josegd98/MaquinaVending/Fotos i videos projecte/Imatges dels components i muntatge/IMG_20230523_161745.jpg

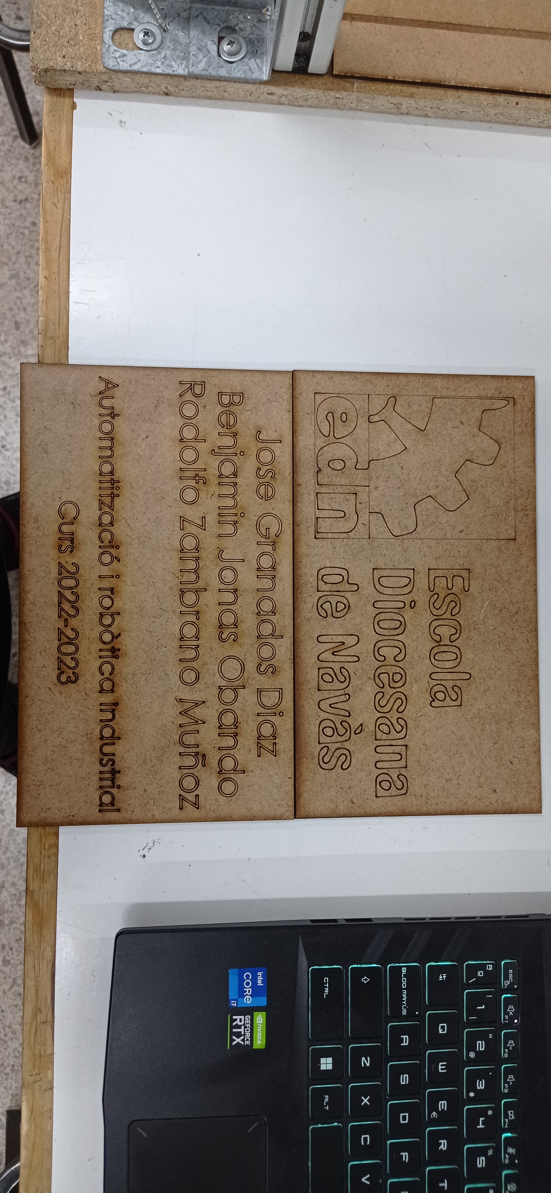
Fotos i videos projecte/Imatges dels components i muntatge/IMG_20230523_161745.jpg
