josegd98/MaquinaVending/Documentació Projecte/HMI .pdf

## HMI MAQUINA DE VENDING

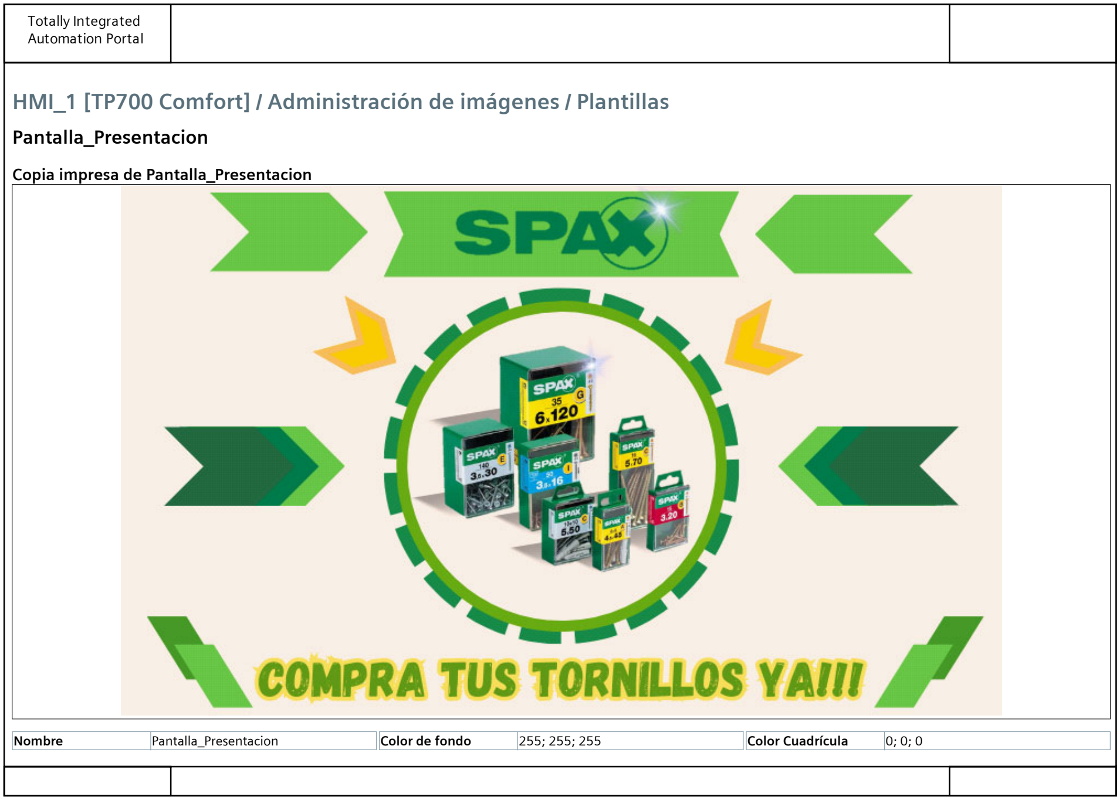
[picture p5: figure]
Totally Integrated Automation Portal; Pantalla_Presentacion; Copia impresa de Pantalla_Presentacion

## HMI_1 [TP700 Comfort] / Administración de imágenes / Plantillas

Nombre | Pantalla_Presentacion | Color de fondo | 255; 255; 255 | Color Cuadrícula | 0; 0; 0

Automation Portal

## HMI_1 [TP700 Comfort] / Imágenes / Venta

## 00_Pantalla incial

### Copia impresa de 00_Pantalla incial

Nombre | 00_Pantalla incial | Color de fondo | 255; 255; 255 | Color Cuadrícula | 0; 0; 0

Automation Portal

## HMI_1 [TP700 Comfort] / Administración de imágenes / Imágenes deslizables

## Imagen deslizable arriba

### Copia impresa de Imagen deslizable arriba

Nombre | Imagen deslizable arriba | Activar imagen desliz‐ able | Verificado | Ancho | 800
Altura | 80 | Nivel activo | 0

Botón_1

Tipo | Botón | Nombre | Botón_1 | Posición X | 29
Posición Y | 12 | Ancho | 93 | Altura | 54
Modo | Texto | Texto OFF | HOME | Texto ON | Text

Dinamizaciones\Evento
Nombre de evento | Pulsar

Lista de funciones\ActivarImagen

Nombre de imagen | 100_Home_Control | Número de objeto | 0

Botón_2

Tipo | Botón | Nombre | Botón_2 | Posición X | 131
Posición Y | 12 | Ancho | 124 | Altura | 54
Modo | Texto | Texto OFF | CONFIG ROBOT | Texto ON | Text

Dinamizaciones\Evento
Nombre de evento | Pulsar

Automation Portal

## HMI_1 [TP700 Comfort] / Imágenes / Venta

## 01_Home_store

### Copia impresa de 01_Home_store

Nombre | 01_Home_store | Color de fondo | 255; 255; 255 | Color Cuadrícula | 0; 0; 0

Automation Portal

## HMI_1 [TP700 Comfort] / Imágenes / Venta

## 02_Select_Cantidad

### Copia impresa de 02_Select_Cantidad

Nombre | 02_Select_Cantidad | Color de fondo | 255; 255; 255 | Color Cuadrícula | 0; 0; 0

Automation Portal

## HMI_1 [TP700 Comfort] / Imágenes / Venta

## 03_Select_Cabeza

### Copia impresa de 03_Select_Cabeza

Nombre | 03_Select_Cabeza | Color de fondo | 255; 255; 255 | Color Cuadrícula | 0; 0; 0

Automation Portal

## HMI_1 [TP700 Comfort] / Imágenes / Venta

## 04_Select_Medidas

### Copia impresa de 04_Select_Medidas

Nombre | 04_Select_Medidas | Color de fondo | 182; 182; 182 | Color Cuadrícula | 0; 0; 0

Automation Portal

## HMI_1 [TP700 Comfort] / Imágenes / Venta

## 05_Cesta_compra

### Copia impresa de 05_Cesta_compra

Nombre | 05_Cesta_compra | Color de fondo | 255; 255; 255 | Color Cuadrícula | 0; 0; 0

Automation Portal

## HMI_1 [TP700 Comfort] / Imágenes / Venta

## 06_Inicio_sesion

### Copia impresa de 06_Inicio_sesion

Nombre | 06_Inicio_sesion | Color de fondo | 182; 182; 182 | Color Cuadrícula | 0; 0; 0

Automation Portal

## HMI_1 [TP700 Comfort] / Administración de imágenes / Imágenes deslizables

## Imagen deslizable a la derecha

### Copia impresa de Imagen deslizable a la derecha

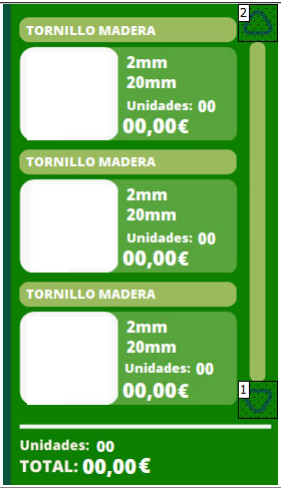
[picture p6: figure]

Automation Portal

## HMI_1 [TP700 Comfort] / Administración de imágenes / Imágenes emergentes

## Confirmacion de Pago

### Copia impresa de Confirmacion de Pago

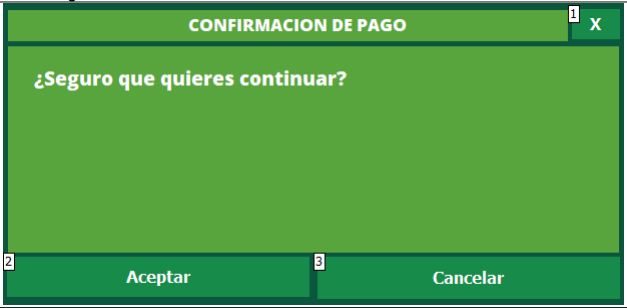
[picture p7: figure]

Nombre | Confirmacion de Pago | Ancho | 620 | Altura | 300
Nivel activo | 0

Plantilla_Rectángulo_3

Tipo | Rectángulo | Nombre | Plantilla_Rectángulo_3 | Posición X | 0
Posición Y | 0 | Ancho | 620 | Altura | 300
Nivel | 1 - Nivel_1 | Color de fondo | 88; 164; 61 | Color Borde | 11; 87; 62

Plantilla_Rectángulo_1

Tipo | Rectángulo | Nombre | Plantilla_Rectángulo_1 | Posición X | 0
Posición Y | 2 | Ancho | 620 | Altura | 41

Automation Portal

## HMI_1 [TP700 Comfort] / Administración de imágenes / Imágenes emergentes

## Entrega_Productos

### Copia impresa de Entrega_Productos

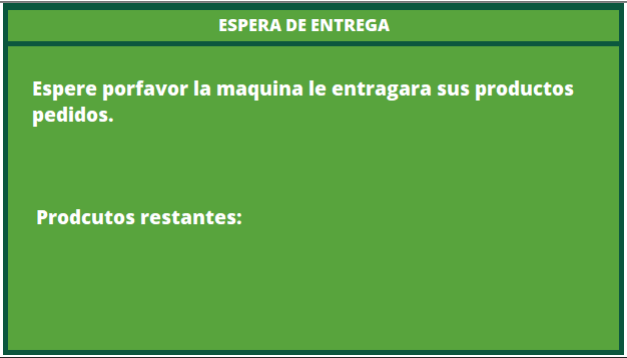
[picture p8: figure]

Nombre | Entrega_Productos | Ancho | 620 | Altura | 350
Nivel activo | 0

Plantilla_Rectángulo_3

Tipo | Rectángulo | Nombre | Plantilla_Rectángulo_3 | Posición X | 0
Posición Y | 0 | Ancho | 620 | Altura | 350
Nivel | 1 - Nivel_1 | Color de fondo | 88; 164; 61 | Color Borde | 11; 87; 62

Automation Portal

## HMI_1 [TP700 Comfort] / Administración de imágenes / Plantillas

## Menu_Navegacion

### Copia impresa de Menu_Navegacion

Nombre | Menu_Navegacion | Color de fondo | 182; 182; 182 | Color Cuadrícula | 0; 0; 0

Automation Portal

## HMI_1 [TP700 Comfort] / Administración de imágenes / Imágenes emergentes

## Confirmacion de compra

### Copia impresa de Confirmacion de compra

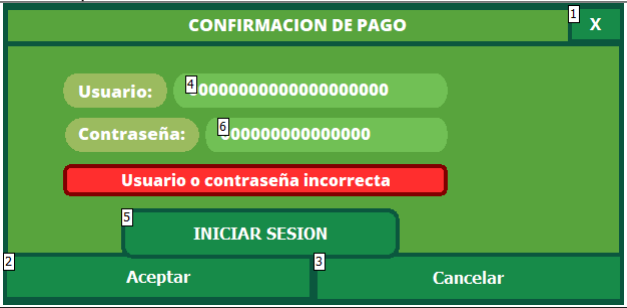
[picture p9: figure]

Nombre | Confirmacion de compra | Ancho | 620 | Altura | 300
Nivel activo | 0

Plantilla_Rectángulo_3

Tipo | Rectángulo | Nombre | Plantilla_Rectángulo_3 | Posición X | 0
Posición Y | 0 | Ancho | 620 | Altura | 300
Nivel | 1 - Nivel_1 | Color de fondo | 88; 164; 61 | Color Borde | 11; 87; 62

Campo de texto_1

Tipo | Campo de texto | Nombre | Campo de texto_1 | Posición X | 182
Posición Y | 8 | Ancho | 223 | Altura | 27

Automation Portal

## HMI_1 [TP700 Comfort] / Imágenes / Control Machine

## 100_Home_Control

### Copia impresa de 100_Home_Control

Nombre | 100_Home_Control | Color de fondo | 255; 255; 255 | Color Cuadrícula | 0; 0; 0

Automation Portal

## HMI_1 [TP700 Comfort] / Imágenes / Control Machine

## 1000_Manual_Menu

### Copia impresa de 1000_Manual_Menu

Nombre | 1000_Manual_Menu | Color de fondo | 255; 255; 255 | Color Cuadrícula | 0; 0; 0

Automation Portal

## HMI_1 [TP700 Comfort] / Imágenes / Control Machine

## 1010_Estanteria_Manual

### Copia impresa de 1010_Estanteria_Manual

Nombre | 1010_Estanteria_Manual | Color de fondo | 255; 255; 255 | Color Cuadrícula | 0; 0; 0

Automation Portal

## HMI_1 [TP700 Comfort] / Imágenes / Control Machine

## 1020_Ejes_Manual_Jog

### Copia impresa de 1020_Ejes_Manual_Jog

Nombre | 1020_Ejes_Manual_Jog | Color de fondo | 255; 255; 255 | Color Cuadrícula | 0; 0; 0

Automation Portal

## HMI_1 [TP700 Comfort] / Imágenes / Control Machine

## 200_IOMAP

### Copia impresa de 200_IOMAP

Nombre | 200_IOMAP | Color de fondo | 255; 255; 255 | Color Cuadrícula | 0; 0; 0

Automation Portal

## HMI_1 [TP700 Comfort] / Imágenes / Control Machine

## 400_Take_Pos

### Copia impresa de 400_Take_Pos

Nombre | 400_Take_Pos | Color de fondo | 255; 255; 255 | Color Cuadrícula | 0; 0; 0

Automation Portal

## HMI_1 [TP700 Comfort] / Imágenes / Control Machine

## 410_GoToPos

### Copia impresa de 410_GoToPos

Nombre | 410_GoToPos | Color de fondo | 255; 255; 255 | Color Cuadrícula | 0; 0; 0

Automation Portal

## HMI_1 [TP700 Comfort] / Imágenes / Control Machine

## 600_Config_Axis_Menu

### Copia impresa de 600_Config_Axis_Menu

Nombre | 600_Config_Axis_Menu | Color de fondo | 255; 255; 255 | Color Cuadrícula | 0; 0; 0

Automation Portal

## HMI_1 [TP700 Comfort] / Imágenes / Control Machine

## 610_Estado_EJES

### Copia impresa de 610_Estado_EJES

Nombre | 610_Estado_EJES | Color de fondo | 255; 255; 255 | Color Cuadrícula | 0; 0; 0

Automation Portal

## HMI_1 [TP700 Comfort] / Imágenes / Reponer Producto

## 10_Menu_Productos

### Copia impresa de 10_Menu_Productos

Nombre | 10_Menu_Productos | Color de fondo | 255; 255; 255 | Color Cuadrícula | 192; 192; 192

Automation Portal

## HMI_1 [TP700 Comfort] / Imágenes / Reponer Producto

## 20_Estanterias

### Copia impresa de 20_Estanterias

Nombre | 20_Estanterias | Color de fondo | 255; 255; 255 | Color Cuadrícula | 192; 192; 192

Automation Portal

## HMI_1 [TP700 Comfort] / Imágenes / Reponer Producto

## 30_Pos_Estanteria

### Copia impresa de 30_Pos_Estanteria

Nombre | 30_Pos_Estanteria | Color de fondo | 255; 255; 255 | Color Cuadrícula | 192; 192; 192

Automation Portal

## HMI_1 [TP700 Comfort] / Administración de imágenes / Imágenes emergentes

## Personalizar Producto

### Copia impresa de Personalizar Producto

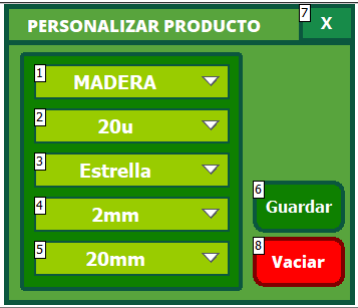
[picture p10: figure]

Nombre | Personalizar Producto | Ancho | 350 | Altura | 300
Nivel activo | 0

Dinamizaciones\Evento
Nombre de evento | Creada

Lista de funciones\ActivarBit

Variable | | | SAVE_PRODUCT_DB_VIZUALIZAR_OK

Rectángulo_6

Tipo | Rectángulo | Nombre | Rectángulo_6 | Posición X | 16

Automation Portal

## HMI_1 [TP700 Comfort] / Imágenes / Reponer Producto

## 40_Almacen

### Copia impresa de 40_Almacen

Nombre | 40_Almacen | Color de fondo | 255; 255; 255 | Color Cuadrícula | 192; 192; 192

Automation Portal

## HMI_1 [TP700 Comfort] / Imágenes / Reponer Producto

## 50_Pos_Almacen

### Copia impresa de 50_Pos_Almacen

Nombre | 50_Pos_Almacen | Color de fondo | 255; 255; 255 | Color Cuadrícula | 192; 192; 192

Automation Portal

## HMI_1 [TP700 Comfort] / Imágenes / Reponer Producto

## 60_Configuracion_Precio

### Copia impresa de 60_Configuracion_Precio

Nombre | 60_Configuracion_Precio | Color de fondo | 255; 255; 255 | Color Cuadrícula | 0; 0; 0
