josegd98/MaquinaVending/Documentació Projecte/Programa Tia Portal V15 Maquina Vending.pdf

## PROGRAMA MAQUINA DE VENDING

Totally Integrated
Automation Portal

## Main [OB1]

Main Propiedades
General
Nombre | Main | Número | 1 | Tipo | OB
Idioma | KOP | Numeración | Automático
Información
Título | "Main Program Sweep (Cycle)" | Autor | | Comentario
Familia | | Versión | 0.1 | ID personali‐ zada
Nombre | Tipo de datos | Valor predet.
Input
Initial_Call | Bool
Remanence | Bool
Temp
Constant
Segmento 1: INPUTS

"Global_Inputs"

%FB1

"Global_Inputs_
DB"

%DB29

EN | ENO

Segmento 2:

"FUNCIONES DE
GESTION Y MENU"

%FC10

EN | ENO

Segmento 3:

"Control_Entrega"

%FB31
"BuscadorDeProductos"

%FB19

"Control_
Entrega_DB"

%DB57
"BuscadorDeProd
uctos_DB"

%DB21

"Control_
Entrega_DB".
Buscar_
Productos
EN | ENO | EN

BuscarProducto
s
EN | ENO | EN | ENO

BuscarProducto
s

ENO

Segmento 4:

"Buscador_EspacioVacio"

%FB37

"Buscador_
EspacioVacio_
DB"

%DB58

EN
BuscarPosVacia
s

ENO

Segmento 5:

"ROBOT AXIS"

%FB30

"ROBOT AXIS_DB"

%DB49

EN | ENO

Segmento 6:

"Comunicacion Modbus"

%FC1
"AlwaysFALSE"

%M1.3

EN | ENO

Segmento 7:

"TAKE_POSICIONS"

%FC4

EN | ENO

Segmento 8:

"RESET_MC"

%FC6

EN ENO

Segmento 9:

"BuscarPosicion_Vacia"

%FB33
"Control_Estanterias"

%FB20

"BuscarPosicion_
Vacia_DB"

%DB54

%FB20

"Control_
Estanterias_DB"

%DB41

"Bits_Motion".
PosTogoEstanteri
a

"Bits_Motion".
GoToposEstanteri
a

"Bits_Motion".
GoToHomeEstant
eria
EN | ENO | EN

PosicionToGO

Execute

GoToHome

ENO

Segmento 10:

"Go_TO_HOME"

%FB28

"Go_TO_HOME_
DB"

%DB53

EN | ENO HOME_DONE

Segmento 11:

"Moves_Axis_Manual"

%FB15

"Moves_Axis_
Manual_DB"

%DB36

"EJE_X"

%DB37

"EJE_Y"

%DB38

"EJE_Z"

%DB39

"Btn_Manual".
btnMovePositive_
X

"Btn_Manual".
btnMoveNegative
_X

"Btn_Manual".
btnMovePositive_
Y

"Btn_Manual".
btnMoveNegative
_Y

"Btn_Manual".
btnMovePositive_
Z

"Btn_Manual".
btnMoveNegative
_Z
25.0
25.0
50.0

EN

EJE_X

EJE_Y

EJE_Z

btnMovePositiv
e_X

btnMoveNegati
ve_X

btnMovePositiv
e_Y

btnMoveNegati
ve_Y

btnMovePositiv
e_Z

btnMoveNegati
ve_Z
rVelocidad_X
rVelocidad_Y
rVelocidad_Z
EN | ENO

EJE_X

EJE_Y

EJE_Z

btnMovePositiv
e_X

btnMoveNegati
ve_X

btnMovePositiv
e_Y

btnMoveNegati
ve_Y

btnMovePositiv
e_Z

btnMoveNegati
ve_Z
rVelocidad_X
rVelocidad_Y
rVelocidad_Z

ENO

Segmento 12:

"PINZA_CONTROL"

%FB26

"PINZA_
CONTROL_DB"

%DB52

false
false
false
false
false
false

EN
ENA_PWM
OpenPinza
Limite Apertura
Limite Cerrado
btnGirarCerrar
btnGirarAbrir
EN | ENO
ENA_PWM OpenPinza Limite Apertura Limite Cerrado btnGirarCerrar btnGirarAbrir | ENO

Segmento 13:

Segmento 14:

"Control_Outputs"

%FB22

"Control_
Outputs_DB"

%DB51

false
false

EN
Modo_Manual
Modo_Auto

ENO

Segmento 15:

"Global_Ouputs"

%FB21

"Global_Ouputs_
DB"

%DB28

EN | ENO

## FUNCIONES DE GESTION Y MENU [FC10]

FUNCIONES DE GESTION Y MENU Propiedades
General
Nombre | FUNCIONES DE GESTION Y MENU | Número | 10 | Tipo | FC
Idioma | KOP | Numeración | Automático
Información
Título | Autor | | Comentario
Familia | Versión | 0.1 | ID personali‐ zada
Nombre | Tipo de datos | Valor predet.
Input
Output
InOut
Temp
Constant
Return
FUNCIONES DE GESTION Y MENU | Void
Segmento 1:

"Comprobador_de_STOCK"

%FB11

"Comprobador_
de_STOCK_DB"

%DB1

EN | ENO

Segmento 2:

"SAVE_PRODUCT"

%FB9

"SAVE_
PRODUCT_DB"

%DB8

EN | ENO

Segmento 3:

"SELECCION_PRODUCTO"

%FB8

"SELECCION_
PRODUCTO_DB"

%DB5

EN | ENO

Segmento 4:

"Control_Cesta"

%FB13

"Control_Cesta_
DB"

%DB4

EN | ENO

Segmento 5:

"Limitador_Incrementadores"

%FB12

"Limitador_
Incrementadores
_DB"

%DB14

EN | ENO

Segmento 6:

"Administrador_Usuarios"

%FB10
"Tramite_de_Compra"

%FB5

"Administrador_
Usuarios_DB"

%DB12

%FB5

"Tramite_de_
Compra_DB"

%DB13

EN | ENO | EN | ENO

Segmento 7:

"Configuracion_Precios"

%FB4

"Configuracion_
Precios_DB"

%DB9

EN | ENO

Segmento 8:

"HMI_IO_MAP"

%FB24
"IOMAP_ON"

%M100.0

"HMI_IO_MAP_DB"

%DB32

"wInputs_IW0"

%IW0

"wInputs_IW2"

%IW2

16#0
16#0

"wOutputs_QW0"

%QW0

"wOutputs_QW2"

%QW2

16#0
16#0

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
EN | ENO

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
Segmento 9:

"ASIGNACION_ID"

%FB23

"ASIGNACION_
ID_DB"

%DB31

EN | ENO

## MAQUINA DE VENDING_10_PRUEBAAUTO / PLC_1 [CPU 1214C DC/DC/ DC] / Bloques de programa / 2_CONTROL_MENU / 2_1Gestion_Produc‐ tos / CESTA

## Calculo_Precio_Total [FB7]

Calculo_Precio_Total Propiedades
General
Nombre | Calculo_Precio_Total | Número | 7 | Tipo | FB
Idioma | KOP | Numeración | Automático
Información
Título | Autor | | Comentario
Familia | Versión | 0.1 | ID personali‐ zada

Calculo_Precio_Total
Nombre | Tipo de datos | Valor predet. | Remanencia
Input
Enable_Calcular | Bool | false | No remanente
Output
Resultado | Real | 0.0 | No remanente
InOut
Static
Counter | Int | 0 | No remanente
Resultado_Calculado | Real | 0.0 | No remanente
Temp
Constant
Segmento 2:

0001
0002
0003 IF #Enable_Calcular THEN
0004 | #Resultado_Calculado := 0;
0005 | FOR #Counter := 0 TO 31 DO
0006 | #Resultado_Calculado := #Resultado_Calculado + "DB_Cesta_Produc-
| tos".Lista_Productos[#Counter].Producto.Precio * "Control_Cesta_DB".Uni-
| dades_Cesta[#Counter];
0007 | ;
0008 | END_FOR;
0009
0010 | #Resultado := #Resultado_Calculado;
0011 | ;
0012 END_IF;
0013
0014
0015
0016
0017
0018
0019

## MAQUINA DE VENDING_10_PRUEBAAUTO / PLC_1 [CPU 1214C DC/DC/ DC] / Bloques de programa / 2_CONTROL_MENU / 2_1Gestion_Produc‐ tos / CESTA

## Calculo_Unidades_Totales [FB2]

Calculo_Unidades_Totales Propiedades
General
Nombre | Calculo_Unidades_To‐ tales | Número | 2 | Tipo | FB
Idioma | KOP | Numeración | Automático
Información
Título | Autor | | Comentario
Familia | Versión | 0.1 | ID personali‐ zada

Calculo_Unidades_Totales
Nombre | Tipo de datos | Valor predet. | Remanencia
Input
Array_Unidades | Array[0..31] of Int | | No remanente
Enable_Calcular | Bool | false | No remanente
Output
Resultado | Int | 0 | No remanente
InOut
Static
Counter | Int | 0 | No remanente
Resultado_Calculado | Int | 0 | No remanente
Temp
Constant
Segmento 1:

0001
0002 IF #Enable_Calcular THEN
0003 | #Resultado_Calculado := 0;
0004 | FOR #Counter := 0 TO 31 DO
0005 | #Resultado_Calculado := #Resultado_Calculado + #Array_Unidades[#Coun-
| ter]
0006 | ;
0007 | END_FOR;
0008
0009 | #Resultado := #Resultado_Calculado;
0010 | ;
0011 END_IF;
0012
0013
0014

## Contador [FB14]

Contador Propiedades
General
Nombre | Contador | Número | 14 | Tipo | FB
Idioma | KOP | Numeración | Automático
Información
Título | Autor | | Comentario
Familia | Versión | 0.1 | ID personali‐ zada
Nombre | Tipo de datos | Valor predet. | Remanencia
Input
Intervalo | Int | 0 | No remanente
ADD | Bool | false | No remanente
SUB | Bool | false | No remanente
Max_Permitido | Int | 0 | No remanente
Output
InOut
Num_Enter | Int | 1 | No remanente
Static
pulse | Array[0..1] of Bool | | No remanente
Temp
Constant
Segmento 1:

P Int

>

ADD
#ADD | Auto (Int)

#pulse[0]

#Max_Permitido

#Num_Enter | #Num_Enter

| #Intervalo

#Num_Enter

EN
IN1
IN2

ENO
OUT

Auto (Int)
EN
IN1
IN2

ENO
OUT

Auto (Int)

Segmento 2:

P Int

>

SUB
#SUB | Auto (Int)

#pulse[1]

#Num_Enter

0 | #Num_Enter
| #Intervalo

#Num_Enter

EN
IN1
IN2

ENO
OUT

Auto (Int)
EN
IN1
IN2

ENO
OUT

Auto (Int)

## MAQUINA DE VENDING_10_PRUEBAAUTO / PLC_1 [CPU 1214C DC/DC/ DC] / Bloques de programa / 2_CONTROL_MENU / 2_1Gestion_Produc‐ tos / CESTA

## Control_Cesta [FB13]

Control_Cesta Propiedades
General
Nombre | Control_Cesta | Número | 13 | Tipo | FB
Idioma | KOP | Numeración | Automático
Información
Título | Autor | | Comentario
Familia | Versión | 0.1 | ID personali‐ zada

Control_Cesta
Nombre | Tipo de datos | Valor predet. | Remanencia
Input
Output
InOut
Static
Producto_View_Cesta | "TypeProducto" | | No remanente
Producto_View1 | "TypeProducto" | | No remanente
Producto_View2 | "TypeProducto" | | No remanente
Producto_View3 | "TypeProducto" | | No remanente
Preview_Unidades_1 | Int | 0 | No remanente
Preview_Unidades_2 | Int | 0 | No remanente
Preview_Unidades_3 | Int | 0 | No remanente
Unidades_Cesta | Array[0..31] of Int | | No remanente
Maximas_Unidades | Array[0..31] of Int | | No remanente
Puntero_Cesta | Int | 0 | No remanente
Puntero_Cesta_Previa | Int | 0 | No remanente
Eliminar | Bool | false | No remanente
Puntero2 | Int | 0 | No remanente
Puntero3 | Int | 0 | No remanente
Puntero4 | Int | 0 | No remanente
Producto_Vacio | "TypeProducto" | | No remanente
counter | Int | 0 | No remanente
Display_Unidades | Int | 1 | No remanente
Contador_Instance | "Contador"
btnAddUnidad | Bool | false | No remanente
btnSubUnidad | Bool | false | No remanente
Contar_Unidades | Bool | false | No remanente
Puntero_Unidades | Int | 0 | No remanente
Recuadro_Previa | Array[0..2] of Bool | | No remanente
Recuadro_Cesta | Bool | false | No remanente
Unidades_Totales | Int | 0 | No remanente
Calculo_Unidades_Totales_Instance | "Calculo_Uni‐ dades_Totales"
Calcular_Unidades | Bool | false | No remanente
Calcular_Precio | Bool | false | No remanente
Calculo_Precio_Total_Instance | "Calculo_Pre‐ cio_Total"
Precio_Total | Real | 0.0 | No remanente

Nombre | Tipo de datos | Valor predet. | Remanencia
Temp
Constant
Segmento 1:

Variant

<>

Variant

<>

Variant

<>

Variant

<>

#Producto_View1

#Producto_Vacio

#Recuadro_

Previa[0]

#Producto_View2

#Producto_Vacio

#Recuadro_

Previa[1]

#Producto_View3

#Producto_Vacio

#Recuadro_

Previa[2]

#Producto_

View_Cesta

#Producto_Vacio

#Recuadro_Cesta

Segmento 2:

0001
0002
0003
0004 IF #Eliminar THEN
0005 | "DB_Cesta_Productos".Lista_Productos[#Puntero_Cesta] := #Producto_Vacio;
0006 | #Unidades_Cesta[#Puntero_Cesta] := 0;
0007 | #Maximas_Unidades[#Puntero_Cesta] := 0;
0008
0009 FOR #Puntero2 := 0 TO 31 DO
0010
0011 | IF "DB_Cesta_Productos".Lista_Productos[#Puntero2] = #Producto_Vacio
| AND #Puntero2 < 31 THEN // puntero2 <31 porque si dejamos que llegue a 31 al
| sumar despues + 1 se saldra del array y dara error en el plc
0012
0013 | "DB_Cesta_Productos".Lista_Productos[#Puntero2] := "DB_Cesta_Pro-
| ductos".Lista_Productos[#Puntero2 + 1];
0014
0015 | "DB_Cesta_Productos".Lista_Productos[#Puntero2 + 1] := #Produc-
| to_Vacio
0016 | ;
0017 | END_IF;
0018
0019 | IF #Unidades_Cesta[#Puntero2] = 0 AND #Puntero2 < 31 THEN
0020
0021 | #Maximas_Unidades[#Puntero2] := #Maximas_Unidades[#Puntero2 + 1];

0022 | #Unidades_Cesta[#Puntero2] := #Unidades_Cesta[#Puntero2 + 1];
0023 | #Maximas_Unidades[#Puntero2 + 1] := 0;
0024 | #Unidades_Cesta[#Puntero2 + 1] := 0
0025 | ;
0026 | END_IF;
0027
0028
0029 | ;
0030 | END_FOR;
0031
0032 #Eliminar := false;
0033
0034 ;
0035 END_IF;
0036
0037
0038 IF #Contar_Unidades THEN
0039
0040 | FOR #Puntero_Unidades := 0 TO 31 DO
0041 | #Maximas_Unidades[#Puntero_Unidades] := 0;
0042 | ;
0043 | END_FOR;
0044
0045 | FOR #Puntero_Unidades := 0 TO 31 DO
0046
0047 | FOR #Puntero3 := 0 TO 31 DO
0048
0049
0050 | IF "DB_Cesta_Productos".Lista_Productos[#Puntero_Unidades] =
| "BDO_STOCK".Espacio[#Puntero3] THEN
0051 | #Maximas_Unidades[#Puntero_Unidades] := #Maximas_Uni-
| dades[#Puntero_Unidades] + 1;
0052
0053 | END_IF;
0054
0055 | IF "DB_Cesta_Productos".Lista_Productos[#Puntero_Uni-
| dades].Producto.Tipo = 0 THEN
0056 | EXIT
0057 | ;
0058 | END_IF;
0059
0060 | ;
0061 | END_FOR;
0062
0063 | IF "DB_Cesta_Productos".Lista_Productos[#Puntero_Unidades].Produc-
| to.Tipo = 0 THEN
0064 | EXIT
0065 | ;
0066 | END_IF;
0067 | ;
0068 | END_FOR;
0069
0070 | #Contar_Unidades:= false
0071 | ;
0072 | END_IF;
0073
0074 #Display_Unidades := #Unidades_Cesta[#Puntero_Cesta]; 0075
0076

0077
0078
0079
0080
0081
0082
0083
0084
0085
0086 #Producto_View_Cesta := "DB_Cesta_Productos".Lista_Productos[#Puntero_Cesta]; 0087
0088 #Producto_View1 := "DB_Cesta_Productos".Lista_Productos[#Puntero_Cesta_Previa];
0089 #Producto_View2 := "DB_Cesta_Productos".Lista_Productos[#Puntero_Cesta_Previa + 1];
0090 #Producto_View3 := "DB_Cesta_Productos".Lista_Productos[#Puntero_Cesta_Previa + 2];
0091
0092 #Preview_Unidades_1 := #Unidades_Cesta[#Puntero_Cesta_Previa];
0093 #Preview_Unidades_2 := #Unidades_Cesta[#Puntero_Cesta_Previa + 1]; 0094 #Preview_Unidades_3 := #Unidades_Cesta[#Puntero_Cesta_Previa + 2]; 0095
0096
0097
Segmento 3:

"Contador"

%FB14

#Contador_

Instance

1

#Maximas_

Unidades[#Punter
o_Cesta]

#Unidades_

Cesta[#Puntero_
Cesta]

#btnAddUnidad

#btnSubUnidad

EN
Intervalo

ADD

SUB

Max_Permitido

Num_Enter

EN | ENO
Intervalo

ADD

SUB

Max_Permitido

Num_Enter

ENO

Segmento 4:

"Calculo_Unidades_Totales"

%FB2

#Calculo_

Unidades_
Totales_Instance

#Unidades_Cesta

#Calcular_

Unidades

#Unidades_

Totales

EN
Array_Unidades
Enable_
Calcular

ENO

Resultado

EN
Array_Unidades
Enable_
Calcular

ENO

Resultado

Segmento 5:

"Calculo_Precio_Total"

%FB7

#Calculo_

Precio_Total_
Instance

#Calcular_Precio

#Precio_Total

EN
Enable_
Calcular

ENO
Resultado

Segmento 6:

## MAQUINA DE VENDING_10_PRUEBAAUTO / PLC_1 [CPU 1214C DC/DC/ DC] / Bloques de programa / 2_CONTROL_MENU / 2_1Gestion_Produc‐ tos / CESTA

## SELECCION_PRODUCTO [FB8]

SELECCION_PRODUCTO Propiedades
General
Nombre | SELECCION_PRODUCTO | Número | 8 | Tipo | FB
Idioma | KOP | Numeración | Automático
Información
Título | Autor | | Comentario
Familia | Versión | 0.1 | ID personali‐ zada

SELECCION_PRODUCTO
Nombre | Tipo de datos | Valor predet. | Remanencia
Input
Output
InOut
Static
Select_Product | Array[0..4] of String | | No remanente
PUNTERO_Diametro | Int | 0 | No remanente
PUNTERO_Largo | Int | 0 | No remanente
aceptar_DIAMETRO | Bool | false | No remanente
aceptar_LARGO | Bool | false | No remanente
Diametro_seleccionado | Int | 0 | No remanente
Largo_seleccionado | Int | 0 | No remanente
Diametro_actual | Int | 0 | No remanente
Largo_actual | Int | 0 | No remanente
diametro_string | String | '' | No remanente
Save_Pedido | Bool | false | No remanente
puntero_busqueda | Int | 0 | No remanente
Producto_Nulo | "TypeProducto" | | No remanente
Check_Limit_Diametro | Bool | false | No remanente
Check_Limit_Largo | Bool | false | No remanente
Temp
Constant
Segmento 1:

0001
0002 #Diametro_actual := "Comprobador_de_STOCK_DB".Diametro_Stock[#PUNTERO_Diametro];
0003
0004 IF #aceptar_DIAMETRO = true THEN
0005 | #Diametro_seleccionado := "Comprobador_de_STOCK_DB".Diametro_Stock[#PUN-
| TERO_Diametro];
0006 | ;
0007 END_IF;
0008
0009 "Comprobador_de_STOCK_DB".PRODUCTO_ELEGIDO[3] := #Diametro_seleccionado; 0010

0011 //----------------------------------------------------------------------------------------------
0012
0013 #Largo_actual := "Comprobador_de_STOCK_DB".Largo_Stock[#PUNTERO_Largo];
0014
0015 IF #aceptar_LARGO = true THEN
0016 | #Largo_seleccionado := "Comprobador_de_STOCK_DB".Largo_Stock[#PUNTERO_Lar-
| go];
0017 | ;
0018 END_IF;
0019
0020 "Comprobador_de_STOCK_DB".PRODUCTO_ELEGIDO[4] := #Largo_seleccionado; 0021
0022
0023 IF #Save_Pedido THEN
0024 FOR #puntero_busqueda := 0 TO 31 DO
0025
0026 | IF "DB_Cesta_Productos".Lista_Productos[#puntero_busqueda] = "Compro-
| bador_de_STOCK_DB".Producto_Seleccionado THEN
0027 | EXIT
0028 | ;
0029 | END_IF;
0030
0031 | IF "DB_Cesta_Productos".Lista_Productos[#puntero_busqueda] = #Produc-
| to_Nulo THEN
0032 | "DB_Cesta_Productos".Lista_Productos[#puntero_busqueda] := "Com-
| probador_de_STOCK_DB".Producto_Seleccionado;
0033 | "Control_Cesta_DB".Unidades_Cesta[#puntero_busqueda] := 1;
0034 | EXIT
0035 | ;
0036 | END_IF;
0037
0038 | ;
0039 | END_FOR;
0040 | #Save_Pedido := FALSE
0041 | ;
0042 END_IF;
0043
0044
0045
0046
0047
0048
0049
0050
0051
0052
0053

## MAQUINA DE VENDING_10_PRUEBAAUTO / PLC_1 [CPU 1214C DC/DC/ DC] / Bloques de programa / 2_CONTROL_MENU / 2_1Gestion_Produc‐ tos / COMPROBADOR STOCK

## Comprobador_de_STOCK [FB11]

Comprobador_de_STOCK Propiedades
General
Nombre | Comprobador_de_STOCK | Número | 11 | Tipo | FB
Idioma | KOP | Numeración | Manual
Información
Título | Autor | | Comentario
Familia | Versión | 0.1 | ID personali‐ zada

Comprobador_de_STOCK
Nombre | Tipo de datos | Valor predet. | Remanencia
Input
Output
InOut
Static
Tipo_Madera | "TypeStockVar" | | No remanente
Tipo_Chapa | "TypeStockVar" | | No remanente
100ud | "TypeStockVar" | | No remanente
20ud | "TypeStockVar" | | No remanente
Estrella | "TypeStockVar" | | No remanente
Plana | "TypeStockVar" | | No remanente
Hexagonal | "TypeStockVar" | | No remanente
Torx | "TypeStockVar" | | No remanente
Diametro | "TypeStockVar" | | No remanente
Largo | "TypeStockVar" | | No remanente
Diametro actual | Int | 0 | No remanente
Diametro_Stock | Array[0..5] of Int | | No remanente
Largo_Stock | Array[0..5] of Int | | No remanente
ORDEN | Int | 0 | No remanente
Counter | Int | 0 | No remanente
MIRAR DIAMETROS | Bool | false | No remanente
Puntero | Int | 0 | No remanente
PRODUCTO_ELEGIDO | Array[0..4] of Int | | No remanente
Producto_Seleccionado | "TypeProducto" | | No remanente
Cantidad_elegida | Int | 0 | No remanente
procesar | Bool | false | No remanente
MIRAR LARGO | Bool | false | No remanente
Buscar_Tipos | Bool | false | No remanente
Buscar_Unidades | Bool | false | No remanente
Buscar_Cabezas | Bool | false | No remanente
pruab creada | Bool | false | No remanente
Producto_Vacio | Array[0..5] of Int | | No remanente
Asignador_Precios_Instance | "Asignador_Pre‐ cios"
Mirar_Precio | Bool | false | No remanente
Temp
Constant

Segmento 1:

0001
0002
0003 // TIPO MADERA CONTEO DE CANTIDAD 0004 IF #Buscar_Tipos THEN
0005 | //RESET PARA VOLVER A COMPROBAR
0006 | #Tipo_Madera.Disponible := FALSE;
0007 | #Tipo_Chapa.Disponible := FALSE;
0008 | #Tipo_Chapa.Cantidad := 0;
0009 | #Tipo_Madera.Cantidad := 0;
0010
0011 #Cantidad_elegida := 0;
0012
0013 | FOR #Puntero := 0 TO 31 DO
0014 | IF "BDO_STOCK".Espacio[#Puntero].Producto.Tipo = 1 AND "BDO_STOCK".Es-
| pacio[#Puntero].Producto.Disponible THEN
0015
0016 | #Tipo_Madera.Cantidad := #Tipo_Madera.Cantidad + 1;
0017
0018 | ;
0019 | END_IF;
0020
0021 | IF "BDO_STOCK".Espacio[#Puntero].Producto.Tipo = 2 AND "BDO_STOCK".Es-
| pacio[#Puntero].Producto.Disponible THEN
0022
0023 | #Tipo_Chapa.Cantidad := #Tipo_Chapa.Cantidad + 1;
0024
0025 | ;
0026 | END_IF;
0027
0028 | ;
0029 | END_FOR;
0030
0031 IF #Tipo_Madera.Cantidad > 0 THEN 0032
0033 | #Tipo_Madera.Disponible := TRUE
0034 | ;
0035 | ELSE
0036 | #Tipo_Madera.Disponible := FALSE
0037 | ;
0038 | END_IF;
0039
0040 // TIPO CHAPA CONTEO DE CANTIDAD 0041
0042 IF #Tipo_Chapa.Cantidad > 0 THEN 0043
0044 | #Tipo_Chapa.Disponible := TRUE
0045 | ;
0046 | ELSE
0047 | #Tipo_Chapa.Disponible := FALSE
0048 | ;
0049 | END_IF;
0050
0051 #Buscar_Tipos := FALSE; 0052
0053 END_IF;
0054

0055
//------------------------------------------------------------------------------
0056
0057 // UNIDADES DISPONIBLES
0058 IF #Buscar_Unidades THEN
0059 | #"100ud".Disponible := FALSE;
0060 | #"20ud".Disponible := FALSE;
0061 | #"20ud".Cantidad := 0;
0062 | #"100ud".Cantidad := 0;
0063
0064 FOR #Puntero := 0 TO 31 DO
0065
0066 | //100 ud
0067 | IF "BDO_STOCK".Espacio[#Puntero].Producto.Tipo = #PRODUCTO_ELEGIDO[0]
| AND "BDO_STOCK".Espacio[#Puntero].Producto.Cantidad = 100 AND "BDO_STOCK".Es-
| pacio[#Puntero].Producto.Disponible THEN
0068 | #"100ud".Cantidad := #"100ud".Cantidad + 1;
0069 | ;
0070 | END_IF;
0071 | //20 ud
0072 | IF "BDO_STOCK".Espacio[#Puntero].Producto.Tipo = #PRODUCTO_ELEGIDO[0]
| AND "BDO_STOCK".Espacio[#Puntero].Producto.Cantidad = 20 AND "BDO_STOCK".Espa-
| cio[#Puntero].Producto.Disponible THEN
0073 | #"20ud".Cantidad := #"20ud".Cantidad + 1;
0074 | ;
0075 | END_IF;
0076 | ;
0077 | END_FOR;
0078
0079 | //100 ud
0080 | IF #"100ud".Cantidad > 0 THEN
0081 | #"100ud".Disponible := TRUE
0082 | ;
0083 | ELSE
0084 | #"100ud".Disponible := FALSE
0085 | ;
0086 | END_IF;
0087 | //20 ud
0088 | IF #"20ud".Cantidad > 0 THEN
0089 | #"20ud".Disponible := TRUE
0090 | ;
0091 | ELSE
0092 | #"20ud".Disponible := FALSE
0093 | ;
0094 | END_IF;
0095
0096 END_IF;
0097
0098 IF #Buscar_Cabezas THEN 0099
0100 | #Estrella.Cantidad := 0;
0101 | #Plana.Cantidad := 0;
0102 | #Hexagonal.Cantidad := 0;
0103 | #Torx.Cantidad := 0;
0104 | #Estrella.Disponible := FALSE;
0105 | #Plana.Disponible := FALSE;
0106 | #Hexagonal.Disponible := FALSE;
0107 | #Torx.Disponible := FALSE;

0108
0109 | FOR #Puntero := 0 TO 31 DO
0110 | //100 ud
0111 | IF "BDO_STOCK".Espacio[#Puntero].Producto.Tipo = #PRODUCTO_ELEGIDO[0]
| AND "BDO_STOCK".Espacio[#Puntero].Producto.Cantidad = #PRODUCTO_ELEGIDO[1] AND
| "BDO_STOCK".Espacio[#Puntero].Producto.Cabeza = 1 AND "BDO_STOCK".Espa-
| cio[#Puntero].Producto.Disponible THEN
0112
0113 | #Estrella.Cantidad := #Estrella.Cantidad + 1;
0114
0115 | ;
0116 | END_IF;
0117 | //20 ud
0118 | IF "BDO_STOCK".Espacio[#Puntero].Producto.Tipo = #PRODUCTO_ELEGIDO[0]
| AND "BDO_STOCK".Espacio[#Puntero].Producto.Cantidad = #PRODUCTO_ELEGIDO[1] AND
| "BDO_STOCK".Espacio[#Puntero].Producto.Cabeza = 2 AND "BDO_STOCK".Espa-
| cio[#Puntero].Producto.Disponible THEN
0119
0120 | #Plana.Cantidad := #Plana.Cantidad + 1;
0121
0122 | ;
0123 | END_IF;
0124
0125 | IF "BDO_STOCK".Espacio[#Puntero].Producto.Tipo = #PRODUCTO_ELEGIDO[0]
| AND "BDO_STOCK".Espacio[#Puntero].Producto.Cantidad = #PRODUCTO_ELEGIDO[1] AND
| "BDO_STOCK".Espacio[#Puntero].Producto.Cabeza = 3 AND "BDO_STOCK".Espa-
| cio[#Puntero].Producto.Disponible THEN
0126
0127 | #Hexagonal.Cantidad := #Hexagonal.Cantidad + 1;
0128
0129 | ;
0130 | END_IF;
0131
0132 | IF "BDO_STOCK".Espacio[#Puntero].Producto.Tipo = #PRODUCTO_ELEGIDO[0]
| AND "BDO_STOCK".Espacio[#Puntero].Producto.Cantidad = #PRODUCTO_ELEGIDO[1] AND
| "BDO_STOCK".Espacio[#Puntero].Producto.Cabeza = 4 AND "BDO_STOCK".Espa-
| cio[#Puntero].Producto.Disponible THEN
0133
0134 | #Torx.Cantidad := #Torx.Cantidad + 1;
0135
0136 | ;
0137 | END_IF;
0138
0139 END_FOR;
0140
0141 | IF #Estrella.Cantidad > 0 THEN
0142
0143 | #Estrella.Disponible := TRUE
0144 | ;
0145 | ELSE
0146 | #Estrella.Disponible := FALSE
0147 | ;
0148 | END_IF;
0149 | //20 ud
0150 | //
0151 | IF #Plana.Cantidad > 0 THEN
0152
0153 | #Plana.Disponible := TRUE
0154 | ;

0155 | ELSE
0156 | #Plana.Disponible := FALSE
0157 | ;
0158 | END_IF;
0159
0160 | IF #Hexagonal.Cantidad > 0 THEN
0161
0162 | #Hexagonal.Disponible := TRUE
0163 | ;
0164 | ELSE
0165 | #Hexagonal.Disponible := FALSE
0166 | ;
0167 | END_IF;
0168
0169 | //20 ud
0170 | IF #Torx.Cantidad > 0 THEN
0171
0172 | #Torx.Disponible := TRUE
0173 | ;
0174 | ELSE
0175 | #Torx.Disponible := FALSE
0176 | ;
0177 | END_IF;
0178 | ;
0179 END_IF;
0180
0181
0182 IF #"MIRAR DIAMETROS" THEN
0183
0184 #Diametro_Stock := #Producto_Vacio;
0185
0186 FOR #Counter := 0 TO 8 DO //NUMERO MAXIMO DE MEDIDA DE DIAMETRO CONTADOR PARA COMPARAR POR ORDEN EL ARRAY ES DE 7 Y EL COUNTER IRA AUMENTANDO DE 1 A 7 POR ORDEN ASI LO USAMOS PARA COMPARAR Y SI ESTA EN ORDEN LO GUARDAMOS
0187
0188 | FOR #Puntero := 0 TO 31 DO | //NUMERO DE DE TAMAÑO DE EL ARRAY PUN-
TERO QUE RECORRE TODO LA BASE DE DATOS
0189
0190
0191 | IF "BDO_STOCK".Espacio[#Puntero].Producto.Tipo = #PRODUCTO_ELEGI-
DO[0] AND "BDO_STOCK".Espacio[#Puntero].Producto.Cantidad = #PRODUCTO_ELEGI-
| DO[1] AND
0192 | "BDO_STOCK".Espacio[#Puntero].Producto.Cabeza = #PRODUCTO_ELE-
GIDO[2] AND "BDO_STOCK".Espacio[#Puntero].Producto.Diametro = #Counter AND "BDO_STOCK".Espacio[#Puntero].Producto.Disponible THEN
0193
0194 | #Diametro_Stock[#ORDEN] := "BDO_STOCK".Espacio[#Puntero].Pro-
ducto.Diametro; // SI ES IGUIAL AL NUM POR ORDEN LO GUARDAMOS EN EL ARRAY Y
| PASAMOS AL SIGUIENTE ESPACIO
0195 | #ORDEN := #ORDEN + 1;
0196 | EXIT
0197 | ;
0198 | END_IF;
0199 | ;
0200 | END_FOR;
0201 | ;
0202 | END_FOR;
0203
0204 #ORDEN := 0;

0205
0206 | #"MIRAR DIAMETROS" := FALSE
0207 | ;
0208 END_IF;
0209
0210
0211
0212 IF #"MIRAR LARGO" THEN
0213
0214 #Largo_Stock := #Producto_Vacio;
0215
0216 FOR #Counter := 20 TO 60 BY 5 DO //NUMERO MAXIMO DE MEDIDA DE DIAMETRO CONTADOR PARA COMPARAR POR ORDEN EL ARRAY ES DE 7 Y EL COUNTER IRA AUMENTANDO DE 1 A 7 POR ORDEN ASI LO USAMOS PARA COMPARAR Y SI ESTA EN ORDEN LO GUARDAMOS 0217
0218 | FOR #Puntero := 0 TO 31 DO | //NUMERO DE DE TAMAÑO DE EL ARRAY PUN-
TERO QUE RECORRE TODO LA BASE DE DATOS
0219
0220
0221 | IF "BDO_STOCK".Espacio[#Puntero].Producto.Tipo = #PRODUCTO_ELEGI-
DO[0] AND "BDO_STOCK".Espacio[#Puntero].Producto.Cantidad = #PRODUCTO_ELEGI-
| DO[1] AND
0222 | "BDO_STOCK".Espacio[#Puntero].Producto.Cabeza = #PRODUCTO_ELE-
GIDO[2] AND "BDO_STOCK".Espacio[#Puntero].Producto.Diametro = #PRODUCTO_ELEGI-
| DO[3] AND
0223 | "BDO_STOCK".Espacio[#Puntero].Producto.Largo= #Counter AND
"BDO_STOCK".Espacio[#Puntero].Producto.Disponible THEN
0224
0225 | #Largo_Stock[#ORDEN] := "BDO_STOCK".Espacio[#Puntero].Produc-
to.Largo; // SI ES IGUIAL AL NUM POR ORDEN LO GUARDAMOS EN EL ARRAY Y PASAMOS
| AL SIGUIENTE ESPACIO
0226 | #ORDEN := #ORDEN + 1;
0227 | EXIT
0228 | ;
0229 | END_IF;
0230 | ;
0231 | END_FOR;
0232 | ;
0233 | END_FOR;
0234
0235 #ORDEN := 0;
0236
0237 #Largo.Disponible := TRUE; 0238
0239 | #"MIRAR LARGO" := FALSE
0240 | ;
0241 END_IF;
0242
0243
0244 #Producto_Seleccionado.Producto.Tipo := #PRODUCTO_ELEGIDO[0]; 0245 #Producto_Seleccionado.Producto.Cantidad := #PRODUCTO_ELEGIDO[1]; 0246 #Producto_Seleccionado.Producto.Cabeza := #PRODUCTO_ELEGIDO[2]; 0247 #Producto_Seleccionado.Producto.Diametro := #PRODUCTO_ELEGIDO[3]; 0248 #Producto_Seleccionado.Producto.Largo := #PRODUCTO_ELEGIDO[4];
0249 #Producto_Seleccionado.Producto.Disponible := TRUE;
0250
0251 #Asignador_Precios_Instance.Diametro_Comparacion := "Configuracion_Precios_DB".Asignador_Precios_Instance.Diametro_Comparacion;

0252 #Asignador_Precios_Instance.Largo_Comparacion := "Configuracion_Precios_DB".Asignador_Precios_Instance.Largo_Comparacion;
0253 IF #Mirar_Precio THEN
0254 | #Asignador_Precios_Instance("Productos a procesar" := #Producto_Seleccio-
| nado);
0255 | #Mirar_Precio := FALSE;
0256 | ;
0257 END_IF;
0258
0259
0260
0261
0262
0263

## MAQUINA DE VENDING_10_PRUEBAAUTO / PLC_1 [CPU 1214C DC/DC/ DC] / Bloques de programa / 2_CONTROL_MENU / 2_1Gestion_Produc‐ tos / Conf Precios

## Asignador_Precios [FB6]

Asignador_Precios Propiedades
General
Nombre | Asignador_Precios | Número | 6 | Tipo | FB
Idioma | KOP | Numeración | Automático
Información
Título | Autor | | Comentario
Familia | Versión | 0.1 | ID personali‐ zada

Asignador_Precios
Nombre | Tipo de datos | Valor predet. | Remanencia
Input
Output
InOut
Productos a procesar | "TypeProducto"
Static
Calculo_Total | Real | 0.0 | No remanente
Diametro_Comparacion | Int | 0 | Remanente
Largo_Comparacion | Int | 0 | Remanente
Temp
Constant
Segmento 1:

0001
0002 #Calculo_Total := 0;
0003
0004 | IF #"Productos a procesar".Producto.Tipo = "MADERA" THEN
0005 | #Calculo_Total := #Calculo_Total + "Datos_Precios".Precios.Precio_Ma-
| dera
0006 | ;
0007 | END_IF;
0008
0009 | IF #"Productos a procesar".Producto.Tipo = "AUTOPERFORANTE" THEN
0010 | #Calculo_Total := #Calculo_Total + "Datos_Precios".Precios.Precio_Au-
| toperforante
0011 | ;
0012 | END_IF;
0013
0014 | IF #"Productos a procesar".Producto.Cantidad = "20U" THEN
0015 | #Calculo_Total := #Calculo_Total + "Datos_Precios".Precios.Precio_20u
0016 | ;
0017 | END_IF;
0018
0019 | IF #"Productos a procesar".Producto.Cantidad = "100U" THEN
0020 | #Calculo_Total := #Calculo_Total + "Datos_Precios".Precios.Precio_100u
0021 | ;
0022 | END_IF;
0023

0024 | IF #"Productos a procesar".Producto.Diametro > #Diametro_Comparacion THEN
0025 | #Calculo_Total := #Calculo_Total + "Datos_Precios".Precios.Precio_May-
| or_Diametro
0026 | ;
0027 | END_IF;
0028
0029 | IF #"Productos a procesar".Producto.Diametro <= #Diametro_Comparacion THEN
0030 | #Calculo_Total := #Calculo_Total + "Datos_Precios".Precios.Precio_Me-
| nor_Diametro
0031 | ;
0032 | END_IF;
0033
0034 | IF #"Productos a procesar".Producto.Largo > #Largo_Comparacion THEN
0035 | #Calculo_Total := #Calculo_Total + "Datos_Precios".Precios.Precio_May-
| or_Largo
0036 | ;
0037 | END_IF;
0038
0039 | IF #"Productos a procesar".Producto.Largo <= #Largo_Comparacion THEN
0040 | #Calculo_Total := #Calculo_Total + "Datos_Precios".Precios.Precio_Me-
| nor_Largo
0041 | ;
0042 | END_IF;
0043
0044 | #"Productos a procesar".Producto.Precio := #Calculo_Total;
0045 | ;
0046
0047

## MAQUINA DE VENDING_10_PRUEBAAUTO / PLC_1 [CPU 1214C DC/DC/ DC] / Bloques de programa / 2_CONTROL_MENU / 2_1Gestion_Produc‐ tos / Conf Precios

## Configuracion_Precios [FB4]

Configuracion_Precios Propiedades
General
Nombre | Configuracion_Precios | Número | 4 | Tipo | FB
Idioma | KOP | Numeración | Automático
Información
Título | Autor | | Comentario
Familia | Versión | 0.1 | ID personali‐ zada

Configuracion_Precios
Nombre | Tipo de datos | Valor predet. | Remanencia
Input
Output
InOut
Static
Save_Madera | Bool | false | No remanente
Save_Autoperforante | Bool | false | No remanente
Save_20u | Bool | false | No remanente
Save_100u | Bool | false | No remanente
save_Mayor_Diametro | Bool | false | No remanente
save_Menor_Diametro | Bool | false | No remanente
save_Mayor_Largo | Bool | false | No remanente
save_Menor_Largo | Bool | false | No remanente
Precio_Select | Struct | | No remanente
Take_Precio_Actual | Bool | false | No remanente
Asignador_Precios_Instance | "Asignador_Pre‐ cios"
puntero | Int | 0 | No remanente
Asignar_Precio | Bool | false | No remanente
Temp
Constant
Segmento 1:

0001
0002
0003 IF #Take_Precio_Actual THEN
0004 | #Precio_Select := "Datos_Precios".Precios;
0005 | #Take_Precio_Actual := FALSE;
0006 | ;
0007 END_IF;
0008
0009 IF #Save_Madera THEN
0010 | "Datos_Precios".Precios.Precio_Madera := #Precio_Select.Precio_Madera;
0011 | ;
0012 END_IF;
0013
0014 IF #Save_Autoperforante THEN

0015 | "Datos_Precios".Precios.Precio_Autoperforante := #Precio_Select.Precio_Au-
| toperforante;
0016 | ;
0017 END_IF;
0018
0019 IF #Save_20u THEN
0020 | "Datos_Precios".Precios.Precio_20u := #Precio_Select.Precio_20u;
0021 | ;
0022 END_IF;
0023
0024 IF #Save_100u THEN
0025 | "Datos_Precios".Precios."Precio_100u" := #Precio_Select.Precio_100u;
0026 | ;
0027 END_IF;
0028
0029 IF #save_Mayor_Diametro THEN
0030 | "Datos_Precios".Precios.Precio_Mayor_Diametro := #Precio_Select.Pre-
| cio_Mayor_Diametro;
0031 | ;
0032 END_IF;
0033
0034 IF #save_Menor_Diametro THEN
0035 | "Datos_Precios".Precios.Precio_Menor_Diametro := #Precio_Select.Precio_Me-
| nor_Diametro;
0036 | ;
0037 END_IF;
0038
0039 IF #save_Mayor_Largo THEN
0040 | "Datos_Precios".Precios.Precio_Mayor_Largo := #Precio_Select.Precio_May-
| or_Largo;
0041 | ;
0042 END_IF;
0043
0044 IF #save_Menor_Largo THEN
0045 | "Datos_Precios".Precios.Precio_Menor_Largo := #Precio_Select.Precio_Me-
| nor_Largo;
0046 | ;
0047 END_IF;
0048
0049
0050 IF #Asignar_Precio THEN
0051
0052 | FOR #puntero := 0 TO 31 DO
0053 | #Asignador_Precios_Instance("Productos a procesar" := "BDO_STOCK".Es-
| pacio[#puntero]);
0054 | ;
0055 | END_FOR;
0056
0057 | #Asignar_Precio := FALSE;
0058 | ;
0059 END_IF;
0060
0061
0062
0063

## MAQUINA DE VENDING_10_PRUEBAAUTO / PLC_1 [CPU 1214C DC/DC/ DC] / Bloques de programa / 2_CONTROL_MENU / 2_1Gestion_Produc‐ tos / REPONER_PRODUCTO

## ASIGNACION_ID [FB23]

ASIGNACION_ID Propiedades
General
Nombre | ASIGNACION_ID | Número | 23 | Tipo | FB
Idioma | KOP | Numeración | Automático
Información
Título | Autor | | Comentario
Familia | Versión | 0.1 | ID personali‐ zada

ASIGNACION_ID
Nombre | Tipo de datos | Valor predet. | Remanencia
Input
Output
InOut
Static
Asign_ID | Bool | false | No remanente
Puntero | Int | 0 | No remanente
Producto_string | Array[0..4] of String | | No remanente
ID_producto | String | '' | No remanente
producto | "TypeProducto" | | No remanente
Temp
Constant
Segmento 1:

0001 IF #Asign_ID THEN
0002 | FOR #Puntero := 0 TO 7 DO
0003 | #producto := "PREVIZUALIZACION".Vizulizacion_Productos[#Puntero];
0004
0005 | IF #producto.Producto.Tipo <> 0 THEN
0006
0007 | CASE #producto.Producto.Tipo OF
0008 | 1:
0009 | #Producto_string[0] := 'M'
0010 | ;
0011 | 2:
0012 | #Producto_string[0] := 'C'
0013 | ;
0014 | END_CASE;
0015
0016 | CASE #producto.Producto.Cantidad OF
0017 | 20:
0018 | #Producto_string[1] := 'S'
0019 | ;
0020 | 100:
0021 | #Producto_string[1] := 'L'
0022 | ;
0023 | END_CASE;

0024
0025 | CASE #producto.Producto.Cabeza OF
0026 | 1:
0027 | #Producto_string[2] := 'X'
0028 | ;
0029 | 2:
0030 | #Producto_string[2] := 'P'
0031 | ;
0032 | 3:
0033 | #Producto_string[2] := 'H'
0034 | ;
0035 | 4:
0036 | #Producto_string[2] := 'T'
0037 | ;
0038 | END_CASE;
0039
0040 | CASE #producto.Producto.Diametro OF
0041 | 2:
0042 | #Producto_string[3] := '2'
0043 | ;
0044 | 3:
0045 | #Producto_string[3] := '3'
0046 | ;
0047 | 4:
0048 | #Producto_string[3] := '4'
0049 | ;
0050 | 5:
0051 | #Producto_string[3] := '5'
0052 | ;
0053 | 6:
0054 | #Producto_string[3] := '6'
0055 | ;
0056 | END_CASE;
0057
0058 | CASE #producto.Producto.Largo OF
0059 | 20:
0060 | #Producto_string[4] := '20'
0061 | ;
0062 | 30:
0063 | #Producto_string[4] := '30'
0064 | ;
0065 | 40:
0066 | #Producto_string[4] := '40'
0067 | ;
0068 | 50:
0069 | #Producto_string[4] := '50'
0070 | ;
0071 | 60:
0072 | #Producto_string[4] := '60'
0073 | ;
0074 | END_CASE;
0075
0076 | #ID_producto := CONCAT(IN1 := #Producto_string[0], IN2 := #Produc-
| to_string[1], IN3 := #Producto_string[2], IN4 := #Producto_string[3], IN5 :=
| #Producto_string[4])
0077 | ;
0078
0079 | #ID_producto := INSERT(IN1 := #ID_producto, IN2 := '-', P := 3);
0080 | #ID_producto := INSERT(IN1 := #ID_producto, IN2 := '-', P := 5);

0081
0082 | "LISTA_ID".ID_Product[#Puntero] := #ID_producto;
0083 | ; ELSE
0084 | "LISTA_ID".ID_Product[#Puntero] := '???';
0085 | END_IF;
0086
0087
0088
0089
0090 | END_FOR;
0091 | ;
0092 END_IF;
0093
0094
0095
0096
0097
0098
0099
0100
0101
0102

## MAQUINA DE VENDING_10_PRUEBAAUTO / PLC_1 [CPU 1214C DC/DC/ DC] / Bloques de programa / 2_CONTROL_MENU / 2_1Gestion_Produc‐ tos / REPONER_PRODUCTO

## SAVE_PRODUCT [FB9]

SAVE_PRODUCT Propiedades
General
Nombre | SAVE_PRODUCT | Número | 9 | Tipo | FB
Idioma | KOP | Numeración | Automático
Información
Título | Autor | | Comentario
Familia | Versión | 0.1 | ID personali‐ zada

SAVE_PRODUCT
Nombre | Tipo de datos | Valor predet.
Input
Output
InOut
Static
Producto_guardado | "TypeProducto"
Producto_Vacio | "TypeProducto"
Posicion_actual_ALMACEN | Int | 256
Posicion_actual_ESTANTERIA | Int | 0
SAVE_OK | Bool | false
Pos_final_ALMACEN | Int | 0
Pos_final_STOCK | Int | 0
R_TRIG_Instance | R_TRIG
CONCRET_POSICION | Int | 0
X | Int | 0
P_Estanteria | Array[0..7] of Int
SELECT_POSITION | Bool | false
INDEX | Int | 0
VIZUALIZAR_OK | Bool | false
Rellenar_1 | Bool | false
Rellenar_2 | Bool | false
Pos_1 | Int | 0
Pos_2 | Int | 0
Rellenar_Seccion | DInt | 0
recorrido_seccion | Int | 0
Max_posicion | Int | 0
num_DB_SECCION | DInt | 0
Pos_previsualizacion | Int | 0
Previsualizacion | Bool | false
Cambiar_Estado | Bool | false
Tamaño_bytes | Int | 0
Vaciar | Bool | false
Vaciado1 | Bool | false
Vaciado2 | Bool | false
Temp
Constant
size_Product_Byte | Int | 16

Nombre | Tipo de datos | Valor predet.
Count | Int | 16
Segmento 2:

0001 // ESTANTERIA
0002 //1-256.0 / 2-2384.0 / 3-4512.0 / 4-6640.0

0004 //GUARDAR PRODUCTO EN POSICION
0005 IF #SAVE_OK = TRUE THEN

POKE_BLK(area_src := 16#84, dbNumber_src := 8,
byteOffset_src := 0,
area_dest := 16#84,
dbNumber_dest := #num_DB_SECCION, // 2 si es para la estanteria 3 si es para el almacen
byteOffset_dest := #Pos_final_STOCK,
count := #Count);
;
0015 END_IF;

0018 IF #Vaciar = TRUE THEN

POKE_BLK(area_src := 16#84,
dbNumber_src := 8,
byteOffset_src := #size_Product_Byte, //DIRECCION DEL PRODUCTO VACIO PARA DEJAR EN BLANCO EL PRODUCTO SELECCIONADO area_dest := 16#84,
dbNumber_dest := #num_DB_SECCION, // 2 si es para la estanteria 3 si es para el almacen
byteOffset_dest := #Pos_final_STOCK, //POSICION QUE ELEGIMOS A ELIMINAR
count := #Count);
;
0028 END_IF;

0032 //VIZUALIZAR
0033 IF #VIZUALIZAR_OK = TRUE THEN POKE_BLK(area_src := 16#84, dbNumber_src := #num_DB_SECCION, //2 si es para la estanteria 3 si es para el almacen
byteOffset_src := #Pos_final_STOCK,
area_dest := 16#84,
dbNumber_dest := 8,
byteOffset_dest := 0,
count := #Count);
IF #VIZUALIZAR_OK = TRUE THEN #VIZUALIZAR_OK := FALSE
;
END_IF;
;
0046 END_IF;

0049
0050 #Pos_final_ALMACEN := #Posicion_actual_ALMACEN * #size_Product_Byte; 0051 #Pos_final_STOCK := #Posicion_actual_ESTANTERIA * #size_Product_Byte; 0052
0053
0054
0055 //DETERMINA QUE ESTANTERIA ES Y SEGUN ESO ASIGNAMOS EL ORDEN DE LAS POSICIONES 0056 IF #SELECT_POSITION = TRUE THEN
0057 | FOR #X := #CONCRET_POSICION TO #CONCRET_POSICION + #Max_posicion BY 1
| DO // max posicion 7 estanterias o 2 el almacen
0058 | #P_Estanteria[#INDEX] := #X;
0059 | #INDEX := #INDEX + 1;
0060 | ;
0061 | END_FOR;
0062 | #INDEX := 0;
0063 END_IF;
0064
0065 //RELLENAR 1 ESTE RELLENAR SE USA PARA LAS ESTANTERIAS Y ALMACEN 0066
0067 IF #Rellenar_1 = TRUE THEN
0068
0069 | FOR #Pos_1 := 1 TO #recorrido_seccion DO // recorrido de seccion hasta
| que posicion va a rellenar en almacen 2 y en estanteria 3
0070
0071 | POKE_BLK(area_src := 16#84,
0072 | dbNumber_src := #Rellenar_Seccion,
0073 | byteOffset_src := #P_Estanteria[0] * #size_Product_Byte,
0074 | area_dest := 16#84,
0075 | dbNumber_dest := #Rellenar_Seccion,
0076 | byteOffset_dest := #P_Estanteria[#Pos_1] * #size_Prod-
| uct_Byte,
0077 | count := #Count);
0078 | ;
0079 | END_FOR;
0080 | ;
0081 END_IF;
0082
0083 IF #Vaciado1 = TRUE THEN
0084
0085 | FOR #Pos_1 := 0 TO #recorrido_seccion DO // recorrido de seccion hasta
| que posicion va a rellenar en almacen 2 y en estanteria 3
0086
0087 | POKE_BLK(area_src := 16#84,
0088 | dbNumber_src := 8,
0089 | byteOffset_src := #size_Product_Byte,
0090 | area_dest := 16#84,
0091 | dbNumber_dest := #Rellenar_Seccion,
0092 | byteOffset_dest := #P_Estanteria[#Pos_1] * #size_Prod-
| uct_Byte,
0093 | count := #Count);
0094 | ;
0095 | END_FOR;
0096 | ;
0097 END_IF;
0098
0099 IF #Vaciado2 = TRUE THEN
0100
0101 | FOR #Pos_2 := 4 TO 7 DO // recorrido de seccion hasta que posicion va a
| rellenar en almacen 2 y en estanteria 3

POKE_BLK(area_src := 16#84, dbNumber_src := 8,
byteOffset_src := #size_Product_Byte,
area_dest := 16#84,
dbNumber_dest := #Rellenar_Seccion,
byteOffset_dest := #P_Estanteria[#Pos_2] * #size_Product_Byte,
count := #Count);
;
END_FOR;
;
0113 END_IF;

0117 //RELLENAR 2

0119 IF #Rellenar_2 = TRUE THEN

FOR #Pos_2 := 4 TO 7 DO

POKE_BLK(area_src := 16#84, dbNumber_src := #Rellenar_Seccion,
byteOffset_src := #P_Estanteria[4]*#size_Product_Byte, area_dest := 16#84,
dbNumber_dest := #Rellenar_Seccion,
byteOffset_dest := #P_Estanteria[#Pos_2] * #size_Product_Byte,
count := #Count);
;
END_FOR;
;
0133 END_IF;

0138 // ALMACEN
0139 // 1-256.0 / 2-1054.0 /3-

0142 #Pos_previsualizacion := #CONCRET_POSICION * #size_Product_Byte;

0146 //VIZUALIZAR
0147 IF #Previsualizacion = TRUE THEN POKE_BLK(area_src := 16#84, dbNumber_src := #num_DB_SECCION, //2 si es para la estanteria 3 si es para el almacen
byteOffset_src := #Pos_previsualizacion,
area_dest := 16#84,
dbNumber_dest := 6, //posicion de previzualizacion byteOffset_dest := 0,
count := #Tamaño_bytes); // tamaño bytes de stock 1872 y almacen 542 porque alamacen solo tiene 3 productos mientras que la estanteria 8

#Previsualizacion := FALSE

0157 ;
0158 END_IF;
0159
0160 IF #Cambiar_Estado = TRUE THEN
0161 | POKE_BLK(area_src := 16#84,
0162 | dbNumber_src := 6, //2 si es para la estanteria 3 si es para el
| almacen
0163 | byteOffset_src := 0,
0164 | area_dest := 16#84,
0165 | dbNumber_dest := #num_DB_SECCION, //posicion de previzualizacion
0166 | byteOffset_dest := #Pos_previsualizacion,
0167 | count := #Tamaño_bytes); // tamaño bytes de stock 1872 y alma-
| cen 542 porque alamacen solo tiene 3 productos mientras que la estanteria 8
0168
0169 | #Cambiar_Estado := FALSE
0170 | ;
0171 END_IF;
0172
0173
0174

## MAQUINA DE VENDING_10_PRUEBAAUTO / PLC_1 [CPU 1214C DC/DC/ DC] / Bloques de programa / A_CONTROL_ENTREGA

## BuscadorDeProductos [FB19]

BuscadorDeProductos Propiedades
General
Nombre | BuscadorDeProductos | Número | 19 | Tipo | FB
Idioma | KOP | Numeración | Automático
Información
Título | Autor | | Comentario
Familia | Versión | 0.1 | ID personali‐ zada

BuscadorDeProductos
Nombre | Tipo de datos | Valor predet. | Remanencia
Input
Output
InOut
BuscarProductos | Bool | false | No remanente
Static
Unidades_Producto | Int | 0 | No remanente
Posiciones_Contadas | Int | 0 | No remanente
UnidadesEncontradas | Int | 0 | No remanente
Index_1 | Int | 0 | No remanente
Index_2 | Int | 0 | No remanente
index_3 | Int | 0 | No remanente
Counter_ud | Int | 0 | No remanente
Temp
Constant
Segmento 2:

0001
0002 IF #BuscarProductos THEN
0003 #index_3 := 0;
0004
0005 FOR #Index_1 := 0 TO "Control_Cesta_DB".Unidades_Totales DO
0006
0007 | #Unidades_Producto := "Control_Cesta_DB".Unidades_Cesta[#Index_1];
0008 | #UnidadesEncontradas := 0;
0009
0010 | FOR #Index_2 := 0 TO 31 DO
0011
0012 | IF "DB_Cesta_Productos".Lista_Productos[#Index_1] =
| "BDO_STOCK".Espacio[#Index_2] AND "BDO_STOCK".Espacio[#Index_2].Producto.Dis-
| ponible
0013 | AND #UnidadesEncontradas < #Unidades_Producto THEN
0014 | #Posiciones_Contadas := #Index_2;
0015 | #UnidadesEncontradas := #UnidadesEncontradas + 1;
0016
0017 | IF #Posiciones_Contadas <= 7 AND #Posiciones_Contadas >= 0
| THEN

0018 | "Lista_Posiciones_Productos".PosicionProducto[#in-
| dex_3].Estanteria := 0;
0019 | "Lista_Posiciones_Productos".PosicionProducto[#in-
| dex_3].PosicionConcret := #Posiciones_Contadas;
0020 | ;
0021 | END_IF;
0022
0023 | IF #Posiciones_Contadas <= 15 AND #Posiciones_Contadas >=
| 8 THEN
0024 | "Lista_Posiciones_Productos".PosicionProducto[#in-
| dex_3].Estanteria := 1;
0025 | "Lista_Posiciones_Productos".PosicionProducto[#in-
| dex_3].PosicionConcret := #Posiciones_Contadas - 8;
0026 | ;
0027 | END_IF;
0028
0029 | IF #Posiciones_Contadas <= 23 AND #Posiciones_Contadas >=
| 16 THEN
0030 | "Lista_Posiciones_Productos".PosicionProducto[#in-
| dex_3].Estanteria := 2;
0031 | "Lista_Posiciones_Productos".PosicionProducto[#in-
| dex_3].PosicionConcret := #Posiciones_Contadas - 16;
0032 | ;
0033 | END_IF;
0034
0035 | IF #Posiciones_Contadas <= 31 AND #Posiciones_Contadas >=
| 24 THEN
0036 | "Lista_Posiciones_Productos".PosicionProducto[#in-
| dex_3].Estanteria := 3;
0037 | "Lista_Posiciones_Productos".PosicionProducto[#in-
| dex_3].PosicionConcret := #Posiciones_Contadas - 24;
0038 | ;
0039 | END_IF;
0040
0041 | "Lista_Posiciones_Productos".PosicionProducto[#in-
| dex_3].Tamaño := "BDO_STOCK".Espacio[#Index_2].Producto.Cantidad > "20U";
0042
0043 | #index_3 := #index_3 + 1;
0044
0045 | ;
0046 | END_IF;
0047
0048 | END_FOR;
0049 | ;
0050 | END_FOR;
0051
0052 #BuscarProductos := FALSE; 0053
0054 ;
0055 END_IF;
0056
0057
0058
0059
0060
0061
0062
0063
0064

0065
0066

## MAQUINA DE VENDING_10_PRUEBAAUTO / PLC_1 [CPU 1214C DC/DC/ DC] / Bloques de programa / A_CONTROL_ENTREGA

## Control_Entrega [FB31]

Control_Entrega Propiedades
General
Nombre | Control_Entrega | Número | 31 | Tipo | FB
Idioma | KOP | Numeración | Automático
Información
Título | Autor | | Comentario
Familia | Versión | 0.1 | ID personali‐ zada

Control_Entrega
Nombre | Tipo de datos | Valor predet. | Remanencia
Input
Output
InOut
Static
Ejecutar_Estanterias | Bool | false | No remanente
Ejecutar_ROBOT | Bool | false | No remanente
Buscar_Productos | Bool | false | No remanente
Entregado | Bool | false | No remanente
ESTADO | Int | 0 | No remanente
Next_Estado | Int | 0 | No remanente
Num_Productos_Pedidos | Int | 0 | No remanente
Num_ProductEntregados | Int | 0 | No remanente
Num_PosToGO | Int | 0 | No remanente
CountProductEntregados | Int | 0 | No remanente
Num_PosEstanteria | Int | 0 | No remanente
PosicionaVaciar | Int | 0 | No remanente
PosEntrega | "TypePosMotion" | | No remanente
Temp
Constant
Segmento 1:

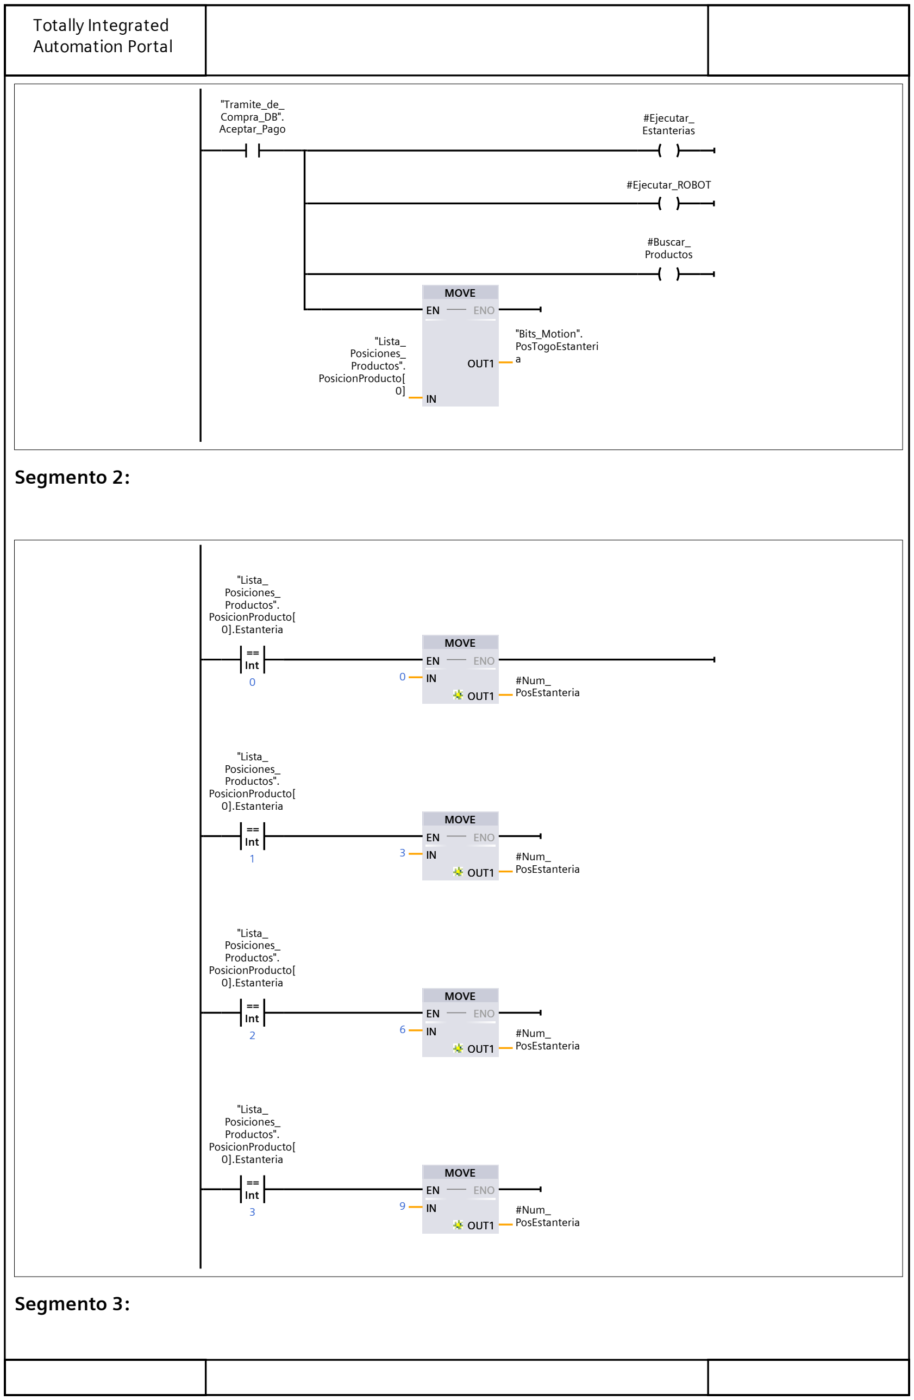
[picture p11: figure]
MOVE; "Tramite_de_ Compra_DB". Aceptar_Pago; #Ejecutar_ Estanterias; #Ejecutar_ROBOT; #Buscar_ Productos; "Lista_ Posiciones_ Productos". PosicionProducto[ 0]; "Bits_Motion". PosTogoEstanteri a; ENO; OUT1; Segmento 2:; Int; "Lista_ Posiciones_ Productos". PosicionProducto[ 0].Estanteria; #Num_; PosEstanteria; Segmento 3:

0001
0002 "Secuencia_EntregaProducto_DB"(IniciarCiclo:=#Ejecutar_ROBOT,
0003 | POS1_Estanteria_XY := "Posiciones_Guarda-
| das".Posiciones[#Num_PosEstanteria],
0004 | POS2_Forward_Z := "Posiciones_Guarda-
| das".Posiciones[#Num_PosEstanteria + 1],
0005 | POS3_GoUp_Y := "Posiciones_Guardadas".Posi-
| ciones[#Num_PosEstanteria + 2],
0006 | Pos_Entrega:=#PosEntrega,
0007 | Pos_Entrega_Forward:=#PosEntrega,
0008 | TamañoDeCaja := "Lista_Posiciones_Produc-
| tos".PosicionProducto[#Num_ProductEntregados].Tamaño,
0009 | WasFound:=false);
0010

## MAQUINA DE VENDING_10_PRUEBAAUTO / PLC_1 [CPU 1214C DC/DC/ DC] / Bloques de programa / A_CONTROL_REPONER

## Buscador_EspacioVacio [FB37]

Buscador_EspacioVacio Propiedades
General
Nombre | Buscador_EspacioVacio | Número | 37 | Tipo | FB
Idioma | KOP | Numeración | Automático
Información
Título | Autor | | Comentario
Familia | Versión | 0.1 | ID personali‐ zada

Buscador_EspacioVacio
Nombre | Tipo de datos | Valor predet. | Remanencia
Input
Output
InOut
BuscarPosVacias | Bool | false | No remanente
Static
Encontrado_Producto | Bool | false | No remanente
PosVaciaEncontrada | Bool | false | No remanente
Index_1 | Int | 0 | No remanente
Index_2 | Int | 0 | No remanente
Index_3 | Int | 0 | No remanente
PosVaciaEstanteria | Int | 0 | No remanente
PosCargador | "TypePosicionPro‐ ducto" | | No remanente
PosEstanteria | "TypePosicionPro‐ ducto" | | No remanente
ProductoNulo | "TypeProducto" | | No remanente
Temp
Constant
Segmento 2:

0001
0002 IF #BuscarPosVacias THEN
0003
0004 | FOR #Index_1 := 0 TO 31 DO
0005 | IF "BDO_STOCK".Espacio[#Index_1].Producto.Disponible = FALSE AND
| "BDO_STOCK".Espacio[#Index_1].Producto.Tipo > 0 THEN
0006 | #PosVaciaEstanteria := #Index_1;
0007 | #PosVaciaEncontrada := TRUE;
0008 | EXIT;
0009 | END_IF;
0010 | END_FOR;
0011
0012 | IF #PosVaciaEncontrada THEN
0013 | FOR #Index_2 := 0 TO 3 DO
0014 | FOR #Index_3 := 0 TO 2 DO
0015 | IF "BDO_STOCK".Espacio[#PosVaciaEstanteria].Producto.Tipo =
| "BDO_ALMACEN".Espacio[#Index_2, #Index_3].Producto.Tipo

0016 | AND "BDO_STOCK".Espacio[#PosVaciaEstanteria].Producto.Ca-
| beza = "BDO_ALMACEN".Espacio[#Index_2, #Index_3].Producto.Cabeza
0017 | AND "BDO_STOCK".Espacio[#PosVaciaEstanteria].Producto.Can-
| tidad = "BDO_ALMACEN".Espacio[#Index_2, #Index_3].Producto.Cantidad
0018 | AND "BDO_STOCK".Espacio[#PosVaciaEstanteria].Producto.Dia-
| metro = "BDO_ALMACEN".Espacio[#Index_2, #Index_3].Producto.Diametro
0019 | AND "BDO_STOCK".Espacio[#PosVaciaEstanteria].Producto.Lar-
| go = "BDO_ALMACEN".Espacio[#Index_2, #Index_3].Producto.Largo
0020 | AND "BDO_ALMACEN".Espacio[#Index_2, #Index_3].Produc-
| to.Disponible = TRUE THEN
0021 | #PosCargador.Estanteria := #Index_2;
0022 | #PosCargador.PosicionConcret := #Index_3;
0023 | #Encontrado_Producto := TRUE;
0024 | END_IF;
0025
0026 | IF #Encontrado_Producto THEN
0027 | EXIT;
0028 | END_IF;
0029
0030 | END_FOR;
0031 | #PosCargador.Tamaño := "BDO_STOCK".Espacio[#PosVaciaEstante-
| ria].Producto.Cantidad > "20U";
0032
0033 | IF #Encontrado_Producto THEN
0034 | EXIT;
0035 | END_IF;
0036
0037 | END_FOR;
0038 | ;
0039
0040 | #PosVaciaEncontrada := FALSE;
0041 | END_IF;
0042
0043 | IF #PosVaciaEstanteria <= 7 AND #PosVaciaEstanteria >= 0 THEN
0044 | #PosEstanteria.Estanteria := 0;
0045 | #PosEstanteria.PosicionConcret := #PosVaciaEstanteria;
0046 | ;
0047 | END_IF;
0048
0049 | IF #PosVaciaEstanteria <= 15 AND #PosVaciaEstanteria >= 8 THEN
0050 | #PosEstanteria.Estanteria := 1;
0051 | #PosEstanteria.PosicionConcret := #PosVaciaEstanteria - 8;
0052 | ;
0053 | END_IF;
0054
0055 | IF #PosVaciaEstanteria <= 23 AND #PosVaciaEstanteria >= 16 THEN
0056 | #PosEstanteria.Estanteria := 2;
0057 | #PosEstanteria.PosicionConcret := #PosVaciaEstanteria - 16;
0058 | ;
0059 | END_IF;
0060
0061 | IF #PosVaciaEstanteria <= 31 AND #PosVaciaEstanteria >= 24 THEN
0062 | #PosEstanteria.Estanteria := 3;
0063 | #PosEstanteria.PosicionConcret := #PosVaciaEstanteria - 24;
0064 | ;
0065 | END_IF;
0066 | #PosEstanteria.Tamaño := "BDO_ALMACEN".Espacio[#PosCargador.Estanteria,
| #PosCargador.PosicionConcret].Producto.Cantidad > "20U";
0067

0068
0069
0070
0071 #Encontrado_Producto := FALSE; 0072 #BuscarPosVacias := FALSE; 0073
0074 END_IF;
0075

## MAQUINA DE VENDING_10_PRUEBAAUTO / PLC_1 [CPU 1214C DC/DC/ DC] / Bloques de programa / A_CONTROL_REPONER

## Control_Reponer [FB35]

Control_Reponer Propiedades
General
Nombre | Control_Reponer | Número | 35 | Tipo | FB
Idioma | KOP | Numeración | Automático
Información
Título | Autor | | Comentario
Familia | Versión | 0.1 | ID personali‐ zada

Control_Reponer
Nombre | Tipo de datos | Valor predet. | Remanencia
Input
Output
InOut
Static
PeticionDeReponer | Bool | false | No remanente
Secuencia_Reponer_On | Bool | false | No remanente
TiempoParaReponer | TON_TIME | | No remanente
Temp
Constant
Segmento 1:

TON
Time
S

"AlwaysTRUE"

%M1.2 | #PeticionDeRepo ner

#TiempoParaRepo

ner
T#2M | ...

#PeticionDeRepo

ner
IN
PT

Q
ET

Time
IN
PT

Q
ET

Time

Segmento 2:

S

#PeticionDeRepo

ner

#Secuencia_

Reponer_On

Segmento 3:

Segmento 5:

0001
0002
0003

## A_MOTION_CONTROL

## Moves_Axis_Manual [FB15]

Moves_Axis_Manual Propiedades
General
Nombre | Moves_Axis_Manual | Número | 15 | Tipo | FB
Idioma | KOP | Numeración | Automático
Información
Título | Autor | | Comentario
Familia | Versión | 0.1 | ID personali‐ zada
Nombre | Tipo de datos | Valor predet. | Remanencia
Input
EJE_X | DB_ANY | 0 | No remanente
EJE_Y | DB_ANY | 0 | No remanente
EJE_Z | DB_ANY | 0 | No remanente
btnMovePositive_X | Bool | false | No remanente
btnMoveNegative_X | Bool | false | No remanente
btnMovePositive_Y | Bool | false | No remanente
btnMoveNegative_Y | Bool | false | No remanente
btnMovePositive_Z | Bool | false | No remanente
btnMoveNegative_Z | Bool | false | No remanente
rVelocidad_X | Real | 0.0 | No remanente
rVelocidad_Y | Real | 0.0 | No remanente
rVelocidad_Z | Real | 0.0 | No remanente
Output
InOut
Static
rDistancia_Select_X | Real | 0.0 | No remanente
rDistancia_Select_X- | Real | 0.0 | No remanente
rDistancia_Select_Y | Real | 0.0 | No remanente
rDistancia_Select_Y- | Real | 0.0 | No remanente
rDistancia_Select_Z | Real | 0.0 | No remanente
rDistancia_Select_Z- | Real | 0.0 | No remanente
MR_EJE_X+ | MC_MoveRelative
MR_EJE_Y+ | MC_MoveRelative
MR_EJE_Z+ | MC_MoveRelative
MR_EJE_X- | MC_MoveRelative
MR_EJE_Y- | MC_MoveRelative
MR_EJE_Z- | MC_MoveRelative
Temp
Constant
velocity | Real | 0.0
Segmento 1:

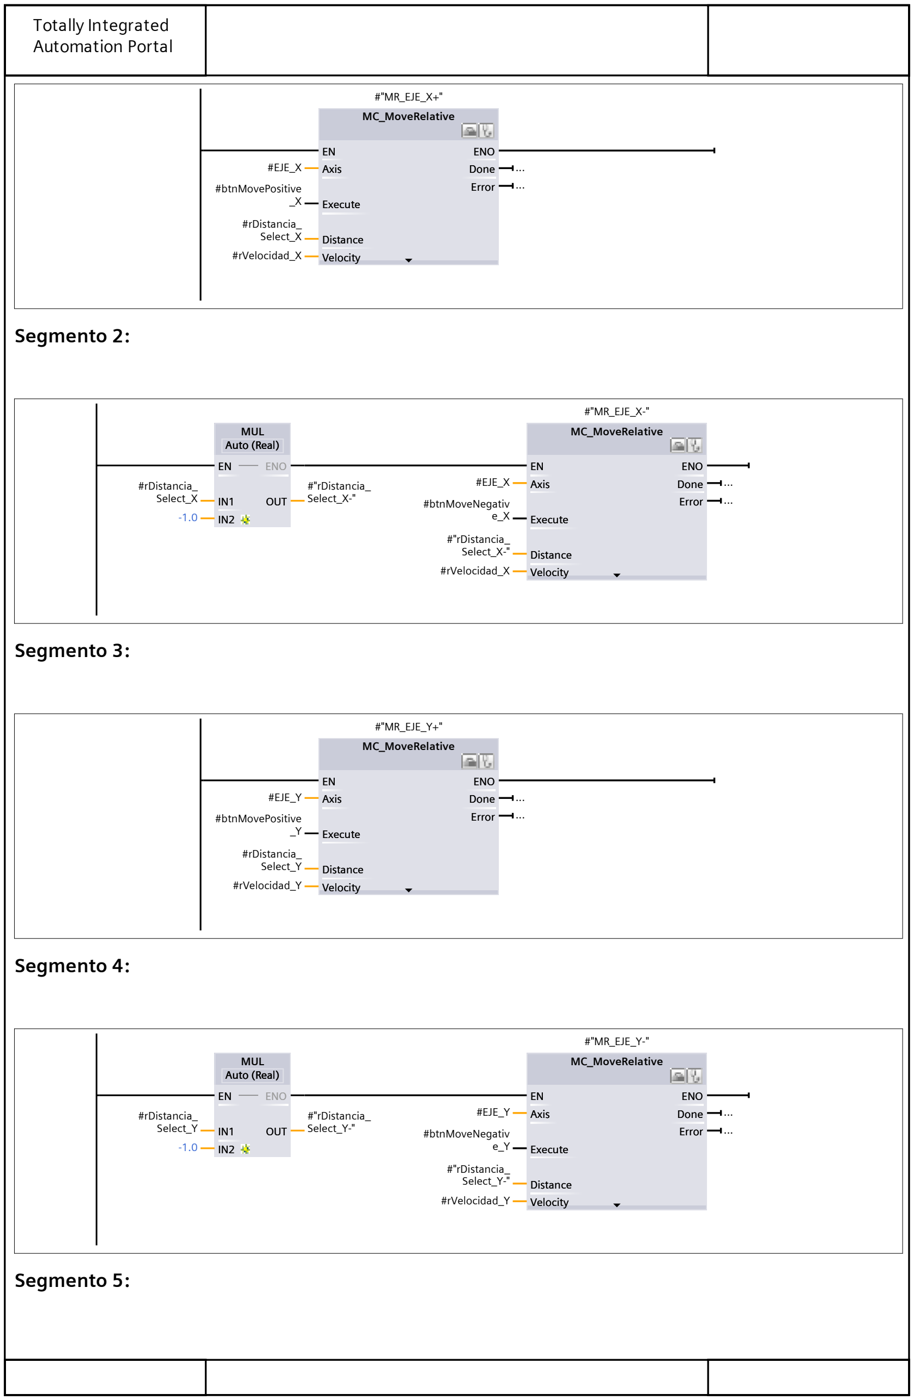
[picture p12: figure]
MC_MoveRelative; #"MR_EJE_X+"; #EJE_X; #btnMovePositive _X; #rDistancia_ Select_X #rVelocidad_X; EN Axis; Execute; Distance Velocity; ENO Done Error; Segmento 2:; MUL Auto (Real); #rDistancia_ Select_X -1.0; #"rDistancia_ Select_X-"; #"MR_EJE_X-"; #btnMoveNegativ e_X; #"rDistancia_ Select_X-" #rVelocidad_X; ENO; OUT; Auto (Real); Segmento 3:; #"MR_EJE_Y+"; #EJE_Y; #btnMovePositive _Y; #rDistancia_ Select_Y #rVelocidad_Y; Segmento 4:; #rDistancia_ Select_Y -1.0; #"rDistancia_ Select_Y-"; #"MR_EJE_Y-"; #btnMoveNegativ e_Y; #"rDistancia_ Select_Y-" #rVelocidad_Y; Segmento 5:

MC_MoveRelative

#"MR_EJE_Z+"

#EJE_Z

#btnMovePositive

_Z
#rDistancia_

Select_Z
#rVelocidad_Z

EN
Axis

Execute

Distance
Velocity

ENO
Done
Error

EN
Axis

Execute

Distance
Velocity

ENO
Done
Error

Segmento 6:

MUL
Auto (Real)

MC_MoveRelative

#rDistancia_

Select_Z
-1.0

#"rDistancia_

Select_Z-"

#"MR_EJE_Z-"

#EJE_Z

#btnMoveNegativ

e_Z
#"rDistancia_

Select_Z-"
#rVelocidad_Z

EN

IN1
IN2

ENO

OUT

Auto (Real)
EN
Axis

Execute

Distance
Velocity

ENO
Done
Error

EN

IN1
IN2

ENO

OUT

Auto (Real)
EN
Axis

Execute

Distance
Velocity

ENO
Done
Error

Segmento 7:

## A_MOTION_CONTROL

## Moves_Axis_Manual_DB [DB36]

Moves_Axis_Manual_DB Propiedades
General
Nombre | Moves_Axis_Manual_DB | Número | 36 | Tipo | DB
Idioma | DB | Numeración | Automático
Información
Título | Autor | | Comentario
Familia | Versión | 0.1 | ID personali‐ zada
Nombre | Tipo de datos | Valor de arranque | Remanencia
Input
EJE_X | DB_ANY | 0 | False
EJE_Y | DB_ANY | 0 | False
EJE_Z | DB_ANY | 0 | False
btnMovePositive_X | Bool | false | False
btnMoveNegative_X | Bool | false | False
btnMovePositive_Y | Bool | false | False
btnMoveNegative_Y | Bool | false | False
btnMovePositive_Z | Bool | false | False
btnMoveNegative_Z | Bool | false | False
rVelocidad_X | Real | 0.0 | False
rVelocidad_Y | Real | 0.0 | False
rVelocidad_Z | Real | 0.0 | False
Output
InOut
Static
rDistancia_Select_X | Real | 0.0 | False
rDistancia_Select_X- | Real | 0.0 | False
rDistancia_Select_Y | Real | 0.0 | False
rDistancia_Select_Y- | Real | 0.0 | False
rDistancia_Select_Z | Real | 0.0 | False
rDistancia_Select_Z- | Real | 0.0 | False
MR_EJE_X+ | MC_MoveRelative | | False
MR_EJE_Y+ | MC_MoveRelative | | False
MR_EJE_Z+ | MC_MoveRelative | | False
MR_EJE_X- | MC_MoveRelative | | False
MR_EJE_Y- | MC_MoveRelative | | False
MR_EJE_Z- | MC_MoveRelative | | False

## A_MOTION_CONTROL

## ROBOT AXIS [FB30]

ROBOT AXIS Propiedades
General
Nombre | ROBOT AXIS | Número | 30 | Tipo | FB
Idioma | KOP | Numeración | Automático
Información
Título | Autor | | Comentario
Familia | Versión | 0.1 | ID personali‐ zada
Nombre | Tipo de datos | Valor predet. | Remanencia
Input
Output
InOut
Static
EJE_X_Enabled | Bool | false | No remanente
EJE_Y_Enabled | Bool | false | No remanente
EJE_Z_Enabled | Bool | false | No remanente
General_Disabled | Bool | false | No remanente
EJE_X_Done | Bool | false | No remanente
EJE_Y_Done | Bool | false | No remanente
EJE_Z_Done | Bool | false | No remanente
EJE_X_ERROR | Bool | false | No remanente
EJE_Y_ERROR | Bool | false | No remanente
EJE_Z_ERROR | Bool | false | No remanente
General_ERROR | Bool | false | No remanente
EJE_X_Ocupado | Bool | false | No remanente
EJE_Y_Ocupado | Bool | false | No remanente
EJE_Z_Ocupado | Bool | false | No remanente
InPosition_X | Bool | false | No remanente
InPosition_Y | Bool | false | No remanente
InPosition_Z | Bool | false | No remanente
ExecuteMovment | Bool | false | No remanente
EnPosicionEscogida | Bool | false | No remanente
VelocidadEjes | Int | 25 | No remanente
PosicionToGo | "TypePosMotion" | | No remanente
PosEscogida_Final | "TypePosMotion" | | No remanente
MODOS_MOTION_XYZ | "MODOS_MOTION"
timer1 | TON_TIME | | No remanente
Temp
Constant
Segmento 1:

"ATIVACION_DE_EJES"

%FC8

#EJE_X_Enabled

#EJE_Y_Enabled

#EJE_Z_Enabled

EN | ENO EJE_X_Enable EJE_Y_Enable EJE_Z_Enable

Segmento 2:

"Guardar_Datos_Ejes"

%FC5

"EJE_X".
ActualPosition
"EJE_X".
ActualVelocity
"EJE_Y".
ActualPosition
"EJE_Y".
ActualVelocity
"EJE_Z".
ActualPosition
"EJE_Z".
ActualVelocity

EN

Eje_X_Position

Eje_X_Velocity

Eje_Y_Position

Eje_Y_Velocity

Eje_Z_Position

Eje_Z_Velocity

EN | ENO

Eje_X_Position

Eje_X_Velocity

Eje_Y_Position

Eje_Y_Velocity

Eje_Z_Position

Eje_Z_Velocity

ENO

Segmento 3:

"MODOS_MOTION"

%FB36

#MODOS_

MOTION_XYZ

#PosicionToGo

10.0

70.0

70.0

0.0
#PosEscogida_

Final

#ExecuteMovmen

t

EN
PosToGo
OFFSET_UP
OFFSET_
Forward
OFFSET_
Backward
OFFSET_
BackwardCarga
dor

PositionToGO

ENO

ExecuteMove

EN
PosToGo
OFFSET_UP
OFFSET_
Forward
OFFSET_
Backward
OFFSET_
BackwardCarga
dor

PositionToGO

ENO

ExecuteMove

Segmento 4:

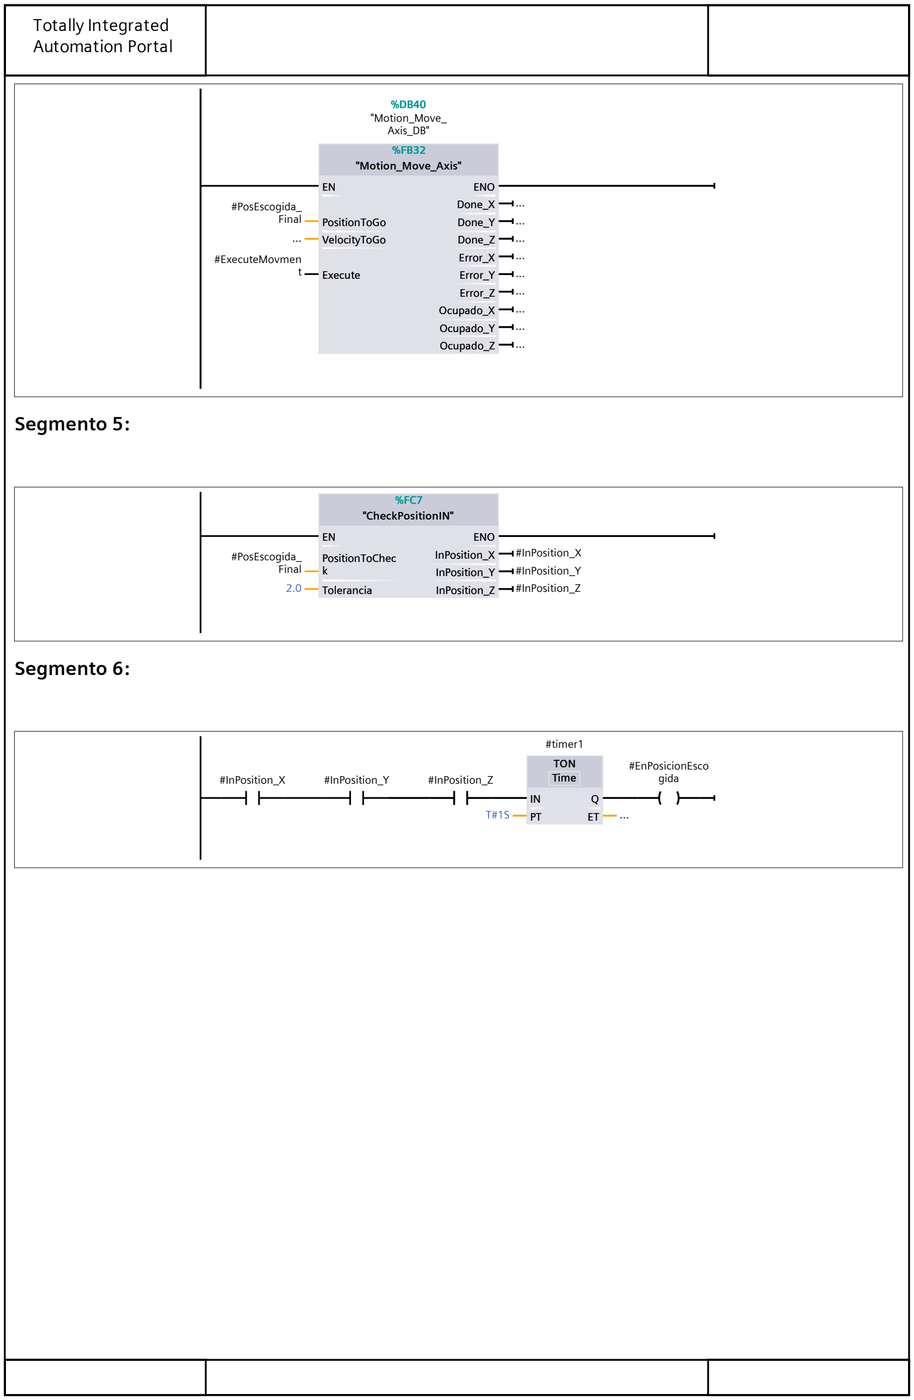
[picture p13: figure]
"Motion_Move_Axis"; "Motion_Move_ Axis_DB"; #PosEscogida_ Final ...; #ExecuteMovmen t; PositionToGo VelocityToGo; Execute; ENO Done_X Done_Y Done_Z Error_X Error_Y Error_Z Ocupado_X Ocupado_Y Ocupado_Z; Segmento 5:; "CheckPositionIN"; #PosEscogida_ Final 2.0; #InPosition_X #InPosition_Y #InPosition_Z; PositionToChec k Tolerancia; ENO InPosition_X InPosition_Y InPosition_Z; Segmento 6:; TON; #timer1; #EnPosicionEsco gida; Time

#InPosition_X | #InPosition_Y | #InPosition_Z | Time

## A_MOTION_CONTROL

## ATIVACION_DE_EJES [FC8]

ATIVACION_DE_EJES Propiedades
General
Nombre | ATIVACION_DE_EJES | Número | 8 | Tipo | FC
Idioma | KOP | Numeración | Automático
Información
Título | Autor | | Comentario
Familia | Versión | 0.1 | ID personali‐ zada
Nombre | Tipo de datos | Valor predet.
Input
Output
EJE_X_Enable | Bool
EJE_Y_Enable | Bool
EJE_Z_Enable | Bool
InOut
Temp
Constant
Return
ATIVACION_DE_EJES | Void
Segmento 1:

MC_Power

"MC_Power_
DB_Eje_X"

%DB45

"EJE_X"

%DB37

1
0

#EJE_X_Enable

"AlwaysTRUE"

%M1.2

EN

Axis

Enable
StartMode
StopMode

ENO
Status
Busy
Error
ErrorID
ErrorInfo

EN

Axis

Enable
StartMode
StopMode

ENO
Status
Busy
Error
ErrorID
ErrorInfo

Segmento 2:

MC_Power

"MC_Power_
DB_Eje_Y"

%DB46

"EJE_Y"

%DB38

1
0

#EJE_Y_Enable

"AlwaysTRUE"

%M1.2

EN

Axis

Enable
StartMode
StopMode

ENO
Status
Error

EN

Axis

Enable
StartMode
StopMode

ENO
Status
Error

Segmento 3:

MC_Power

"MC_Power_
DB_Eje_Z"

%DB47

"EJE_Z"

%DB39

1
0

#EJE_Z_Enable

"AlwaysTRUE"

%M1.2

EN

Axis

Enable
StartMode
StopMode

ENO
Status
Error

EN

Axis

Enable
StartMode
StopMode

ENO
Status
Error

## A_MOTION_CONTROL

## CheckPositionIN [FC7]

CheckPositionIN Propiedades
General
Nombre | CheckPositionIN | Número | 7 | Tipo | FC
Idioma | KOP | Numeración | Automático
Información
Título | Autor | | Comentario
Familia | Versión | 0.1 | ID personali‐ zada
Nombre | Tipo de datos | Valor predet.
Input
PositionToCheck | "TypePosMotion"
Tolerancia | Real
Output
InPosition_X | Bool
InPosition_Y | Bool
InPosition_Z | Bool
InOut
Temp
Puntero | Int
PosActual | "TypePosicion"
MinPosition | Real
MaxPosition | Real
Margenes | "TypeMargen"
Constant
Return
CheckPositionIN | Void
Segmento 1:

MOVE

MOVE

MOVE

"Datos_reales_
ejes".Pos_Eje_
X

#PosActual.Pos_X

"Datos_reales_
ejes".Pos_Eje_
Y

#PosActual.Pos_Y

"Datos_reales_
ejes".Pos_Eje_
Z

#PosActual.Pos_Z

EN

IN

ENO
OUT1

EN

IN

ENO
OUT1

EN

IN

ENO
OUT1

EN

IN

ENO
OUT1

EN

IN

ENO
OUT1

EN

IN

ENO
OUT1

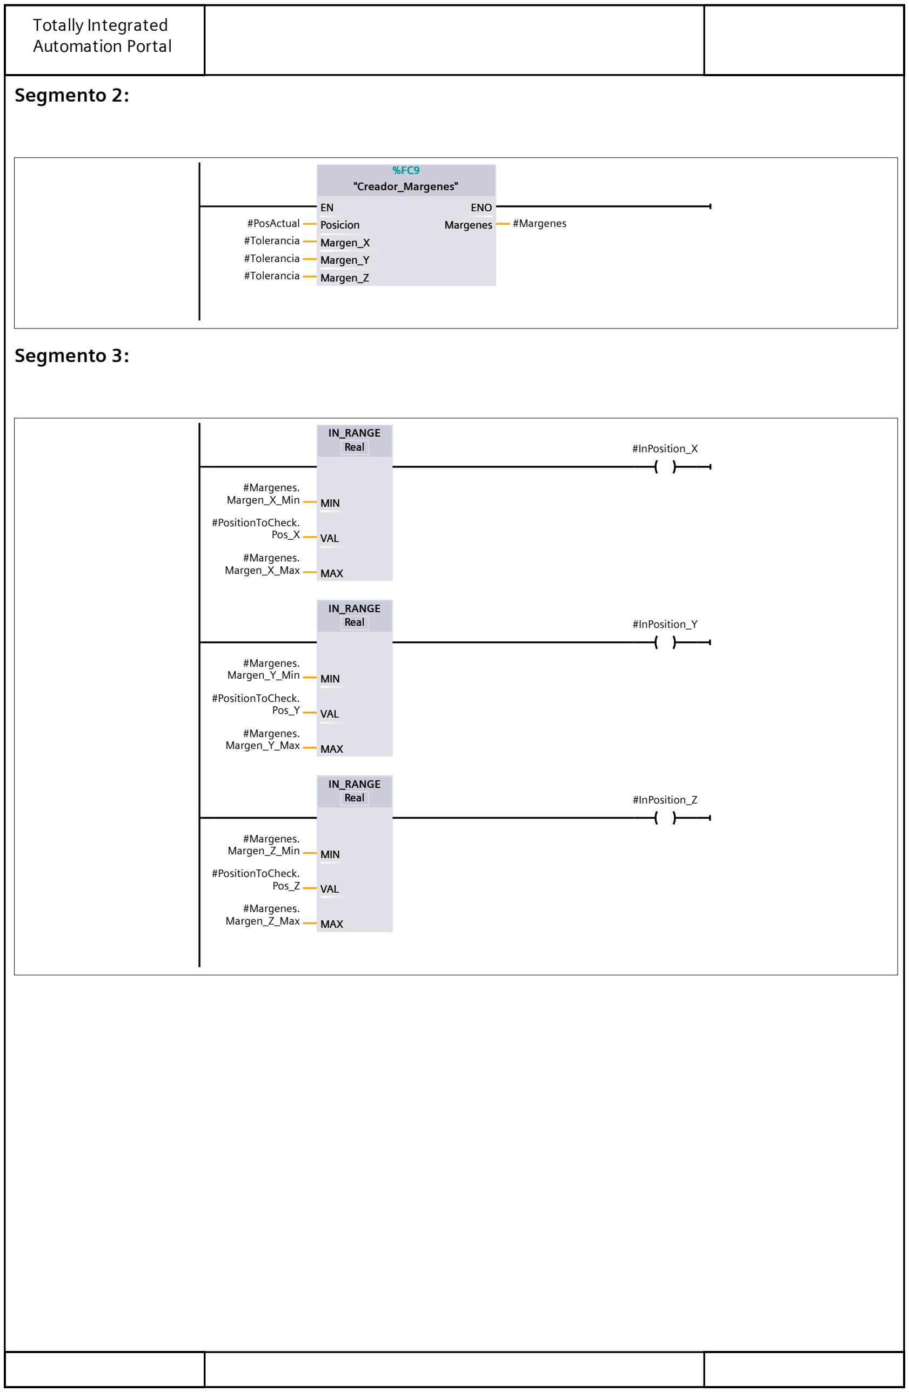
[picture p14: figure]
Segmento 2:; "Creador_Margenes"; #PosActual #Tolerancia #Tolerancia #Tolerancia; #Margenes; EN Posicion Margen_X Margen_Y Margen_Z; ENO Margenes; Segmento 3:; IN_RANGE Real; #Margenes. Margen_X_Min; #PositionToCheck. Pos_X; #Margenes. Margen_X_Max; #InPosition_X; #Margenes. Margen_Y_Min; #PositionToCheck. Pos_Y; #Margenes. Margen_Y_Max; #InPosition_Y; #Margenes. Margen_Z_Min; #PositionToCheck. Pos_Z; #Margenes. Margen_Z_Max; #InPosition_Z; MIN; VAL; MAX; Real

## A_MOTION_CONTROL

## Guardar_Datos_Ejes [FC5]

Guardar_Datos_Ejes Propiedades
General
Nombre | Guardar_Datos_Ejes | Número | 5 | Tipo | FC
Idioma | KOP | Numeración | Automático
Información
Título | Autor | | Comentario
Familia | Versión | 0.1 | ID personali‐ zada
Nombre | Tipo de datos | Valor predet.
Input
Eje_X_Position | Real
Eje_X_Velocity | Real
Eje_Y_Position | Real
Eje_Y_Velocity | Real
Eje_Z_Position | Real
Eje_Z_Velocity | Real
Output
InOut
Temp
Constant
Return
Guardar_Datos_Ejes | Void
Segmento 1: EJE X

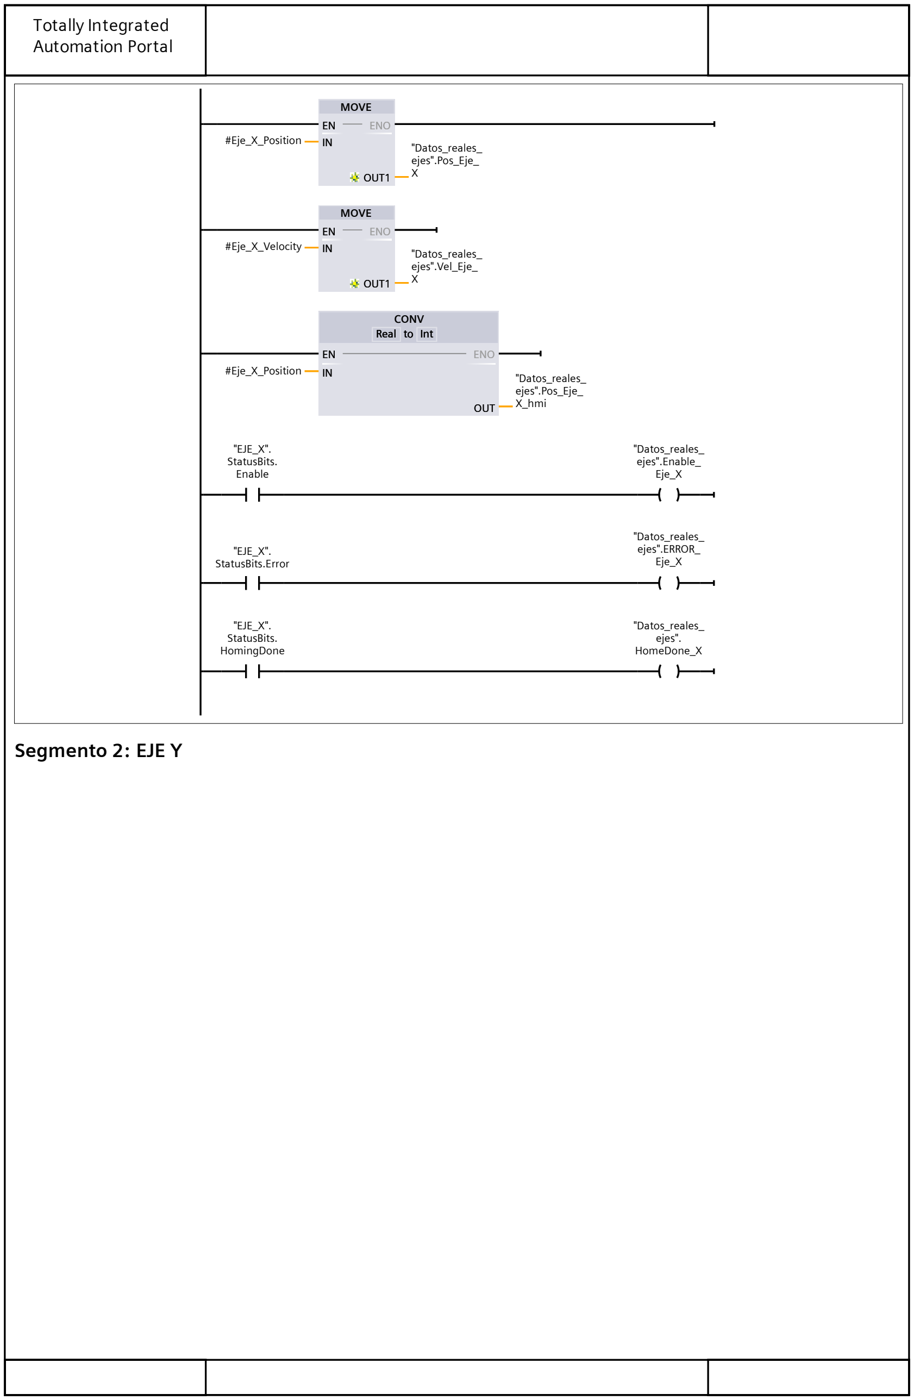
[picture p15: figure]
MOVE; CONV Real to Int; #Eje_X_Position; "Datos_reales_; ejes".Pos_Eje_ X; #Eje_X_Velocity; ejes".Vel_Eje_ X; ejes".Pos_Eje_ X_hmi; "EJE_X". StatusBits. Enable; "Datos_reales_ ejes".Enable_ Eje_X; "EJE_X". StatusBits.Error; "Datos_reales_ ejes".ERROR_ Eje_X; "EJE_X". StatusBits. HomingDone; "Datos_reales_ ejes". HomeDone_X; ENO; OUT1; OUT; Real to Int; Segmento 2: EJE Y

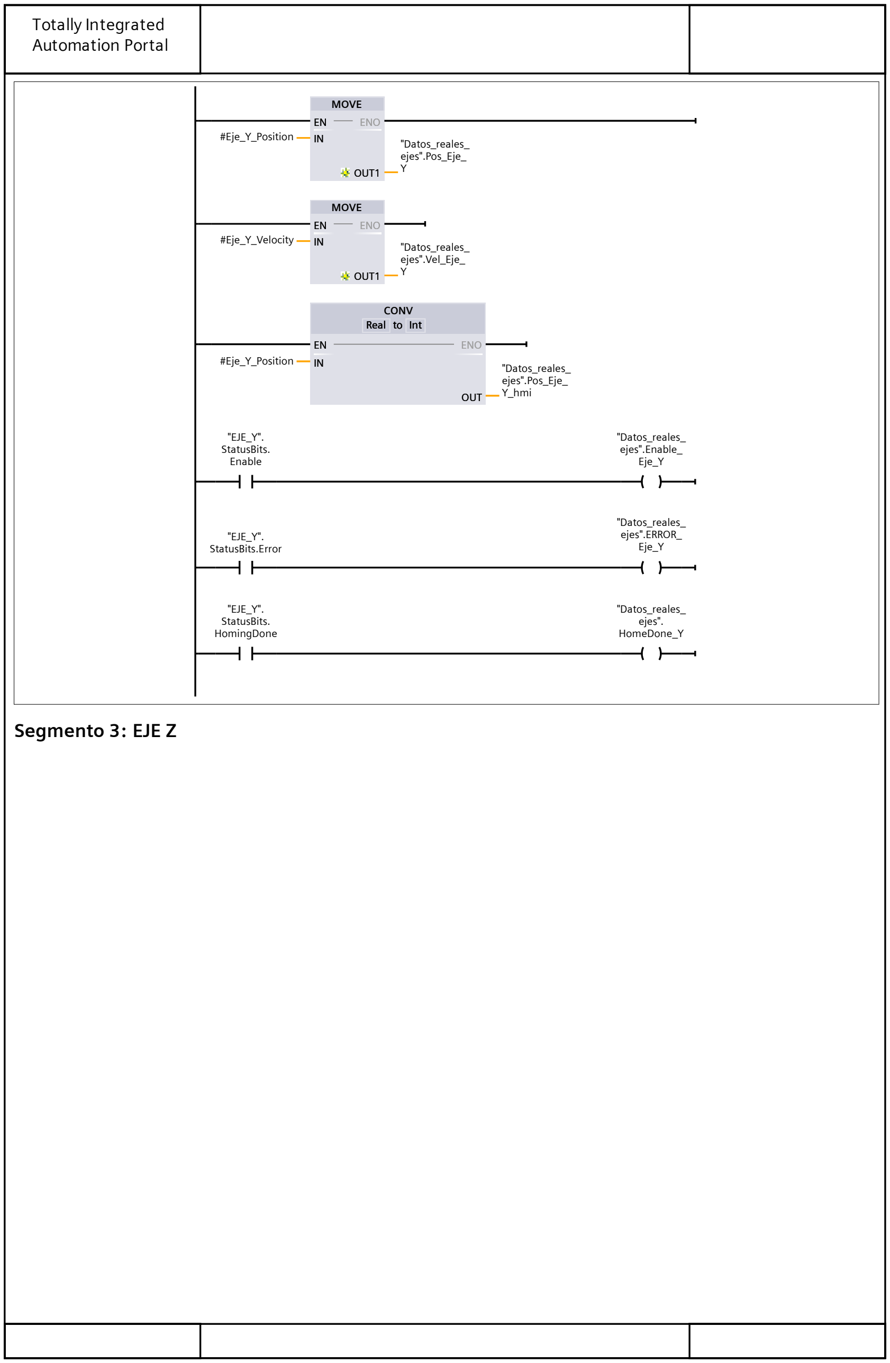
[picture p16: figure]
MOVE; CONV Real to Int; #Eje_Y_Position; "Datos_reales_; ejes".Pos_Eje_ Y; #Eje_Y_Velocity; ejes".Vel_Eje_ Y; ejes".Pos_Eje_ Y_hmi; "EJE_Y". StatusBits. Enable; "Datos_reales_ ejes".Enable_ Eje_Y; "EJE_Y". StatusBits.Error; "Datos_reales_ ejes".ERROR_ Eje_Y; "EJE_Y". StatusBits. HomingDone; "Datos_reales_ ejes". HomeDone_Y; ENO; OUT1; OUT; Real to Int; Segmento 3: EJE Z

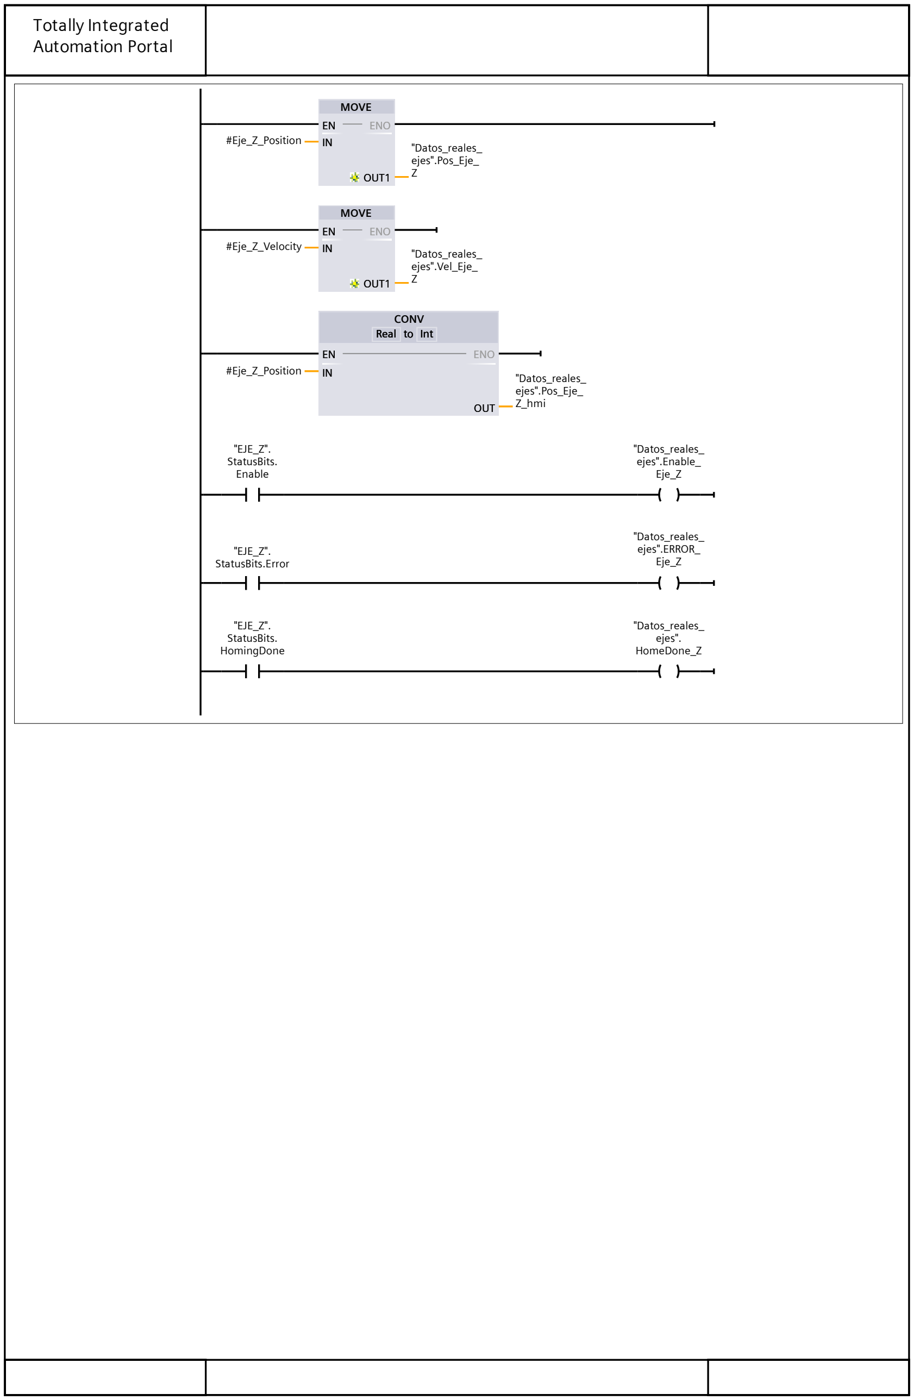
[picture p17: figure]
MOVE; CONV Real to Int; #Eje_Z_Position; "Datos_reales_; ejes".Pos_Eje_ Z; #Eje_Z_Velocity; ejes".Vel_Eje_ Z; ejes".Pos_Eje_ Z_hmi; "EJE_Z". StatusBits. Enable; "Datos_reales_ ejes".Enable_ Eje_Z; "EJE_Z". StatusBits.Error; "Datos_reales_ ejes".ERROR_ Eje_Z; "EJE_Z". StatusBits. HomingDone; "Datos_reales_ ejes". HomeDone_Z; ENO; OUT1; OUT; Real to Int

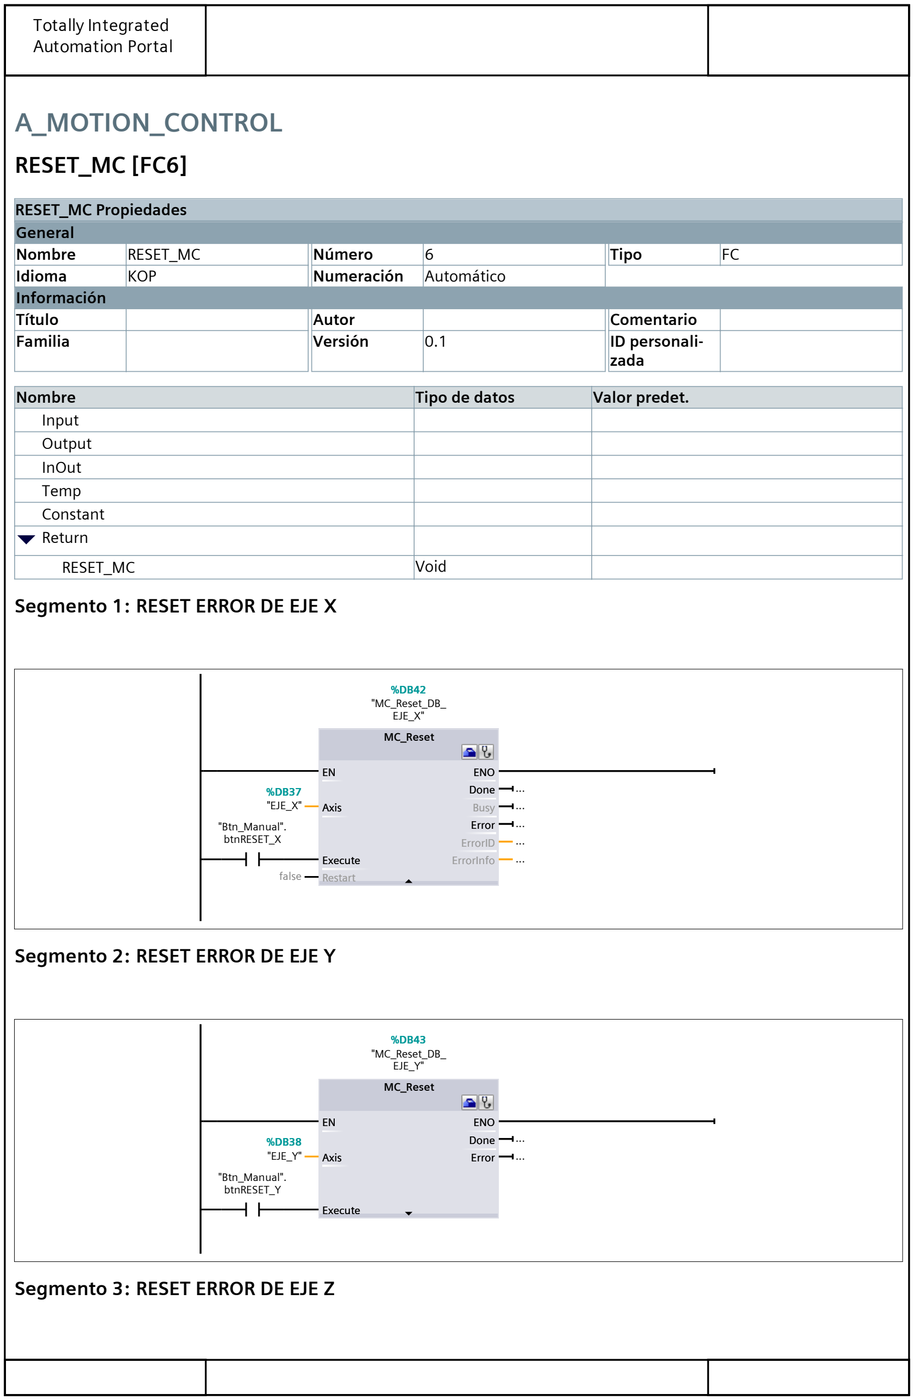
[picture p18: figure]
A_MOTION_CONTROL; RESET_MC [FC6]; RESET_MC Propiedades General; Nombre; RESET_MC; Número; Tipo; Idioma; KOP; Numeración; Automático; Información; Título; Autor; Comentario; Familia; Versión; ID personali‐ zada; Tipo de datos; Valor predet.; Input Output InOut Temp Constant Return; Void; Segmento 1: RESET ERROR DE EJE X; MC_Reset; "MC_Reset_DB_ EJE_X"; "EJE_X"; false; "Btn_Manual". btnRESET_X; Axis; Execute Restart; ENO Done Busy Error ErrorID ErrorInfo; Segmento 2: RESET ERROR DE EJE Y; "MC_Reset_DB_ EJE_Y"; "EJE_Y"; "Btn_Manual". btnRESET_Y; Execute; ENO Done Error; Segmento 3: RESET ERROR DE EJE Z

MC_Reset

"MC_Reset_DB_
EJE_Z"

%DB44

"EJE_Z"

%DB39

false

"Btn_Manual".
btnRESET_Z

"Go_TO_HOME_
DB".ResetError

EN

Axis

Execute
Restart

ENO
Done
Busy
Error
ErrorID
ErrorInfo

EN

Axis

Execute
Restart

ENO
Done
Busy
Error
ErrorID
ErrorInfo

Segmento 4:

## A_MOTION_CONTROL

## Motion_Move_Axis [FB32]

Motion_Move_Axis Propiedades
General
Nombre | Motion_Move_Axis | Número | 32 | Tipo | FB
Idioma | KOP | Numeración | Automático
Información
Título | Autor | | Comentario
Familia | Versión | 0.1 | ID personali‐ zada
Nombre | Tipo de datos | Valor predet. | Remanencia
Input
PositionToGo | "TypePosMotion" | | No remanente
VelocityToGo | "TypeVelocity" | | No remanente
Execute | Bool | false | No remanente
Output
Done_X | Bool | false | No remanente
Done_Y | Bool | false | No remanente
Done_Z | Bool | false | No remanente
Error_X | Bool | false | No remanente
Error_Y | Bool | false | No remanente
Error_Z | Bool | false | No remanente
Ocupado_X | Bool | false | No remanente
Ocupado_Y | Bool | false | No remanente
Ocupado_Z | Bool | false | No remanente
InOut
Static
MC_ABS_Move_X | MC_MoveAbsolute
MC_ABS_Move_Y | MC_MoveAbsolute
MC_ABS_Move_Z | MC_MoveAbsolute
Temp
Constant
Segmento 1:

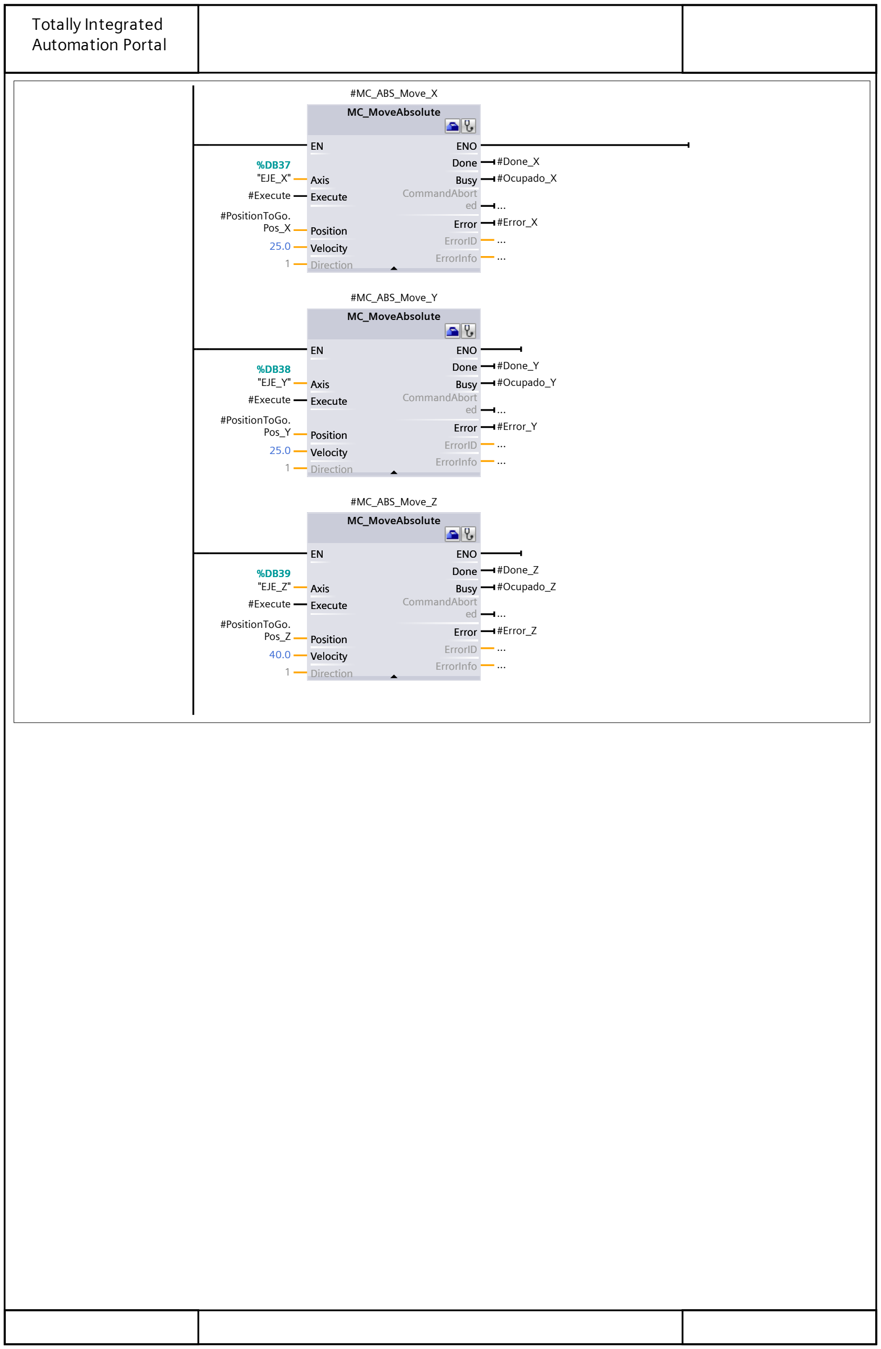
[picture p19: figure]
MC_MoveAbsolute; #MC_ABS_Move_X; "EJE_X"; #Execute; #PositionToGo. Pos_X 25.0 1; #Done_X #Ocupado_X; ... #Error_X ... ...; #MC_ABS_Move_Y; "EJE_Y"; #PositionToGo. Pos_Y 25.0 1; #Done_Y #Ocupado_Y; ... #Error_Y ... ...; #MC_ABS_Move_Z; "EJE_Z"; #PositionToGo. Pos_Z 40.0 1; #Done_Z #Ocupado_Z; ... #Error_Z ... ...; Axis Execute; Position Velocity Direction; ENO Done Busy CommandAbort ed Error ErrorID ErrorInfo

## A_MOTION_CONTROL

## Motion_Move_Axis_DB [DB40]

Motion_Move_Axis_DB Propiedades
General
Nombre | Motion_Move_Axis_DB | Número | 40 | Tipo | DB
Idioma | DB | Numeración | Automático
Información
Título | Autor | | Comentario
Familia | Versión | 0.1 | ID personali‐ zada
Nombre | Tipo de datos | Valor de arranque | Remanencia
Input
PositionToGo | "TypePosMotion" | | False
VelocityToGo | "TypeVelocity" | | False
Execute | Bool | false | False
Output
Done_X | Bool | false | False
Done_Y | Bool | false | False
Done_Z | Bool | false | False
Error_X | Bool | false | False
Error_Y | Bool | false | False
Error_Z | Bool | false | False
Ocupado_X | Bool | false | False
Ocupado_Y | Bool | false | False
Ocupado_Z | Bool | false | False
InOut
Static
MC_ABS_Move_X | MC_MoveAbsolute | | False
MC_ABS_Move_Y | MC_MoveAbsolute | | False
MC_ABS_Move_Z | MC_MoveAbsolute | | False

## A_MOTION_CONTROL

## Datos_reales_ejes [DB50]

Datos_reales_ejes Propiedades
General
Nombre | Datos_reales_ejes | Número | 50 | Tipo | DB
Idioma | DB | Numeración | Automático
Información
Título | Autor | | Comentario
Familia | Versión | 0.1 | ID personali‐ zada
Nombre | Tipo de datos | Valor de arranque | Remanencia
Static
Pos_Eje_X | Real | 0.0 | False
Pos_Eje_Y | Real | 0.0 | False
Pos_Eje_Z | Real | 0.0 | False
Vel_Eje_X | Real | 0.0 | False
Vel_Eje_Y | Real | 0.0 | False
Vel_Eje_Z | Real | 0.0 | False
Pos_Eje_X_hmi | Int | 0 | False
Pos_Eje_Y_hmi | Int | 0 | False
Pos_Eje_Z_hmi | Int | 0 | False
Enable_Eje_X | Bool | false | False
Enable_Eje_Y | Bool | false | False
Enable_Eje_Z | Bool | false | False
ERROR_Eje_X | Bool | false | False
ERROR_Eje_Y | Bool | false | False
ERROR_Eje_Z | Bool | false | False
HomeDone_X | Bool | false | False
HomeDone_Y | Bool | false | False
HomeDone_Z | Bool | false | False

## A_MOTION_CONTROL

## Creador_Margenes [FC9]

Creador_Margenes Propiedades
General
Nombre | Creador_Margenes | Número | 9 | Tipo | FC
Idioma | KOP | Numeración | Automático
Información
Título | Autor | | Comentario
Familia | Versión | 0.1 | ID personali‐ zada
Nombre | Tipo de datos | Valor predet.
Input
Posicion | "TypePosicion"
Margen_X | Real
Margen_Y | Real
Margen_Z | Real
Output
Margenes | "TypeMargen"
InOut
Temp
Constant
Return
Creador_Margenes | Void
Segmento 1:

ADD
Real

Real

>=

SUB
Real

Real

< | MOVE

#Posicion.Pos_X

#Margen_X

#Margenes.

Margen_X_Max

#Posicion.Pos_X

#Margen_X | #Posicion.Pos_X #Margen_X

#Margenes.

Margen_X_Min

#Posicion.Pos_X

#Margen_X | 0.0 | #Margenes. Margen_X_Min

EN
IN1
IN2

ENO

OUT

Real

EN
IN1
IN2

ENO

OUT

Real

EN
IN

ENO

OUT1

EN
IN1
IN2

ENO

OUT

Real

EN
IN1
IN2

ENO

OUT

Real

EN
IN

ENO

OUT1

Segmento 2:

ADD
Real

Real

>

SUB
Real

Real

< | MOVE

#Posicion.Pos_Y

#Margen_Y

#Margenes.

Margen_Y_Max

#Posicion.Pos_Y

#Margen_Y | #Posicion.Pos_Y #Margen_Y

#Margenes.

Margen_Y_Min

#Posicion.Pos_Y

#Margen_Y | 0.0 | #Margenes. Margen_Y_Min

EN
IN1
IN2

ENO

OUT

Real

EN
IN1
IN2

ENO

OUT

Real

EN
IN

ENO

OUT1

EN
IN1
IN2

ENO

OUT

Real

EN
IN1
IN2

ENO

OUT

Real

EN
IN

ENO

OUT1

Segmento 3:

ADD
Real

Real

>

SUB
Real

Real

< | MOVE

#Posicion.Pos_Z

#Margen_Z

#Margenes.

Margen_Z_Max

#Posicion.Pos_Z

#Margen_Z | #Posicion.Pos_Z #Margen_Z

#Margenes.

Margen_Z_Min

#Posicion.Pos_Z

#Margen_Z | 0.0 | #Margenes. Margen_Z_Min

EN
IN1
IN2

ENO

OUT

Real

EN
IN1
IN2

ENO

OUT

Real

EN
IN

ENO

OUT1

EN
IN1
IN2

ENO

OUT

Real

EN
IN1
IN2

ENO

OUT

Real

EN
IN

ENO

OUT1

## A_MOTION_CONTROL

## Go_TO_HOME [FB28]

Go_TO_HOME Propiedades
General
Nombre | Go_TO_HOME | Número | 28 | Tipo | FB
Idioma | KOP | Numeración | Automático
Información
Título | Autor | | Comentario
Familia | Versión | 0.1 | ID personali‐ zada
Nombre | Tipo de datos | Valor predet. | Remanencia
Input
Output
HOME_DONE | Bool | false | No remanente
InOut
Static
ESTADO | Int | 0 | No remanente
Go_Reference_On | Bool | false | No remanente
GoHomeXY | Bool | false | No remanente
ResetError | Bool | false | No remanente
Home Z | Bool | false | No remanente
MC_Home_X | MC_Home
MC_Home_Y | MC_Home
MC_Home_Z | MC_Home
MC_MoveVelocity_Z | MC_MoveVelocity
GoHomePinza | Bool | false | No remanente
TIME | TON_TIME | | No remanente
TIMER | TON_TIME | | No remanente
TIMERFORRESET | TON_TIME | | No remanente
Temp
Constant
Segmento 1:

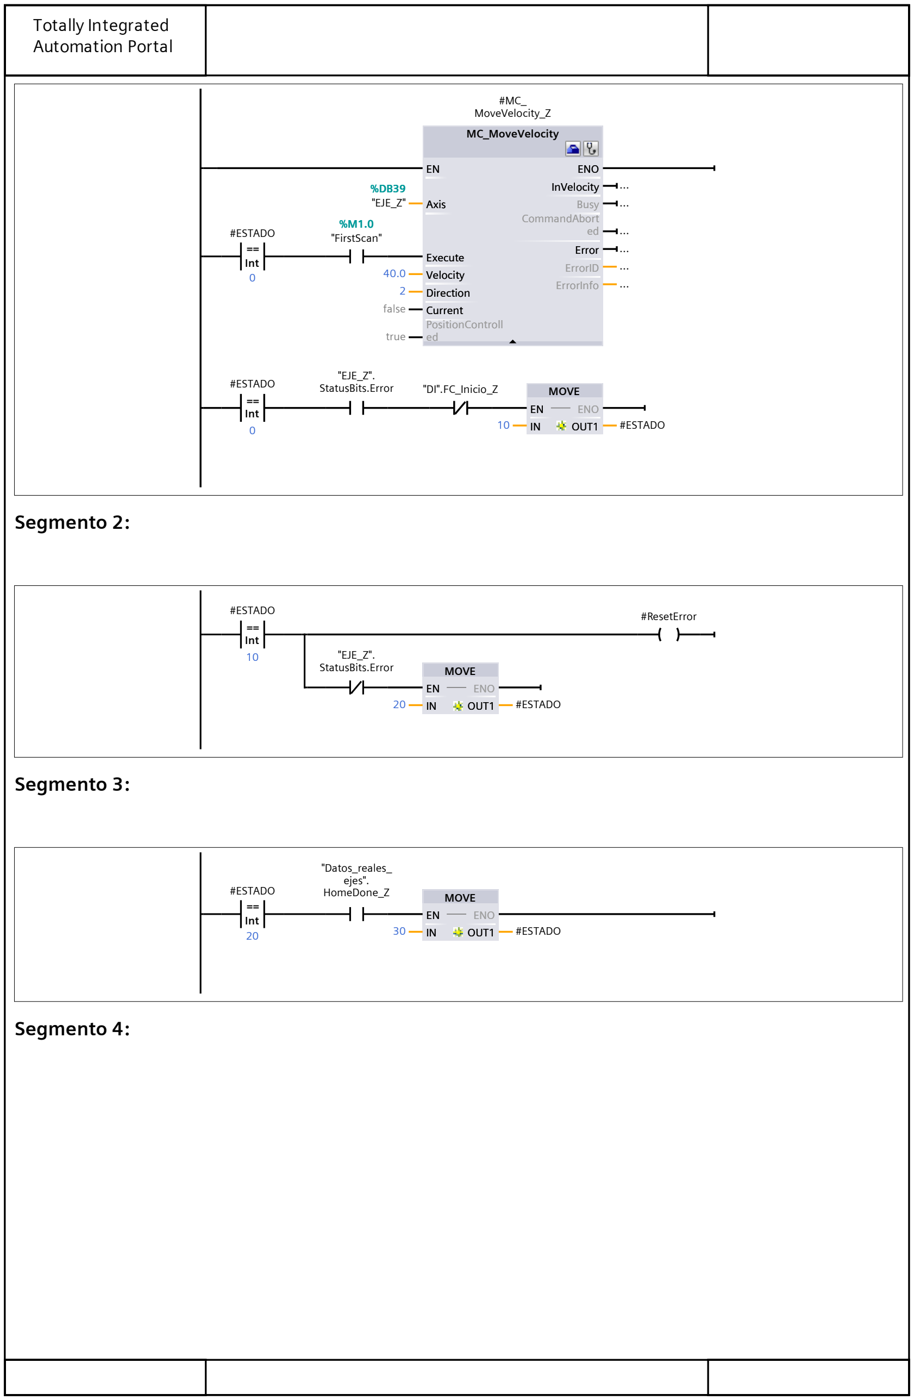
[picture p20: figure]
MC_MoveVelocity; Int; MOVE; #MC_ MoveVelocity_Z; "EJE_Z"; 40.0 2 false; true; #ESTADO; "FirstScan"; "EJE_Z".; StatusBits.Error; "DI".FC_Inicio_Z; Axis; Execute Velocity Direction Current PositionControll ed; ENO InVelocity Busy CommandAbort ed Error ErrorID ErrorInfo; ENO OUT1; Segmento 2:; #ResetError; "EJE_Z". StatusBits.Error; Segmento 3:; MOVE #ESTADO; "Datos_reales_ ejes". HomeDone_Z; Segmento 4:

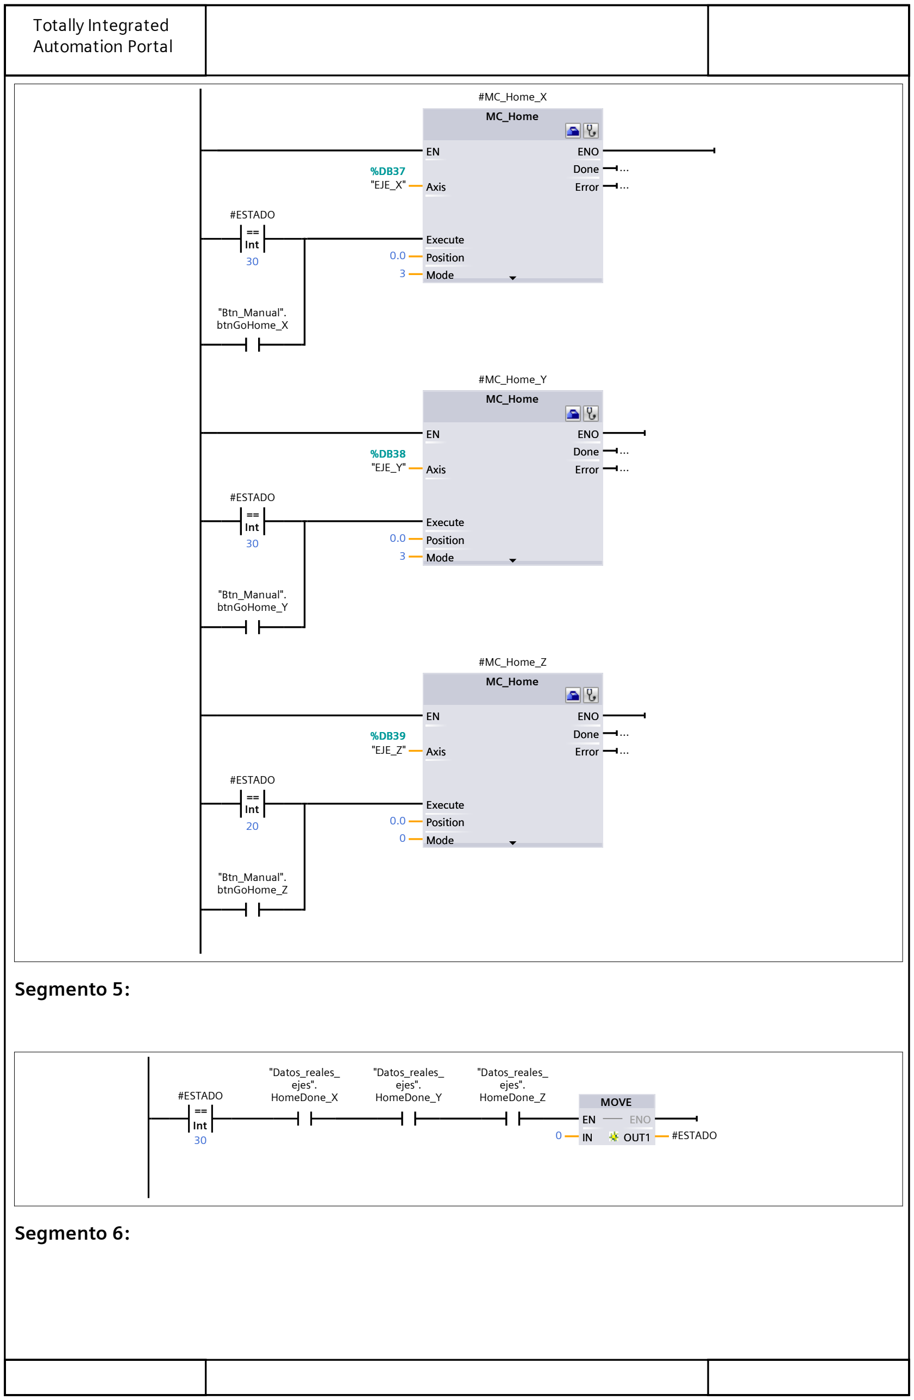
[picture p21: figure]
MC_Home; Int; #MC_Home_X; "EJE_X"; #ESTADO; "Btn_Manual". btnGoHome_X; #MC_Home_Y; "EJE_Y"; "Btn_Manual". btnGoHome_Y; #MC_Home_Z; "EJE_Z"; "Btn_Manual". btnGoHome_Z; Axis; Execute Position Mode; ENO Done Error; Segmento 5:; MOVE #ESTADO; "Datos_reales_ ejes". HomeDone_X; "Datos_reales_ ejes". HomeDone_Y; "Datos_reales_ ejes". HomeDone_Z; ENO OUT1; Segmento 6:

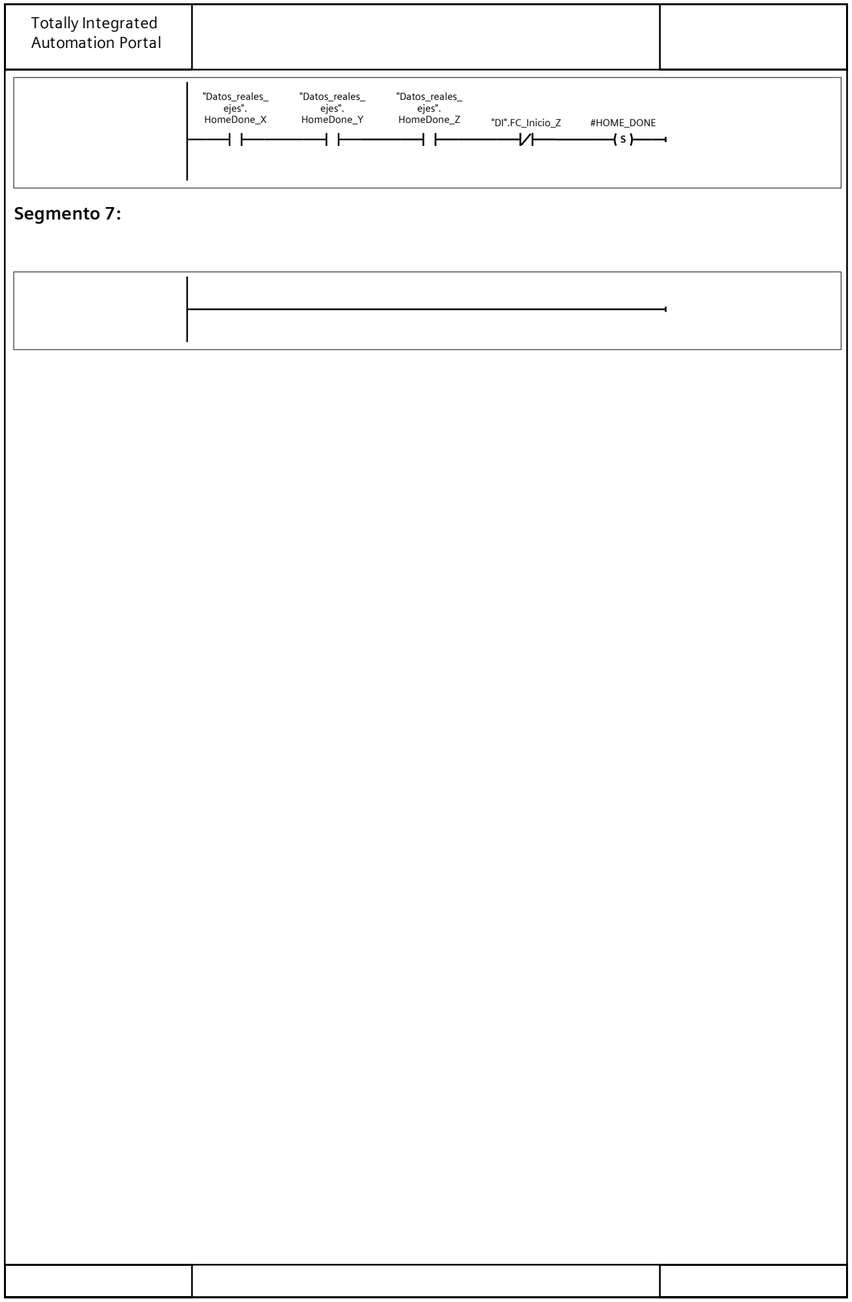
[picture p22: figure]
"Datos_reales_ ejes". HomeDone_X; "Datos_reales_ ejes". HomeDone_Y; "Datos_reales_ ejes".; HomeDone_Z; "DI".FC_Inicio_Z; #HOME_DONE; Segmento 7:

## A_MOTION_CONTROL

## Go_TO_HOME_DB [DB53]

Go_TO_HOME_DB Propiedades
General
Nombre | Go_TO_HOME_DB | Número | 53 | Tipo | DB
Idioma | DB | Numeración | Automático
Información
Título | Autor | | Comentario
Familia | Versión | 0.1 | ID personali‐ zada
Nombre | Tipo de datos | Valor de arranque | Remanencia
Input
Output
HOME_DONE | Bool | false | False
InOut
Static
ESTADO | Int | 0 | False
Go_Reference_On | Bool | false | False
GoHomeXY | Bool | false | False
ResetError | Bool | false | False
Home Z | Bool | false | False
MC_Home_X | MC_Home | | False
MC_Home_Y | MC_Home | | False
MC_Home_Z | MC_Home | | False
MC_MoveVelocity_Z | MC_MoveVelocity | | False
GoHomePinza | Bool | false | False
TIME | TON_TIME | | False
TIMER | TON_TIME | | False
TIMERFORRESET | TON_TIME | | False

## A_MOTION_CONTROL

## ROBOT AXIS_DB [DB49]

ROBOT AXIS_DB Propiedades
General
Nombre | ROBOT AXIS_DB | Número | 49 | Tipo | DB
Idioma | DB | Numeración | Automático
Información
Título | Autor | | Comentario
Familia | Versión | 0.1 | ID personali‐ zada
Nombre | Tipo de datos | Valor de arranque | Remanencia
Input
Output
InOut
Static
EJE_X_Enabled | Bool | false | False
EJE_Y_Enabled | Bool | false | False
EJE_Z_Enabled | Bool | false | False
General_Disabled | Bool | false | False
EJE_X_Done | Bool | false | False
EJE_Y_Done | Bool | false | False
EJE_Z_Done | Bool | false | False
EJE_X_ERROR | Bool | false | False
EJE_Y_ERROR | Bool | false | False
EJE_Z_ERROR | Bool | false | False
General_ERROR | Bool | false | False
EJE_X_Ocupado | Bool | false | False
EJE_Y_Ocupado | Bool | false | False
EJE_Z_Ocupado | Bool | false | False
InPosition_X | Bool | false | False
InPosition_Y | Bool | false | False
InPosition_Z | Bool | false | False
ExecuteMovment | Bool | false | False
EnPosicionEscogida | Bool | false | False
VelocidadEjes | Int | 25 | False
PosicionToGo | "TypePosMotion" | | False
PosEscogida_Final | "TypePosMotion" | | False
MODOS_MOTION_XYZ | "MODOS_MOTION" | | False
timer1 | TON_TIME | | False

## A_MOTION_CONTROL

## MODOS_MOTION [FB36]

MODOS_MOTION Propiedades
General
Nombre | MODOS_MOTION | Número | 36 | Tipo | FB
Idioma | KOP | Numeración | Automático
Información
Título | Autor | | Comentario
Familia | Versión | 0.1 | ID personali‐ zada
Nombre | Tipo de datos | Valor predet. | Remanencia
Input
PosToGo | "TypePosMotion" | | No remanente
OFFSET_UP | Real | 0.0 | No remanente
OFFSET_Forward | Real | 0.0 | No remanente
OFFSET_Backward | Real | 0.0 | No remanente
OFFSET_BackwardCargador | Real | 0.0 | No remanente
Output
ExecuteMove | Bool | false | No remanente
InOut
PositionToGO | "TypePosMotion"
Static
OFFSET_DOWN_result | Real | 0.0 | No remanente
OFFSET_UP_result | Real | 0.0 | No remanente
OFFSET_APROACH_result | Real | 0.0 | No remanente
Flanco 1 | Bool | false | No remanente
Flanco 2 | Bool | false | No remanente
Flanco 3 | Bool | false | No remanente
Flanco 4 | Bool | false | No remanente
Temp
Constant
Segmento 1:

MOVE

MOVE

MOVE

"MoveMode".
GoPosX_Y
#PosToGo.Pos_X | #PositionToGO. Pos_X

#PosToGo.Pos_Y | #PositionToGO. Pos_Y

#PosToGo.Pos_Z | #PositionToGO. Pos_Z

EN
IN

ENO

OUT1

EN
IN

ENO

OUT1

EN
IN

ENO

OUT1

EN
IN

ENO

OUT1

EN
IN

ENO

OUT1

EN
IN

ENO

OUT1

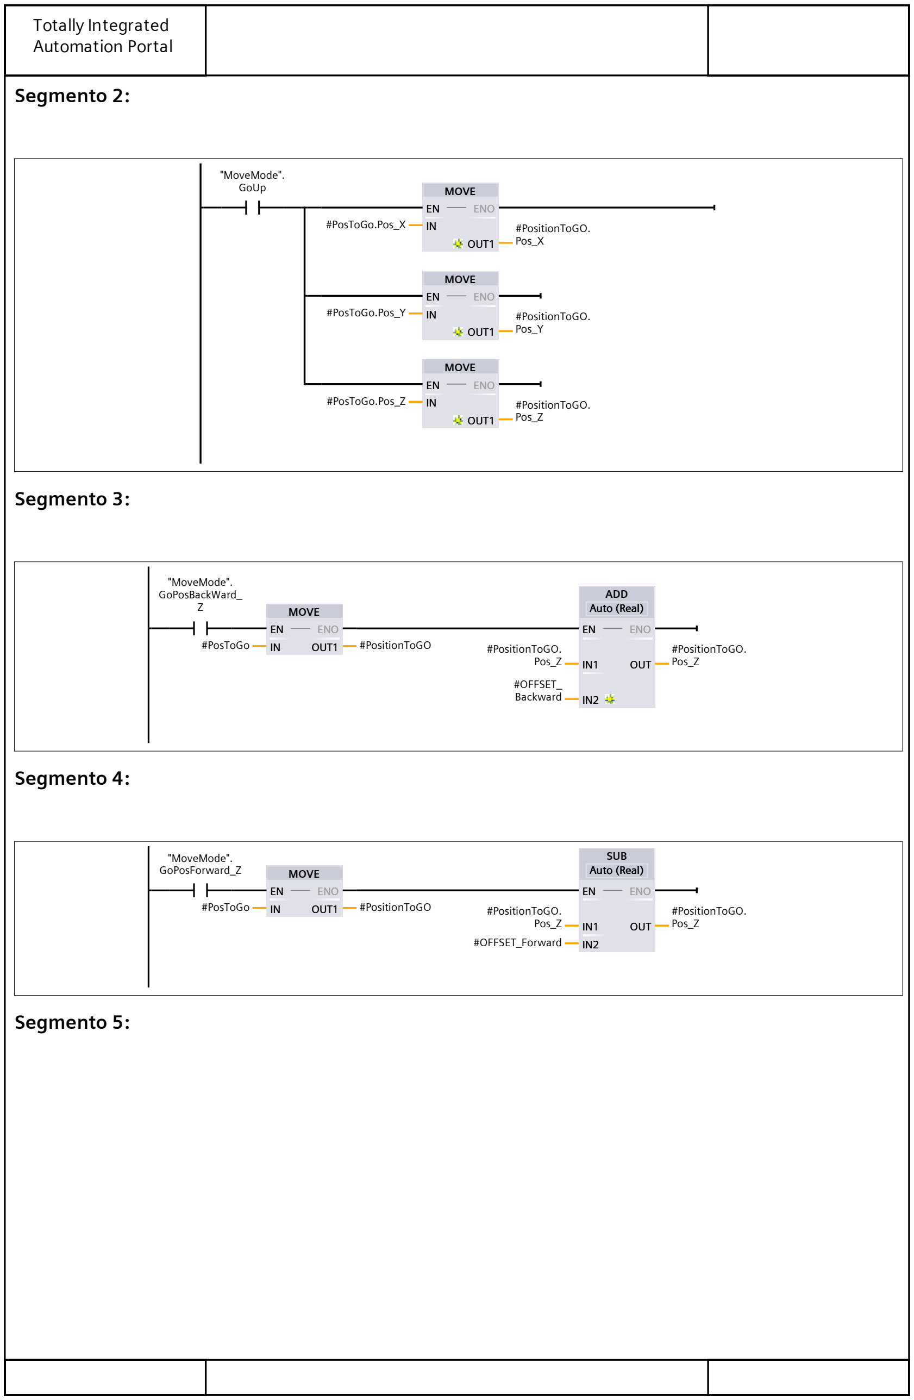
[picture p23: figure]
Segmento 2:; MOVE; "MoveMode". GoUp; #PosToGo.Pos_X; #PositionToGO.; Pos_X; #PosToGo.Pos_Y; Pos_Y; #PosToGo.Pos_Z; Pos_Z; ENO; OUT1; Segmento 3:; ADD Auto (Real); "MoveMode". GoPosBackWard_ Z; #PosToGo; #PositionToGO; #OFFSET_ Backward; #PositionToGO. Pos_Z; ENO OUT1; OUT; Auto (Real); Segmento 4:; SUB Auto (Real); "MoveMode". GoPosForward_Z; Pos_Z #OFFSET_Forward; Segmento 5:

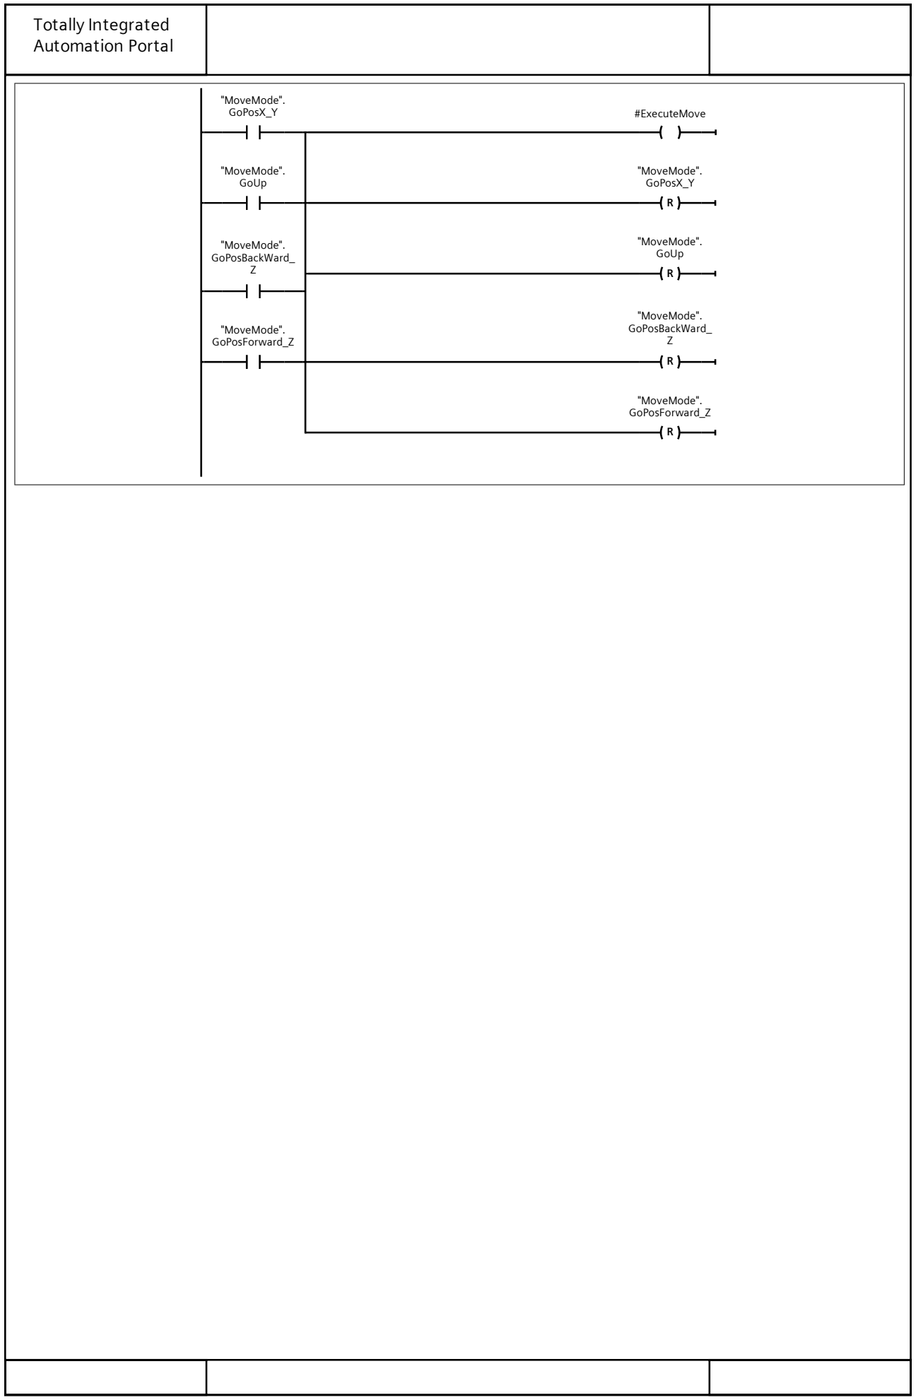
[picture p24: figure]
"MoveMode".; GoPosX_Y; #ExecuteMove; "MoveMode". GoUp; "MoveMode". GoPosBackWard_ Z; "MoveMode". GoPosForward_Z; "MoveMode". GoPosX_Y

## MAQUINA DE VENDING_10_PRUEBAAUTO / PLC_1 [CPU 1214C DC/DC/ DC] / Bloques de programa / AA_Secuencias

## Secuencia_EntregaProducto [FB34]

Secuencia_EntregaProducto Propiedades
General
Nombre | Secuencia_EntregaPro‐ ducto | Número | 34 | Tipo | FB
Idioma | KOP | Numeración | Automático
Información
Título | Autor | | Comentario
Familia | Versión | 0.1 | ID personali‐ zada

Secuencia_EntregaProducto
Nombre | Tipo de datos | Valor predet. | Remanencia
Input
IniciarCiclo | Bool | false | No remanente
POS1_Estanteria_XY | "TypePosMotion" | | No remanente
POS2_Forward_Z | "TypePosMotion" | | No remanente
POS3_GoUp_Y | "TypePosMotion" | | No remanente
Pos_Entrega | "TypePosMotion" | | No remanente
Pos_Entrega_Forward | "TypePosMotion" | | No remanente
TamañoDeCaja | Bool | false | No remanente
WasFound | Bool | false | No remanente
Output
InOut
Static
Secuencia_On | Bool | false | No remanente
CheckOtherProduct | Bool | false | No remanente
END_Entrega | Bool | false | No remanente
ESTADO | Int | 0 | No remanente
Next_Estado | Int | 0 | No remanente
PosHOME | "TypePosMotion" | | No remanente
Flancos | Array[0..15] of Bool | | No remanente
TIMERS | Array[0..15] of TON_TIME | | No remanente

Temp
Constant
TIME_WAIT | Time | T#1000ms
Segmento 1:

Int

== | MOVE #ESTADO

"E000:WAIT_
INITIALCODITIONS"

0

"Go_TO_HOME_
DB".HOME_
DONE

"E010:WAIT_
PETICION"

10 #Next_Estado

EN

IN

ENO
OUT1

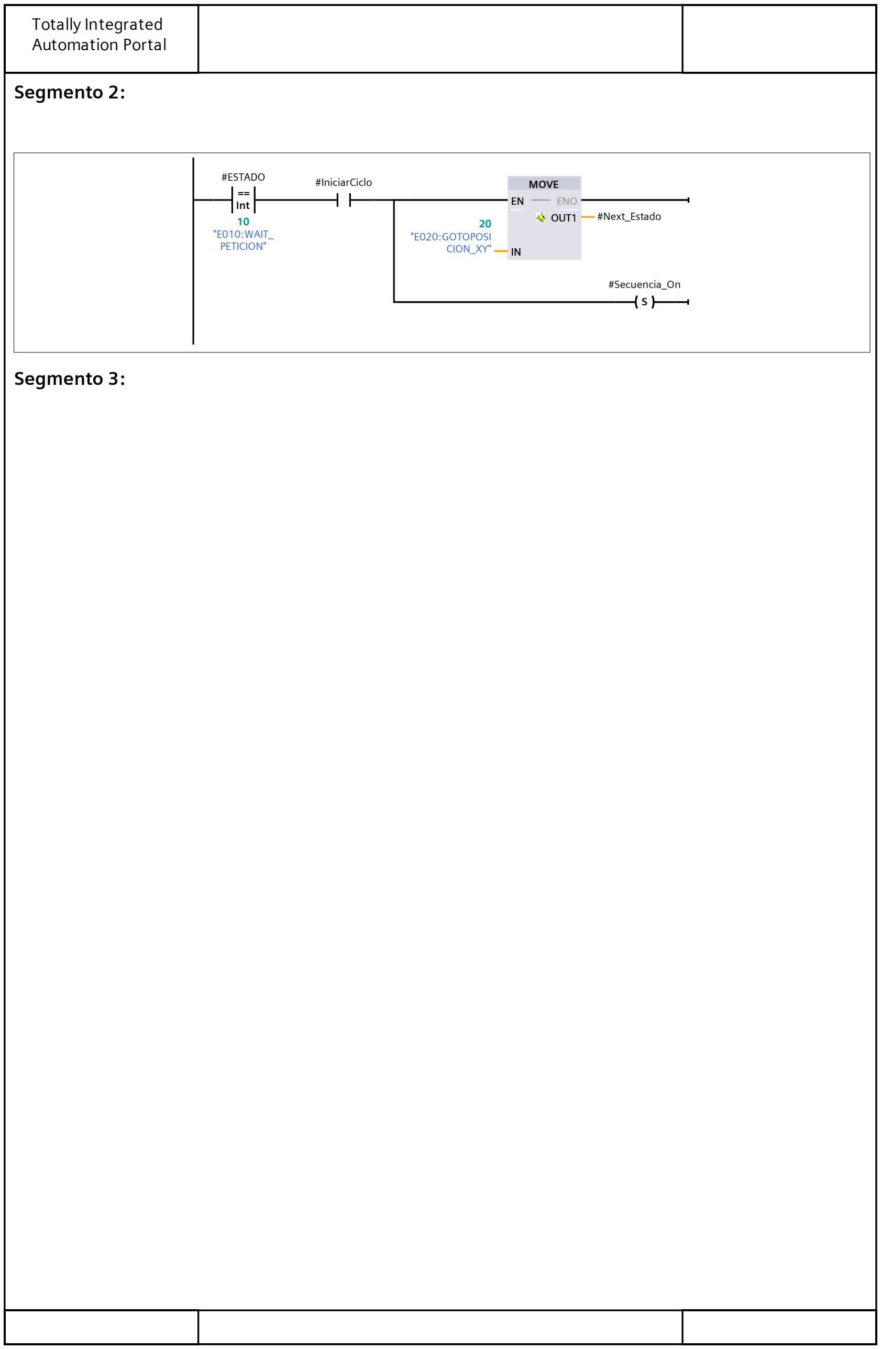
[picture p25: figure]
Segmento 2:; Int; MOVE; #ESTADO; "E010:WAIT_ PETICION"; #IniciarCiclo; "E020:GOTOPOSI CION_XY"; 20 #Next_Estado; #Secuencia_On; ENO OUT1; Segmento 3:

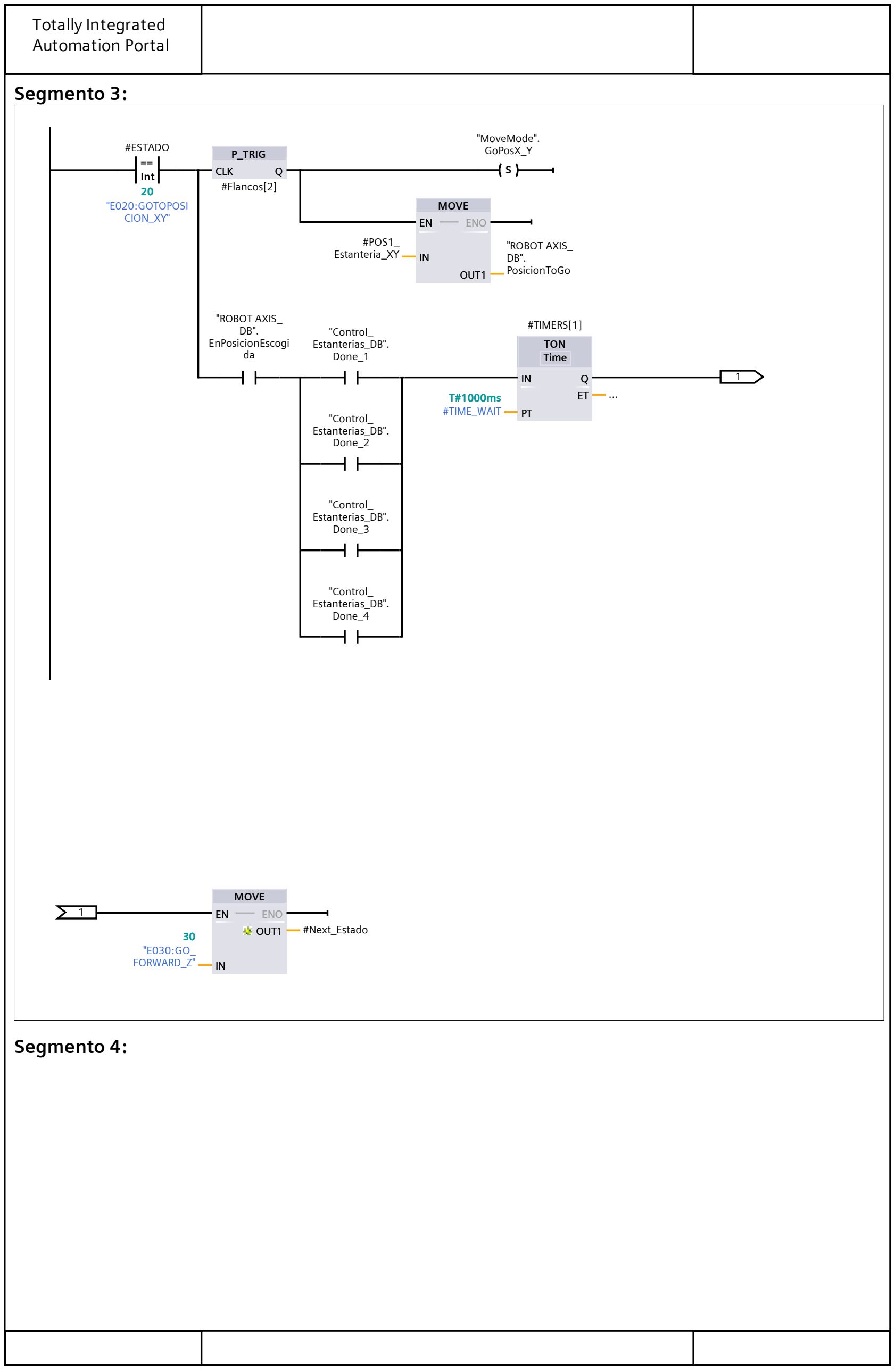
[picture p26: figure]
Segmento 3:; Int; P_TRIG; TON Time; MOVE; #ESTADO; "E020:GOTOPOSI CION_XY"; 20 #Flancos[2]; "MoveMode". GoPosX_Y; "ROBOT AXIS_ DB". EnPosicionEscogi da; "Control_ Estanterias_DB". Done_1; #TIMERS[1]; #TIME_WAIT; "E030:GO_ FORWARD_Z"; 30 #Next_Estado; "Control_ Estanterias_DB". Done_2; "Control_ Estanterias_DB". Done_3; "Control_ Estanterias_DB". Done_4; #POS1_; Estanteria_XY; "ROBOT AXIS_; DB". PosicionToGo; CLK; Time; ENO OUT1; ENO; OUT1; Segmento 4:

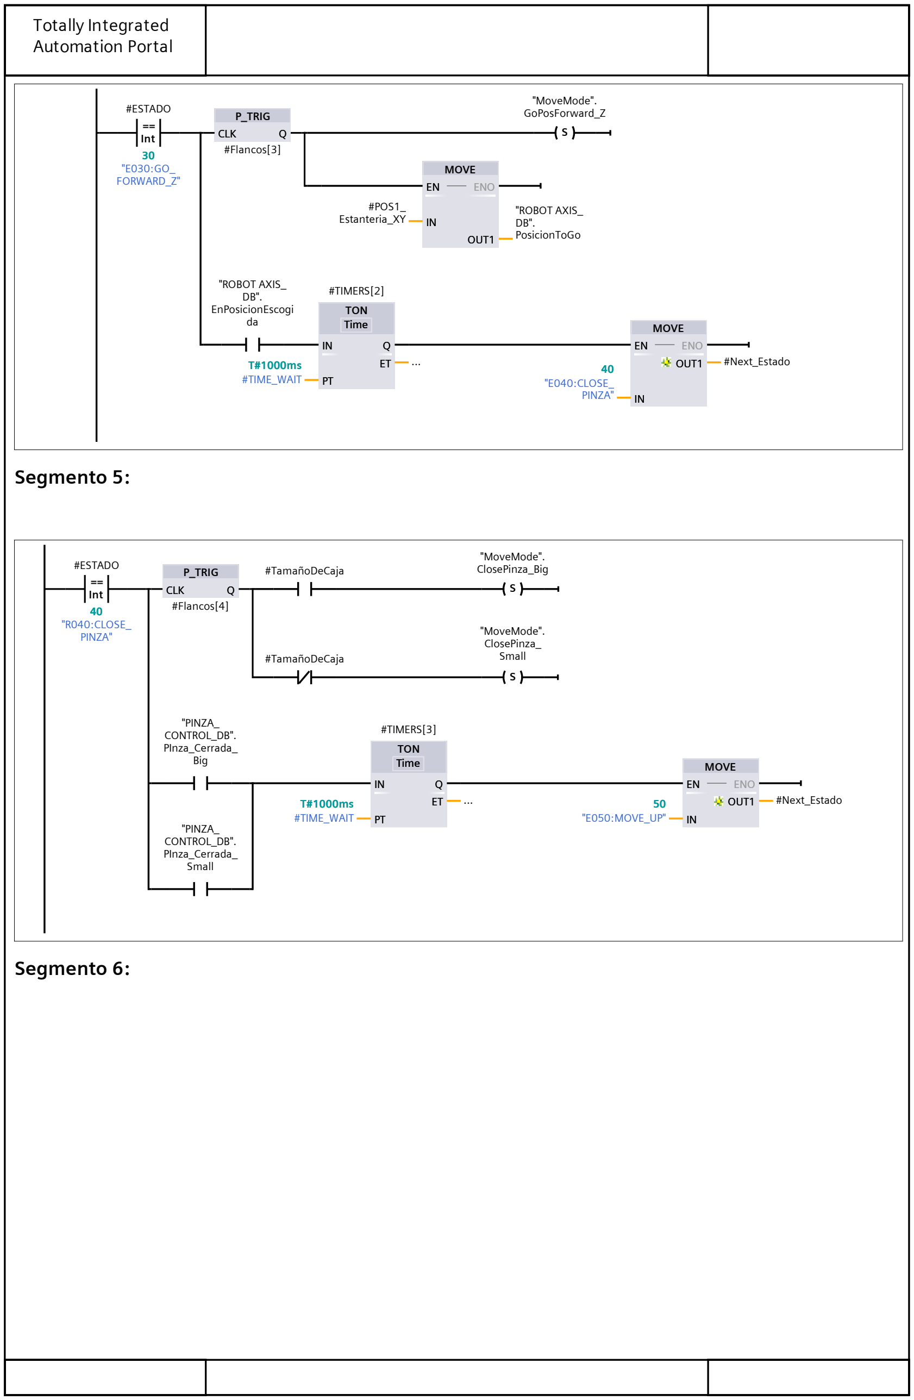
[picture p27: figure]
Int; P_TRIG; TON; Time; MOVE; #ESTADO; "E030:GO_ FORWARD_Z"; 30 #Flancos[3]; "MoveMode". GoPosForward_Z; "ROBOT AXIS_ DB". EnPosicionEscogi da; #TIMERS[2]; #TIME_WAIT; "E040:CLOSE_ PINZA"; 40 #Next_Estado; #POS1_; Estanteria_XY; "ROBOT AXIS_; DB". PosicionToGo; CLK; ENO OUT1; ENO; OUT1; Segmento 5:; "R040:CLOSE_ PINZA"; 40 #Flancos[4]; #TamañoDeCaja; "MoveMode". ClosePinza_Big; "PINZA_ CONTROL_DB". PInza_Cerrada_ Big; #TIMERS[3]; "E050:MOVE_UP"; 50 #Next_Estado; "PINZA_ CONTROL_DB". PInza_Cerrada_ Small; "MoveMode". ClosePinza_ Small; Segmento 6:

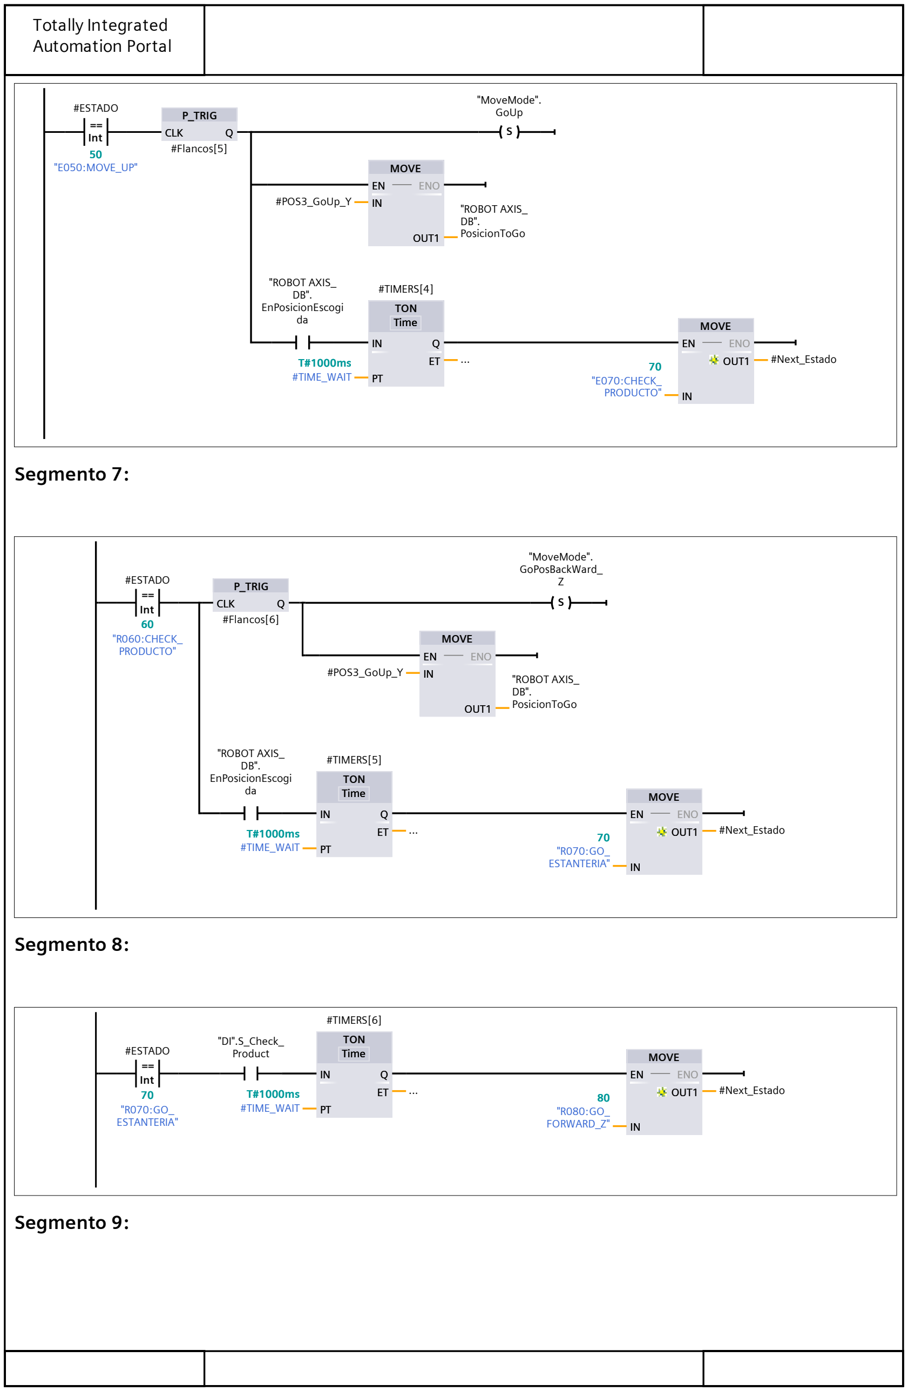
[picture p28: figure]
Int; P_TRIG; MOVE; TON; Time; #ESTADO; "E050:MOVE_UP"; 50 #Flancos[5]; "MoveMode". GoUp; #POS3_GoUp_Y; "ROBOT AXIS_; DB". PosicionToGo; "ROBOT AXIS_ DB". EnPosicionEscogi da; #TIMERS[4]; #TIME_WAIT; "E070:CHECK_ PRODUCTO"; 70 #Next_Estado; CLK; ENO; OUT1; ENO OUT1; Segmento 7:; "R060:CHECK_ PRODUCTO"; 60 #Flancos[6]; "MoveMode". GoPosBackWard_ Z; #TIMERS[5]; "R070:GO_ ESTANTERIA"; Segmento 8:; MOVE #ESTADO; "DI".S_Check_ Product; #TIMERS[6]; "R080:GO_ FORWARD_Z"; 80 #Next_Estado; Segmento 9:

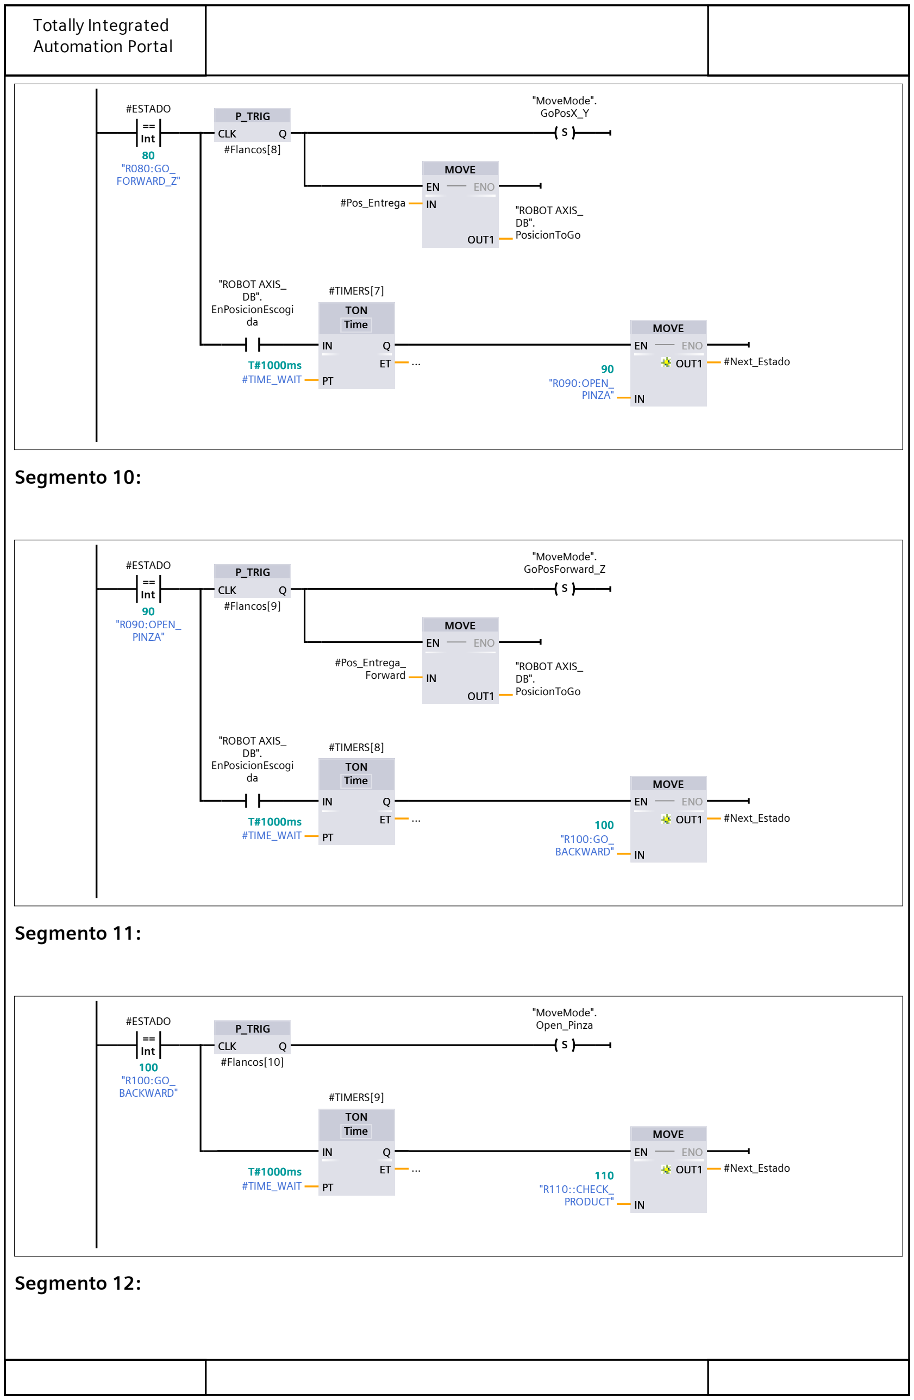
[picture p29: figure]
Int; P_TRIG; TON; Time; MOVE; #ESTADO; "R080:GO_ FORWARD_Z"; 80 #Flancos[8]; "MoveMode". GoPosX_Y; "ROBOT AXIS_ DB". EnPosicionEscogi da; #TIMERS[7]; #TIME_WAIT; "R090:OPEN_ PINZA"; 90 #Next_Estado; #Pos_Entrega; "ROBOT AXIS_; DB". PosicionToGo; CLK; ENO OUT1; ENO; OUT1; Segmento 10:; 90 #Flancos[9]; "MoveMode". GoPosForward_Z; #TIMERS[8]; "R100:GO_ BACKWARD"; 100 #Next_Estado; #Pos_Entrega_; Forward; Segmento 11:; 100 #Flancos[10]; "MoveMode". Open_Pinza; #TIMERS[9]; "R110::CHECK_ PRODUCT"; 110 #Next_Estado; Segmento 12:

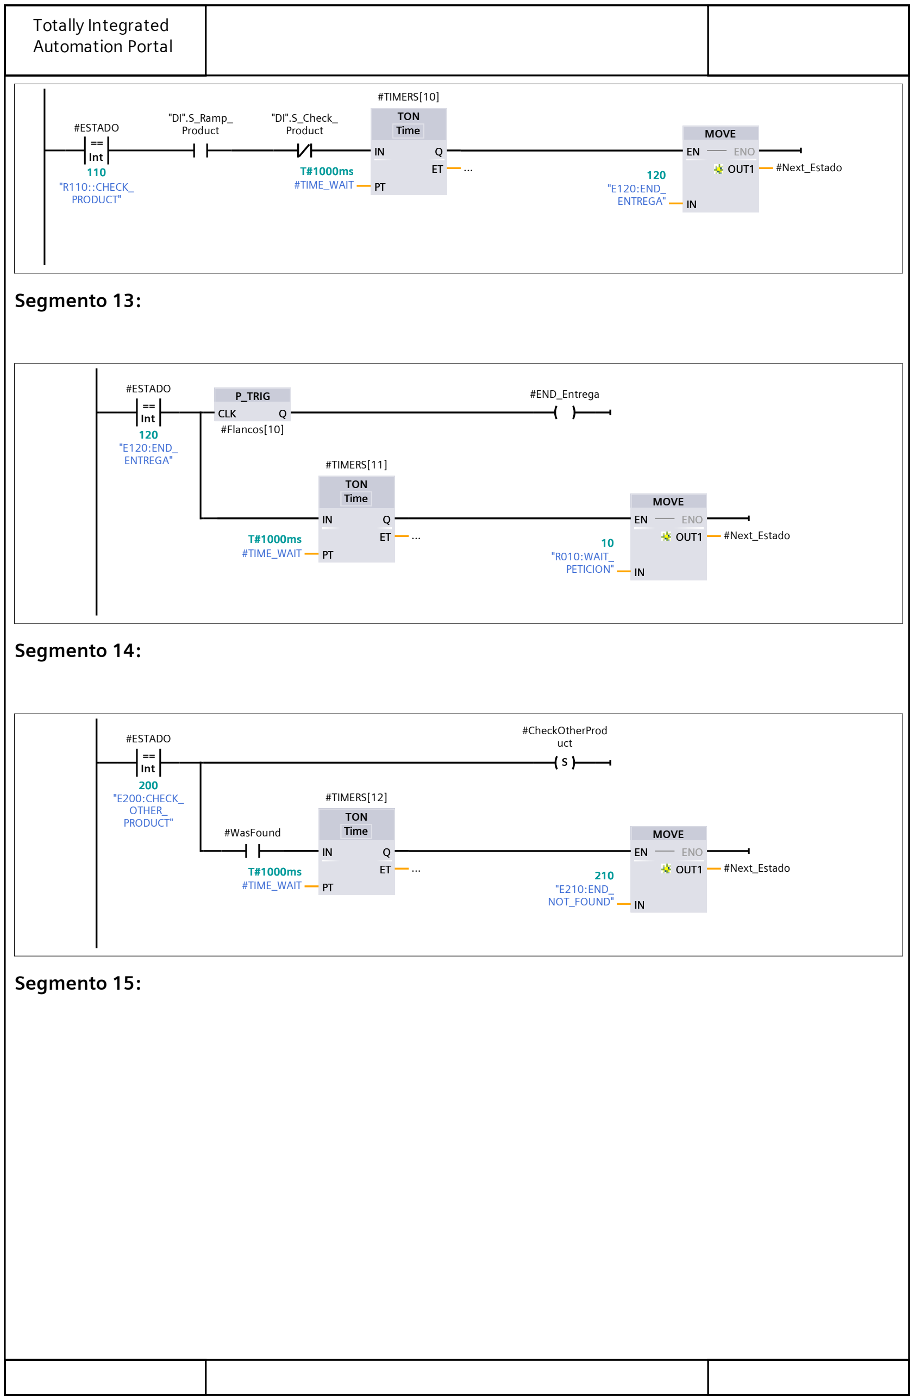
[picture p30: figure]
Int; TON; Time; MOVE #ESTADO; "R110::CHECK_ PRODUCT"; "DI".S_Ramp_ Product; "DI".S_Check_ Product; #TIMERS[10]; #TIME_WAIT; "E120:END_ ENTREGA"; 120 #Next_Estado; ENO OUT1; Segmento 13:; P_TRIG; MOVE; #ESTADO; 120 #Flancos[10]; #END_Entrega; #TIMERS[11]; "R010:WAIT_ PETICION"; 10 #Next_Estado; CLK; Segmento 14:; "E200:CHECK_ OTHER_ PRODUCT"; #CheckOtherProd uct; #WasFound; #TIMERS[12]; "E210:END_ NOT_FOUND"; 210 #Next_Estado; Segmento 15:

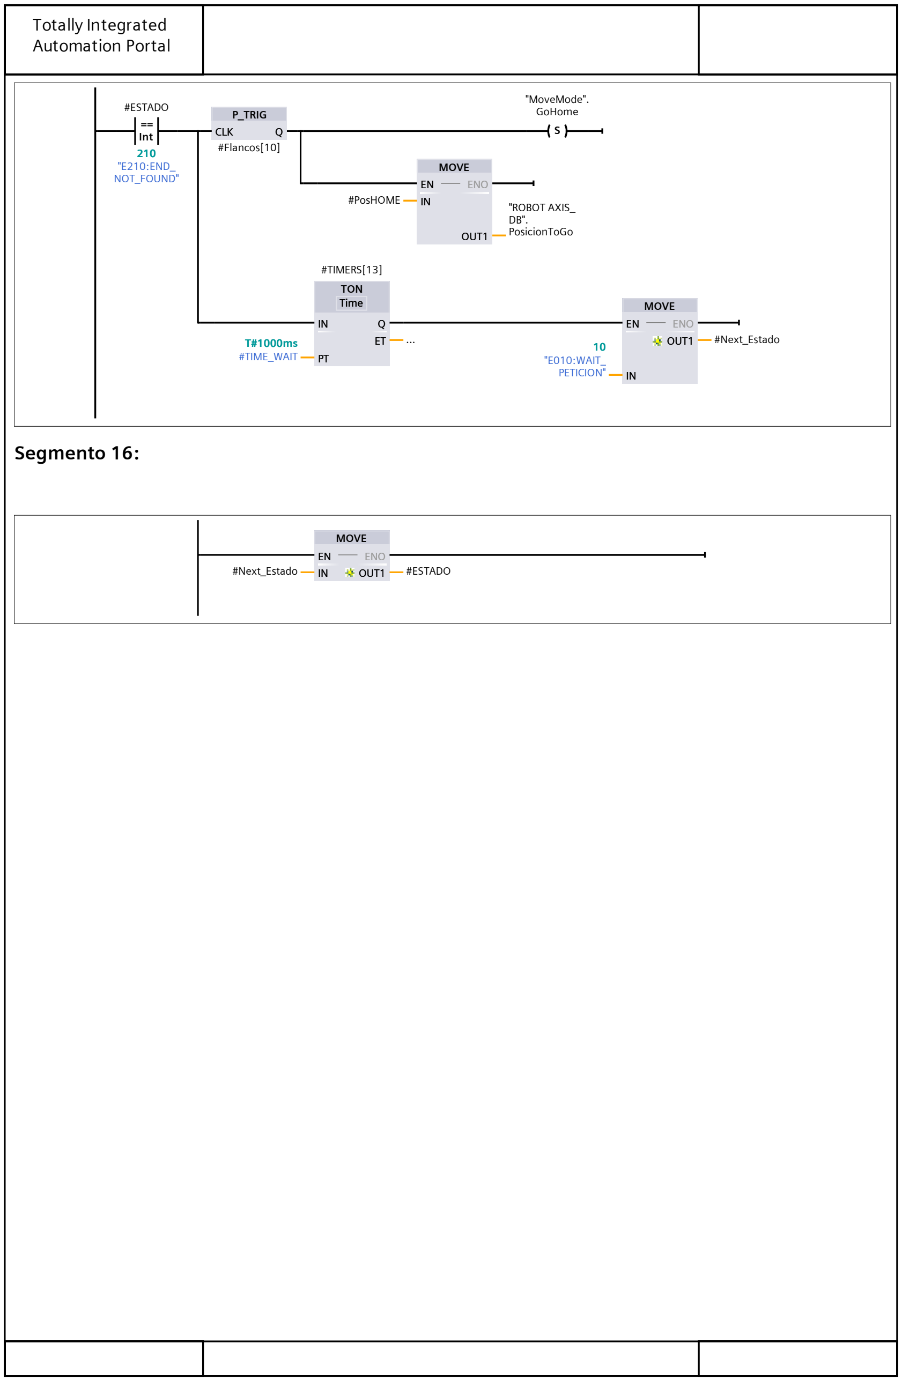
[picture p31: figure]
Int; P_TRIG; TON; Time; MOVE; #ESTADO; "E210:END_ NOT_FOUND"; 210 #Flancos[10]; "MoveMode". GoHome; #TIMERS[13]; #TIME_WAIT; "E010:WAIT_ PETICION"; 10 #Next_Estado; #PosHOME; "ROBOT AXIS_; DB". PosicionToGo; CLK; ENO OUT1; ENO; OUT1; Segmento 16:; #Next_Estado

## BDO_ALMACEN [DB3]

BDO_ALMACEN Propiedades
General
Nombre | BDO_ALMACEN | Número | 3 | Tipo | DB
Idioma | DB | Numeración | Automático
Información
Título | Autor | | Comentario
Familia | Versión | 0.1 | ID personali‐ zada
Nombre | Tipo de datos | Valor de arranque | Remanencia
Static
Espacio | Array[0..3, 0..2] of "TypeProducto" | | False

## BDO_STOCK [DB2]

BDO_STOCK Propiedades
General
Nombre | BDO_STOCK | Número | 2 | Tipo | DB
Idioma | DB | Numeración | Automático
Información
Título | Autor | | Comentario
Familia | Versión | 0.1 | ID personali‐ zada
Nombre | Tipo de datos | Valor de arranque | Remanencia
Static
Espacio | Array[0..31] of "Type‐ Producto" | | True

## MAQUINA DE VENDING_10_PRUEBAAUTO / PLC_1 [CPU 1214C DC/DC/ DC] / Bloques de programa / COMUNICACION MODBUS

## Comunicacion Modbus [FC1]

Comunicacion Modbus Propiedades
General
Nombre | Comunicacion Modbus | Número | 1 | Tipo | FC
Idioma | KOP | Numeración | Automático
Información
Título | Autor | | Comentario
Familia | Versión | 0.1 | ID personali‐ zada

Comunicacion Modbus
Nombre | Tipo de datos | Valor predet.
Input
Output
InOut
Temp
Constant
Return
Comunicacion Modbus | Void
Segmento 1:
"Clock_0.5Hz" | MB_SERVER
%M0.7 | "MB_SERVER_DB" %DB16

false

"Datos_de_
Maquina"

%DB15

"SERVER_IPV".
CONNECT
"SERVER_
ESTADO".STATUS

EN
DISCONNECT

MB_HOLD_REG

CONNECT

ENO
NDR
DR
ERROR

STATUS

EN
DISCONNECT

MB_HOLD_REG

CONNECT

ENO
NDR
DR
ERROR

STATUS

## MAQUINA DE VENDING_10_PRUEBAAUTO / PLC_1 [CPU 1214C DC/DC/ DC] / Bloques de programa / Estanterias

## BuscarPosicion_Vacia [FB33]

BuscarPosicion_Vacia Propiedades
General
Nombre | BuscarPosicion_Vacia | Número | 33 | Tipo | FB
Idioma | SCL | Numeración | Automático
Información
Título | Autor | | Comentario
Familia | Versión | 0.1 | ID personali‐ zada

BuscarPosicion_Vacia
Nombre | Tipo de datos | Valor predet. | Remanencia
Input
Output
InOut
Static
BuscarPosicion | Bool | false | No remanente
GoToPosEstanteria | Bool | false | No remanente
Encontrado | Bool | false | No remanente
Puntero | Int | 0 | No remanente
PosToGoEstanteria | "TypePosicionPro‐ ducto" | | No remanente
R_TRIG_Instance | R_TRIG
Temp
Constant

0001
0002
0003 IF #BuscarPosicion THEN
0004 | #PosToGoEstanteria.PosicionConcret := 0;
0005 | FOR #Puntero := 0 TO 7 DO
0006 | IF "PREVIZUALIZACION".Vizulizacion_Productos[#Puntero].Producto.Disponible
| = FALSE THEN
0007 | #PosToGoEstanteria.PosicionConcret := #Puntero;
0008 | #Encontrado := TRUE;
0009 | EXIT;
0010 | END_IF;
0011 | ;
0012 | END_FOR;
0013 | IF #Encontrado THEN
0014 | #BuscarPosicion := FALSE;
0015 | "Bits_Motion".PosTogoEstanteria.PosicionConcret := #PosToGoEstanteria.Pos-
| icionConcret;
0016 | "Bits_Motion".PosTogoEstanteria.Estanteria := #PosToGoEstanteria.Estante-
| ria;
0017 | #GoToPosEstanteria := TRUE;
0018 | #Encontrado := FALSE;
0019 | END_IF;
0020 | ;
0021 END_IF;
0022
0023 #R_TRIG_Instance(CLK := #GoToPosEstanteria,
0024 | Q => "Bits_Motion".GoToposEstanteria);

0025
0026 IF "Bits_Motion".GoToposEstanteria THEN 0027 #GoToPosEstanteria := FALSE;
0028 END_IF;

## MAQUINA DE VENDING_10_PRUEBAAUTO / PLC_1 [CPU 1214C DC/DC/ DC] / Bloques de programa / Estanterias

## Control_Estanterias [FB20]

Control_Estanterias Propiedades
General
Nombre | Control_Estanterias | Número | 20 | Tipo | FB
Idioma | KOP | Numeración | Automático
Información
Título | Autor | | Comentario
Familia | Versión | 0.1 | ID personali‐ zada

Control_Estanterias
Nombre | Tipo de datos | Valor predet. | Remanencia
Input
PosicionToGO | "TypePosicionPro‐ ducto" | | No remanente
Execute | Bool | false | No remanente
GoToHome | Bool | false | No remanente
Output
InOut
Static
Done_1 | Bool | false | No remanente
Done_2 | Bool | false | No remanente
Done_3 | Bool | false | No remanente
Done_4 | Bool | false | No remanente
Temp
Constant
Estanteria 1 | Int | 0
Estanteria 2 | Int | 1
Estanteria 3 | Int | 2
Estanteria 4 | Int | 3
Segmento 1:

Segmento 2:

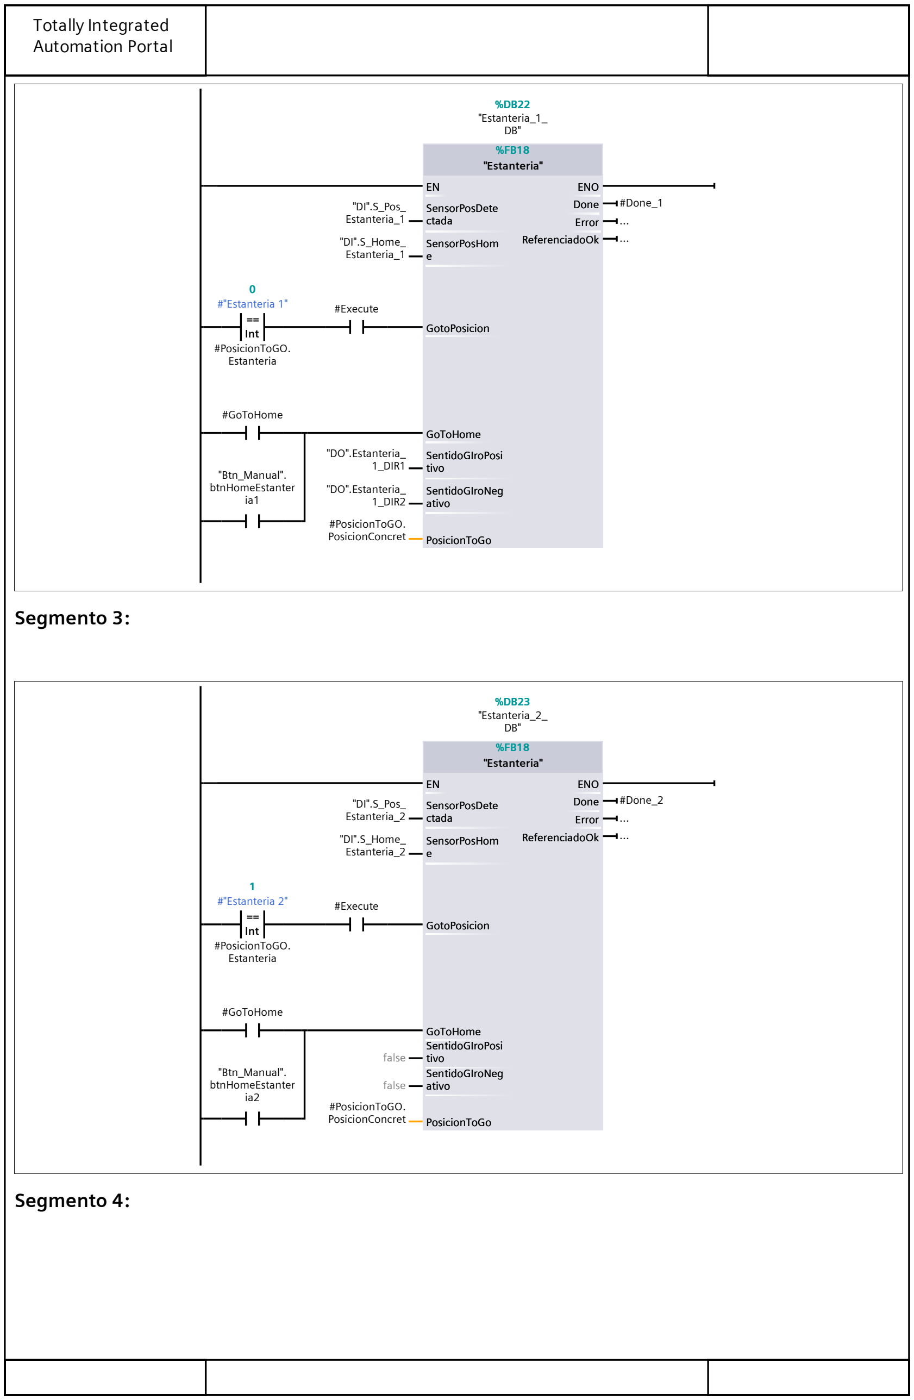
[picture p32: figure]
"Estanteria"; Int; "Estanteria_1_ DB"; "DI".S_Pos_ Estanteria_1; "DI".S_Home_ Estanteria_1; "DO".Estanteria_ 1_DIR1; "DO".Estanteria_ 1_DIR2; #PosicionToGO. PosicionConcret; #Done_1 ... ...; #"Estanteria 1"; #PosicionToGO. Estanteria; #Execute; #GoToHome; "Btn_Manual". btnHomeEstanter ia1; SensorPosDete ctada; SensorPosHom e; GotoPosicion; GoToHome; SentidoGIroPosi tivo; SentidoGIroNeg ativo; PosicionToGo; ENO Done Error ReferenciadoOk; Segmento 3:; "Estanteria_2_ DB"; "DI".S_Pos_ Estanteria_2; "DI".S_Home_ Estanteria_2; false; #Done_2 ... ...; #"Estanteria 2"; "Btn_Manual". btnHomeEstanter ia2; GoToHome SentidoGIroPosi tivo SentidoGIroNeg ativo; Segmento 4:

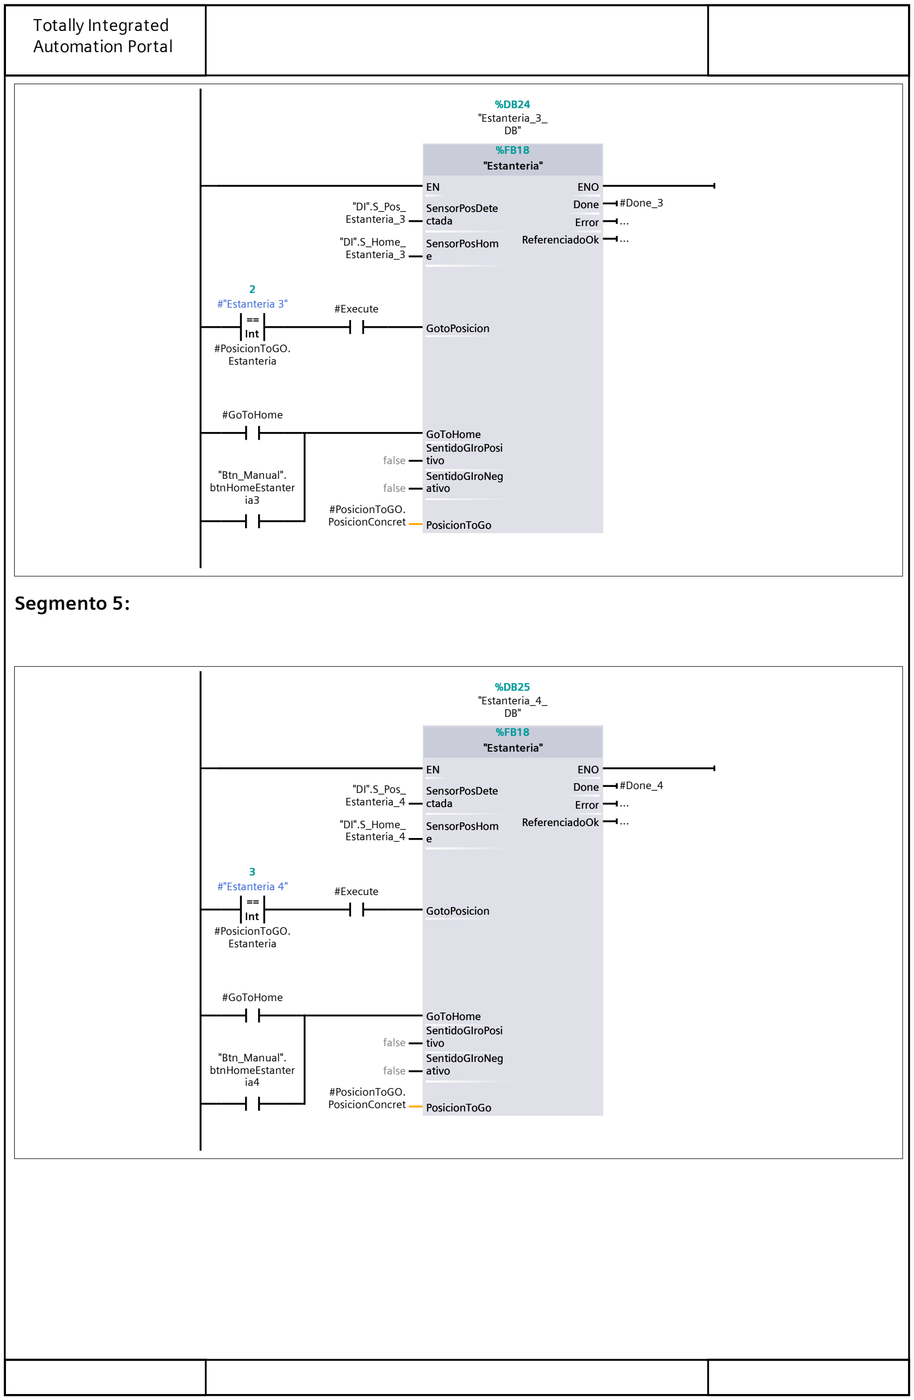
[picture p33: figure]
"Estanteria"; Int; "Estanteria_3_ DB"; "DI".S_Pos_ Estanteria_3; "DI".S_Home_ Estanteria_3; false; #PosicionToGO. PosicionConcret; #Done_3 ... ...; #"Estanteria 3"; #PosicionToGO. Estanteria; #Execute; #GoToHome; "Btn_Manual". btnHomeEstanter ia3; SensorPosDete ctada; SensorPosHom e; GotoPosicion; GoToHome SentidoGIroPosi tivo SentidoGIroNeg ativo; PosicionToGo; ENO Done Error ReferenciadoOk; Segmento 5:; "Estanteria_4_ DB"; "DI".S_Pos_ Estanteria_4; "DI".S_Home_ Estanteria_4; #Done_4 ... ...; #"Estanteria 4"; "Btn_Manual". btnHomeEstanter ia4

## MAQUINA DE VENDING_10_PRUEBAAUTO / PLC_1 [CPU 1214C DC/DC/ DC] / Bloques de programa / Estanterias

## Estanteria [FB18]

Estanteria Propiedades
General
Nombre | Estanteria | Número | 18 | Tipo | FB
Idioma | KOP | Numeración | Automático
Información
Título | Autor | | Comentario
Familia | Versión | 0.1 | ID personali‐ zada

Estanteria
Nombre | Tipo de datos | Valor predet. | Remanencia
Input
SensorPosDetectada | Bool | false | No remanente
SensorPosHome | Bool | false | No remanente
GotoPosicion | Bool | false | No remanente
GoToHome | Bool | false | No remanente
SentidoGIroPositivo | Bool | false | No remanente
SentidoGIroNegativo | Bool | false | No remanente
PosicionToGo | Int | 0 | No remanente
Output
Done | Bool | false | No remanente
Error | Bool | false | No remanente
ReferenciadoOk | Bool | false | No remanente
InOut
Static
GoHomeOn | Bool | false | No remanente
GiroPositivo | Bool | false | No remanente
GiroNegativo | Bool | false | No remanente
Reset | Bool | false | No remanente
EnProceso | Bool | false | No remanente
EnPosicionPedida | Bool | false | No remanente
StopMove | Bool | false | No remanente
PULSE1 | Bool | false | No remanente
PULSE2 | Bool | false | No remanente
PosicionActual | Int | 0 | No remanente
PulsosTotales | Int | 0 | No remanente
HOME_Estanteria | "HOME_Estanteria"
PULSE3 | Bool | false | No remanente
PULSE4 | Bool | false | No remanente
Temp
Constant
Segmento 1:

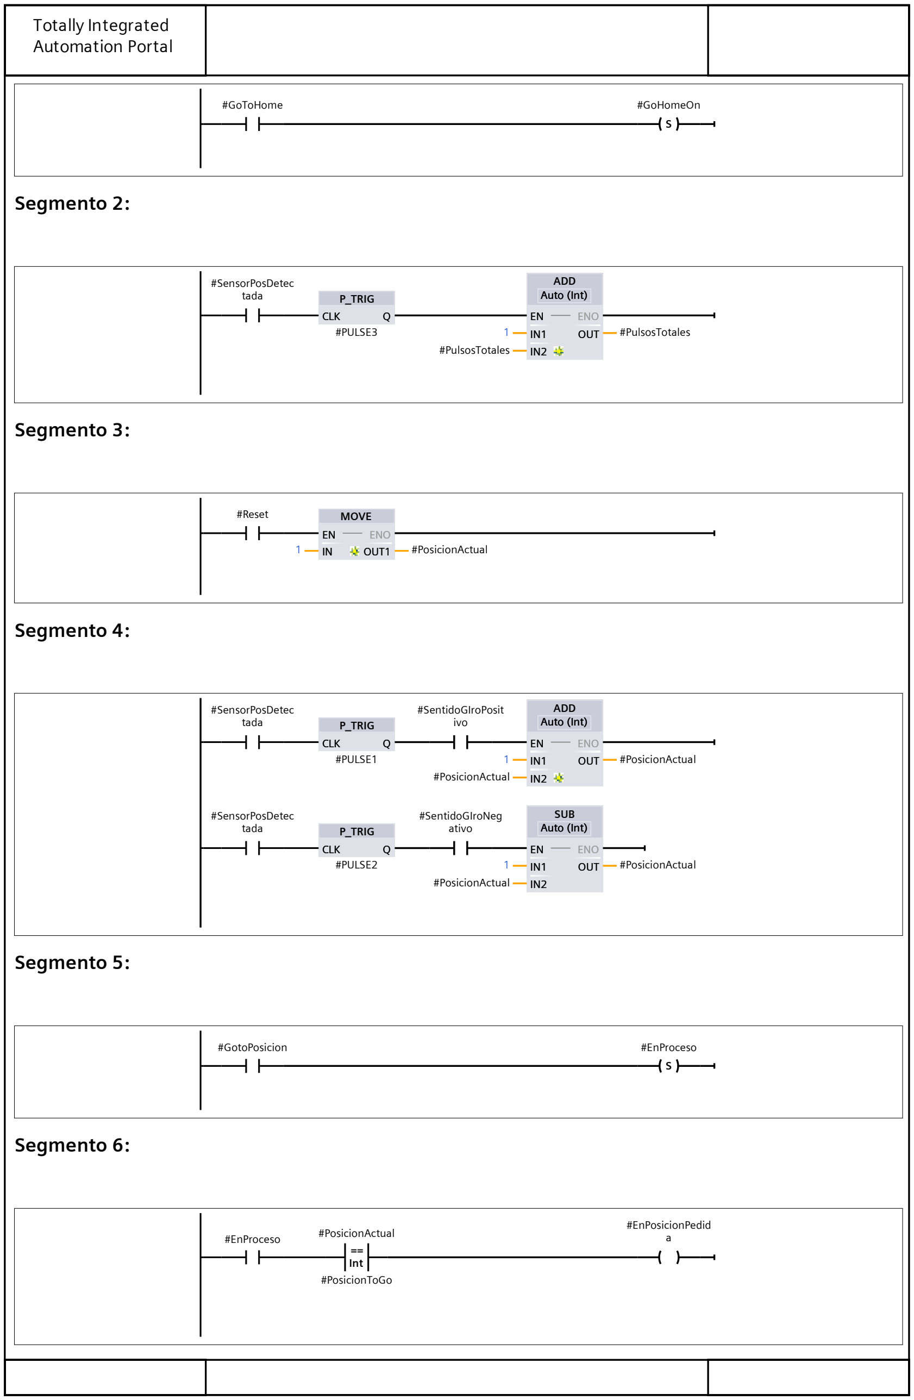
[picture p34: figure]
#GoToHome; #GoHomeOn; Segmento 2:; P_TRIG; ADD Auto (Int); #SensorPosDetec tada; #PULSE3; #PulsosTotales; CLK; ENO OUT; Auto (Int); Segmento 3:; #Reset; MOVE; #PosicionActual; ENO OUT1; Segmento 4:; SUB Auto (Int); #PULSE1; #SentidoGIroPosit ivo; 1 #PosicionActual; #PULSE2; #SentidoGIroNeg ativo; Segmento 5:; #GotoPosicion; #EnProceso; Segmento 6:; Int; #PosicionToGo; #EnPosicionPedid a

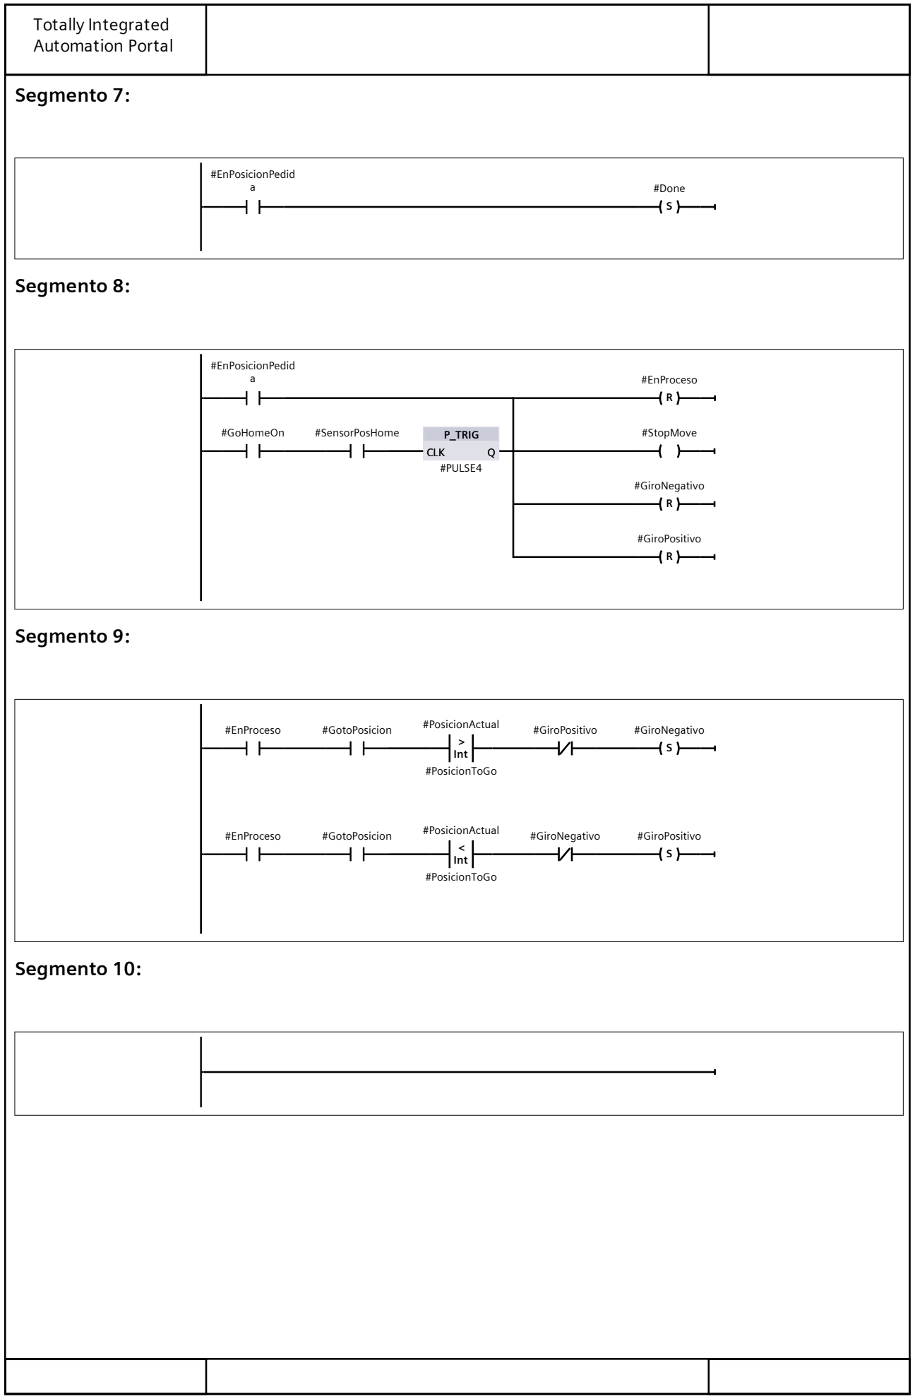
[picture p35: figure]
Segmento 7:; #EnPosicionPedid; #Done; Segmento 8:; P_TRIG; #EnProceso; #GoHomeOn; #SensorPosHome; #PULSE4; #StopMove; #GiroNegativo; #GiroPositivo; CLK; Segmento 9:; Int; #GotoPosicion; #PosicionActual; #PosicionToGo; Segmento 10:

## MAQUINA DE VENDING_10_PRUEBAAUTO / PLC_1 [CPU 1214C DC/DC/ DC] / Bloques de programa / INPUTS

## Global_Inputs [FB1]

Global_Inputs Propiedades
General
Nombre | Global_Inputs | Número | 1 | Tipo | FB
Idioma | KOP | Numeración | Automático
Información
Título | Autor | | Comentario
Familia | Versión | 0.1 | ID personali‐ zada

Global_Inputs
Nombre | Tipo de datos | Valor predet. | Remanencia
Input
Output
InOut
Static
Temp
Constant
Segmento 2:

0001 // INPUTS
0002
0003 //ENCODER
0004 "DI".Encoder_A := "PLC_INPUTS_I0.0"; 0005 "DI".Encoder_A := "PLC_INPUTS_I0.1"; 0006
0007 //FINALES DE CARRERA EJES
0008 "DI".FC_Inicio_X := "PLC_INPUTS_I0.2"; 0009 "DI".FC_Final_X := "PLC_INPUTS_I0.3"; 0010 "DI".FC_Inicio_Y := "PLC_INPUTS_I0.4"; 0011 "DI".FC_Final_Y := "PLC_INPUTS_I0.5"; 0012 "DI".FC_Inicio_Z := "PLC_INPUTS_I0.6"; 0013 "DI".FC_Final_Z := "PLC_INPUTS_I0.7"; 0014
0015 //SENSORES HOME EJES
0016 "DI".S_Home_X := "PLC_INPUTS_I1.0"; 0017 "DI".S_Home_Y := "PLC_INPUTS_I1.1"; 0018
0019 //FINALES DE CARRERA PINZA
0020 "DI".FC_Pinza_Close := "PLC_INPUTS_I1.2"; 0021 "DI".FC_Pinza_Open := "PLC_INPUTS_I1.3"; 0022
0023 //FINALES PUERTAS
0024 "DI".FC_Puerta_Pincipal := "PLC_INPUTS_I1.4"; 0025 "DI".FC_Puerta_Producto := "PLC_INPUTS_I1.5"; 0026
0027 //SENSORES DE ESTANTERIAS
0028 "DI".S_Home_Estanteria_1 := "ET_INPUTS_I2.0"; 0029 "DI".S_Pos_Estanteria_1 := "ET_INPUTS_I2.1"; 0030 "DI".S_Home_Estanteria_2 := "ET_INPUTS_I2.2"; 0031 "DI".S_Pos_Estanteria_2 := "ET_INPUTS_I2.3";

0032 "DI".S_Home_Estanteria_3 := "ET_INPUTS_I2.4"; 0033 "DI".S_Pos_Estanteria_3 := "ET_INPUTS_I2.5"; 0034 "DI".S_Home_Estanteria_4 := "ET_INPUTS_I2.6"; 0035 "DI".S_Pos_Estanteria_4 := "ET_INPUTS_I2.7"; 0036
0037 //SENSORES DE PRODUCTO
0038 "DI".S_Ramp_Product := "ET_INPUTS_I3.0"; 0039 "DI".S_Check_Product := "ET_INPUTS_I3.1"; 0040
0041
0042
0043
0044
0045
0046
0047
0048
0049
0050
0051
0052

## MAQUINA DE VENDING_10_PRUEBAAUTO / PLC_1 [CPU 1214C DC/DC/ DC] / Bloques de programa / OUTPUTS

## Control_Outputs [FB22]

Control_Outputs Propiedades
General
Nombre | Control_Outputs | Número | 22 | Tipo | FB
Idioma | KOP | Numeración | Automático
Información
Título | Autor | | Comentario
Familia | Versión | 0.1 | ID personali‐ zada

Control_Outputs
Nombre | Tipo de datos | Valor predet. | Remanencia
Input
Modo_Manual | Bool | false | No remanente
Modo_Auto | Bool | false | No remanente
Output
InOut
Static
pulsos | Array[0..10] of Bool | | No remanente

Temp
Constant
Segmento 1: ESTANTERIA 1

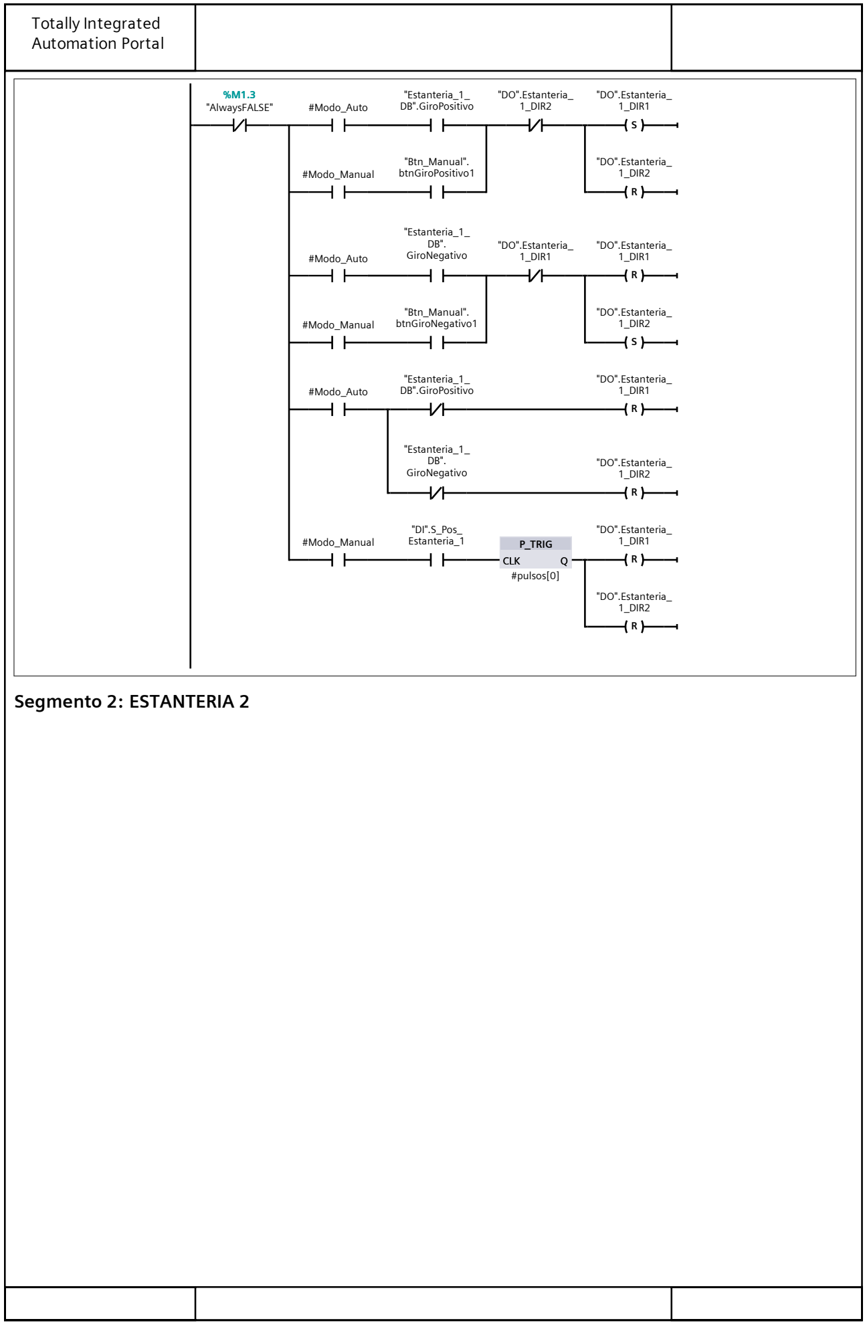
[picture p36: figure]
P_TRIG; "AlwaysFALSE"; #Modo_Auto; "Estanteria_1_ DB".GiroPositivo; "DO".Estanteria_ 1_DIR2; "DO".Estanteria_ 1_DIR1; #Modo_Manual; "Btn_Manual". btnGiroPositivo1; "Estanteria_1_ DB". GiroNegativo; "DO".Estanteria_; 1_DIR2; "Btn_Manual". btnGiroNegativo1; "DI".S_Pos_ Estanteria_1; #pulsos[0]; CLK; Segmento 2: ESTANTERIA 2

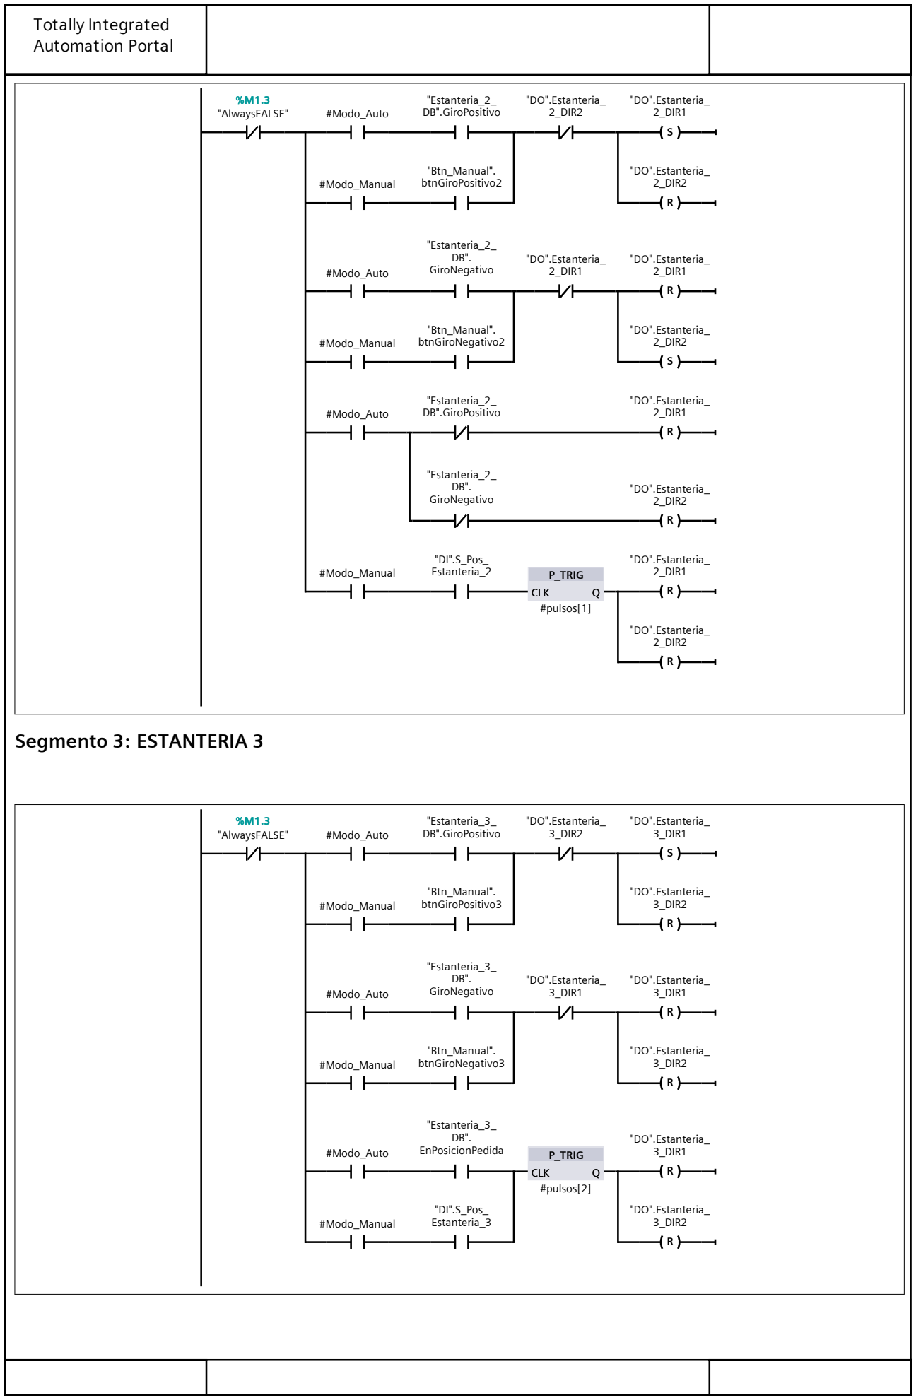
[picture p37: figure]
P_TRIG; "AlwaysFALSE"; #Modo_Auto; "Estanteria_2_ DB".GiroPositivo; "DO".Estanteria_ 2_DIR2; "DO".Estanteria_ 2_DIR1; #Modo_Manual; "Btn_Manual". btnGiroPositivo2; "Estanteria_2_ DB". GiroNegativo; "DO".Estanteria_; 2_DIR2; "Btn_Manual". btnGiroNegativo2; "DI".S_Pos_ Estanteria_2; #pulsos[1]; CLK; Segmento 3: ESTANTERIA 3; "Estanteria_3_ DB".GiroPositivo; "DO".Estanteria_ 3_DIR2; "DO".Estanteria_ 3_DIR1; "Btn_Manual". btnGiroPositivo3; "Estanteria_3_ DB". GiroNegativo; 3_DIR2; "Btn_Manual". btnGiroNegativo3; "Estanteria_3_ DB". EnPosicionPedida; #pulsos[2]; "DI".S_Pos_ Estanteria_3

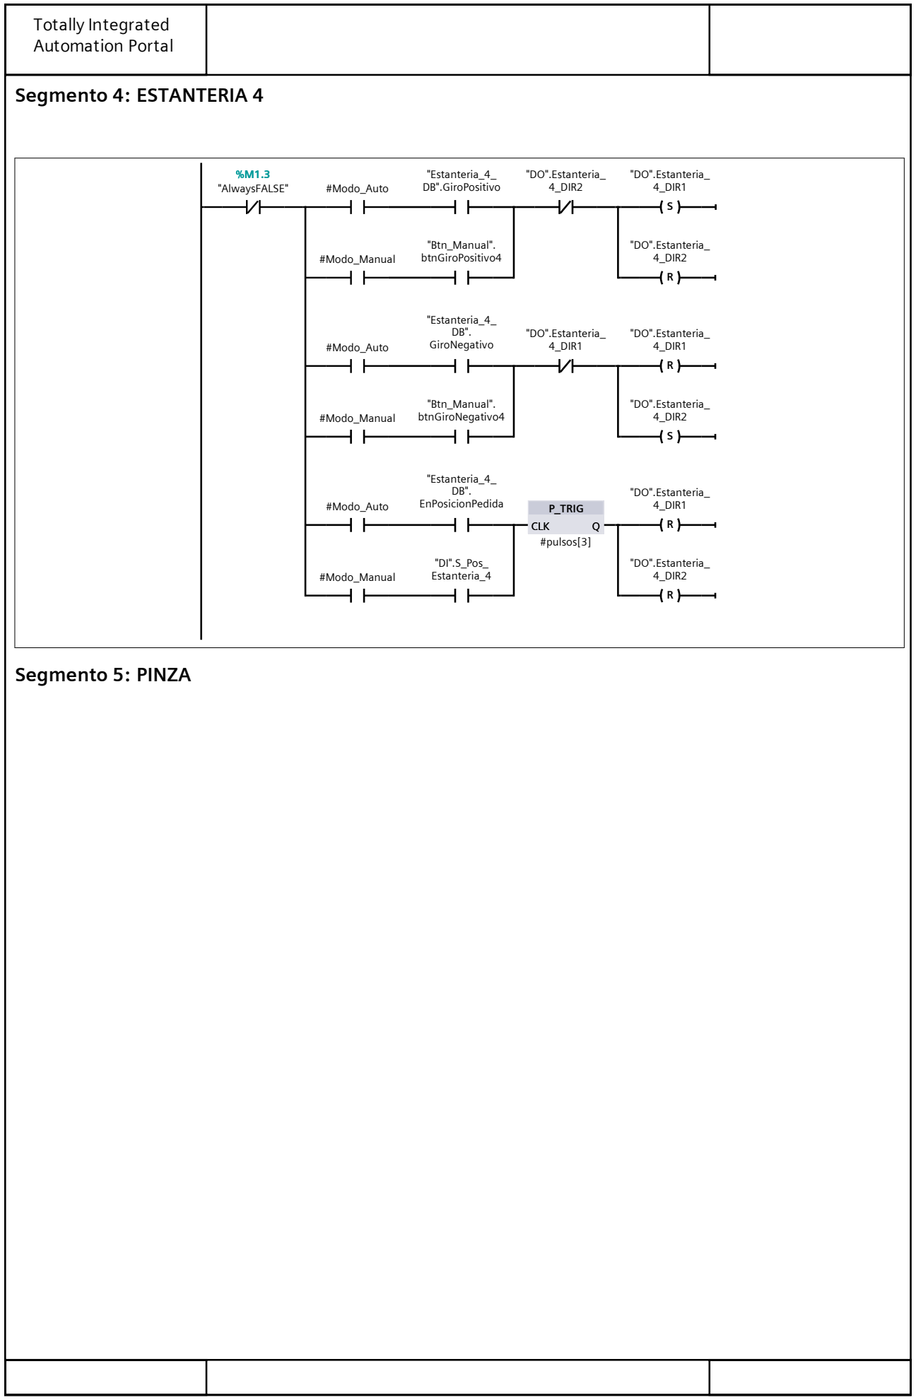
[picture p38: figure]
Segmento 4: ESTANTERIA 4; P_TRIG; "AlwaysFALSE"; #Modo_Auto; "Estanteria_4_ DB".GiroPositivo; "DO".Estanteria_ 4_DIR2; "DO".Estanteria_ 4_DIR1; #Modo_Manual; "Btn_Manual". btnGiroPositivo4; "Estanteria_4_ DB". GiroNegativo; "DO".Estanteria_; 4_DIR2; "Btn_Manual". btnGiroNegativo4; "Estanteria_4_ DB". EnPosicionPedida; #pulsos[3]; "DI".S_Pos_ Estanteria_4; CLK; Segmento 5: PINZA

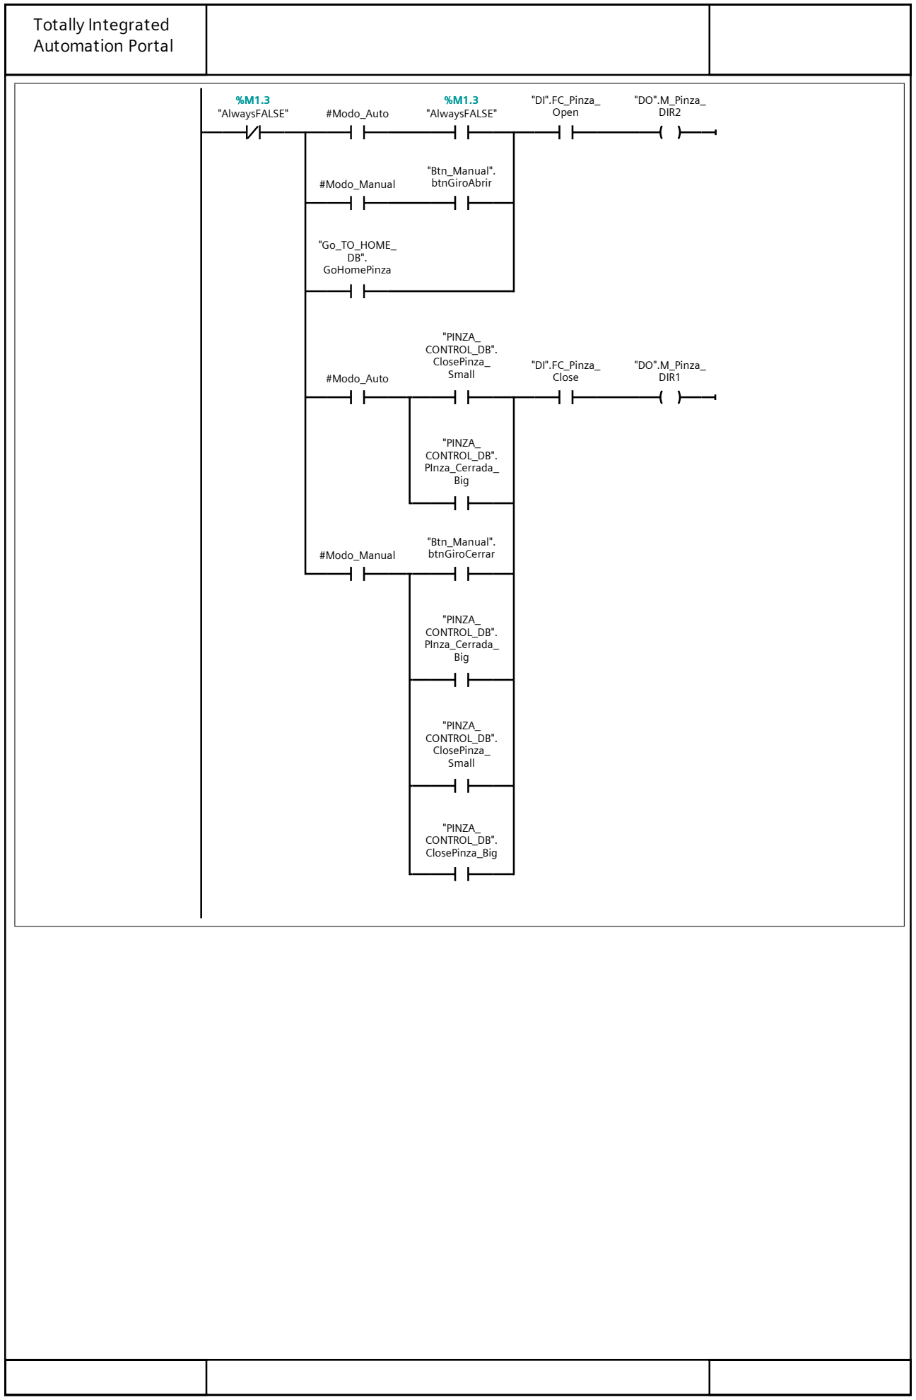
[picture p39: figure]
"AlwaysFALSE"; #Modo_Auto; "DI".FC_Pinza_; Open; "DO".M_Pinza_ DIR2; #Modo_Manual; "Btn_Manual". btnGiroAbrir; "Go_TO_HOME_ DB". GoHomePinza; "PINZA_ CONTROL_DB". ClosePinza_; Small; Close; "DO".M_Pinza_ DIR1; "PINZA_ CONTROL_DB". PInza_Cerrada_ Big; "Btn_Manual". btnGiroCerrar; "PINZA_ CONTROL_DB". ClosePinza_ Small; "PINZA_ CONTROL_DB". ClosePinza_Big

## MAQUINA DE VENDING_10_PRUEBAAUTO / PLC_1 [CPU 1214C DC/DC/ DC] / Bloques de programa / OUTPUTS

## Global_Ouputs [FB21]

Global_Ouputs Propiedades
General
Nombre | Global_Ouputs | Número | 21 | Tipo | FB
Idioma | KOP | Numeración | Automático
Información
Título | Autor | | Comentario
Familia | Versión | 0.1 | ID personali‐ zada

Global_Ouputs
Nombre | Tipo de datos | Valor predet. | Remanencia
Input
Output
InOut
Static
Temp
Constant
Segmento 1:

0001
0002 //PULSOS DE MOTORES PASO A PASO
0003 (* "PLC_OUTPUTS_Q0.0" := "DO".EJE_X_PUL; 0004 "PLC_OUTPUTS_Q0.1" := "DO".EJE_Y_PUL; 0005 "PLC_OUTPUTS_Q0.2" := "DO".EJE_Z_PUL; *) 0006
0007 //PULSOS PINZA
0008 "PLC_OUTPUTS_Q0.3" := "DO".M_Pinza_PUL; 0009
0010 //CONTROL DE DIRECCION DE EJES
0011 (* "PLC_OUTPUTS_Q0.4" := "DO".EJE_X_DIR; 0012 "PLC_OUTPUTS_Q0.5" := "DO".EJE_Y_DIR; 0013 "PLC_OUTPUTS_Q0.6" := "DO".EJE_Z_DIR; *) 0014
0015 // CONTROL DE DIRECCION DE PINZA
0016 "PLC_OUTPUTS_Q1.0" := "DO".M_Pinza_DIR1; 0017 "PLC_OUTPUTS_Q1.1" := "DO".M_Pinza_DIR2; 0018
0019 //HABILITACION DE EJES
0020 "ET_OUTPUTS_Q2.0" := "DO".EJE_X_ENA;
0021 "ET_OUTPUTS_Q2.1" := "DO".EJE_Y_ENA;
0022 "EJE_Z_HabilitarAccionamiento" := "DO".EJE_Z_ENA; 0023
0024 //CONTROL DE GIRO DE LAS ESTANTERIAS
0025 "ET_OUTPUTS_Q2.3" := "DO".Estanteria_1_DIR1; 0026 "ET_OUTPUTS_Q2.4" := "DO".Estanteria_1_DIR2; 0027 "ET_OUTPUTS_Q2.5" := "DO".Estanteria_2_DIR1; 0028 "ET_OUTPUTS_Q2.6" := "DO".Estanteria_2_DIR2; 0029 "ET_OUTPUTS_Q2.7" := "DO".Estanteria_3_DIR1; 0030 "ET_OUTPUTS_Q3.0" := "DO".Estanteria_3_DIR2; 0031 "ET_OUTPUTS_Q3.1" := "DO".Estanteria_4_DIR1;

0032 "ET_OUTPUTS_Q3.2" := "DO".Estanteria_4_DIR2; 0033
0034 //LUCES DE LA MAQUINA
0035 "ET_OUTPUTS_Q3.7" := "DO".Luces_Maquina; 0036
0037

## MAQUINA DE VENDING_10_PRUEBAAUTO / PLC_1 [CPU 1214C DC/DC/ DC] / Bloques de programa / PINZA

## PINZA_CONTROL [FB26]

PINZA_CONTROL Propiedades
General
Nombre | PINZA_CONTROL | Número | 26 | Tipo | FB
Idioma | KOP | Numeración | Automático
Información
Título | Autor | | Comentario
Familia | Versión | 0.1 | ID personali‐ zada

PINZA_CONTROL
Nombre | Tipo de datos | Valor predet. | Remanencia
Input
ENA_PWM | Bool | false | No remanente
OpenPinza | Bool | false | No remanente
Limite Apertura | Bool | false | No remanente
Limite Cerrado | Bool | false | No remanente
btnGirarCerrar | Bool | false | No remanente
btnGirarAbrir | Bool | false | No remanente
Output
InOut
Static
activacion_Small | Bool | false | No remanente
activacion_Big | Bool | false | No remanente
ClosePinza_Small | Bool | false | No remanente
ClosePinza_Big | Bool | false | No remanente
PInza_Cerrada_Big | Bool | false | No remanente
PInza_Cerrada_Small | Bool | false | No remanente
Pulse1 | Bool | false | No remanente
pulse2 | Bool | false | No remanente
STATUS | Int | 0 | No remanente
Velocidad_Motor | Int | 0 | No remanente
MC_Halt_EJE_Z | MC_Halt
TIME_CAJA_GRANDE | TON_TIME | | No remanente
CTRL_PWM_Motor | CTRL_PWM
TIME_CAJA_PEQUEÑA | TON_TIME | | No remanente
Temp
Constant
Segmento 1:

CTRL_PWM

#CTRL_PWM_Motor

"Local~Pulse_
Pinza"

268

#ENA_PWM

#PInza_Cerrada_

Big
#STATUS

EN

PWM
ENABLE

ENO

BUSY
STATUS

EN

PWM
ENABLE

ENO

BUSY
STATUS

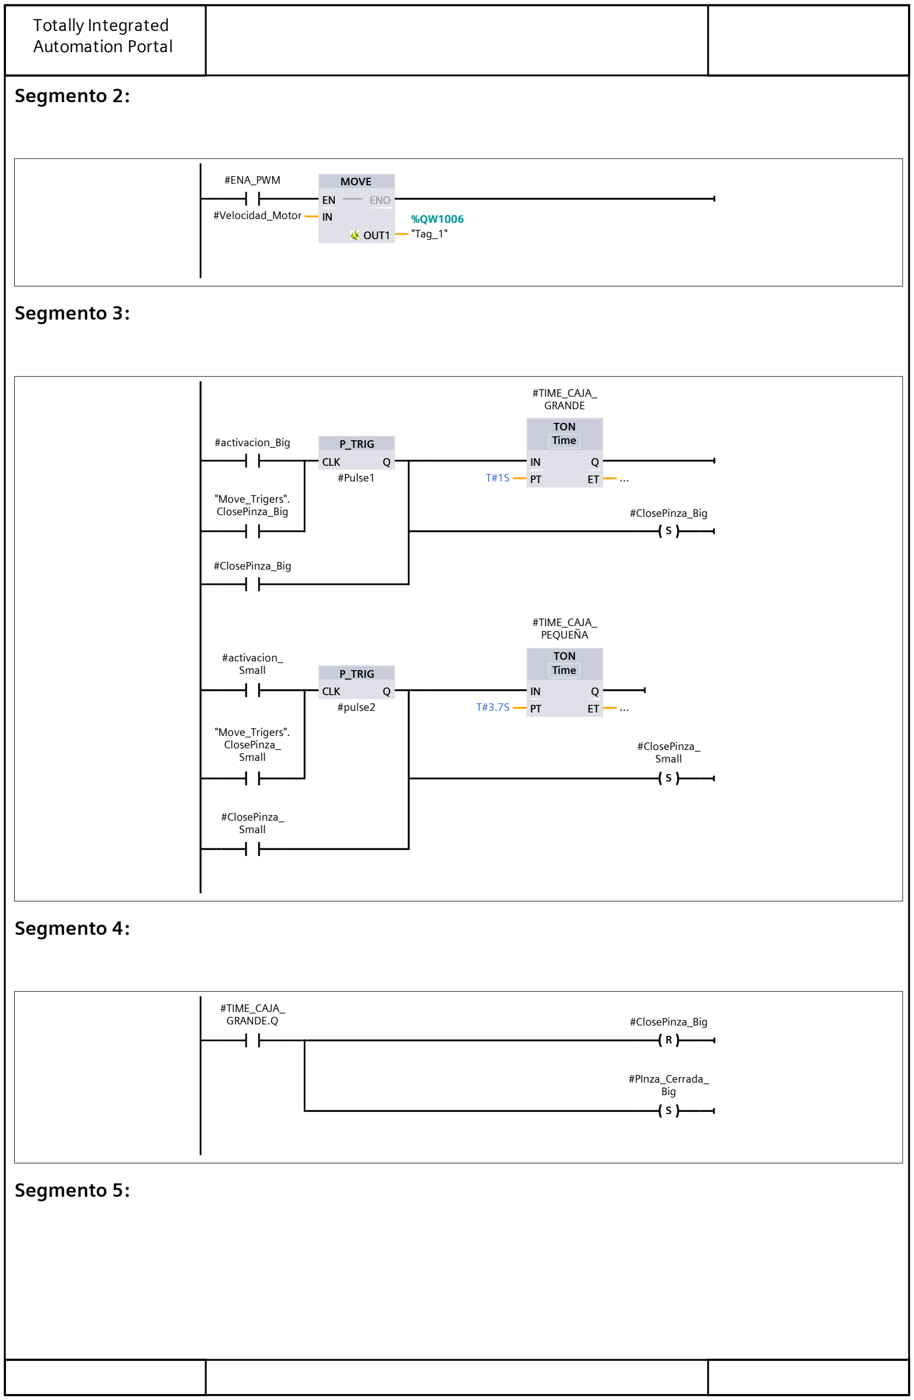
[picture p40: figure]
Segmento 2:; #ENA_PWM; MOVE; #Velocidad_Motor; "Tag_1"; ENO; OUT1; Segmento 3:; P_TRIG; TON Time; #activacion_Big; #Pulse1; #TIME_CAJA_ GRANDE; "Move_Trigers". ClosePinza_Big; #ClosePinza_Big; #activacion_ Small; #pulse2; #TIME_CAJA_ PEQUEÑA; #ClosePinza_ Small; "Move_Trigers". ClosePinza_ Small; CLK; Time; Segmento 4:; #TIME_CAJA_; GRANDE.Q; #PInza_Cerrada_ Big; Segmento 5:

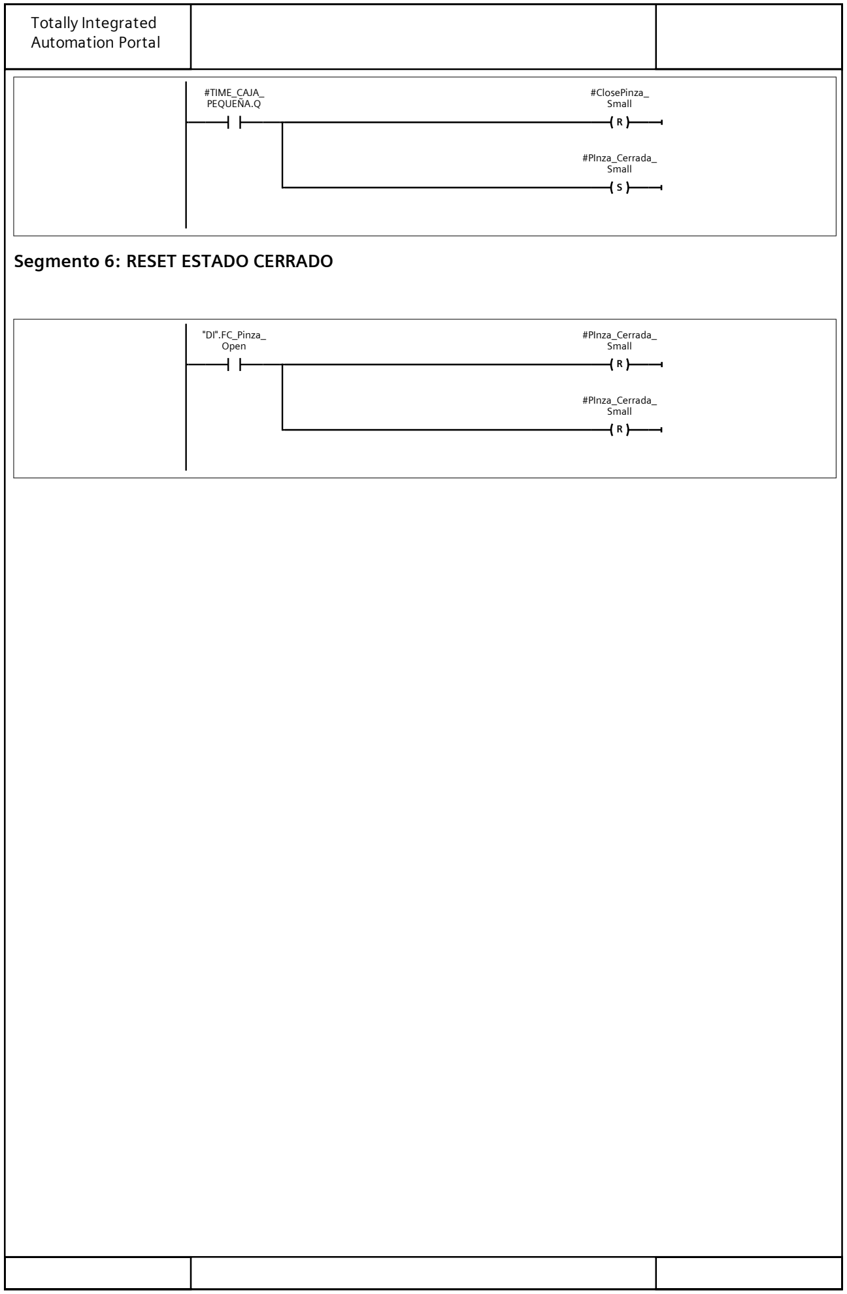
[picture p41: figure]
#TIME_CAJA_ PEQUEÑA.Q; #ClosePinza_ Small; #PInza_Cerrada_ Small; Segmento 6: RESET ESTADO CERRADO; "DI".FC_Pinza_ Open

## MAQUINA DE VENDING_10_PRUEBAAUTO / PLC_1 [CPU 1214C DC/DC/ DC] / Bloques de programa / TAKE_POINTS

## GO_TO_POINT [FB17]

GO_TO_POINT Propiedades
General
Nombre | GO_TO_POINT | Número | 17 | Tipo | FB
Idioma | KOP | Numeración | Automático
Información
Título | Autor | | Comentario
Familia | Versión | 0.1 | ID personali‐ zada

GO_TO_POINT
Nombre | Tipo de datos | Valor predet. | Remanencia
Input
Velocidad | Real | 0.0 | No remanente
Output
InOut
Static
GoToPoint | Bool | false | No remanente
Select_Posicion | Bool | false | No remanente
Move_X | Bool | false | No remanente
Move_Y | Bool | false | No remanente
Move_Z | Bool | false | No remanente
Move_All | Bool | false | No remanente
ENA_X | Bool | false | No remanente
ENA_Y | Bool | false | No remanente
ENA_Z | Bool | false | No remanente
Puntero | Int | 0 | No remanente
Posicion_Move | "TypePosMotion" | | No remanente
Posicion_Preview | "TypePosMotion" | | No remanente
MA_EJE_X | MC_MoveAbsolute
MA_EJE_Y | MC_MoveAbsolute
MA_EJE_Z | MC_MoveAbsolute
Temp
Constant
Segmento 1:

Segmento 2:

0001 #Posicion_Preview := "Posiciones_Guardadas".Posiciones[#Puntero]; 0002
0003 IF #Select_Posicion THEN
0004 #Posicion_Move := "Posiciones_Guardadas".Posiciones[#Puntero]

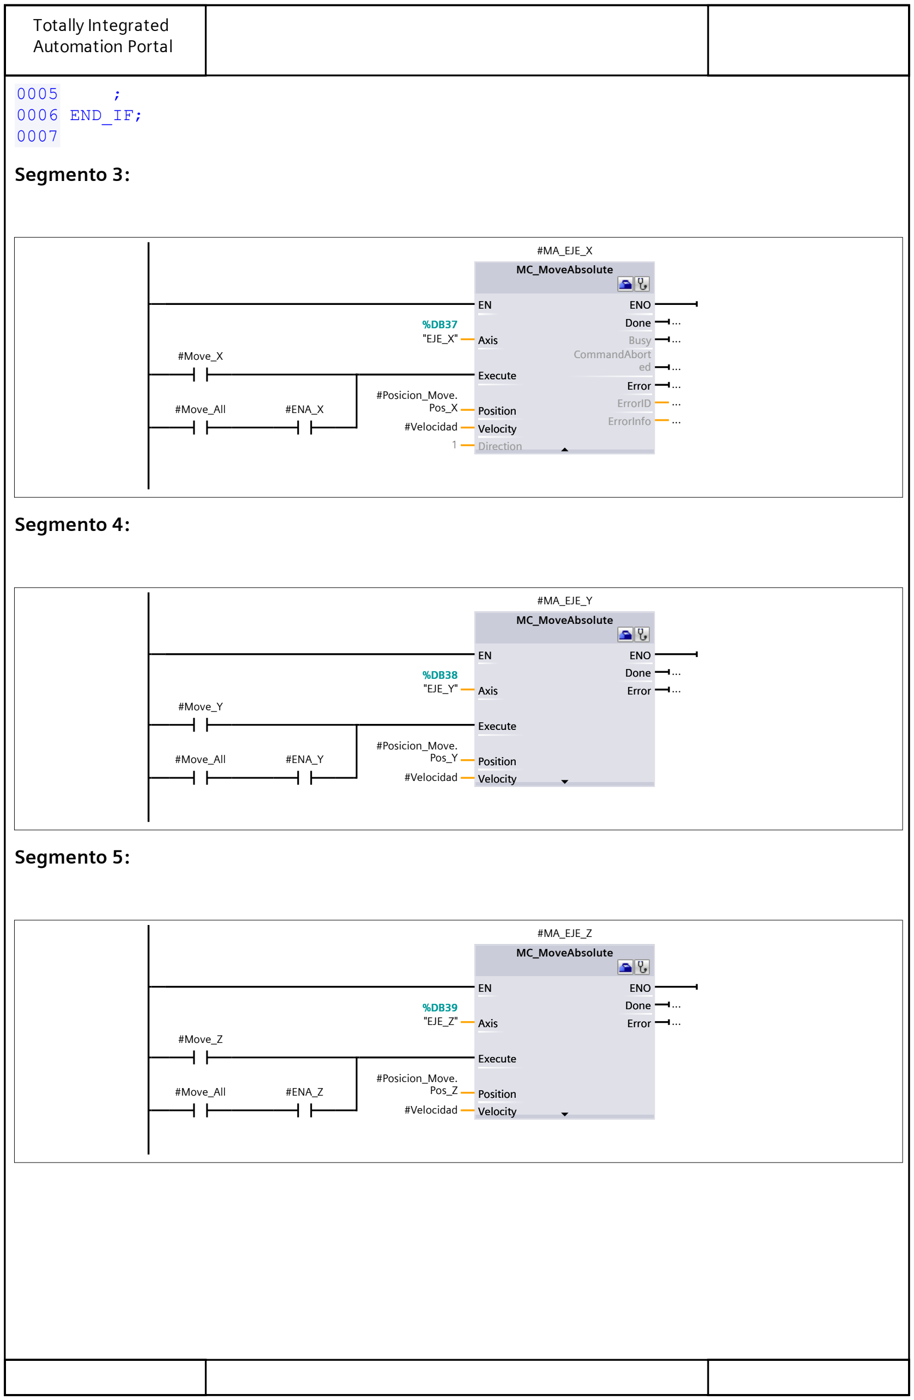
[picture p42: figure]
0006 END_IF; 0007; Segmento 3:; MC_MoveAbsolute; #MA_EJE_X; "EJE_X"; #Posicion_Move. Pos_X #Velocidad 1; #Move_X; #Move_All; #ENA_X; Axis; Execute; Position Velocity Direction; ENO Done Busy CommandAbort ed Error ErrorID ErrorInfo; Segmento 4:; #MA_EJE_Y; "EJE_Y"; #Posicion_Move. Pos_Y #Velocidad; #Move_Y; #ENA_Y; Position Velocity; ENO Done Error; Segmento 5:; #MA_EJE_Z; "EJE_Z"; #Posicion_Move. Pos_Z #Velocidad; #Move_Z; #ENA_Z

## MAQUINA DE VENDING_10_PRUEBAAUTO / PLC_1 [CPU 1214C DC/DC/ DC] / Bloques de programa / TAKE_POINTS

## SAVE_POINTS [FB16]

SAVE_POINTS Propiedades
General
Nombre | SAVE_POINTS | Número | 16 | Tipo | FB
Idioma | KOP | Numeración | Automático
Información
Título | Autor | | Comentario
Familia | Versión | 0.1 | ID personali‐ zada

SAVE_POINTS
Nombre | Tipo de datos | Valor predet. | Remanencia
Input
Output
InOut
Static
bSave_Point | Bool | false | No remanente
iPuntero | Int | 0 | No remanente
Posicion_Actual | "TypePosMotion" | | No remanente
tPosicion_Preview | "TypePosMotion" | | No remanente
Temp
Constant
Segmento 1:

Segmento 2:

0001
0002 #Posicion_Actual.Pos_X := "Datos_reales_ejes".Pos_Eje_X; 0003 #Posicion_Actual.Pos_Y := "Datos_reales_ejes".Pos_Eje_Y;
0004 #Posicion_Actual.Pos_Z := "Datos_reales_ejes".Pos_Eje_Z;
0005
0006 #tPosicion_Preview := "Posiciones_Guardadas".Posiciones[#iPuntero]; 0007
0008 IF #bSave_Point THEN
0009
0010 "Posiciones_Guardadas".Posiciones[#iPuntero] := #Posicion_Actual; 0011
0012 ;
0013 END_IF;
0014

## MAQUINA DE VENDING_10_PRUEBAAUTO / PLC_1 [CPU 1214C DC/DC/ DC] / Bloques de programa / TAKE_POINTS

## TAKE_POSICIONS [FC4]

TAKE_POSICIONS Propiedades
General
Nombre | TAKE_POSICIONS | Número | 4 | Tipo | FC
Idioma | KOP | Numeración | Automático
Información
Título | Autor | | Comentario
Familia | Versión | 0.1 | ID personali‐ zada

TAKE_POSICIONS
Nombre | Tipo de datos | Valor predet.
Input
Output
InOut
Temp
Constant
Return
TAKE_POSICIONS | Void
Segmento 1:

"SAVE_POINTS"

%FB16

"SAVE_POINTS_
DB"

%DB34

EN | ENO

Segmento 2:

"GO_TO_POINT"

%FB17

"GO_TO_POINT_
DB"

%DB35

20.0

EN
Velocidad

ENO
