josegd98/MaquinaVending/Documentació Projecte/Diagrama de Gannt.pdf

Id | Modo de
tarea
Nombre de tarea | Duración | Comienzo | Fin | Nombres de los recursos | Miembros
1 | Projecte Maquina Vending 1er
trimestre
139 días | jue 08/09/22 | vie 06/01/23
2 | Fase 1 | 139,2 días | jue 08/09/22 | vie 06/01/23
3 | Pluja d'idees | 3,2 días | jue 08/09/22 | vie 09/09/22 | Jose, Jonas i Rodolfo
4 | Plantejament de la idea | 8 días | lun 12/09/22 | vie 16/09/22 | Jose, Jonas i Rodolfo
5 | Esborrany de la idea plantejada | 7 días | lun 19/09/22 | vie 23/09/22 | Jose, Jonas i Rodolfo
6 | Relacionar el projecte amb les
UF's (Unitats de Formació)
15 días | lun 26/09/22 | vie 07/10/22 | Jose, Jonas i Rodolfo
7 | Conclusions del funcionament | 7 días | lun 10/10/22 | vie 14/10/22 | Jose, Jonas i Rodolfo
8 | Disseny principal de la idea | 7 días | lun 17/10/22 | vie 21/10/22 | Jose, Jonas i Rodolfo
9 | Disseny de Sistemes
automatitzats de funcionament
23 días | lun 24/10/22 | vie 11/11/22 | Jonas
10 | Llistat de material necessari | 7 días | lun 14/11/22 | vie 18/11/22 | Jose, Jonas i Rodolfo
11 | Disseny de les peces
necessàries
15 días | lun 14/11/22 | vie 25/11/22 | Jose
12 | Documentació de materials | 3,8 días | lun 28/11/22 | mié 30/11/22 | Jonas i Rodolfo
13 | Documentació del
funcionament del sistema
2,2 días | jue 01/12/22 | vie 02/12/22 | Jose
14 | Pressupost dels materials
necessaris
7 días | lun 05/12/22 | vie 09/12/22 | Jose, Jonas i Rodolfo
15 | Disseny de macro components
elèctrics
7 días | lun 12/12/22 | vie 16/12/22 | Jonas i Rodolfo
16 | Recerca de materials i
components
7 días | lun 19/12/22 | vie 23/12/22 | Jose, Jonas i Rodolfo
17 | Disseny d'esquemes de
programació (grafcet)
7 días | lun 26/12/22 | vie 30/12/22 | Jonas
18 | Disseny d'esquemes elèctrics | 7 días | lun 02/01/23 | vie 06/01/23 | Jonas i Rodolfo
20 | Projecte Maquina Vending 2n
trimestre
97 días | lun 09/01/23 | lun 03/04/23
21 | Fase 2 | 96,6 días | lun 09/01/23 | lun 03/04/23
22 | Actualització de la
documentació
16,6 días | lun 20/03/23 | lun 03/04/23 | Jose, Jonas i Rodolfo
24 | Muntatge del quadre elèctric | 95 días | lun 09/01/23 | vie 31/03/23 | Jonas i Rodolfo
25 | Mecanització de peces al taller | 96,6 días | lun 09/01/23 | lun 03/04/23 | Jose
27 | Projecte Maquina Vending 3r
trimestre
83 días | lun 03/04/23 | mié 14/06/23
28 | Fase 3 | 81,8 días | mar 04/04/23 | mié 14/06/23
29 | Actualització de la
documentació
10,2 días | lun 05/06/23 | mar 13/06/23 | Jose, Jonas i Rodolfo
30 | Muntatge dels carregadors
d'emmagatzematge i les
prestatgeries
5 días | mar 04/04/23 | vie 07/04/23 | Jose
31 | Muntatge dels carregadors
| d'emmagatzematge | 3 días | mar 11/04/23 | mié 12/04/23 | Jose
32 | Muntatge de les estanteries | 3 días | jue 13/04/23 | vie 14/04/23 | Jose
33 | Muntatge de la rampa i caixa
| expenedora | 5 días | mar 18/04/23 | vie 21/04/23 | Jose
34 | Muntatge de la rampa i caixa
| expenedora | 3 días | mar 25/04/23 | mié 26/04/23 | Jose
35 | Muntatge de la pinça | 5 días | vie 28/04/23 | mié 03/05/23 | Jose
36 | Muntatge de la pinça i
| acoblament a l'estructura de la base lineal vertical | 7 días | lun 08/05/23 | vie 12/05/23 | Jose
37 | Muntatge de la guia lineal
| (base) | 3 días | mar 16/05/23 | mié 17/05/23 | Jose
38 | Acoblament de la guia lineal
| vertical a la base | 5 días | vie 19/05/23 | mié 24/05/23 | Jose
39 | Instal∙lació dels sensors | 3 días | jue 25/05/23 | vie 26/05/23 | Jose i Jonas
40 | Instal∙lació de la pantalla HMI | 1 día | lun 29/05/23 | lun 29/05/23 | Jose i Jonas
41 | Instal∙lació elèctrica de tots els
| components | 5 días | mar 30/05/23 | vie 02/06/23 | Jonas i Rodolfo
42 | Comprovació de tots els
| sensors una vegada connectats a la font d'alimentació | 3 días | mar 06/06/23 | mié 07/06/23 | Jose, Jonas i Rodolfo
43 | Posada en marxa de la màquina | 3 días | mar 13/06/23 | mié 14/06/23 | Jose, Jonas i Rodolfo
0 | 6 | 12 | 18 | 0 | 6 | 12 | 18 | 0 | 6 | 12 | 18 | 0 | 6 | 12 | 18 | 0 | 6 | 12 | 18 | 0 | 6 | 12 | 18 | 0 | 6 | 12 | 18 | 0
jue 08 sep | vie 09 sep | sáb 10 sep | dom 11 sep | lun 12 sep | mar 13 sep | mié 14 sep | jue 15 s

Tarea
División
Hito

Resumen
Resumen del proyecto
Tarea inactiva

Hito inactivo
Resumen inactivo
Tarea manual

solo duración
Informe de resumen manual
Resumen manual

solo el comienzo
solo fin
Tareas externas

Hito externo
Fecha límite
Progreso

Progreso manual

### Proyecto: Proyecto CFGS Robo Fecha: lun 12/06/23

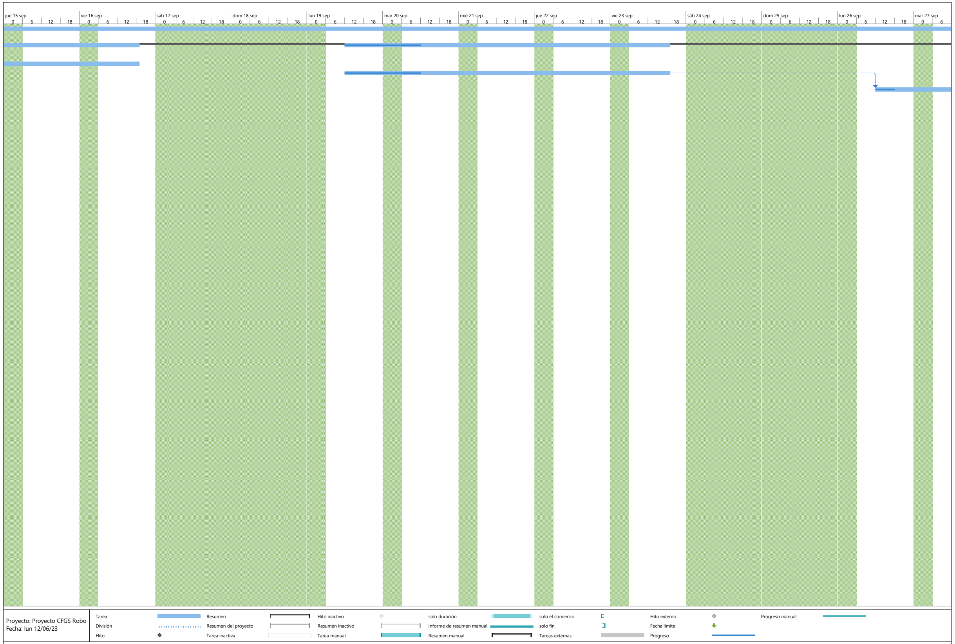
[picture p43: figure]
jue 15 sep; vie 16 sep; sáb 17 sep; dom 18 sep; lun 19 sep; mar 20 sep; mié 21 sep; jue 22 sep; vie 23 sep; sáb 24 sep; dom 25 sep; lun 26 sep; mar 27 sep; Tarea; Resumen; Hito inactivo; solo duración; solo el comienzo; Hito externo; Progreso manual; Proyecto: Proyecto CFGS Robo

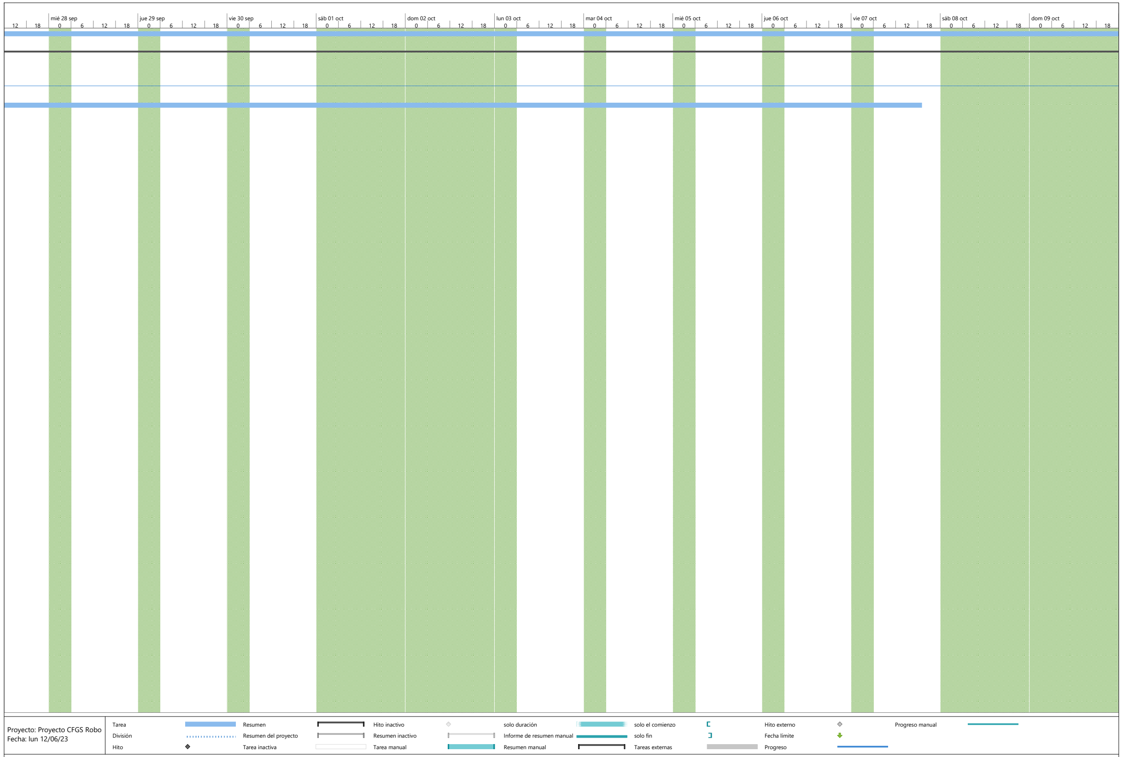
[picture p44: figure]
mié 28 sep; jue 29 sep; vie 30 sep; sáb 01 oct; dom 02 oct; lun 03 oct; mar 04 oct; mié 05 oct; jue 06 oct; vie 07 oct; sáb 08 oct; dom 09 oct; Tarea; Resumen; Hito inactivo; solo duración; solo el comienzo; Hito externo; Progreso manual; Proyecto: Proyecto CFGS Robo

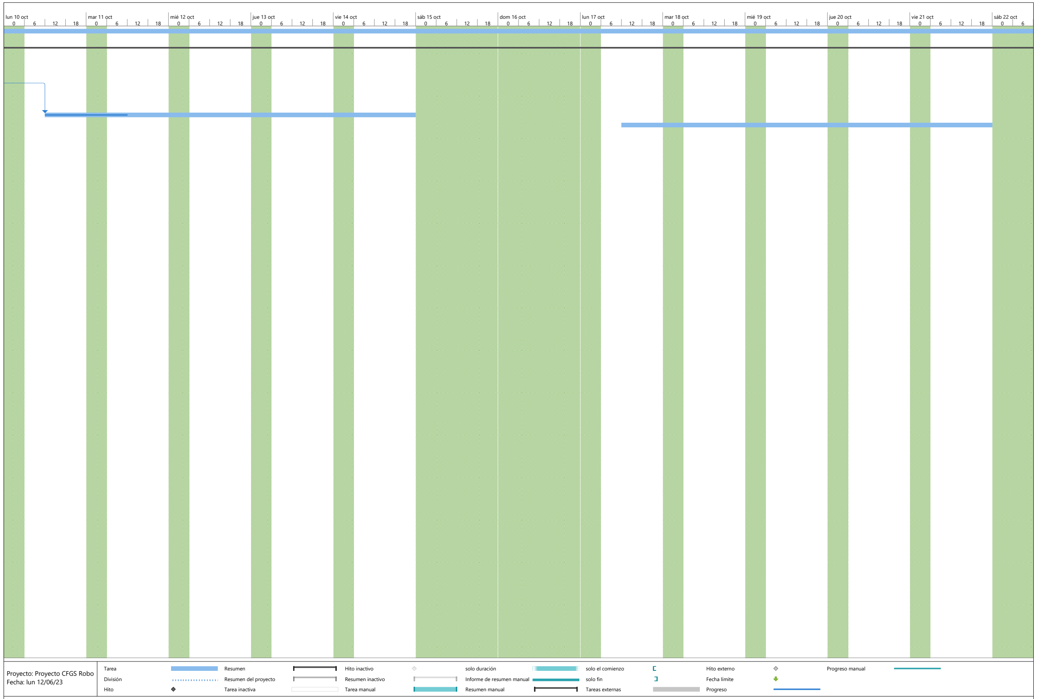
[picture p45: figure]
lun 10 oct; mar 11 oct; mié 12 oct; jue 13 oct; vie 14 oct; sáb 15 oct; dom 16 oct; lun 17 oct; mar 18 oct; mié 19 oct; jue 20 oct; vie 21 oct; sáb 22 oct; Tarea; Resumen; Hito inactivo; solo duración; solo el comienzo; Hito externo; Progreso manual; Proyecto: Proyecto CFGS Robo

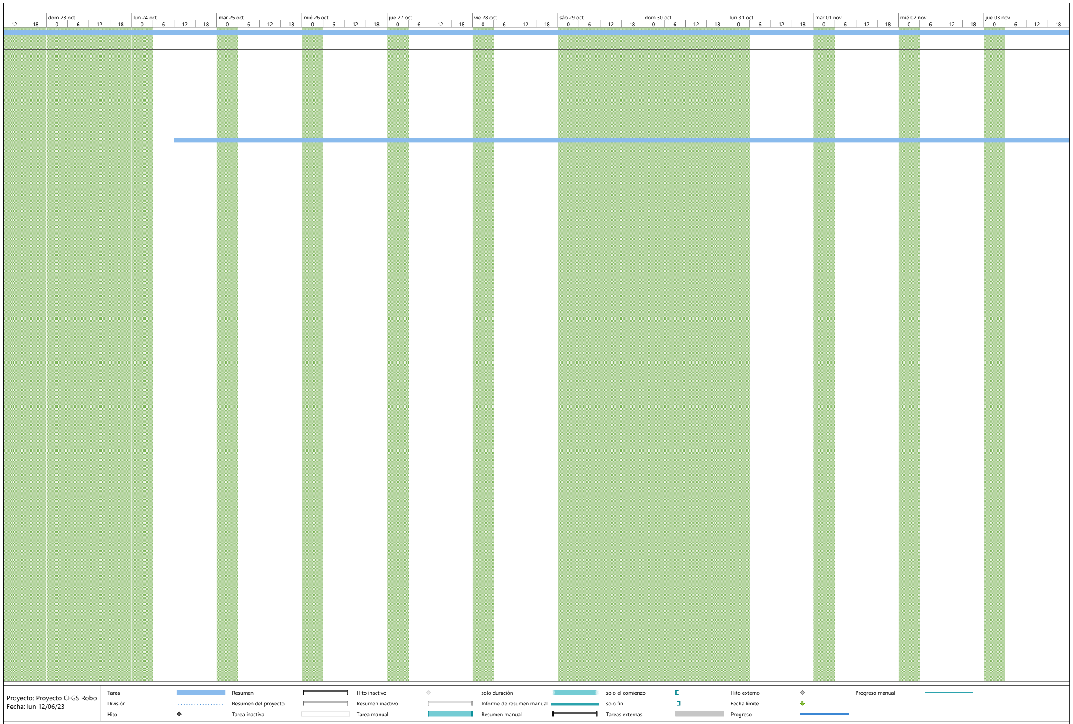
[picture p46: figure]
dom 23 oct; lun 24 oct; mar 25 oct; mié 26 oct; jue 27 oct; vie 28 oct; sáb 29 oct; dom 30 oct; lun 31 oct; mar 01 nov; mié 02 nov; jue 03 nov; Tarea; Resumen; Hito inactivo; solo duración; solo el comienzo; Hito externo; Progreso manual; Proyecto: Proyecto CFGS Robo

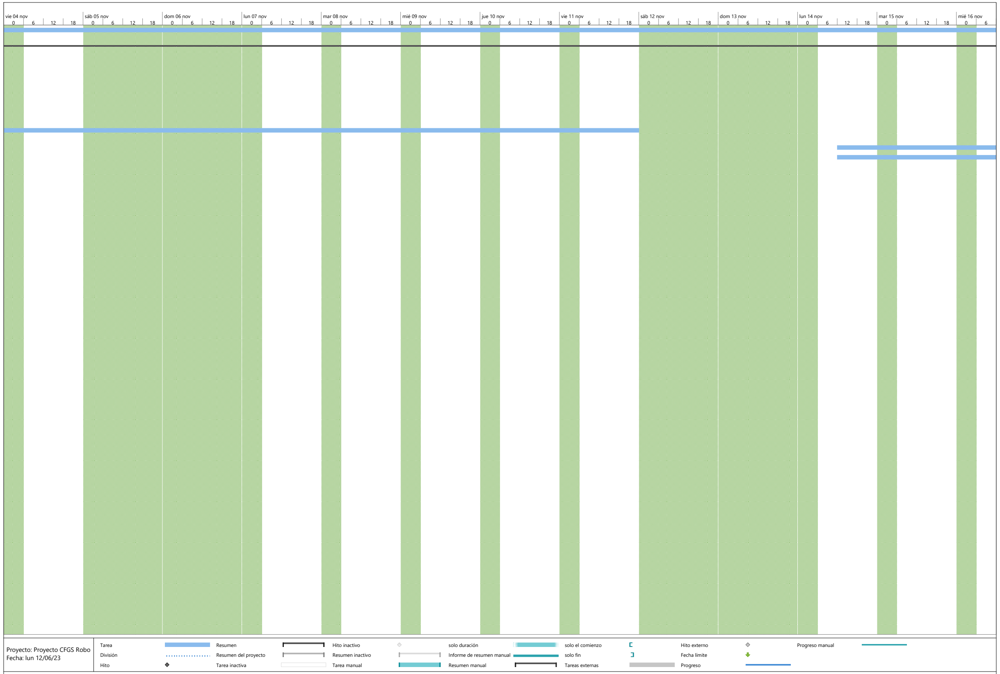
[picture p47: figure]
vie 04 nov; sáb 05 nov; dom 06 nov; lun 07 nov; mar 08 nov; mié 09 nov; jue 10 nov; vie 11 nov; sáb 12 nov; dom 13 nov; lun 14 nov; mar 15 nov; mié 16 nov; Tarea; Resumen; Hito inactivo; solo duración; solo el comienzo; Hito externo; Progreso manual; Proyecto: Proyecto CFGS Robo

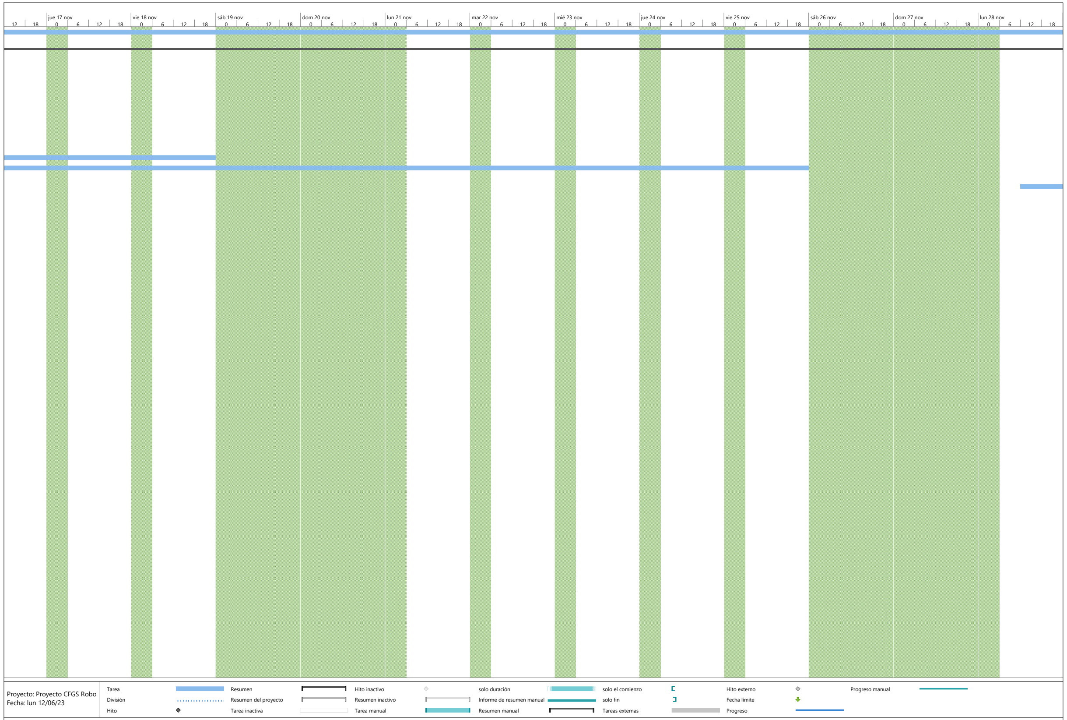
[picture p48: figure]
jue 17 nov; vie 18 nov; sáb 19 nov; dom 20 nov; lun 21 nov; mar 22 nov; mié 23 nov; jue 24 nov; vie 25 nov; sáb 26 nov; dom 27 nov; lun 28 nov; Tarea; Resumen; Hito inactivo; solo duración; solo el comienzo; Hito externo; Progreso manual; Proyecto: Proyecto CFGS Robo

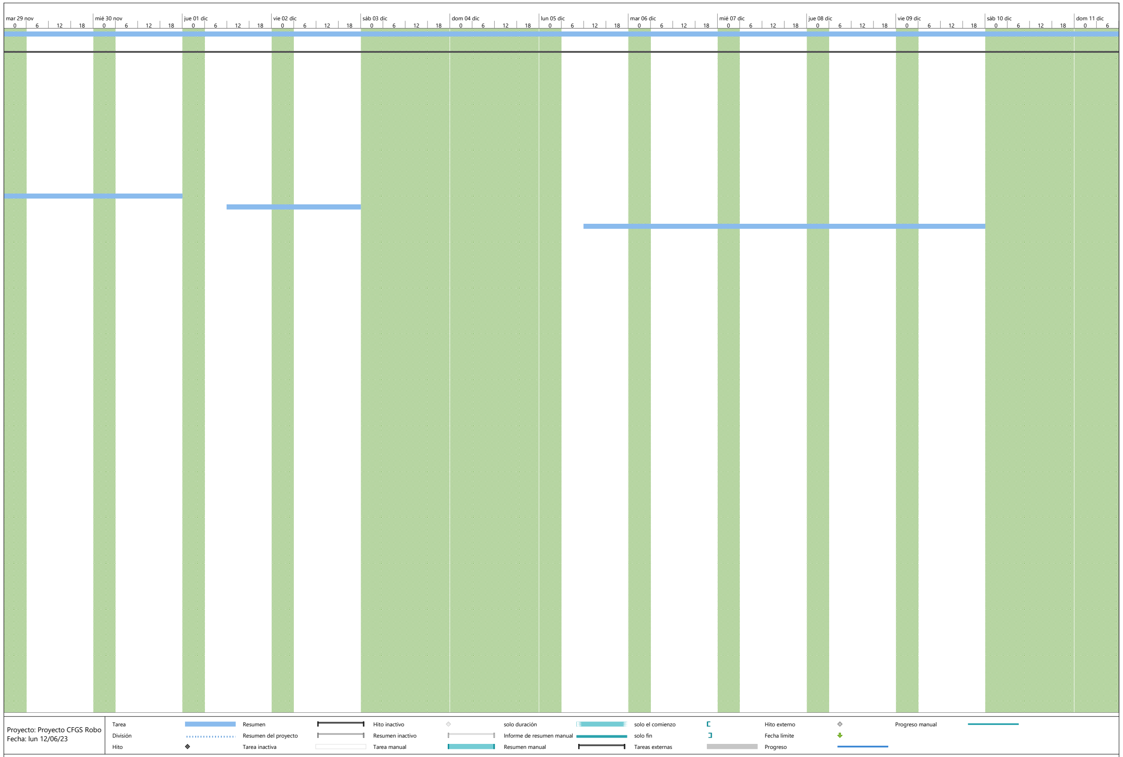
[picture p49: figure]
mar 29 nov; mié 30 nov; jue 01 dic; vie 02 dic; sáb 03 dic; dom 04 dic; lun 05 dic; mar 06 dic; mié 07 dic; jue 08 dic; vie 09 dic; sáb 10 dic; dom 11 dic; Tarea; Resumen; Hito inactivo; solo duración; solo el comienzo; Hito externo; Progreso manual; Proyecto: Proyecto CFGS Robo

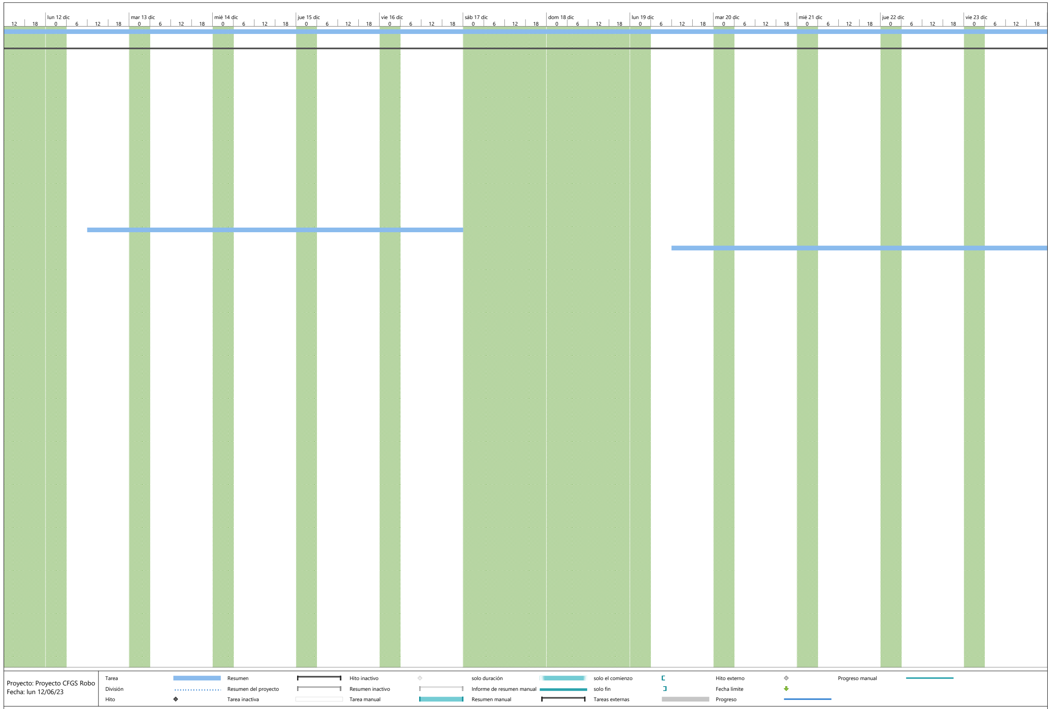
[picture p50: figure]
lun 12 dic; mar 13 dic; mié 14 dic; jue 15 dic; vie 16 dic; sáb 17 dic; dom 18 dic; lun 19 dic; mar 20 dic; mié 21 dic; jue 22 dic; vie 23 dic; Tarea; Resumen; Hito inactivo; solo duración; solo el comienzo; Hito externo; Progreso manual; Proyecto: Proyecto CFGS Robo

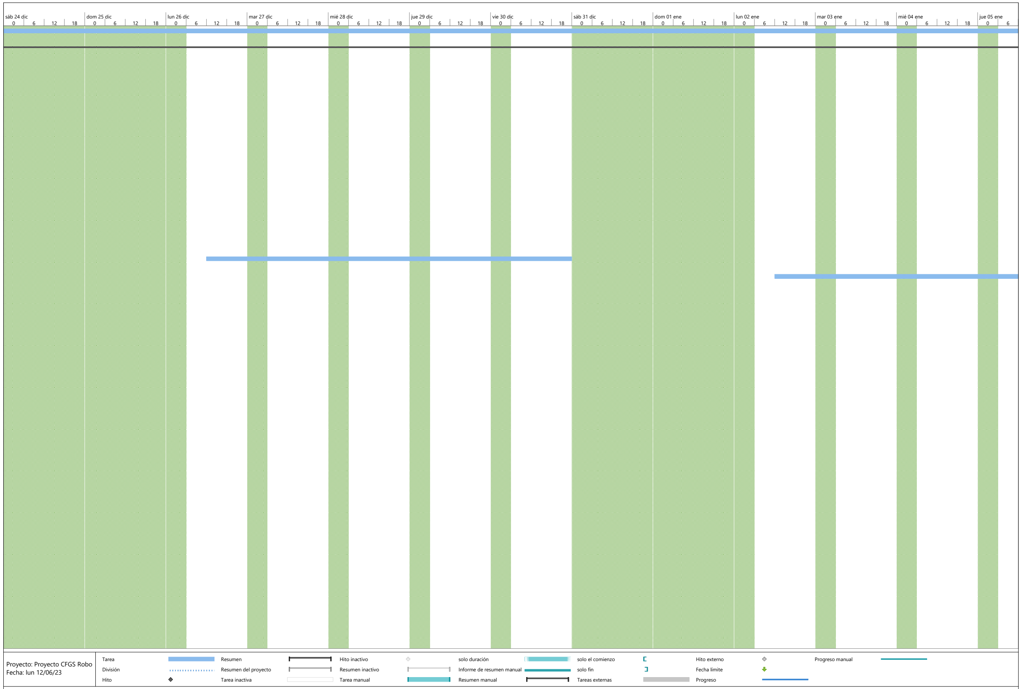
[picture p51: figure]
sáb 24 dic; dom 25 dic; lun 26 dic; mar 27 dic; mié 28 dic; jue 29 dic; vie 30 dic; sáb 31 dic; dom 01 ene; lun 02 ene; mar 03 ene; mié 04 ene; jue 05 ene; Tarea; Resumen; Hito inactivo; solo duración; solo el comienzo; Hito externo; Progreso manual; Proyecto: Proyecto CFGS Robo

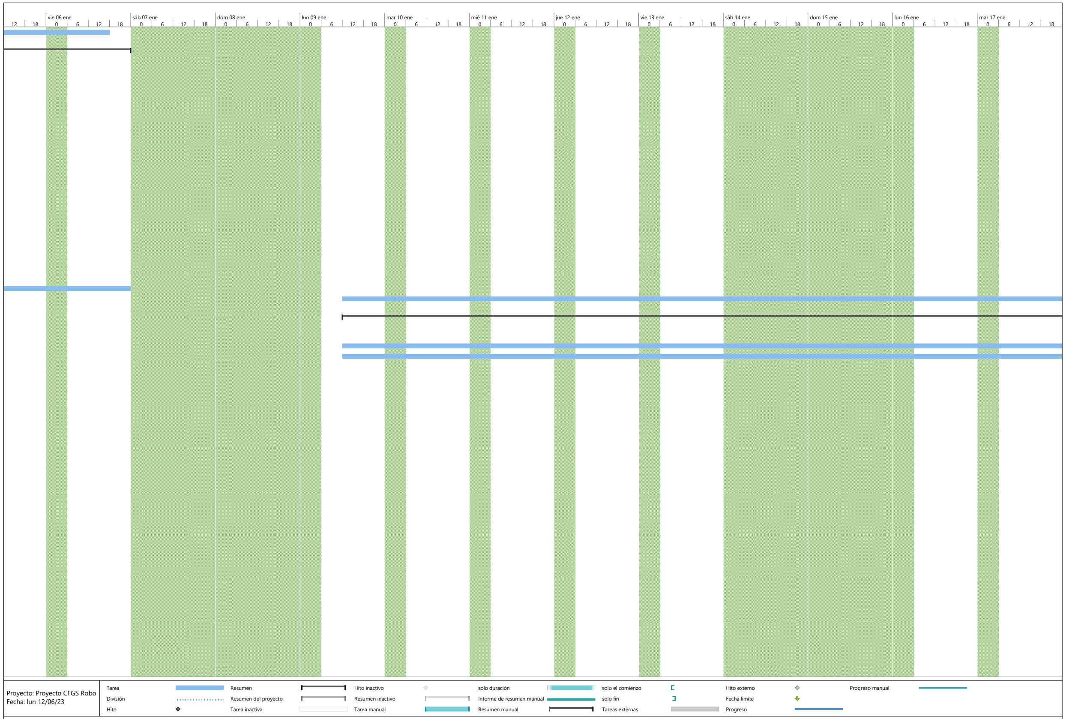
[picture p52: figure]
vie 06 ene; sáb 07 ene; dom 08 ene; lun 09 ene; mar 10 ene; mié 11 ene; jue 12 ene; vie 13 ene; sáb 14 ene; dom 15 ene; lun 16 ene; mar 17 ene; Tarea; Resumen; Hito inactivo; solo duración; solo el comienzo; Hito externo; Progreso manual; Proyecto: Proyecto CFGS Robo

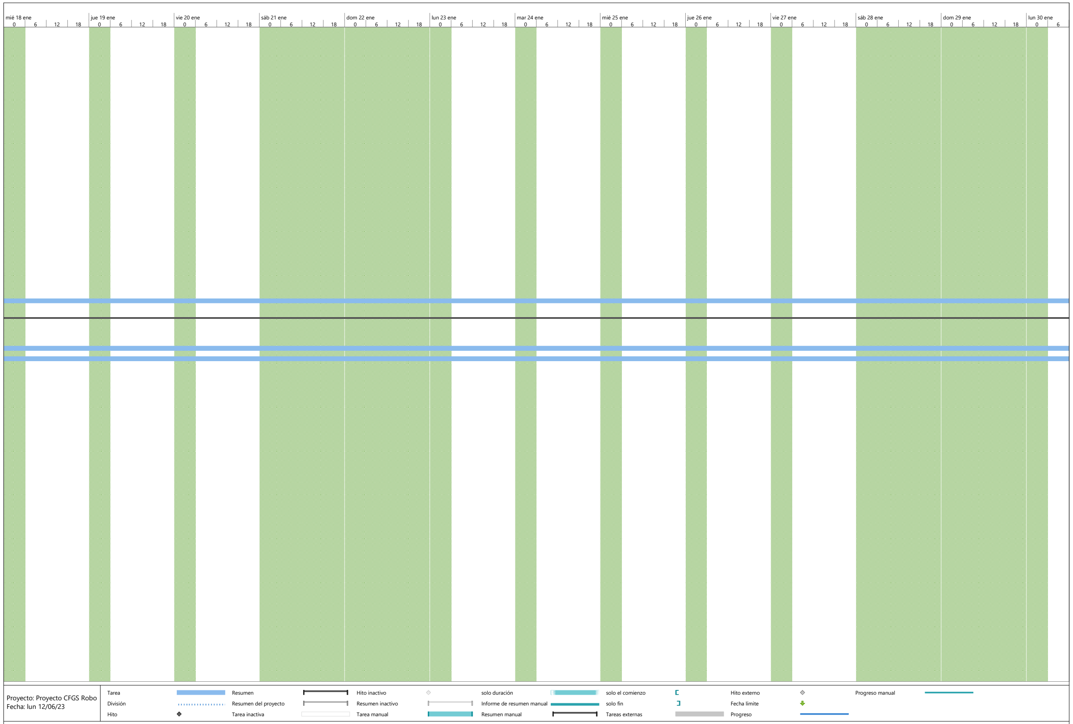
[picture p53: figure]
mié 18 ene; jue 19 ene; vie 20 ene; sáb 21 ene; dom 22 ene; lun 23 ene; mar 24 ene; mié 25 ene; jue 26 ene; vie 27 ene; sáb 28 ene; dom 29 ene; lun 30 ene; Tarea; Resumen; Hito inactivo; solo duración; solo el comienzo; Hito externo; Progreso manual; Proyecto: Proyecto CFGS Robo

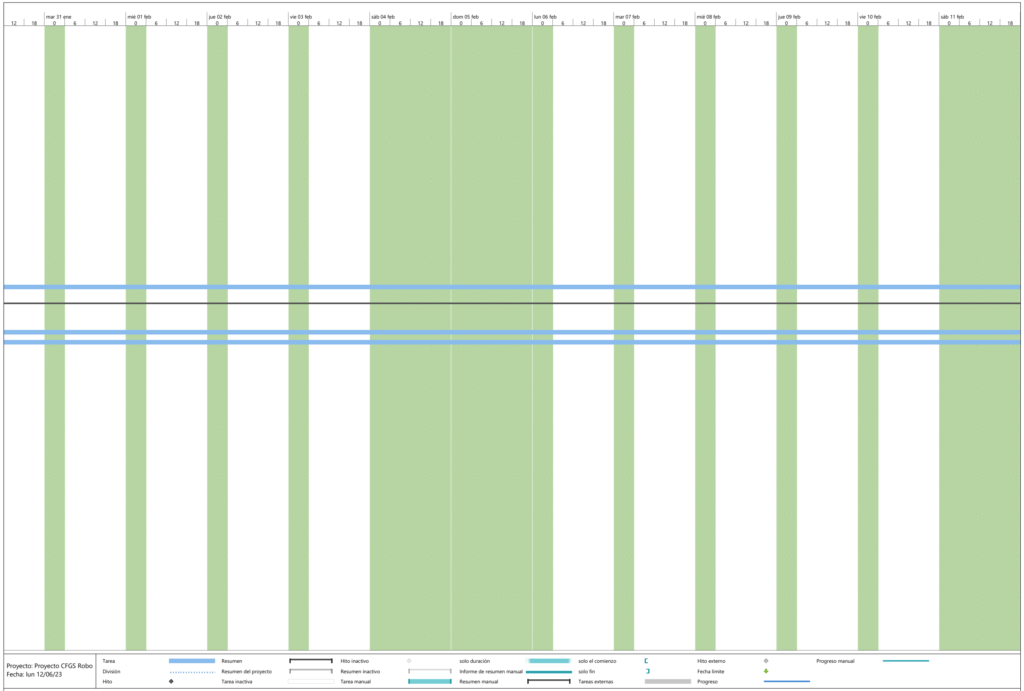
[picture p54: figure]
mar 31 ene; mié 01 feb; jue 02 feb; vie 03 feb; sáb 04 feb; dom 05 feb; lun 06 feb; mar 07 feb; mié 08 feb; jue 09 feb; vie 10 feb; sáb 11 feb; Tarea; Resumen; Hito inactivo; solo duración; solo el comienzo; Hito externo; Progreso manual; Proyecto: Proyecto CFGS Robo

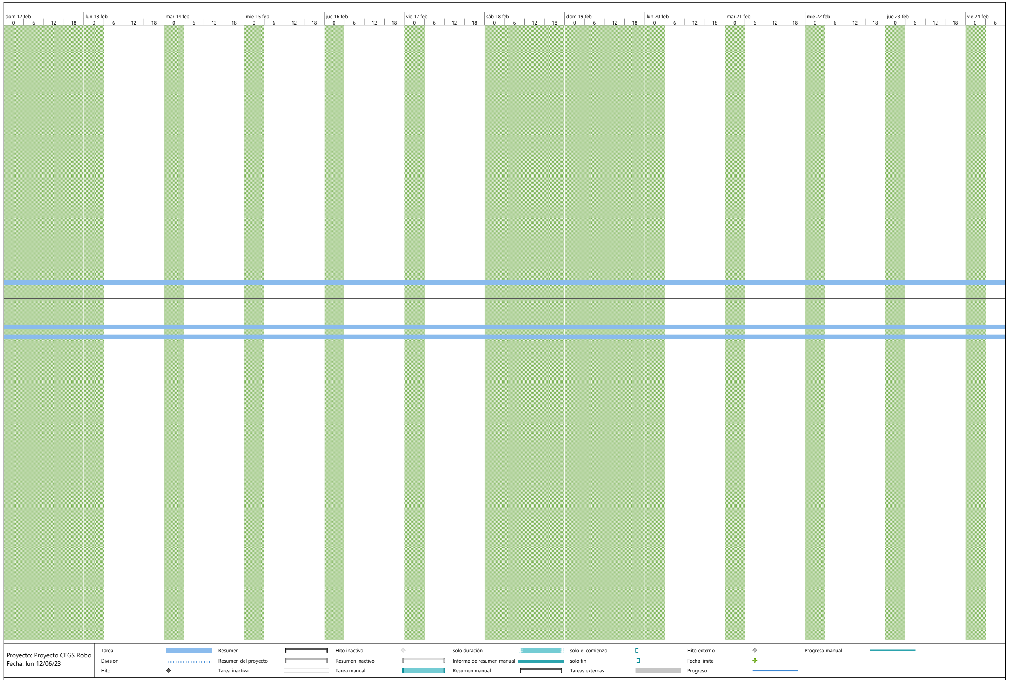
[picture p55: figure]
dom 12 feb; lun 13 feb; mar 14 feb; mié 15 feb; jue 16 feb; vie 17 feb; sáb 18 feb; dom 19 feb; lun 20 feb; mar 21 feb; mié 22 feb; jue 23 feb; vie 24 feb; Tarea; Resumen; Hito inactivo; solo duración; solo el comienzo; Hito externo; Progreso manual; Proyecto: Proyecto CFGS Robo

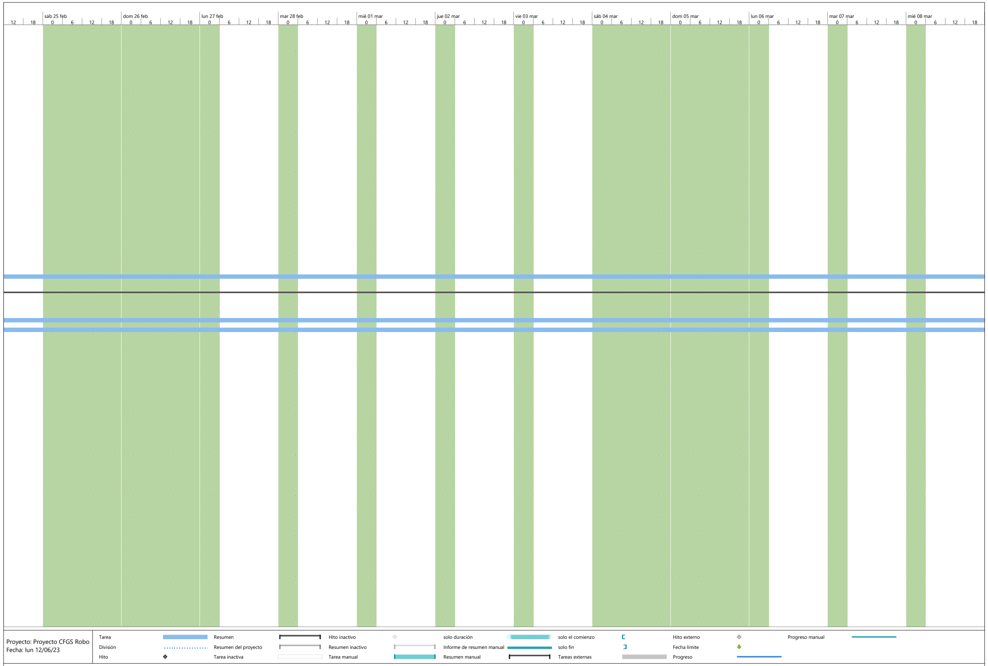
[picture p56: figure]
sáb 25 feb; dom 26 feb; lun 27 feb; mar 28 feb; mié 01 mar; jue 02 mar; vie 03 mar; sáb 04 mar; dom 05 mar; lun 06 mar; mar 07 mar; mié 08 mar; Tarea; Resumen; Hito inactivo; solo duración; solo el comienzo; Hito externo; Progreso manual; Proyecto: Proyecto CFGS Robo

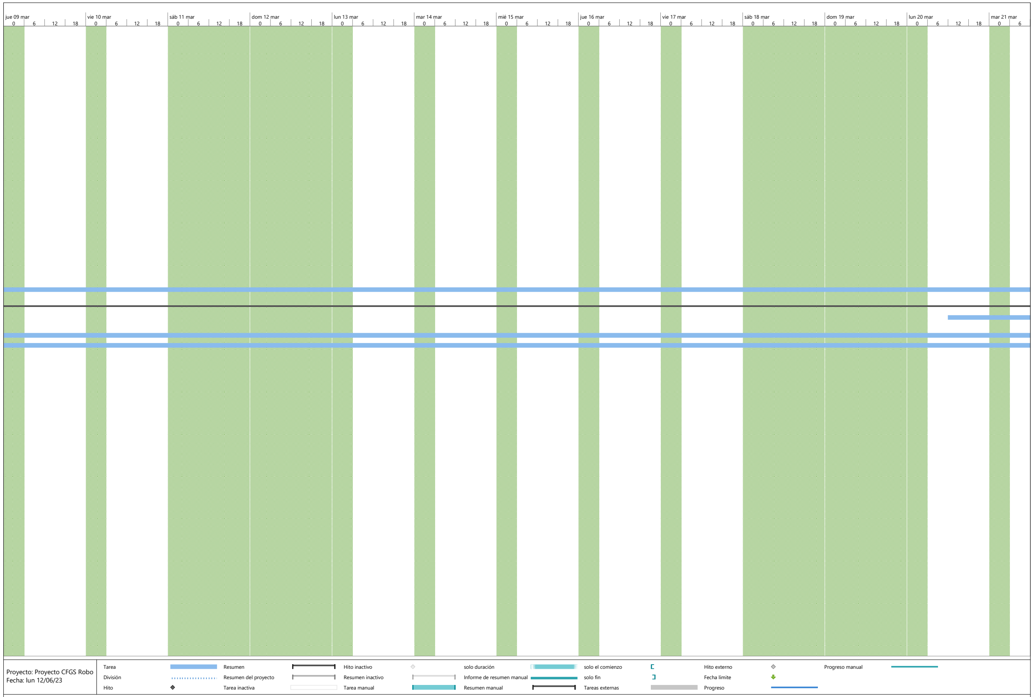
[picture p57: figure]
jue 09 mar; vie 10 mar; sáb 11 mar; dom 12 mar; lun 13 mar; mar 14 mar; mié 15 mar; jue 16 mar; vie 17 mar; sáb 18 mar; dom 19 mar; lun 20 mar; mar 21 mar; Tarea; Resumen; Hito inactivo; solo duración; solo el comienzo; Hito externo; Progreso manual; Proyecto: Proyecto CFGS Robo

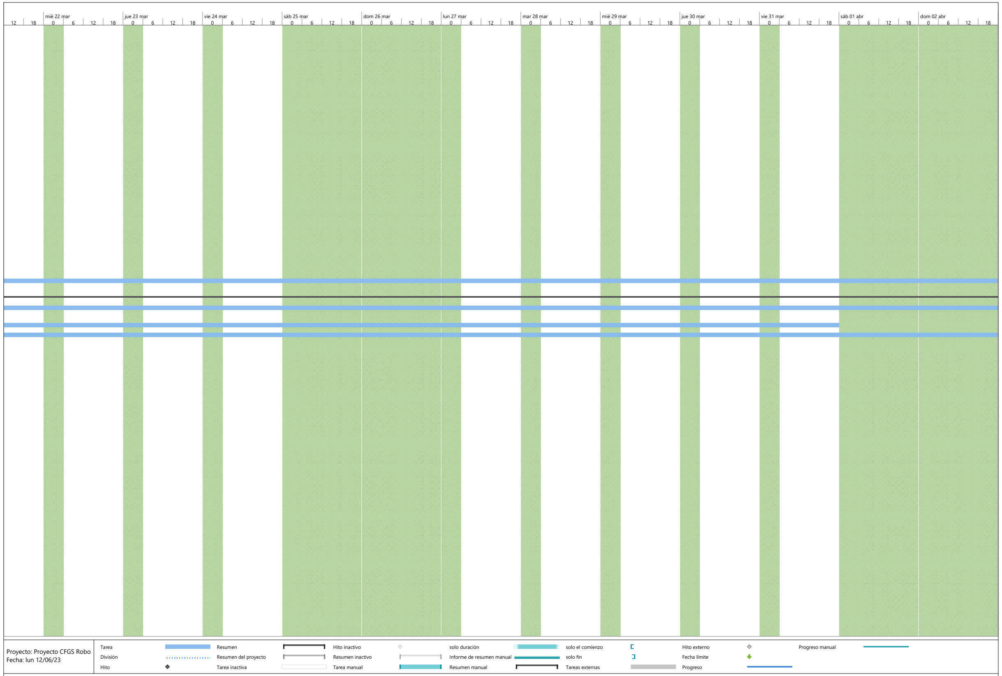
[picture p58: figure]
mié 22 mar; jue 23 mar; vie 24 mar; sáb 25 mar; dom 26 mar; lun 27 mar; mar 28 mar; mié 29 mar; jue 30 mar; vie 31 mar; sáb 01 abr; dom 02 abr; Tarea; Resumen; Hito inactivo; solo duración; solo el comienzo; Hito externo; Progreso manual; Proyecto: Proyecto CFGS Robo

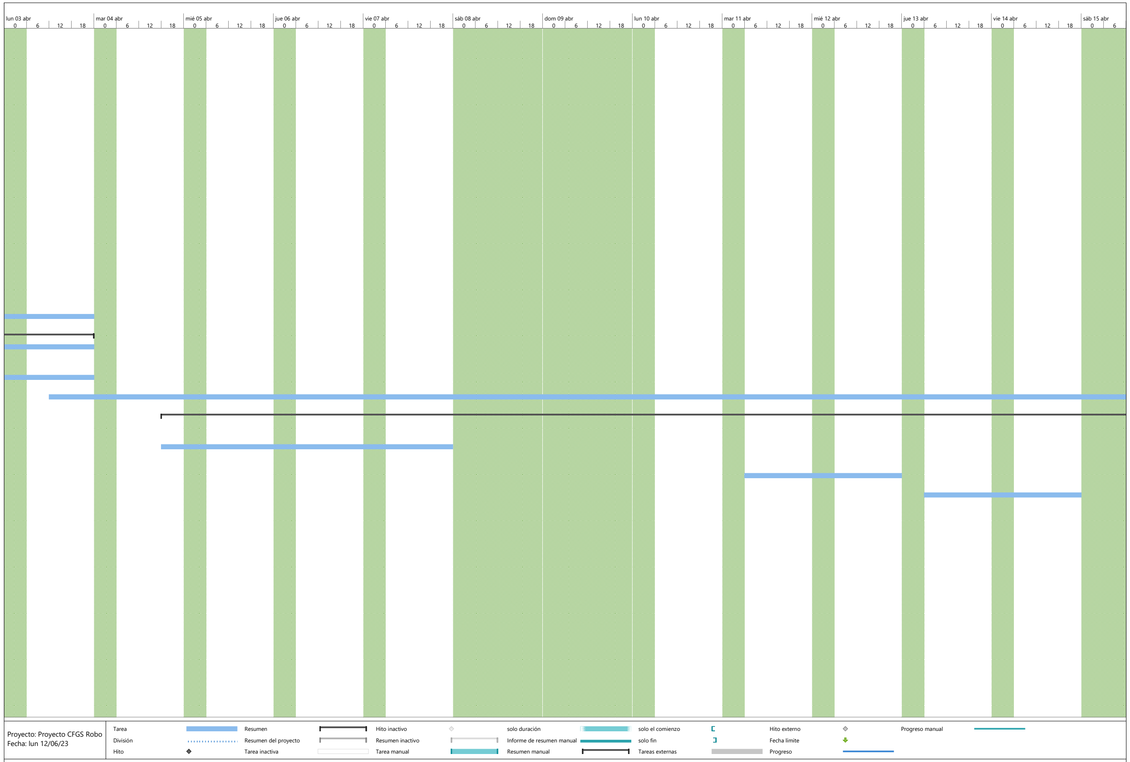
[picture p59: figure]
lun 03 abr; mar 04 abr; mié 05 abr; jue 06 abr; vie 07 abr; sáb 08 abr; dom 09 abr; lun 10 abr; mar 11 abr; mié 12 abr; jue 13 abr; vie 14 abr; sáb 15 abr; Tarea; Resumen; Hito inactivo; solo duración; solo el comienzo; Hito externo; Progreso manual; Proyecto: Proyecto CFGS Robo

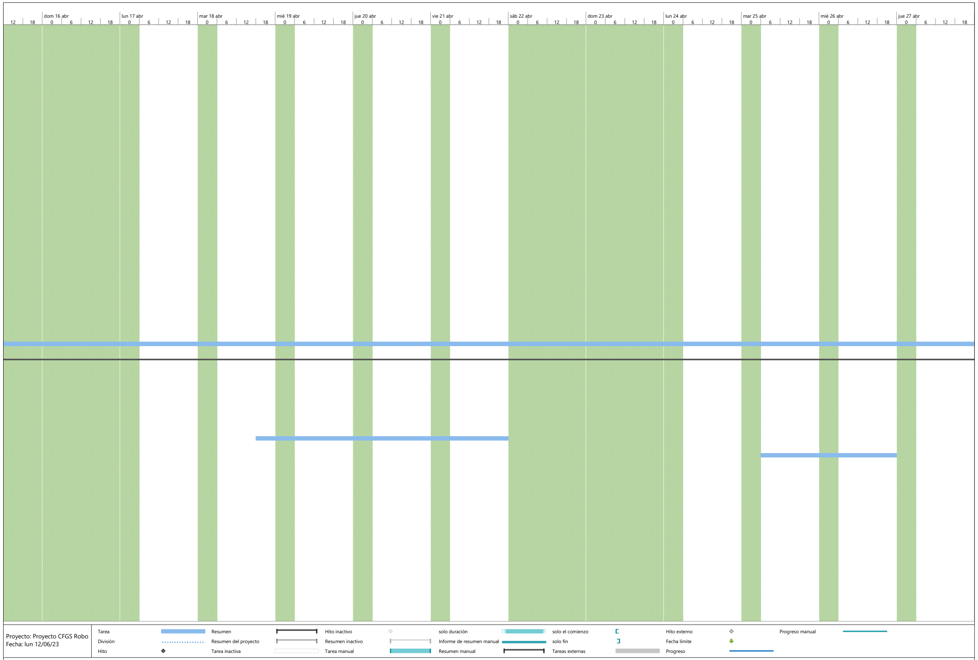
[picture p60: figure]
dom 16 abr; lun 17 abr; mar 18 abr; mié 19 abr; jue 20 abr; vie 21 abr; sáb 22 abr; dom 23 abr; lun 24 abr; mar 25 abr; mié 26 abr; jue 27 abr; Tarea; Resumen; Hito inactivo; solo duración; solo el comienzo; Hito externo; Progreso manual; Proyecto: Proyecto CFGS Robo

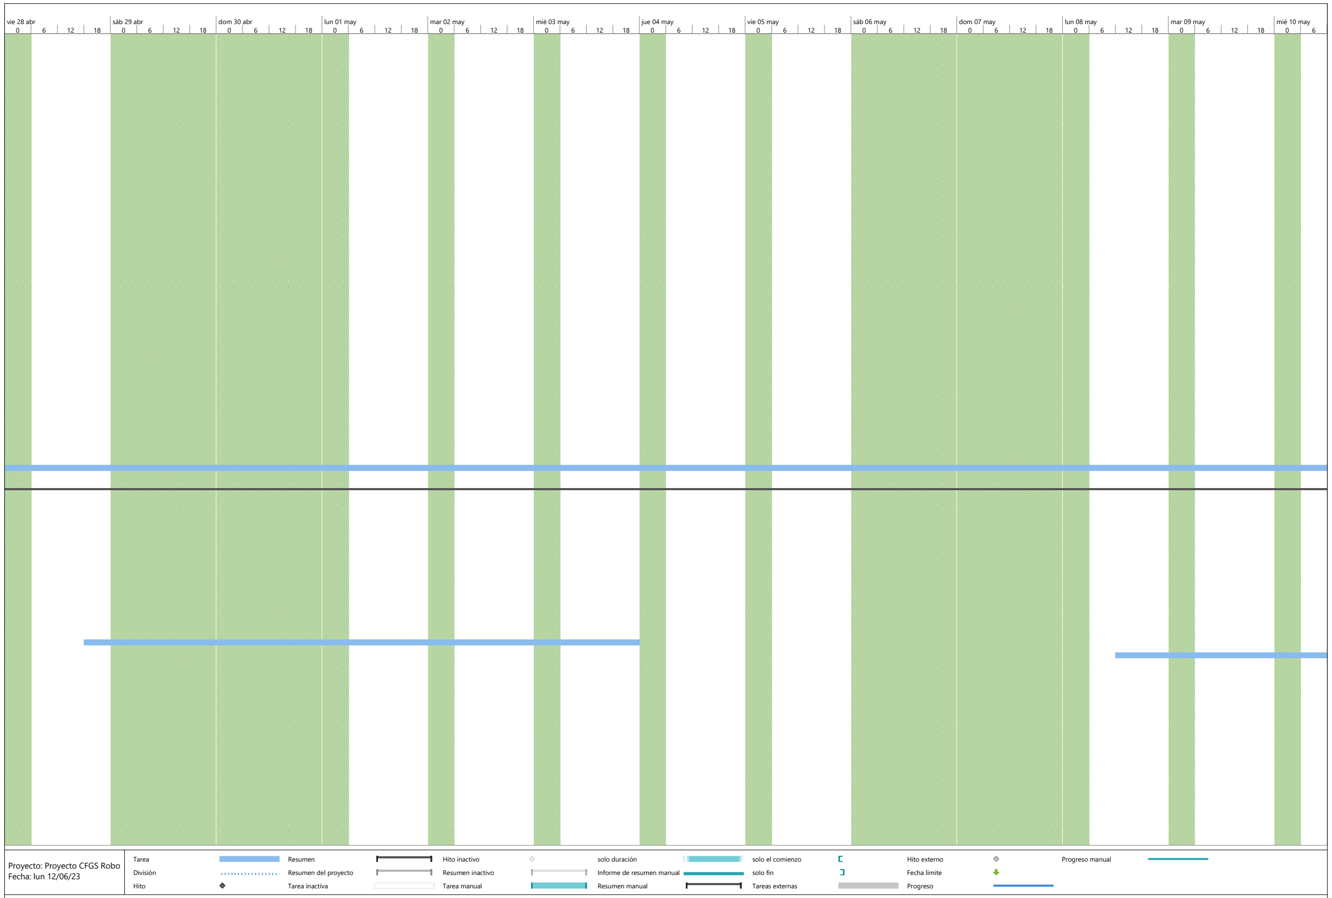
[picture p61: figure]
vie 28 abr; sáb 29 abr; dom 30 abr; lun 01 may; mar 02 may; mié 03 may; jue 04 may; vie 05 may; sáb 06 may; dom 07 may; lun 08 may; mar 09 may; mié 10 may; Tarea; Resumen; Hito inactivo; solo duración; solo el comienzo; Hito externo; Progreso manual; Proyecto: Proyecto CFGS Robo

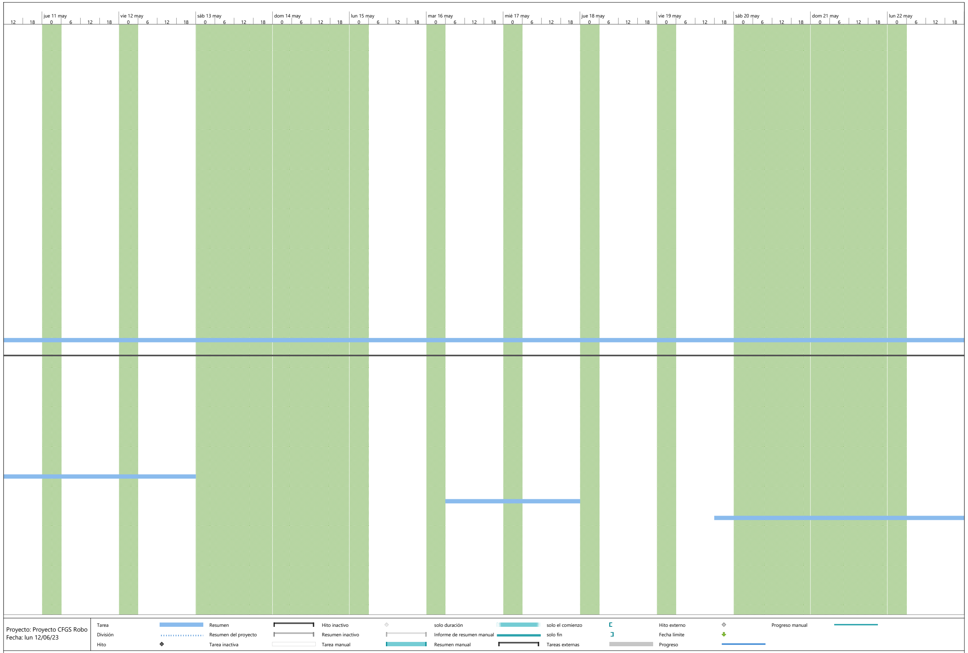
[picture p62: figure]
jue 11 may; vie 12 may; sáb 13 may; dom 14 may; lun 15 may; mar 16 may; mié 17 may; jue 18 may; vie 19 may; sáb 20 may; dom 21 may; lun 22 may; Tarea; Resumen; Hito inactivo; solo duración; solo el comienzo; Hito externo; Progreso manual; Proyecto: Proyecto CFGS Robo

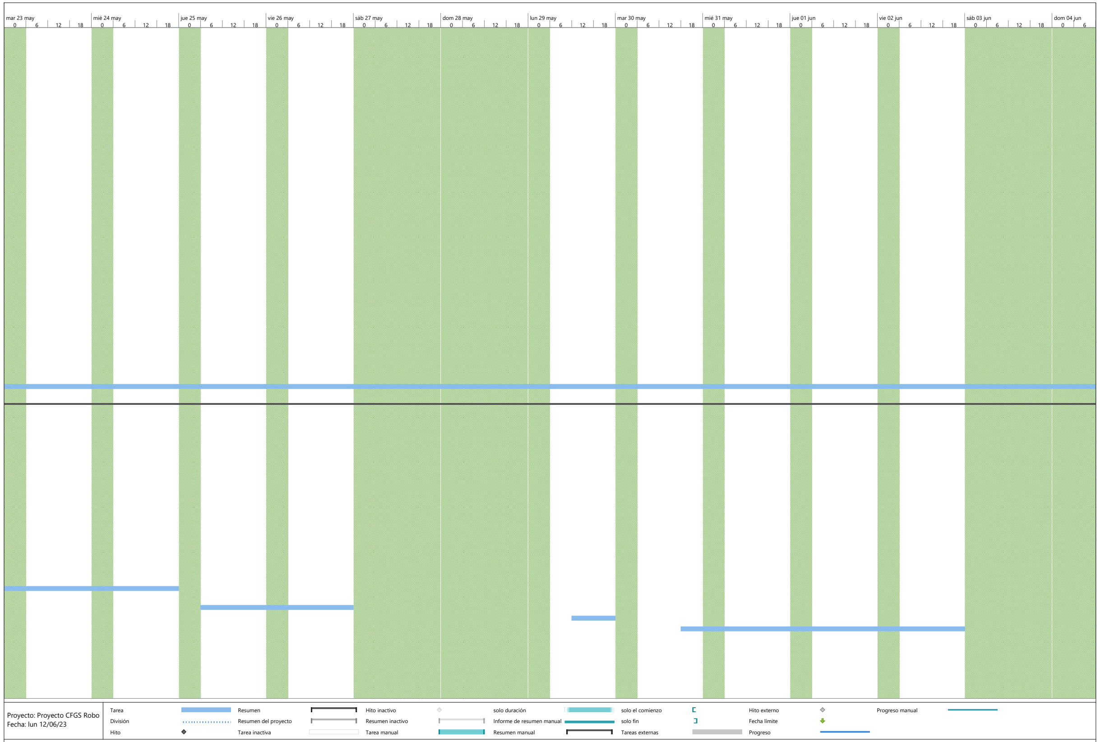
[picture p63: figure]
mar 23 may; mié 24 may; jue 25 may; vie 26 may; sáb 27 may; dom 28 may; lun 29 may; mar 30 may; mié 31 may; jue 01 jun; vie 02 jun; sáb 03 jun; dom 04 jun; Tarea; Resumen; Hito inactivo; solo duración; solo el comienzo; Hito externo; Progreso manual; Proyecto: Proyecto CFGS Robo

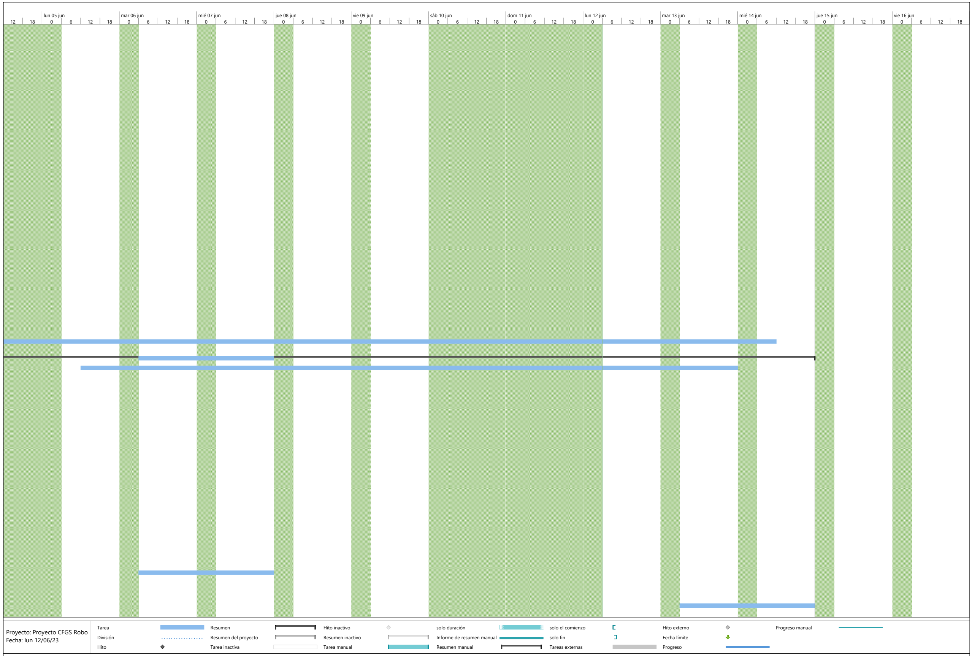
[picture p64: figure]
lun 05 jun; mar 06 jun; mié 07 jun; jue 08 jun; vie 09 jun; sáb 10 jun; dom 11 jun; lun 12 jun; mar 13 jun; mié 14 jun; jue 15 jun; vie 16 jun; Tarea; Resumen; Hito inactivo; solo duración; solo el comienzo; Hito externo; Progreso manual; Proyecto: Proyecto CFGS Robo
