josegd98/MaquinaVending/Diseny 3D, planos i STL/Planols 2D/Tots els Plans 2D/0 Maquina Vending.pdf

B B

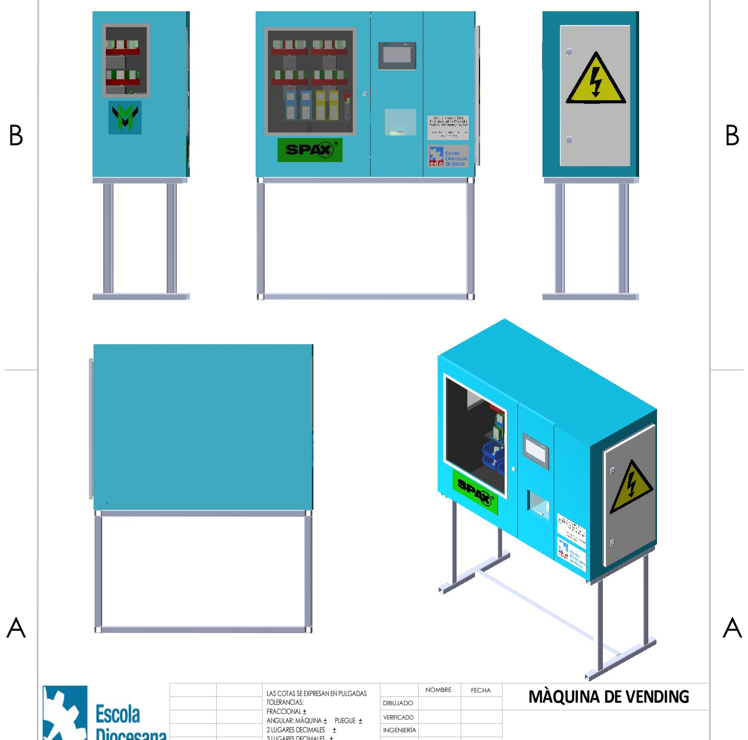
[picture p65: page 1]

A A

| NOMBRE | FECHA LAS COTAS SE EXPRESAN EN PULGADAS

DIBUJADO

INGENIERÍA VERIFICADO

TOLERANCIAS: FRACCIONAL ANGULAR: MÁQUINA | PLIEGUE 2 LUGARES DECIMALES 3 LUGARES DECIMALES | MÀQUINA DE VENDING
