josegd98/MaquinaVending/Diseny 3D, planos i STL/Renders/Renders V4/5.JPG

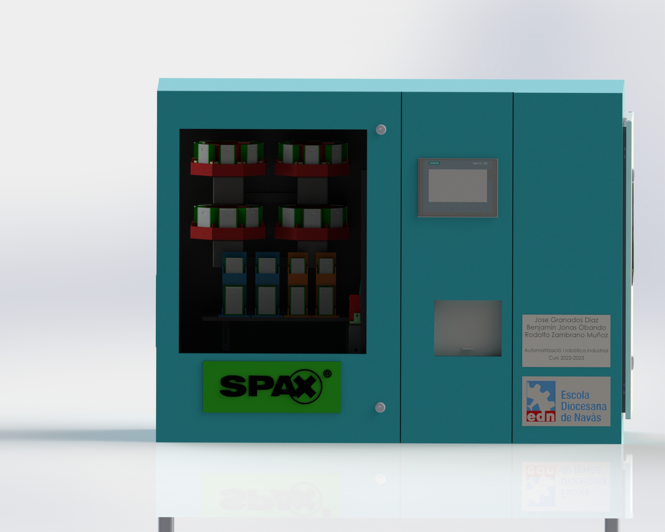
Diseny 3D, planos i STL/Renders/Renders V4/5.JPG
