josegd98/MaquinaVending/Diseny 3D, planos i STL/Renders/Renders V5 FInal/15.JPG

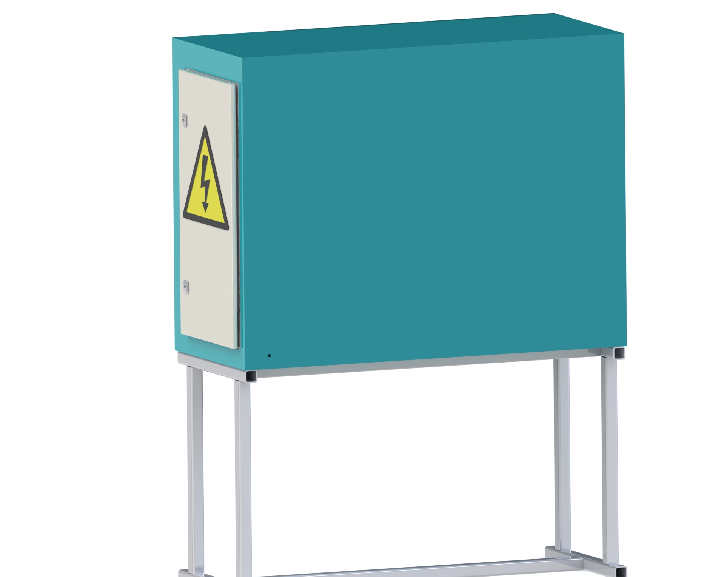
Diseny 3D, planos i STL/Renders/Renders V5 FInal/15.JPG
