josegd98/MaquinaVending/Documentació Projecte/Entradas i Sortides PLC.xlsx

Name | Path | Data Type | Logical Address | Comment | Hmi Visible | Hmi Accessible | Hmi Writeable
0 | Standard-Variablentabelle | Bool | %I0.0 |  | True | True | True | %I0.0 | I0.0 | Encoder_A | : | I0.0 : Encoder_A | 0 | PLC_INPUTS_ | PLC_INPUTS_ I0.0
1 | Standard-Variablentabelle | Bool | %I0.1 |  | True | True | True | %I0.1 | I0.1 | Encoder_B |  | I0.1 : Encoder_B | 1 | PLC_INPUTS_ | PLC_INPUTS_ I0.1
2 | Standard-Variablentabelle | Bool | %I0.2 |  | True | True | True | %I0.2 | I0.2 | FC_Inicio_X |  | I0.2 : FC_Inicio_X | 2 | PLC_INPUTS_ | PLC_INPUTS_ I0.2
3 | Standard-Variablentabelle | Bool | %I0.3 |  | True | True | True | %I0.3 | I0.3 | FC_Final_X |  | I0.3 : FC_Final_X | 3 | PLC_INPUTS_ | PLC_INPUTS_ I0.3
4 | Standard-Variablentabelle | Bool | %I0.4 |  | True | True | True | %I0.4 | I0.4 | FC_Inicio_Y |  | I0.4 : FC_Inicio_Y | 4 | PLC_INPUTS_ | PLC_INPUTS_ I0.4
5 | Standard-Variablentabelle | Bool | %I0.5 |  | True | True | True | %I0.5 | I0.5 | FC_Final_Y |  | I0.5 : FC_Final_Y | 5 | PLC_INPUTS_ | PLC_INPUTS_ I0.5
6 | Standard-Variablentabelle | Bool | %I0.6 |  | True | True | True | %I0.6 | I0.6 | FC_Inicio_Z |  | I0.6 : FC_Inicio_Z | 6 | PLC_INPUTS_ | PLC_INPUTS_ I0.6
7 | Standard-Variablentabelle | Bool | %I0.7 |  | True | True | True | %I0.7 | I0.7 | FC_Final_Z |  | I0.7 : FC_Final_Z | 7 | PLC_INPUTS_ | PLC_INPUTS_ I0.7
8 | Standard-Variablentabelle | Bool | %I1.0 |  | True | True | True | %I1.0 | I1.0 | S_Home_X |  | I1.0 : S_Home_X | 8 | PLC_INPUTS_ | PLC_INPUTS_ I1.0
9 | Standard-Variablentabelle | Bool | %I1.1 |  | True | True | True | %I1.1 | I1.1 | S_Home_Y |  | I1.1 : S_Home_Y | 9 | PLC_INPUTS_ | PLC_INPUTS_ I1.1
10 | Standard-Variablentabelle | Bool | %I1.2 |  | True | True | True | %I1.2 | I1.2 | FC_Pinza_Open |  | I1.2 : FC_Pinza_Open | 10 | PLC_INPUTS_ | PLC_INPUTS_ I1.2
11 | Standard-Variablentabelle | Bool | %I1.3 |  | True | True | True | %I1.3 | I1.3 | FC_Pinza_Close |  | I1.3 : FC_Pinza_Close | 11 | PLC_INPUTS_ | PLC_INPUTS_ I1.3
12 | Standard-Variablentabelle | Bool | %I1.4 |  | True | True | True | %I1.4 | I1.4 | FC_Puerta_Pincipal |  | I1.4 : FC_Puerta_Pincipal | 12 | PLC_INPUTS_ | PLC_INPUTS_ I1.4
13 | Standard-Variablentabelle | Bool | %I1.5 |  | True | True | True | %I1.5 | I1.5 | FC_Puerta_Producto |  | I1.5 : FC_Puerta_Producto | 13 | PLC_INPUTS_ | PLC_INPUTS_ I1.5
14 | Standard-Variablentabelle | Bool | %I1.6 |  | True | True | True | %I1.6 | I1.6 | RESERVA |  | I1.6 : RESERVA | 14 | ET_INPUTS_ | ET_INPUTS_ I1.6
15 | Standard-Variablentabelle | Bool | %I1.7 |  | True | True | True | %I1.7 | I1.7 | RESERVA |  | I1.7 : RESERVA | 15 | ET_INPUTS_ | ET_INPUTS_ I1.7
16 | Standard-Variablentabelle | Bool | %I2.0 |  | True | True | True | %I2.0 | I2.0 | S_Home_Estanteria_1 |  | I2.0 : S_Home_Estanteria_1 | 0 | ET_INPUTS_ | ET_INPUTS_ I2.0
17 | Standard-Variablentabelle | Bool | %I2.1 |  | True | True | True | %I2.1 | I2.1 | S_Pos_Estanteria_1 |  | I2.1 : S_Pos_Estanteria_1 | 1 | ET_INPUTS_ | ET_INPUTS_ I2.1
18 | Standard-Variablentabelle | Bool | %I2.2 |  | True | True | True | %I2.2 | I2.2 | S_Home_Estanteria_2 |  | I2.2 : S_Home_Estanteria_2 | 2 | ET_INPUTS_ | ET_INPUTS_ I2.2
19 | Standard-Variablentabelle | Bool | %I2.3 |  | True | True | True | %I2.3 | I2.3 | S_Pos_Estanteria_2 |  | I2.3 : S_Pos_Estanteria_2 | 3 | ET_INPUTS_ | ET_INPUTS_ I2.3
20 | Standard-Variablentabelle | Bool | %I2.4 |  | True | True | True | %I2.4 | I2.4 | S_Home_Estanteria_3 |  | I2.4 : S_Home_Estanteria_3 | 4 | ET_INPUTS_ | ET_INPUTS_ I2.4
21 | Standard-Variablentabelle | Bool | %I2.5 |  | True | True | True | %I2.5 | I2.5 | S_Pos_Estanteria_3 |  | I2.5 : S_Pos_Estanteria_3 | 5 | ET_INPUTS_ | ET_INPUTS_ I2.5
22 | Standard-Variablentabelle | Bool | %I2.6 |  | True | True | True | %I2.6 | I2.6 | S_Home_Estanteria_4 |  | I2.6 : S_Home_Estanteria_4 | 6 | ET_INPUTS_ | ET_INPUTS_ I2.6
23 | Standard-Variablentabelle | Bool | %I2.7 |  | True | True | True | %I2.7 | I2.7 | S_Pos_Estanteria_4 |  | I2.7 : S_Pos_Estanteria_4 | 7 | ET_INPUTS_ | ET_INPUTS_ I2.7
24 | Standard-Variablentabelle | Bool | %I3.0 |  | True | True | True | %I3.0 | I3.0 | S_Ramp_Product |  | I3.0 : S_Ramp_Product | 8 | ET_INPUTS_ | ET_INPUTS_ I3.0
25 | Standard-Variablentabelle | Bool | %I3.1 |  | True | True | True | %I3.1 | I3.1 | S_Check_Product |  | I3.1 : S_Check_Product | 9 | ET_INPUTS_ | ET_INPUTS_ I3.1
26 | Standard-Variablentabelle | Bool | %I3.2 |  | True | True | True | %I3.2 | I3.2 | RESERVA |  | I3.2 : RESERVA | 10 | ET_INPUTS_ | ET_INPUTS_ I3.2
27 | Standard-Variablentabelle | Bool | %I3.3 |  | True | True | True | %I3.3 | I3.3 | RESERVA |  | I3.3 : RESERVA | 11 | ET_INPUTS_ | ET_INPUTS_ I3.3
28 | Standard-Variablentabelle | Bool | %I3.4 |  | True | True | True | %I3.4 | I3.4 | RESERVA |  | I3.4 : RESERVA | 12 | ET_INPUTS_ | ET_INPUTS_ I3.4
29 | Standard-Variablentabelle | Bool | %I3.5 |  | True | True | True | %I3.5 | I3.5 | RESERVA |  | I3.5 : RESERVA | 13 | ET_INPUTS_ | ET_INPUTS_ I3.5
30 | Standard-Variablentabelle | Bool | %I3.6 |  | True | True | True | %I3.6 | I3.6 | RESERVA |  | I3.6 : RESERVA | 14 | ET_INPUTS_ | ET_INPUTS_ I3.6
31 | Standard-Variablentabelle | Bool | %I3.7 |  | True | True | True | %I3.7 | I3.7 | RESERVA |  | I3.7 : RESERVA | 15 | ET_INPUTS_ | ET_INPUTS_ I3.7
32 | Standard-Variablentabelle | Bool | %I4.0 |  | True | True | True | %I4.0 | I4.0 | RESERVA |  | I4.0 : RESERVA | 0 | ET_INPUTS_ | ET_INPUTS_ I4.0
33 | Standard-Variablentabelle | Bool | %I4.1 |  | True | True | True | %I4.1 | I4.1 | RESERVA |  | I4.1 : RESERVA | 1 | ET_INPUTS_ | ET_INPUTS_ I4.1
34 | Standard-Variablentabelle | Bool | %I4.2 |  | True | True | True | %I4.2 | I4.2 | RESERVA |  | I4.2 : RESERVA | 2 | ET_INPUTS_ | ET_INPUTS_ I4.2
35 | Standard-Variablentabelle | Bool | %I4.3 |  | True | True | True | %I4.3 | I4.3 | RESERVA |  | I4.3 : RESERVA | 3 | ET_INPUTS_ | ET_INPUTS_ I4.3
36 | Standard-Variablentabelle | Bool | %I4.4 |  | True | True | True | %I4.4 | I4.4 | RESERVA |  | I4.4 : RESERVA | 4 | ET_INPUTS_ | ET_INPUTS_ I4.4
37 | Standard-Variablentabelle | Bool | %I4.5 |  | True | True | True | %I4.5 | I4.5 | RESERVA |  | I4.5 : RESERVA | 5 | ET_INPUTS_ | ET_INPUTS_ I4.5
38 | Standard-Variablentabelle | Bool | %I4.6 |  | True | True | True | %I4.6 | I4.6 | RESERVA |  | I4.6 : RESERVA | 6 | ET_INPUTS_ | ET_INPUTS_ I4.6
39 | Standard-Variablentabelle | Bool | %I4.7 |  | True | True | True | %I4.7 | I4.7 | RESERVA |  | I4.7 : RESERVA | 7 | ET_INPUTS_ | ET_INPUTS_ I4.7
40 | Standard-Variablentabelle | Bool | %I5.0 |  | True | True | True | %I5.0 | I5.0 | RESERVA |  | I5.0 : RESERVA | 8 | ET_INPUTS_ | ET_INPUTS_ I5.0
41 | Standard-Variablentabelle | Bool | %I5.1 |  | True | True | True | %I5.1 | I5.1 | RESERVA |  | I5.1 : RESERVA | 9 | ET_INPUTS_ | ET_INPUTS_ I5.1
42 | Standard-Variablentabelle | Bool | %I5.2 |  | True | True | True | %I5.2 | I5.2 | RESERVA |  | I5.2 : RESERVA | 10 | ET_INPUTS_ | ET_INPUTS_ I5.2
43 | Standard-Variablentabelle | Bool | %I5.3 |  | True | True | True | %I5.3 | I5.3 | RESERVA |  | I5.3 : RESERVA | 11 | ET_INPUTS_ | ET_INPUTS_ I5.3
44 | Standard-Variablentabelle | Bool | %I5.4 |  | True | True | True | %I5.4 | I5.4 | RESERVA |  | I5.4 : RESERVA | 12 | ET_INPUTS_ | ET_INPUTS_ I5.4
45 | Standard-Variablentabelle | Bool | %I5.5 |  | True | True | True | %I5.5 | I5.5 | RESERVA |  | I5.5 : RESERVA | 13 | ET_INPUTS_ | ET_INPUTS_ I5.5
46 | Standard-Variablentabelle | Bool | %I5.6 |  | True | True | True | %I5.6 | I5.6 | RESERVA |  | I5.6 : RESERVA | 14 | ET_INPUTS_ | ET_INPUTS_ I5.6
47 | Standard-Variablentabelle | Bool | %I5.7 |  | True | True | True | %I5.7 | I5.7 | RESERVA |  | I5.7 : RESERVA | 15 | ET_INPUTS_ | ET_INPUTS_ I5.7
48 | Standard-Variablentabelle | Bool | %I6.0 |  | True | True | True | %I6.0 | I6.0 | RESERVA |  | I6.0 : RESERVA |  | ET_INPUTS_ | ET_INPUTS_ I6.0
49 | Standard-Variablentabelle | Bool | %I6.1 |  | True | True | True | %I6.1 | I6.1 | RESERVA |  | I6.1 : RESERVA |  | ET_INPUTS_ | ET_INPUTS_ I6.1
50 | Standard-Variablentabelle | Bool | %I6.2 |  | True | True | True | %I6.2 | I6.2 | RESERVA |  | I6.2 : RESERVA |  | ET_INPUTS_ | ET_INPUTS_ I6.2
51 | Standard-Variablentabelle | Bool | %I6.3 |  | True | True | True | %I6.3 | I6.3 | RESERVA |  | I6.3 : RESERVA |  | ET_INPUTS_ | ET_INPUTS_ I6.3
52 | Standard-Variablentabelle | Bool | %I6.4 |  | True | True | True | %I6.4 | I6.4 | RESERVA |  | I6.4 : RESERVA |  | ET_INPUTS_ | ET_INPUTS_ I6.4
53 | Standard-Variablentabelle | Bool | %I6.5 |  | True | True | True | %I6.5 | I6.5 | RESERVA |  | I6.5 : RESERVA |  | ET_INPUTS_ | ET_INPUTS_ I6.5
54 | Standard-Variablentabelle | Bool | %I6.6 |  | True | True | True | %I6.6 | I6.6 | RESERVA |  | I6.6 : RESERVA |  | ET_INPUTS_ | ET_INPUTS_ I6.6
55 | Standard-Variablentabelle | Bool | %I6.7 |  | True | True | True | %I6.7 | I6.7 | RESERVA |  | I6.7 : RESERVA |  | ET_INPUTS_ | ET_INPUTS_ I6.7
56 | Standard-Variablentabelle | Bool | %I7.0 |  | True | True | True | %I7.0 | I7.0 | RESERVA |  | I7.0 : RESERVA |  | ET_INPUTS_ | ET_INPUTS_ I7.0
57 | Standard-Variablentabelle | Bool | %I7.1 |  | True | True | True | %I7.1 | I7.1 | RESERVA |  | I7.1 : RESERVA |  | ET_INPUTS_ | ET_INPUTS_ I7.1
58 | Standard-Variablentabelle | Bool | %I7.2 |  | True | True | True | %I7.2 | I7.2 | RESERVA |  | I7.2 : RESERVA |  | ET_INPUTS_ | ET_INPUTS_ I7.2
59 | Standard-Variablentabelle | Bool | %I7.3 |  | True | True | True | %I7.3 | I7.3 | RESERVA |  | I7.3 : RESERVA |  | ET_INPUTS_ | ET_INPUTS_ I7.3
60 | Standard-Variablentabelle | Bool | %I7.4 |  | True | True | True | %I7.4 | I7.4 | RESERVA |  | I7.4 : RESERVA |  | ET_INPUTS_ | ET_INPUTS_ I7.4
61 | Standard-Variablentabelle | Bool | %I7.5 |  | True | True | True | %I7.5 | I7.5 | RESERVA |  | I7.5 : RESERVA |  | ET_INPUTS_ | ET_INPUTS_ I7.5
62 | Standard-Variablentabelle | Bool | %I7.6 |  | True | True | True | %I7.6 | I7.6 | RESERVA |  | I7.6 : RESERVA |  | ET_INPUTS_ | ET_INPUTS_ I7.6
63 | Standard-Variablentabelle | Bool | %I7.7 |  | True | True | True | %I7.7 | I7.7 | RESERVA |  | I7.7 : RESERVA |  | ET_INPUTS_ | ET_INPUTS_ I7.7
 |  |  | %Q0.0 |  |  |  |  |  | Q0.0 | EJE_X_PUL |  | Q0.0 : EJE_X_PUL | PLC_OUTPUTS_ | PLC_OUTPUTS_ Q0.0
 |  |  | %Q0.1 |  |  |  |  |  | Q0.1 | EJE_Y_PUL |  | Q0.1 : EJE_Y_PUL | PLC_OUTPUTS_ | PLC_OUTPUTS_ Q0.1
 |  |  | %Q0.2 |  |  |  |  |  | Q0.2 | EJE_Z_PUL |  | Q0.2 : EJE_Z_PUL | PLC_OUTPUTS_ | PLC_OUTPUTS_ Q0.2
 |  |  | %Q0.3 |  |  |  |  |  | Q0.3 | M_Pinza_PUL |  | Q0.3 : M_Pinza_PUL | PLC_OUTPUTS_ | PLC_OUTPUTS_ Q0.3
 |  |  | %Q0.4 |  |  |  |  |  | Q0.4 | EJE_X_DIR |  | Q0.4 : EJE_X_DIR | PLC_OUTPUTS_ | PLC_OUTPUTS_ Q0.4
 |  |  | %Q0.5 |  |  |  |  |  | Q0.5 | EJE_Y_DIR |  | Q0.5 : EJE_Y_DIR | PLC_OUTPUTS_ | PLC_OUTPUTS_ Q0.5
 |  |  | %Q0.6 |  |  |  |  |  | Q0.6 | EJE_Z_DIR |  | Q0.6 : EJE_Z_DIR | PLC_OUTPUTS_ | PLC_OUTPUTS_ Q0.6
 |  |  | %Q0.7 |  |  |  |  |  | Q0.7 | M_Pinza_DIR1 |  | Q0.7 : M_Pinza_DIR1 | PLC_OUTPUTS_ | PLC_OUTPUTS_ Q0.7
 |  |  | %Q1.0 |  |  |  |  |  | Q1.0 | M_Pinza_DIR2 |  | Q1.0 : M_Pinza_DIR2 | ET_OUTPUTS_ | ET_OUTPUTS_ Q1.0
 |  |  | %Q1.1 |  |  |  |  |  | Q1.1 | RESERVA |  | Q1.1 : RESERVA | ET_OUTPUTS_ | ET_OUTPUTS_ Q1.1
 |  |  | %Q1.2 |  |  |  |  |  | Q1.2 | RESERVA |  | Q1.2 : RESERVA | ET_OUTPUTS_ | ET_OUTPUTS_ Q1.2
 |  |  | %Q1.3 |  |  |  |  |  | Q1.3 | RESERVA |  | Q1.3 : RESERVA | ET_OUTPUTS_ | ET_OUTPUTS_ Q1.3
 |  |  | %Q1.4 |  |  |  |  |  | Q1.4 | RESERVA |  | Q1.4 : RESERVA | ET_OUTPUTS_ | ET_OUTPUTS_ Q1.4
 |  |  | %Q1.5 |  |  |  |  |  | Q1.5 | RESERVA |  | Q1.5 : RESERVA | ET_OUTPUTS_ | ET_OUTPUTS_ Q1.5
 |  |  | %Q1.6 |  |  |  |  |  | Q1.6 | RESERVA |  | Q1.6 : RESERVA | ET_OUTPUTS_ | ET_OUTPUTS_ Q1.6
 |  |  | %Q1.7 |  |  |  |  |  | Q1.7 | RESERVA |  | Q1.7 : RESERVA | ET_OUTPUTS_ | ET_OUTPUTS_ Q1.7
 |  |  | %Q2.0 |  |  |  |  |  | Q2.0 | EJE_X_ENA |  | Q2.0 : EJE_X_ENA | ET_OUTPUTS_ | ET_OUTPUTS_ Q2.0
 |  |  | %Q2.1 |  |  |  |  |  | Q2.1 | EJE_Y_ENA |  | Q2.1 : EJE_Y_ENA | ET_OUTPUTS_ | ET_OUTPUTS_ Q2.1
 |  |  | %Q2.2 |  |  |  |  |  | Q2.2 | EJE_Z_ENA |  | Q2.2 : EJE_Z_ENA | ET_OUTPUTS_ | ET_OUTPUTS_ Q2.2
 |  |  | %Q2.3 |  |  |  |  |  | Q2.3 | Estanteria_1_DIR1 |  | Q2.3 : Estanteria_1_DIR1 | ET_OUTPUTS_ | ET_OUTPUTS_ Q2.3
 |  |  | %Q2.4 |  |  |  |  |  | Q2.4 | Estanteria_1_DIR2 |  | Q2.4 : Estanteria_1_DIR2 | ET_OUTPUTS_ | ET_OUTPUTS_ Q2.4
 |  |  | %Q2.5 |  |  |  |  |  | Q2.5 | Estanteria_2_DIR1 |  | Q2.5 : Estanteria_2_DIR1 | ET_OUTPUTS_ | ET_OUTPUTS_ Q2.5
 |  |  | %Q2.6 |  |  |  |  |  | Q2.6 | Estanteria_2_DIR2 |  | Q2.6 : Estanteria_2_DIR2 | ET_OUTPUTS_ | ET_OUTPUTS_ Q2.6
 |  |  | %Q2.7 |  |  |  |  |  | Q2.7 | Estanteria_3_DIR1 |  | Q2.7 : Estanteria_3_DIR1 | ET_OUTPUTS_ | ET_OUTPUTS_ Q2.7
 |  |  | %Q3.0 |  |  |  |  |  | Q3.0 | Estanteria_3_DIR2 |  | Q3.0 : Estanteria_3_DIR2 | ET_OUTPUTS_ | ET_OUTPUTS_ Q3.0
 |  |  | %Q3.1 |  |  |  |  |  | Q3.1 | Estanteria_4_DIR1 |  | Q3.1 : Estanteria_4_DIR1 | ET_OUTPUTS_ | ET_OUTPUTS_ Q3.1
 |  |  | %Q3.2 |  |  |  |  |  | Q3.2 | Estanteria_4_DIR2 |  | Q3.2 : Estanteria_4_DIR2 | ET_OUTPUTS_ | ET_OUTPUTS_ Q3.2
 |  |  | %Q3.3 |  |  |  |  |  | Q3.3 | RESERVA |  | Q3.3 : Luces_Maquina | ET_OUTPUTS_ | ET_OUTPUTS_ Q3.3
 |  |  | %Q3.4 |  |  |  |  |  | Q3.4 | RESERVA |  | Q3.4 : RESERVA | ET_OUTPUTS_ | ET_OUTPUTS_ Q3.4
 |  |  | %Q3.5 |  |  |  |  |  | Q3.5 | RESERVA |  | Q3.5 : RESERVA | ET_OUTPUTS_ | ET_OUTPUTS_ Q3.5
 |  |  | %Q3.6 |  |  |  |  |  | Q3.6 | RESERVA |  | Q3.6 : RESERVA | ET_OUTPUTS_ | ET_OUTPUTS_ Q3.6
 |  |  | %Q3.7 |  |  |  |  |  | Q3.7 | Luces_Maquina |  | #REF! | ET_OUTPUTS_ | ET_OUTPUTS_ Q3.7
 |  |  | %Q4.0 |  |  |  |  |  | Q4.0 |  |  |  | ET_OUTPUTS_ | ET_OUTPUTS_ Q4.0
 |  |  | %Q4.1 |  |  |  |  |  | Q4.1 |  |  |  | ET_OUTPUTS_ | ET_OUTPUTS_ Q4.1
 |  |  | %Q4.2 |  |  |  |  |  | Q4.2 |  |  |  | ET_OUTPUTS_ | ET_OUTPUTS_ Q4.2
 |  |  | %Q4.3 |  |  |  |  |  | Q4.3 |  |  |  | ET_OUTPUTS_ | ET_OUTPUTS_ Q4.3
 |  |  | %Q4.4 |  |  |  |  |  | Q4.4 |  |  |  | ET_OUTPUTS_ | ET_OUTPUTS_ Q4.4
 |  |  | %Q4.5 |  |  |  |  |  | Q4.5 |  |  |  | ET_OUTPUTS_ | ET_OUTPUTS_ Q4.5
 |  |  | %Q4.6 |  |  |  |  |  | Q4.6 |  |  |  | ET_OUTPUTS_ | ET_OUTPUTS_ Q4.6
 |  |  | %Q4.7 |  |  |  |  |  | Q4.7 |  |  |  | ET_OUTPUTS_ | ET_OUTPUTS_ Q4.7
 |  |  | %Q5.0 |  |  |  |  |  | Q5.0 |  |  |  | ET_OUTPUTS_ | ET_OUTPUTS_ Q5.0
 |  |  | %Q5.1 |  |  |  |  |  | Q5.1 |  |  |  | ET_OUTPUTS_ | ET_OUTPUTS_ Q5.1
 |  |  | %Q5.2 |  |  |  |  |  | Q5.2 |  |  |  | ET_OUTPUTS_ | ET_OUTPUTS_ Q5.2
 |  |  | %Q5.3 |  |  |  |  |  | Q5.3 |  |  |  | ET_OUTPUTS_ | ET_OUTPUTS_ Q5.3
 |  |  | %Q5.4 |  |  |  |  |  | Q5.4 |  |  |  | ET_OUTPUTS_ | ET_OUTPUTS_ Q5.4
 |  |  | %Q5.5 |  |  |  |  |  | Q5.5 |  |  |  | ET_OUTPUTS_ | ET_OUTPUTS_ Q5.5
 |  |  | %Q5.6 |  |  |  |  |  | Q5.6 |  |  |  | ET_OUTPUTS_ | ET_OUTPUTS_ Q5.6
 |  |  | %Q5.7 |  |  |  |  |  | Q5.7 |  |  |  | ET_OUTPUTS_ | ET_OUTPUTS_ Q5.7
 |  |  | %Q6.0 |  |  |  |  |  | Q6.0 |  |  |  | ET_OUTPUTS_ | ET_OUTPUTS_ Q6.0
 |  |  | %Q6.1 |  |  |  |  |  | Q6.1 |  |  |  | ET_OUTPUTS_ | ET_OUTPUTS_ Q6.1
 |  |  | %Q6.2 |  |  |  |  |  | Q6.2 |  |  |  | ET_OUTPUTS_ | ET_OUTPUTS_ Q6.2
 |  |  | %Q6.3 |  |  |  |  |  | Q6.3 |  |  |  | ET_OUTPUTS_ | ET_OUTPUTS_ Q6.3
 |  |  | %Q6.4 |  |  |  |  |  | Q6.4 |  |  |  | ET_OUTPUTS_ | ET_OUTPUTS_ Q6.4
 |  |  | %Q6.5 |  |  |  |  |  | Q6.5 |  |  |  | ET_OUTPUTS_ | ET_OUTPUTS_ Q6.5
 |  |  | %Q6.6 |  |  |  |  |  | Q6.6 |  |  |  | ET_OUTPUTS_ | ET_OUTPUTS_ Q6.6
 |  |  | %Q6.7 |  |  |  |  |  | Q6.7 |  |  |  | ET_OUTPUTS_ | ET_OUTPUTS_ Q6.7
 |  |  | %Q7.0 |  |  |  |  |  | Q7.0 |  |  |  | ET_OUTPUTS_ | ET_OUTPUTS_ Q7.0
 |  |  | %Q7.1 |  |  |  |  |  | Q7.1 |  |  |  | ET_OUTPUTS_ | ET_OUTPUTS_ Q7.1
 |  |  | %Q7.2 |  |  |  |  |  | Q7.2 |  |  |  | ET_OUTPUTS_ | ET_OUTPUTS_ Q7.2
 |  |  | %Q7.3 |  |  |  |  |  | Q7.3 |  |  |  | ET_OUTPUTS_ | ET_OUTPUTS_ Q7.3
 |  |  | %Q7.4 |  |  |  |  |  | Q7.4 |  |  |  | ET_OUTPUTS_ | ET_OUTPUTS_ Q7.4
 |  |  | %Q7.5 |  |  |  |  |  | Q7.5 |  |  |  | ET_OUTPUTS_ | ET_OUTPUTS_ Q7.5
 |  |  | %Q7.6 |  |  |  |  |  | Q7.6 |  |  |  | ET_OUTPUTS_ | ET_OUTPUTS_ Q7.6
 |  |  | %Q7.7 |  |  |  |  |  | Q7.7 |  |  |  | ET_OUTPUTS_ | ET_OUTPUTS_ Q7.7
