josegd98/MaquinaVending/Fotos i videos projecte/Imatges dels components i muntatge/IMG-20230212-WA0007.jpg

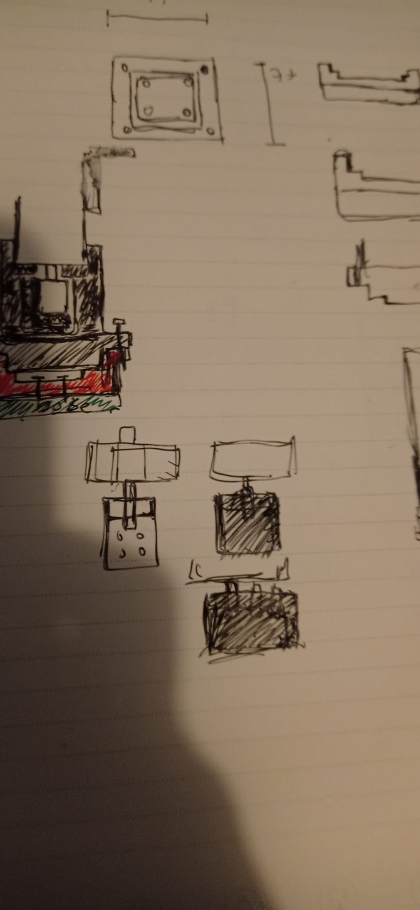
Fotos i videos projecte/Imatges dels components i muntatge/IMG-20230212-WA0007.jpg
