josegd98/MaquinaVending/Fotos i videos projecte/Imatges dels components i muntatge/IMG_20230517_132028.jpg

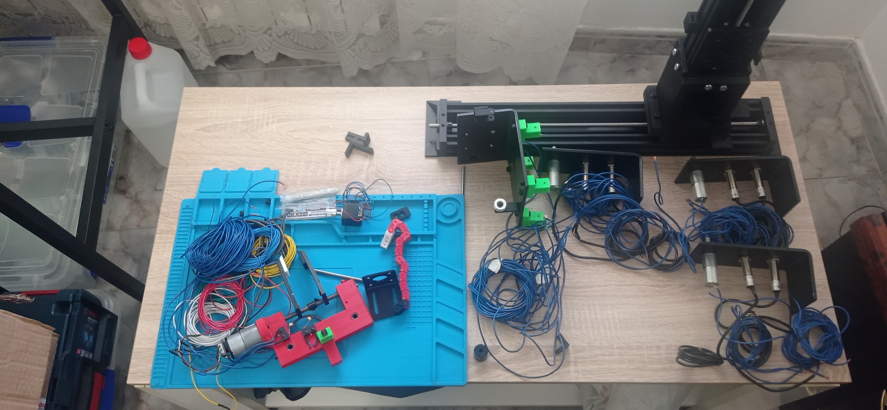
Fotos i videos projecte/Imatges dels components i muntatge/IMG_20230517_132028.jpg
