josegd98/MaquinaVending/Fotos i videos projecte/Imatges dels components i muntatge/IMG_20230526_160814.jpg

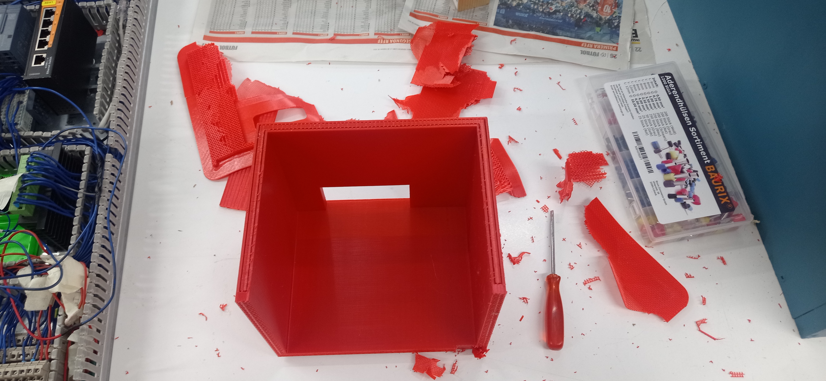
Fotos i videos projecte/Imatges dels components i muntatge/IMG_20230526_160814.jpg
