josegd98/MaquinaVending/Fotos i videos projecte/Imatges dels components i muntatge/IMG_20230530_174528.jpg

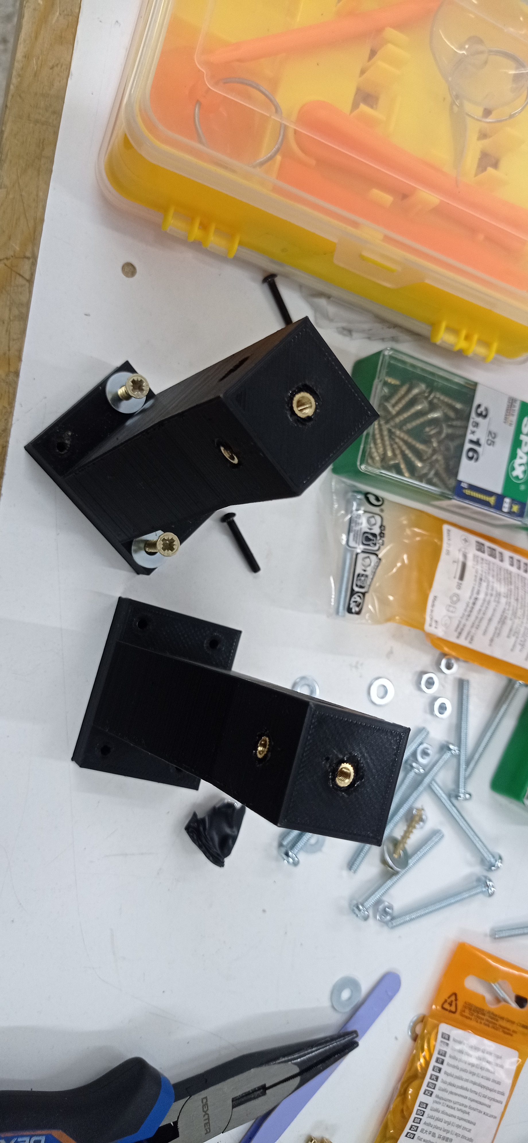
Fotos i videos projecte/Imatges dels components i muntatge/IMG_20230530_174528.jpg
