josegd98/MaquinaVending/Fotos i videos projecte/Imatges dels components i muntatge/IMG_20230530_174531.jpg

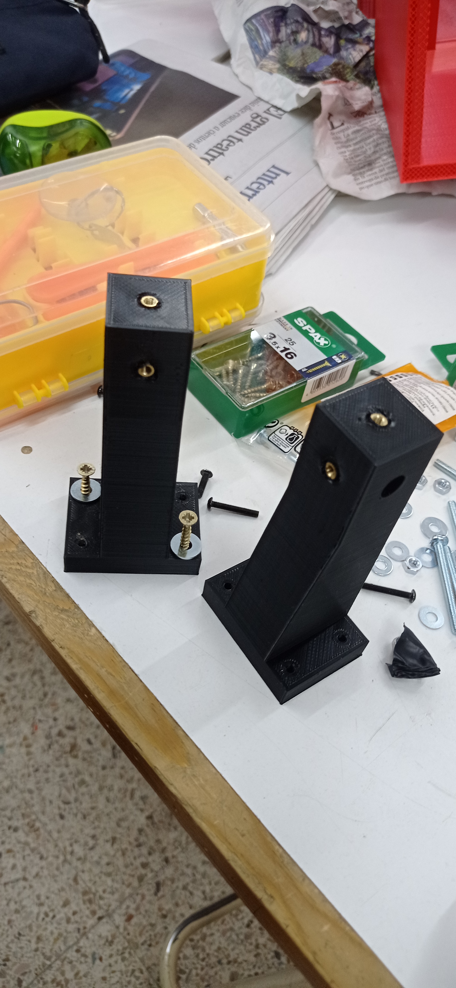
Fotos i videos projecte/Imatges dels components i muntatge/IMG_20230530_174531.jpg
