josegd98/MaquinaVending/Fotos i videos projecte/Imatges dels components i muntatge/IMG_20230530_185839.jpg

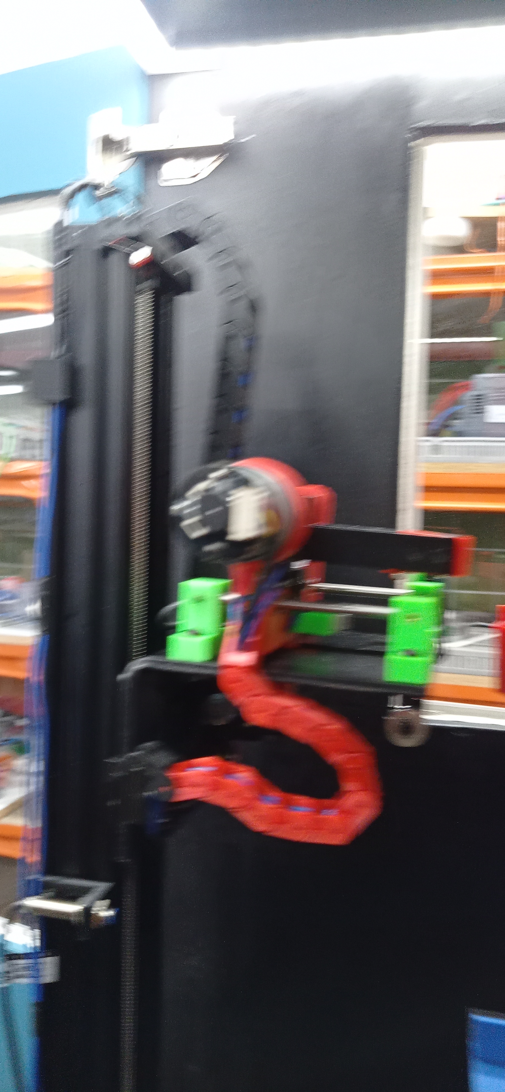
Fotos i videos projecte/Imatges dels components i muntatge/IMG_20230530_185839.jpg
