josegd98/MaquinaVending/Fotos i videos projecte/Imatges dels components i muntatge/IMG_20230530_185904.jpg

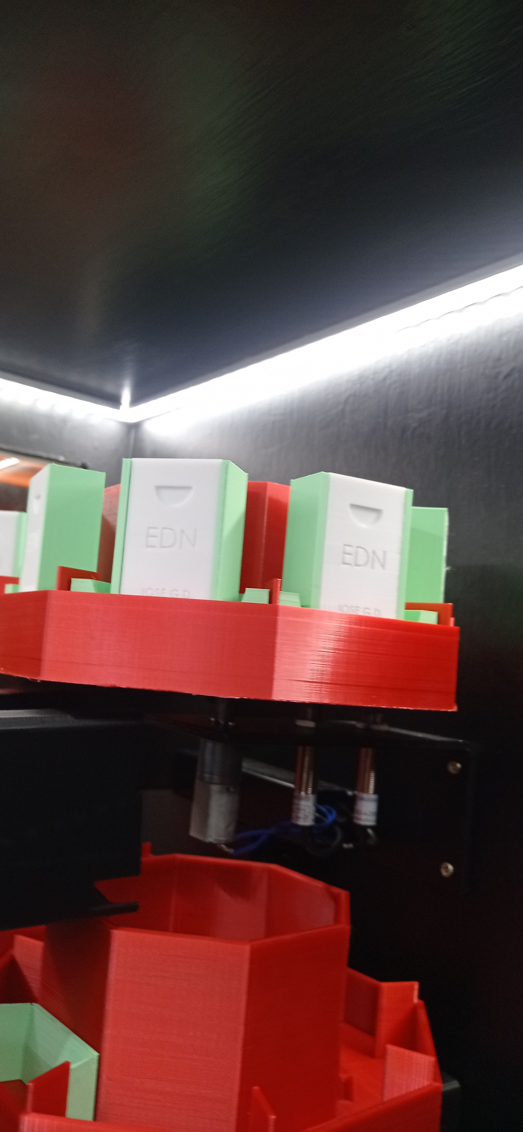
Fotos i videos projecte/Imatges dels components i muntatge/IMG_20230530_185904.jpg
