josegd98/MaquinaVending/Fotos i videos projecte/Imatges dels components i muntatge/IMG_20230530_190511.jpg

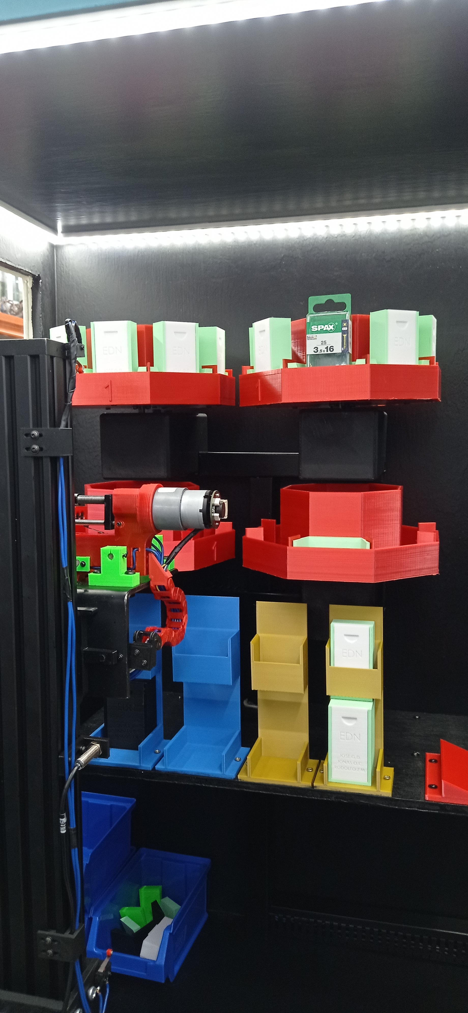
Fotos i videos projecte/Imatges dels components i muntatge/IMG_20230530_190511.jpg
