josegd98/MaquinaVending/Fotos i videos projecte/Imatges dels components i muntatge/IMG_20230531_201424.jpg

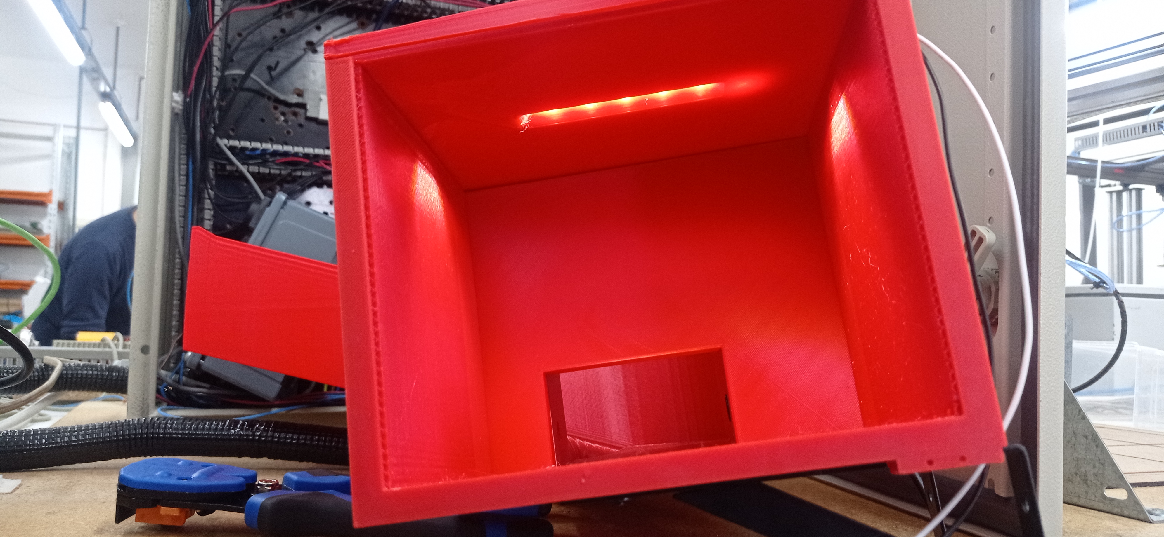
Fotos i videos projecte/Imatges dels components i muntatge/IMG_20230531_201424.jpg
