josegd98/MaquinaVending/Fotos i videos projecte/Imatges dels components i muntatge/IMG_20230601_155649.jpg

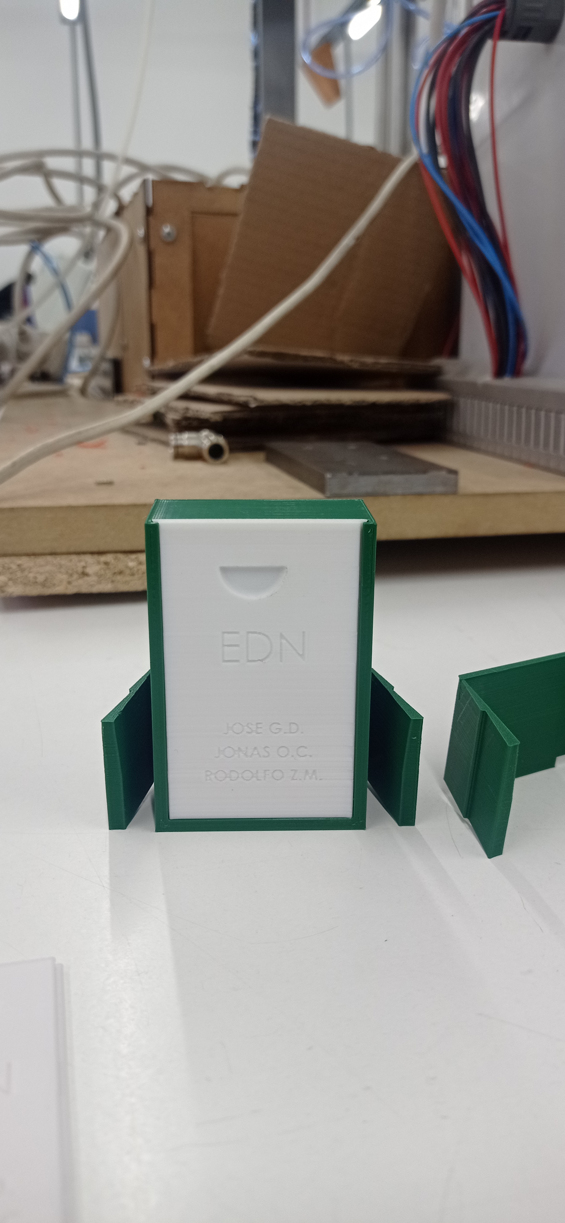
Fotos i videos projecte/Imatges dels components i muntatge/IMG_20230601_155649.jpg
