josegd98/MaquinaVending/Fotos i videos projecte/Imatges dels components i muntatge/IMG_20230601_155815.jpg

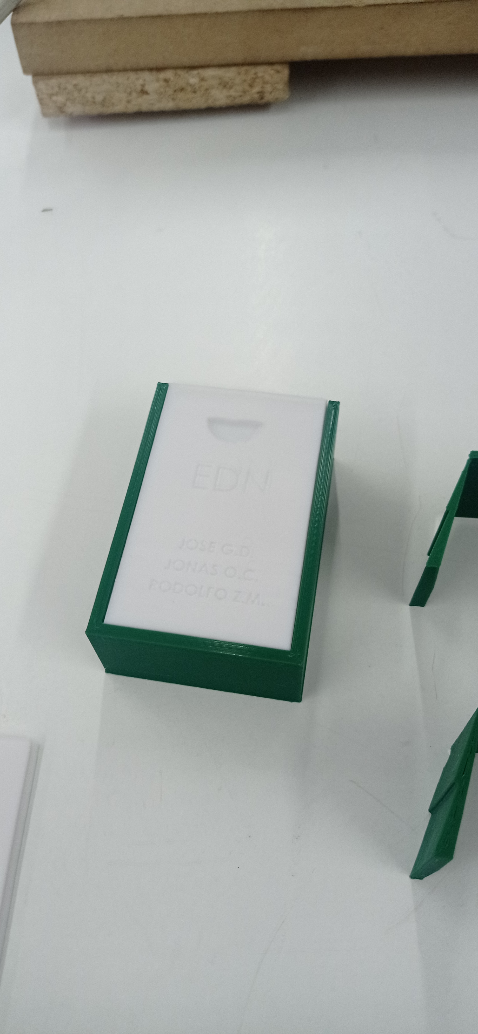
Fotos i videos projecte/Imatges dels components i muntatge/IMG_20230601_155815.jpg
