josegd98/MaquinaVending/Fotos i videos projecte/Imatges dels components i muntatge/IMG_20230602_165904.jpg

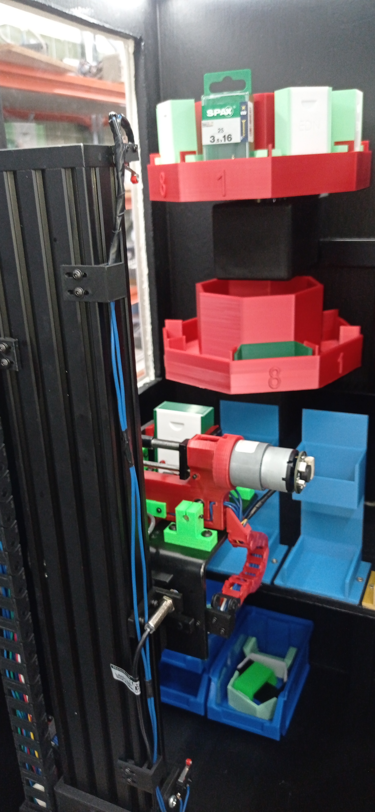
Fotos i videos projecte/Imatges dels components i muntatge/IMG_20230602_165904.jpg
