josegd98/MaquinaVending/Fotos i videos projecte/Imatges dels components i muntatge/IMG_20230602_174357.jpg

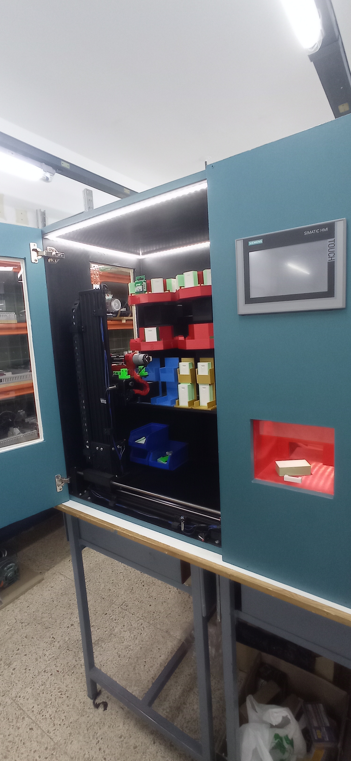
Fotos i videos projecte/Imatges dels components i muntatge/IMG_20230602_174357.jpg
