josegd98/MaquinaVending/Fotos i videos projecte/Imatges dels components i muntatge/IMG_20230604_120950.jpg

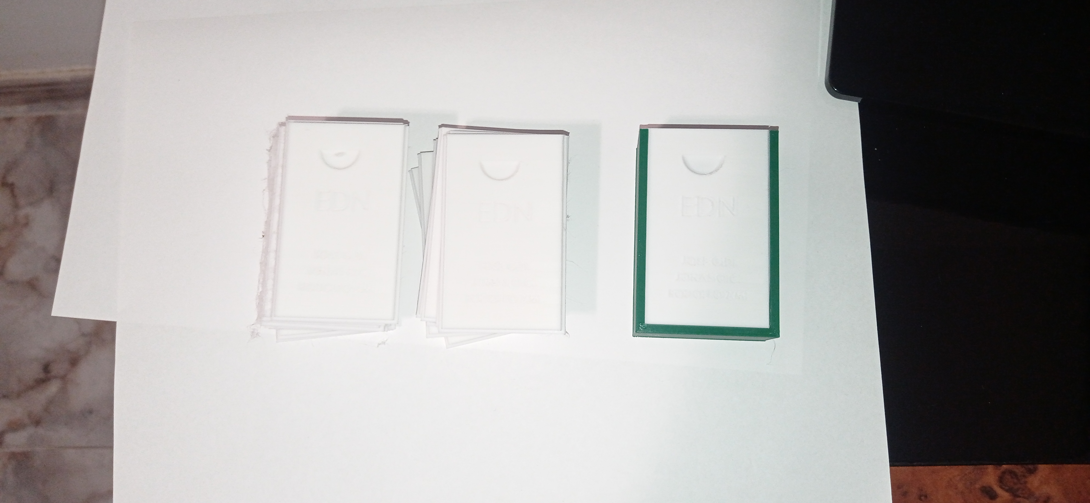
Fotos i videos projecte/Imatges dels components i muntatge/IMG_20230604_120950.jpg
