josegd98/MaquinaVending/Fotos i videos projecte/Imatges dels components i muntatge/IMG_20230609_200932.jpg

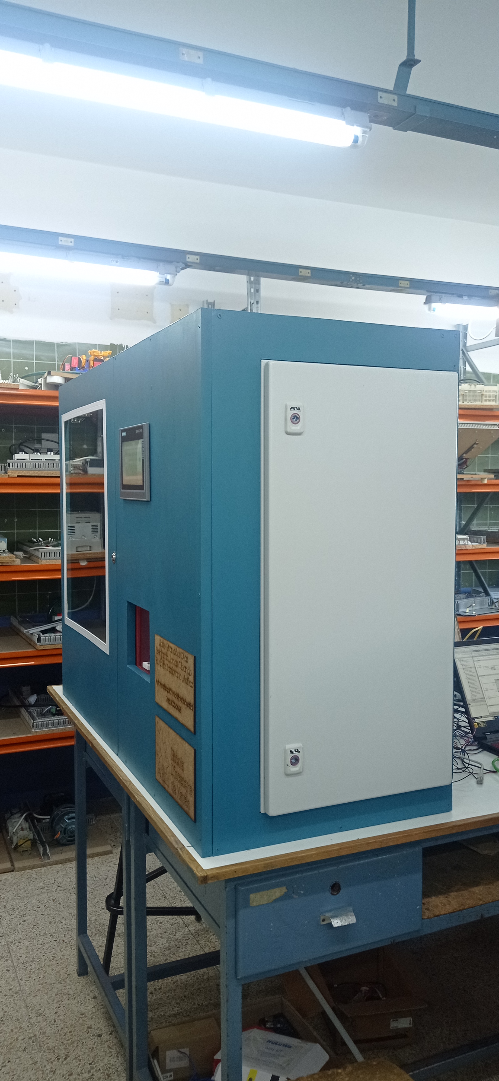
Fotos i videos projecte/Imatges dels components i muntatge/IMG_20230609_200932.jpg
