josegd98/MaquinaVending/Fotos i videos projecte/Imatges dels components i muntatge/IMG_20230609_201018.jpg

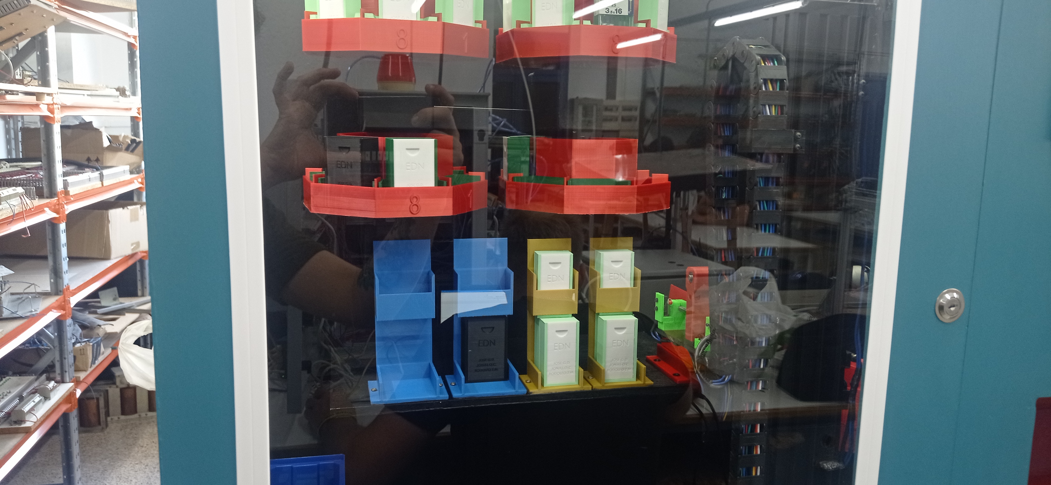
Fotos i videos projecte/Imatges dels components i muntatge/IMG_20230609_201018.jpg
