josegd98/MaquinaVending/Fotos i videos projecte/Imatges dels components i muntatge/IMG_20230611_170212.jpg

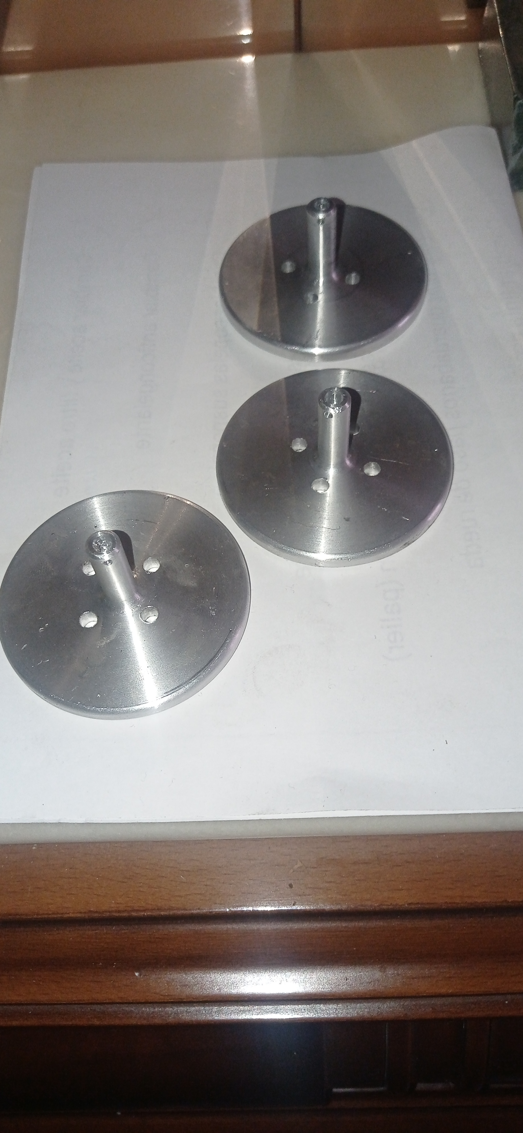
Fotos i videos projecte/Imatges dels components i muntatge/IMG_20230611_170212.jpg
