josegd98/MaquinaVending/Fotos i videos projecte/Imatges dels components i muntatge/IMG_20230611_170225.jpg

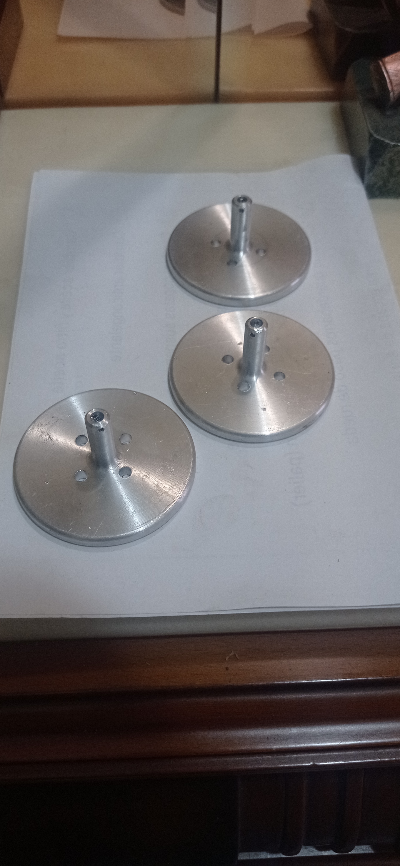
Fotos i videos projecte/Imatges dels components i muntatge/IMG_20230611_170225.jpg
