josegd98/MaquinaVending/Fotos i videos projecte/Imatges dels components i muntatge/IMG_20230611_184935.jpg

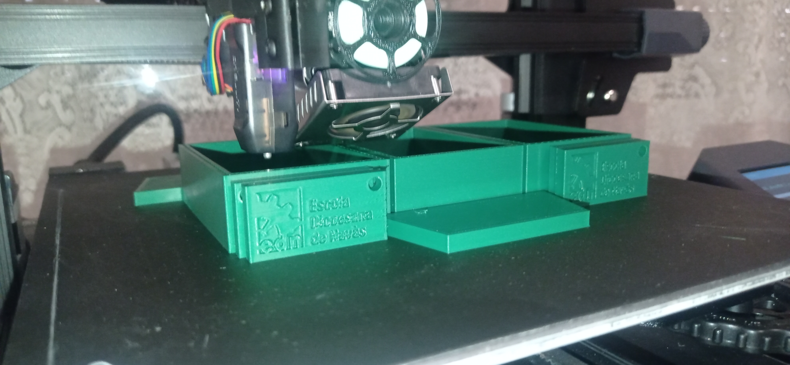
Fotos i videos projecte/Imatges dels components i muntatge/IMG_20230611_184935.jpg
