josegd98/MaquinaVending/Fotos i videos projecte/Imatges dels components i muntatge/IMG_20230612_130023.jpg

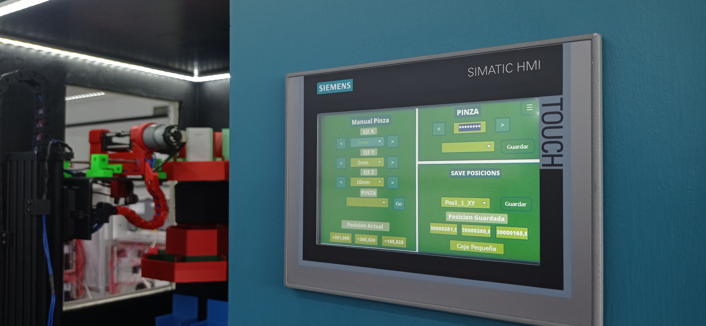
Fotos i videos projecte/Imatges dels components i muntatge/IMG_20230612_130023.jpg
