josegd98/MaquinaVending/Diseny 3D, planos i STL/Ensamblatge Maquina Vending/Ensamblatge 3D Maquina Vending/Caja Pequeña Diseño 3D.SLDASM

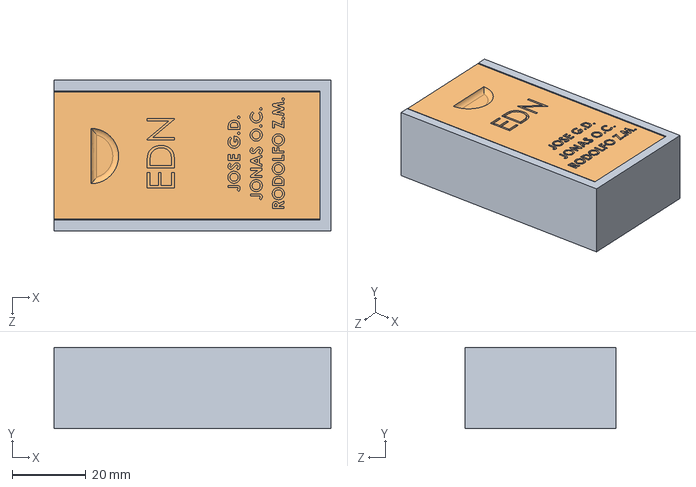
[picture p361: CAD file, 2023-06-13]
Diseny 3D, planos i STL/Ensamblatge Maquina Vending/Ensamblatge 3D Maquina Vending/Caja Pequeña Diseño 3D.SLDASM
75.0 x 22.0 x 41.0 mm
Caja de tornillos pequeña SPAX
Tapa caja pequeña
