josegd98/MaquinaVending/Diseny 3D, planos i STL/Ensamblatge Maquina Vending/Ensamblatge 3D Maquina Vending/byms721-1s-1.SLDASM

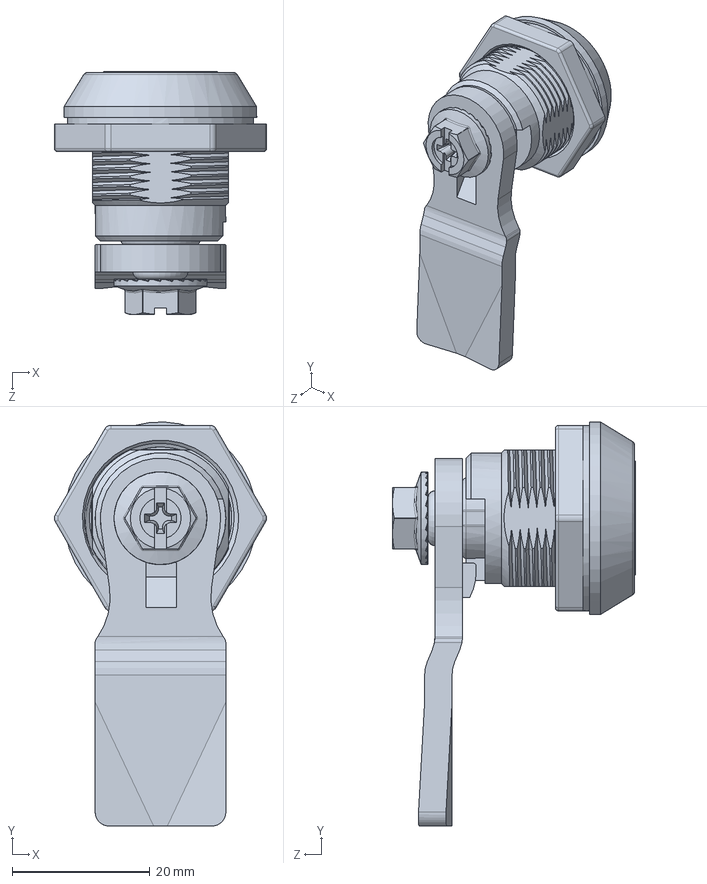
[picture p362: CAD file, 2023-06-13]
Diseny 3D, planos i STL/Ensamblatge Maquina Vending/Ensamblatge 3D Maquina Vending/byms721-1s-1.SLDASM
30.9 x 58.7 x 35.4 mm
byms721-1s-1_01
byms721-1s-1_02
byms721-1s-1_03
