josegd98/MaquinaVending/Diseny 3D, planos i STL/Ensamblatge Maquina Vending/Ensamblatge 3D Maquina Vending/Ensamblaje1.SLDASM

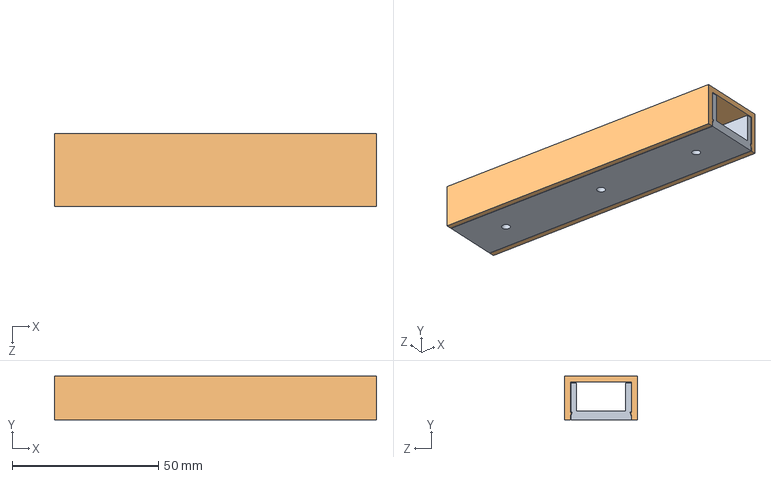
[picture p363: CAD file, 2023-06-13]
Diseny 3D, planos i STL/Ensamblatge Maquina Vending/Ensamblatge 3D Maquina Vending/Ensamblaje1.SLDASM
110.0 x 15.0 x 25.0 mm
Embellecedores cables estanterias base vertical
Embellecedores cables estanterias tapa vertical
