josegd98/MaquinaVending/Diseny 3D, planos i STL/Ensamblatge Maquina Vending/Ensamblatge 3D Maquina Vending/Conjunto embellecedor cables horitzontals.SLDASM

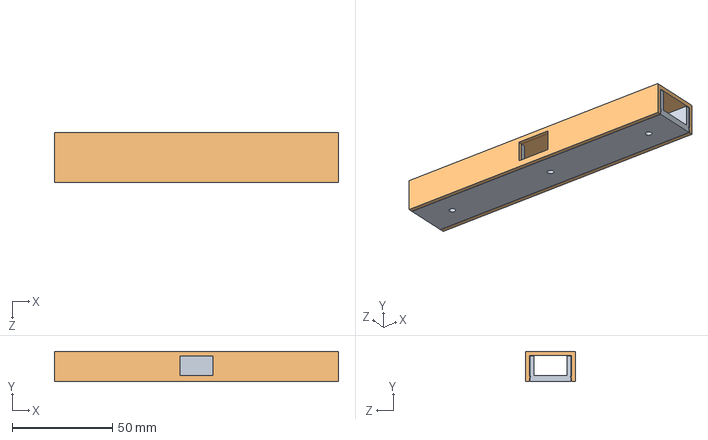
[picture p364: CAD file, 2023-06-13]
Diseny 3D, planos i STL/Ensamblatge Maquina Vending/Ensamblatge 3D Maquina Vending/Conjunto embellecedor cables horitzontals.SLDASM
142.0 x 15.0 x 25.0 mm
Embellecedores cables estanterias base
Embellecedores cables estanterias tapa
