josegd98/MaquinaVending/Diseny 3D, planos i STL/Ensamblatge Maquina Vending/Ensamblatge 3D Maquina Vending/sensor_abt12-n04i-c3y2.SLDASM

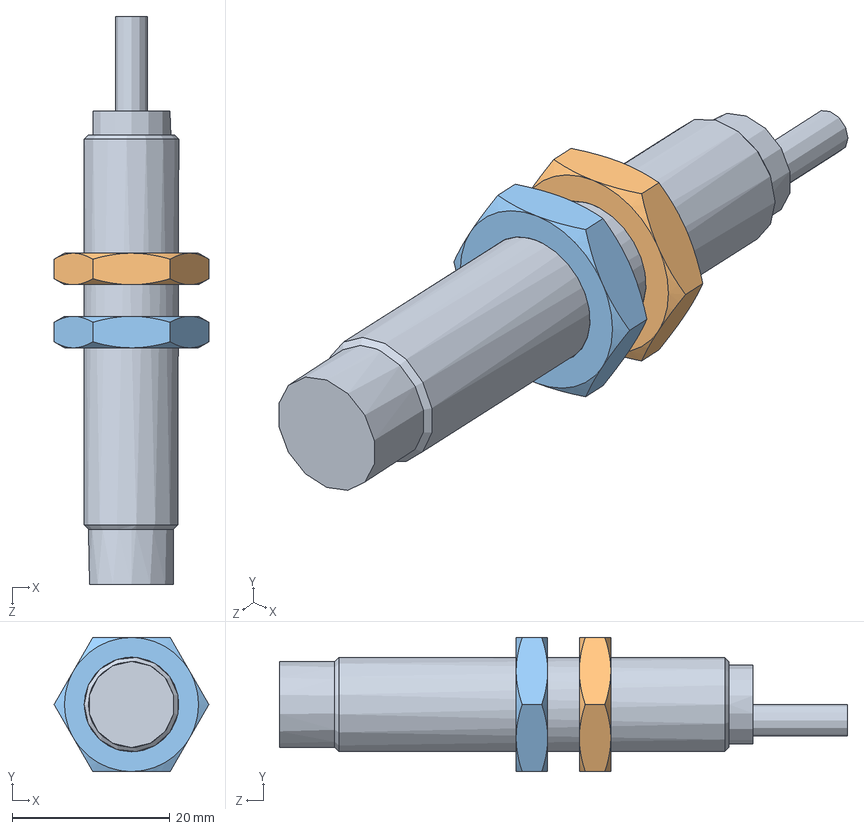
[picture p365: CAD file, 2023-06-13]
Diseny 3D, planos i STL/Ensamblatge Maquina Vending/Ensamblatge 3D Maquina Vending/sensor_abt12-n04i-c3y2.SLDASM
19.6 x 17.0 x 72.0 mm
sensor_abt12-n04i-c3y2_01
sensor_abt12-n04i-c3y2_02
sensor_abt12-n04i-c3y2_03
