josegd98/MaquinaVending/Diseny 3D, planos i STL/Ensamblatge Maquina Vending/Ensamblatge 3D Maquina Vending/canleta cables vertical .SLDASM

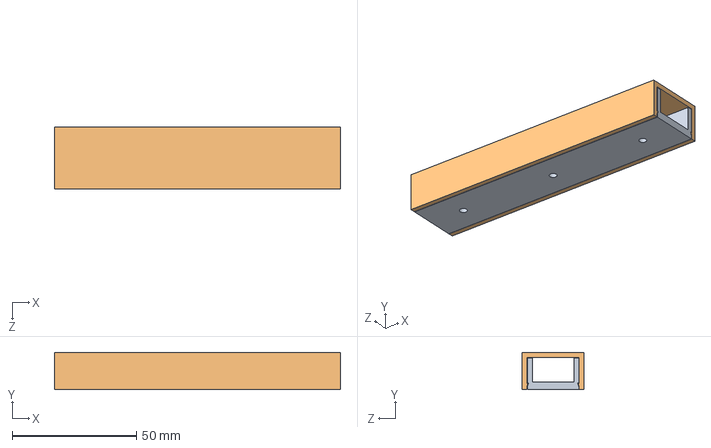
[picture p366: CAD file, 2023-06-13]
Diseny 3D, planos i STL/Ensamblatge Maquina Vending/Ensamblatge 3D Maquina Vending/canleta cables vertical .SLDASM
115.0 x 15.0 x 25.0 mm
Embellecedores cables estanterias base vertical
Embellecedores cables estanterias tapa vertical
