josegd98/MaquinaVending/Diseny 3D, planos i STL/Ensamblatge Maquina Vending/Ensamblatge 3D Maquina Vending/sensor_ibt8-s02la-d3y2.SLDASM

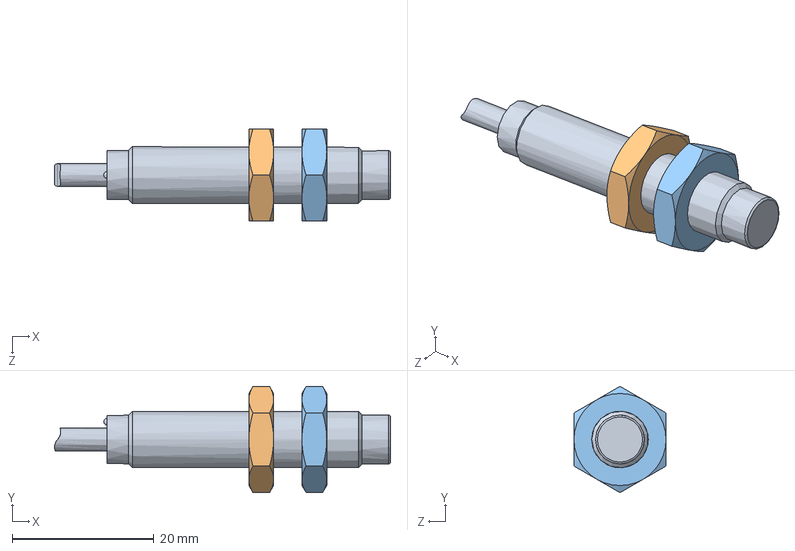
[picture p367: CAD file, 2023-06-13]
Diseny 3D, planos i STL/Ensamblatge Maquina Vending/Ensamblatge 3D Maquina Vending/sensor_ibt8-s02la-d3y2.SLDASM
47.4 x 15.0 x 13.0 mm
sensor_ibt8-s02la-d3y2_01
sensor_ibt8-s02la-d3y2_02
sensor_ibt8-s02la-d3y2_03
