josegd98/MaquinaVending/Diseny 3D, planos i STL/Ensamblatge Maquina Vending/Ensamblatge 3D Maquina Vending/Caja grande tornillos.SLDASM

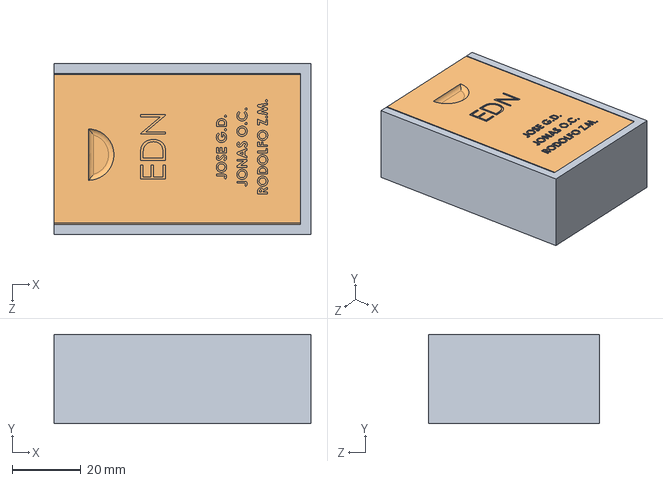
[picture p368: CAD file, 2023-06-13]
Diseny 3D, planos i STL/Ensamblatge Maquina Vending/Ensamblatge 3D Maquina Vending/Caja grande tornillos.SLDASM
75.0 x 26.0 x 50.0 mm
Caja de tornillos grande
Tapa caja grande
