josegd98/MaquinaVending/Diseny 3D, planos i STL/Ensamblatge Maquina Vending/Ensamblatge 3D Maquina Vending/JGB37-520.SLDASM

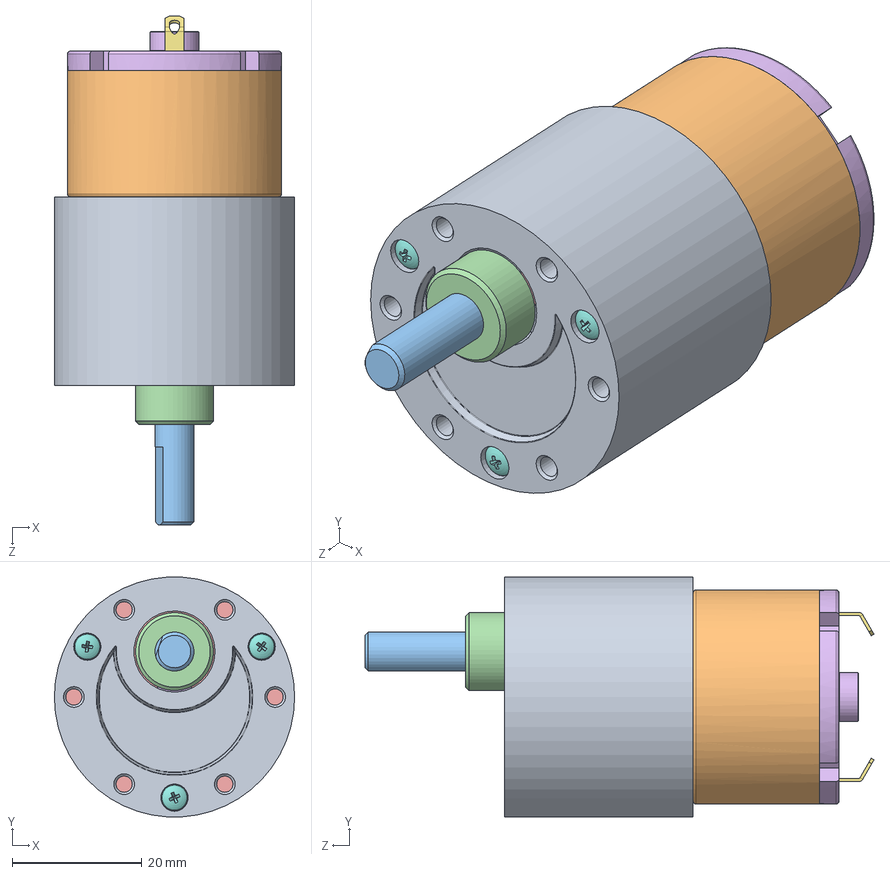
[picture p370: CAD file, 2023-06-13]
Diseny 3D, planos i STL/Ensamblatge Maquina Vending/Ensamblatge 3D Maquina Vending/JGB37-520.SLDASM
37.0 x 36.9 x 78.4 mm
GEARED BODY, MOTOR, JGB37-520
DC MOTOR, JGB37-520
MOTOR SHAFT, JGB37-520
SHAFT COUPLER, JGB37-520
COUPLING BRACKET, GEARED BODY TO DC MOTOR, JGB37-520
PLASTIC COVER, DC MOTOR, JGB37-520
CONNECTION, DC MOTOR, JGB37-520 x 2
pan cross head_am x 3
