josegd98/MaquinaVending/Diseny 3D, planos i STL/Ensamblatge Maquina Vending/Ensamblatge 3D Maquina Vending/6av21232gb030ax0.SLDASM

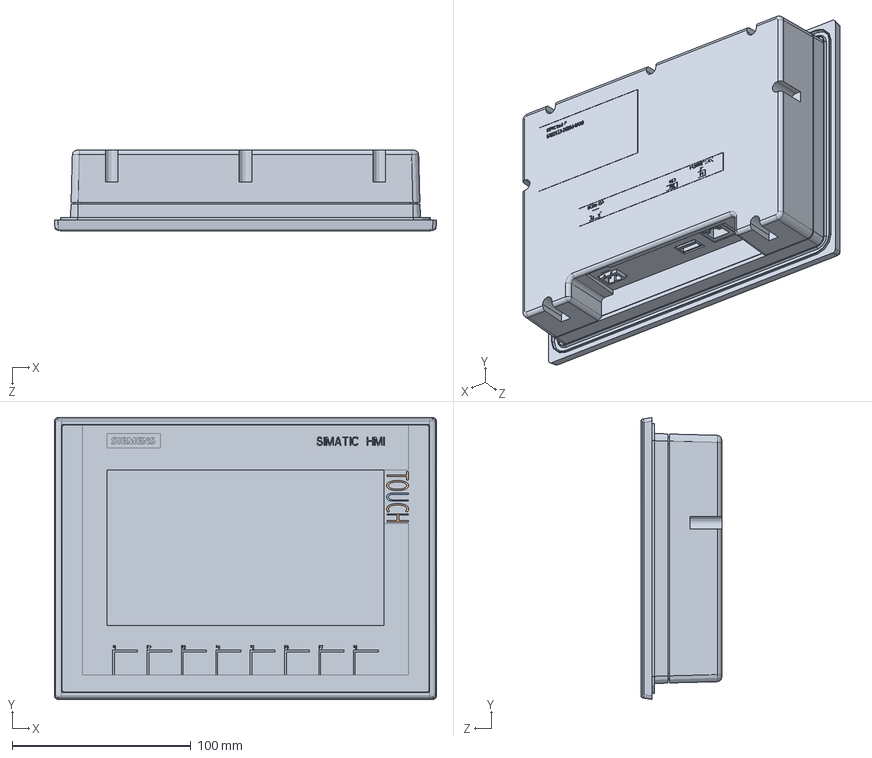
[picture p371: CAD file, 2023-06-13]
Diseny 3D, planos i STL/Ensamblatge Maquina Vending/Ensamblatge 3D Maquina Vending/6av21232gb030ax0.SLDASM
214.0 x 158.0 x 45.3 mm
6av21232gb030ax0_01
6av21232gb030ax0_02
6av21232gb030ax0_03
6av21232gb030ax0_04
6av21232gb030ax0_05
6av21232gb030ax0_06
6av21232gb030ax0_07
6av21232gb030ax0_08
6av21232gb030ax0_09
6av21232gb030ax0_10
6av21232gb030ax0_11
6av21232gb030ax0_12
6av21232gb030ax0_13
6av21232gb030ax0_14
6av21232gb030ax0_15
6av21232gb030ax0_16
6av21232gb030ax0_17
6av21232gb030ax0_18
6av21232gb030ax0_19
6av21232gb030ax0_20
6av21232gb030ax0_21
6av21232gb030ax0_22
6av21232gb030ax0_23
6av21232gb030ax0_24
6av21232gb030ax0_25
6av21232gb030ax0_26
6av21232gb030ax0_27
6av21232gb030ax0_28
6av21232gb030ax0_29
6av21232gb030ax0_30
6av21232gb030ax0_31
6av21232gb030ax0_32
6av21232gb030ax0_33
6av21232gb030ax0_34
6av21232gb030ax0_35
6av21232gb030ax0_36
6av21232gb030ax0_37
6av21232gb030ax0_38
6av21232gb030ax0_39
6av21232gb030ax0_40
6av21232gb030ax0_41
6av21232gb030ax0_42
6av21232gb030ax0_43
6av21232gb030ax0_44
6av21232gb030ax0_45
6av21232gb030ax0_46
6av21232gb030ax0_47
6av21232gb030ax0_48
6av21232gb030ax0_49
6av21232gb030ax0_50
6av21232gb030ax0_51
6av21232gb030ax0_52
6av21232gb030ax0_53
6av21232gb030ax0_54
6av21232gb030ax0_55
6av21232gb030ax0_56
6av21232gb030ax0_57
6av21232gb030ax0_58
6av21232gb030ax0_59
6av21232gb030ax0_60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
