josegd98/MaquinaVending/Diseny 3D, planos i STL/Ensamblatge Maquina Vending/Ensamblatge 3D Maquina Vending/ssg-5l2t.SLDASM

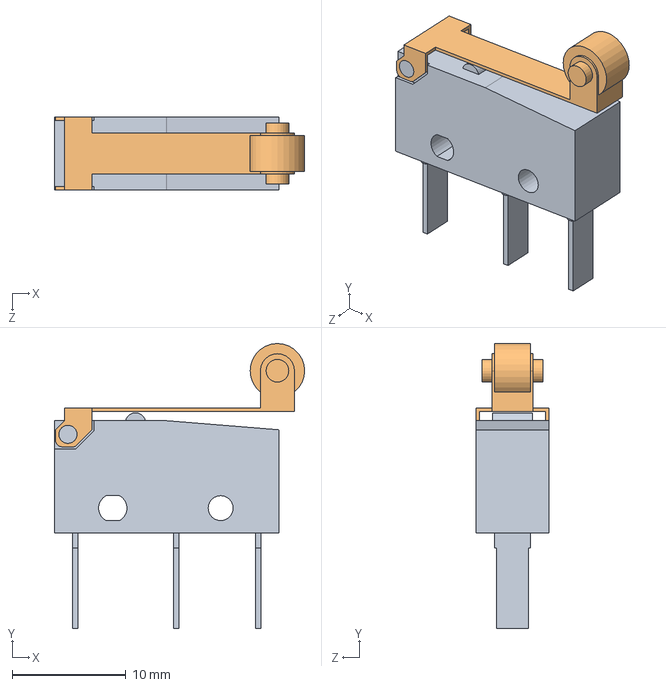
[picture p372: CAD file, 2023-06-13]
Diseny 3D, planos i STL/Ensamblatge Maquina Vending/Ensamblatge 3D Maquina Vending/ssg-5l2t.SLDASM
22.0 x 25.1 x 6.40 mm
ssg-5l2t_01
ssg-5l2t_02
