josegd98/MaquinaVending/Diseny 3D, planos i STL/Arxius STL per impresió 3D/Caixa recollida producte/Base recollida producte.STL

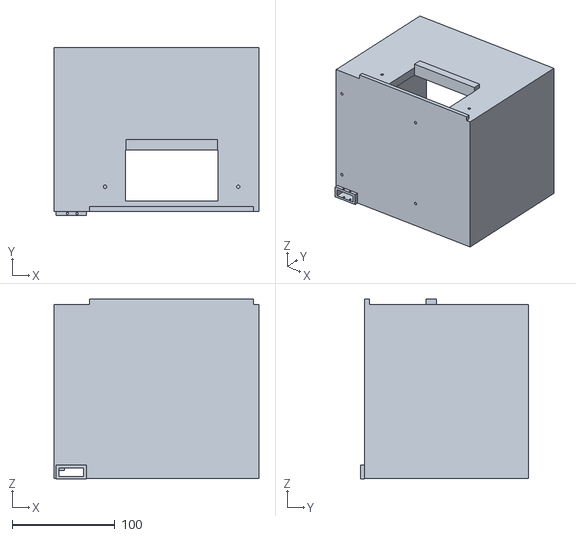
[picture p373: CAD file, 2023-06-13]
Diseny 3D, planos i STL/Arxius STL per impresió 3D/Caixa recollida producte/Base recollida producte.STL
200.0 x 164.3 x 175.2
