josegd98/MaquinaVending/Diseny 3D, planos i STL/Arxius STL per impresió 3D/Caixes de producte/Caixa gran/Caja de tornillos grande.STL

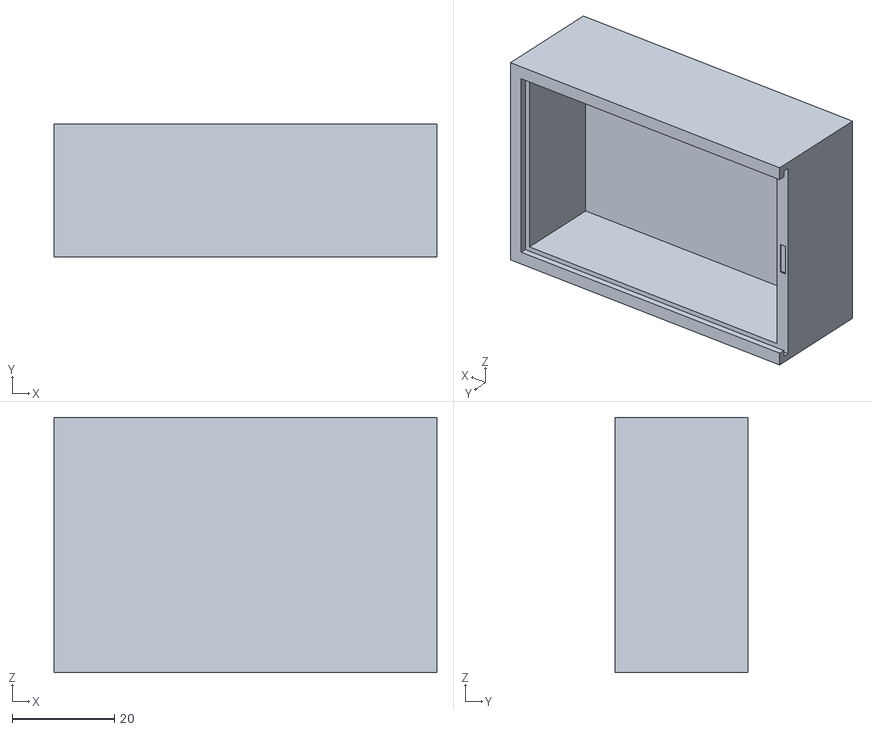
[picture p374: CAD file, 2023-06-13]
Diseny 3D, planos i STL/Arxius STL per impresió 3D/Caixes de producte/Caixa gran/Caja de tornillos grande.STL
75.0 x 26.0 x 50.0
