josegd98/MaquinaVending/Diseny 3D, planos i STL/Arxius STL per impresió 3D/Caixes de producte/Caixa petita/Alzador piezas pequeñas estanterias superiores.STL

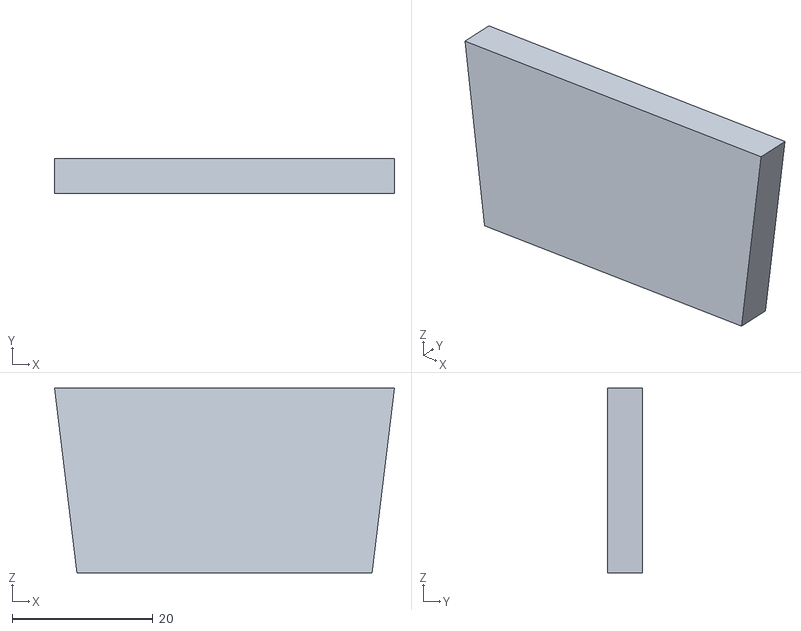
[picture p375: CAD file, 2023-06-13]
Diseny 3D, planos i STL/Arxius STL per impresió 3D/Caixes de producte/Caixa petita/Alzador piezas pequeñas estanterias superiores.STL
48.4 x 5.00 x 26.3
