josegd98/MaquinaVending/Diseny 3D, planos i STL/Arxius STL per impresió 3D/Carregadors/Carregador peces grans.STL

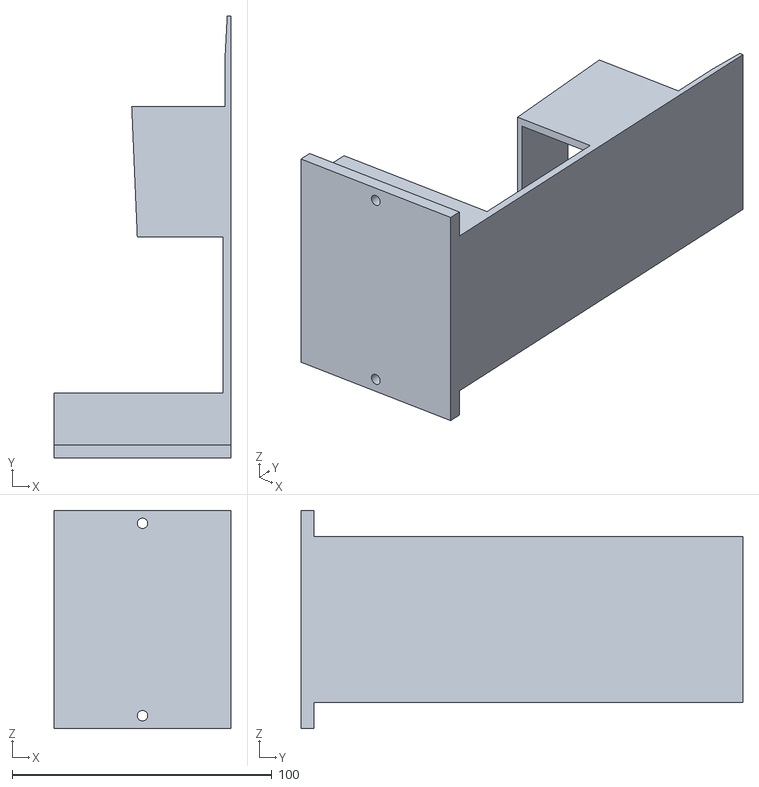
[picture p376: CAD file, 2023-06-13]
Diseny 3D, planos i STL/Arxius STL per impresió 3D/Carregadors/Carregador peces grans.STL
68.0 x 170.0 x 84.0
