josegd98/MaquinaVending/Diseny 3D, planos i STL/Arxius STL per impresió 3D/Clauer EDN/Clauer EDN.SLDPRT

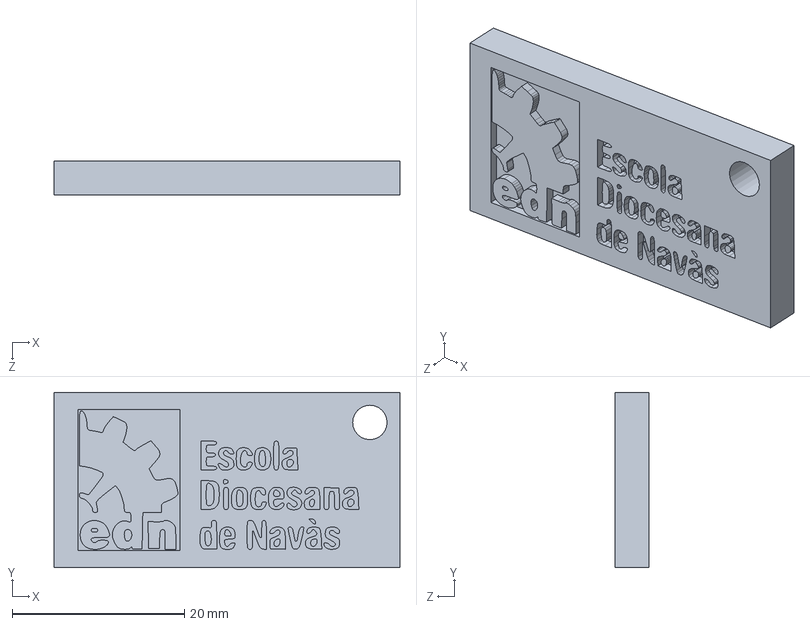
[picture p377: CAD file, 2023-06-13]
Diseny 3D, planos i STL/Arxius STL per impresió 3D/Clauer EDN/Clauer EDN.SLDPRT
40.2 x 20.4 x 4.00 mm
