josegd98/MaquinaVending/Diseny 3D, planos i STL/Arxius STL per impresió 3D/Complements/Clip canaleta cable led.STL

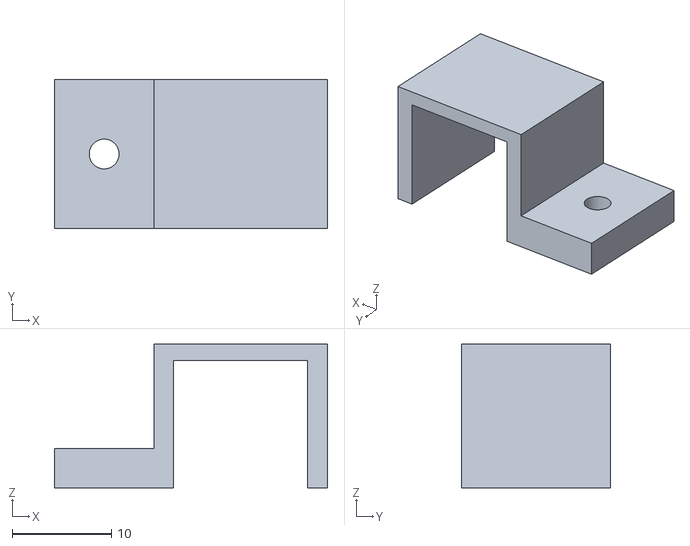
[picture p378: CAD file, 2023-06-13]
Diseny 3D, planos i STL/Arxius STL per impresió 3D/Complements/Clip canaleta cable led.STL
27.5 x 15.0 x 14.5
