josegd98/MaquinaVending/Diseny 3D, planos i STL/Arxius STL per impresió 3D/Conjunt pinça/Pinça impressio 3d dreta 2 vfinal.STL

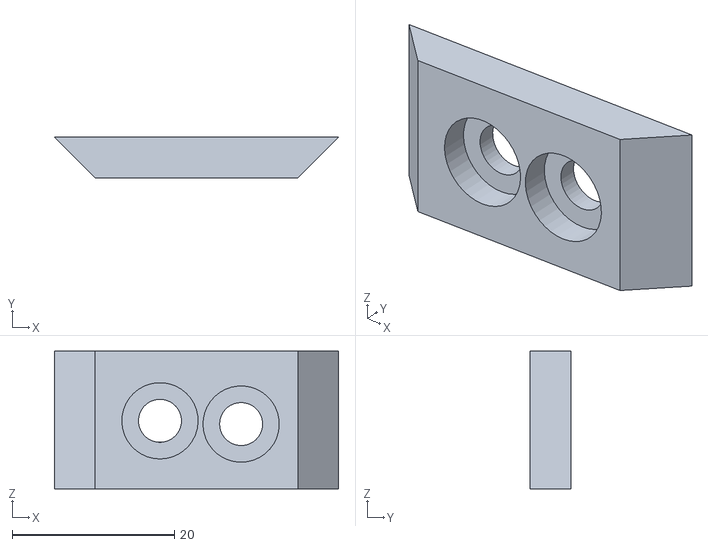
[picture p379: CAD file, 2023-06-13]
Diseny 3D, planos i STL/Arxius STL per impresió 3D/Conjunt pinça/Pinça impressio 3d dreta 2 vfinal.STL
35.0 x 5.00 x 17.0
