josegd98/MaquinaVending/Diseny 3D, planos i STL/Arxius STL per impresió 3D/Eix inferior/Suport sensor origen peça ferro.STL

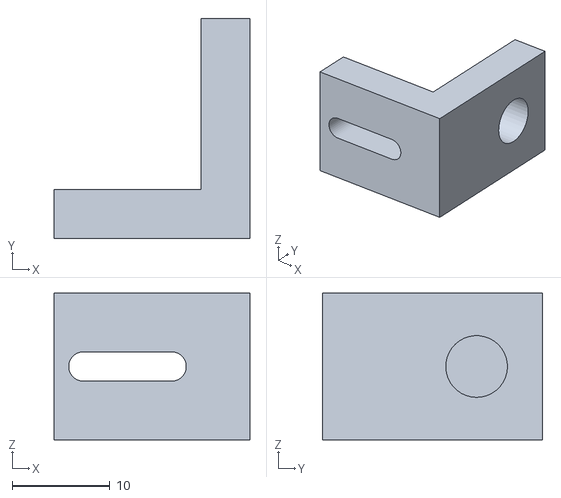
[picture p380: CAD file, 2023-06-13]
Diseny 3D, planos i STL/Arxius STL per impresió 3D/Eix inferior/Suport sensor origen peça ferro.STL
20.0 x 22.5 x 15.0
