josegd98/MaquinaVending/Diseny 3D, planos i STL/Arxius STL per impresió 3D/Eix superior/Soporte correa arrastre 2.STL

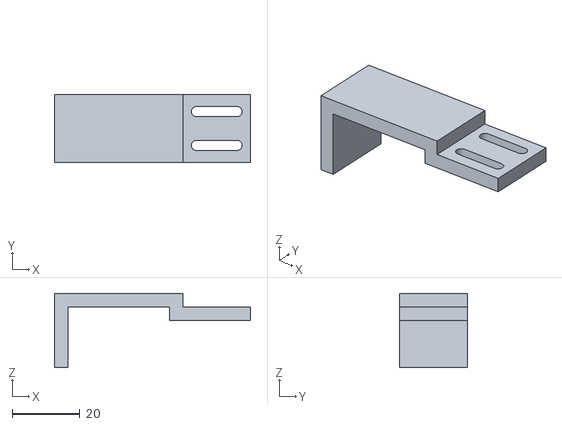
[picture p381: CAD file, 2023-06-13]
Diseny 3D, planos i STL/Arxius STL per impresió 3D/Eix superior/Soporte correa arrastre 2.STL
58.0 x 20.0 x 22.0
