josegd98/MaquinaVending/Diseny 3D, planos i STL/Arxius STL per impresió 3D/Estanteries giratories/Adaptador motor v2.STL

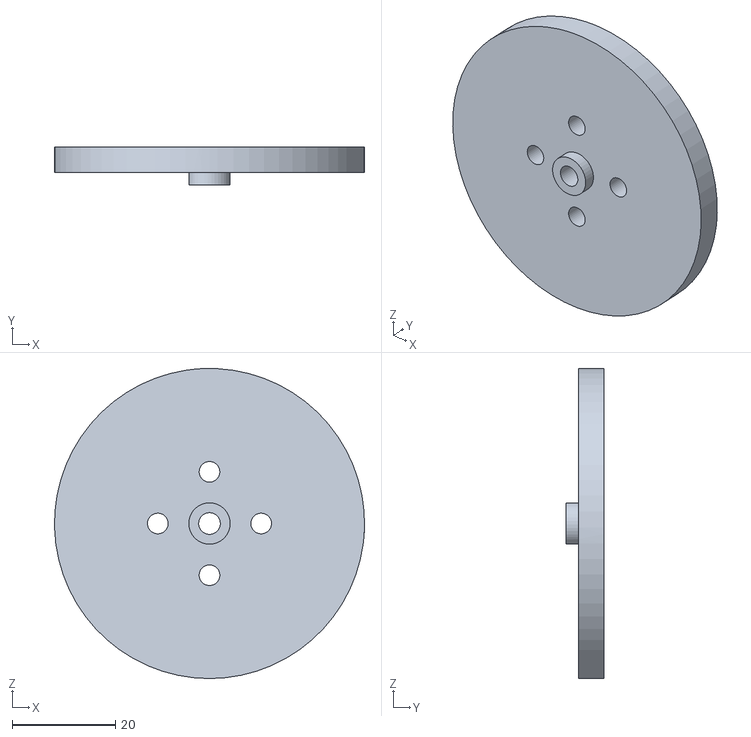
[picture p382: CAD file, 2023-06-13]
Diseny 3D, planos i STL/Arxius STL per impresió 3D/Estanteries giratories/Adaptador motor v2.STL
60.0 x 7.40 x 60.0
