josegd98/MaquinaVending/Diseny 3D, planos i STL/Arxius STL per impresió 3D/Rampa recollida producte/Peça 2 rampa.STL

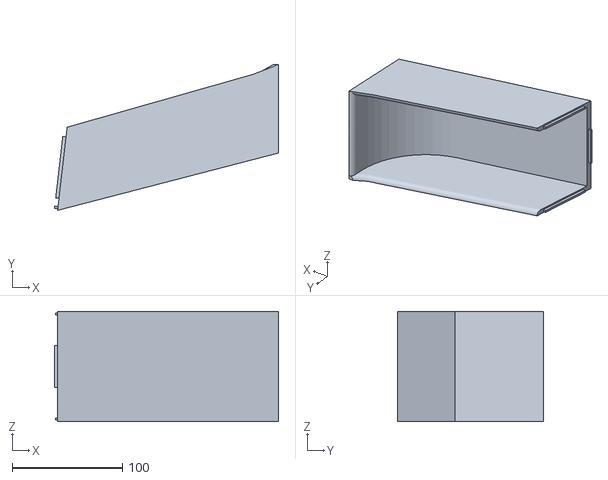
[picture p383: CAD file, 2023-06-13]
Diseny 3D, planos i STL/Arxius STL per impresió 3D/Rampa recollida producte/Peça 2 rampa.STL
202.8 x 131.9 x 100.0
