josegd98/MaquinaVending/Diseny 3D, planos i STL/Arxius STL per impresió 3D/Caixa recollida producte/Tapa base recollida.STL

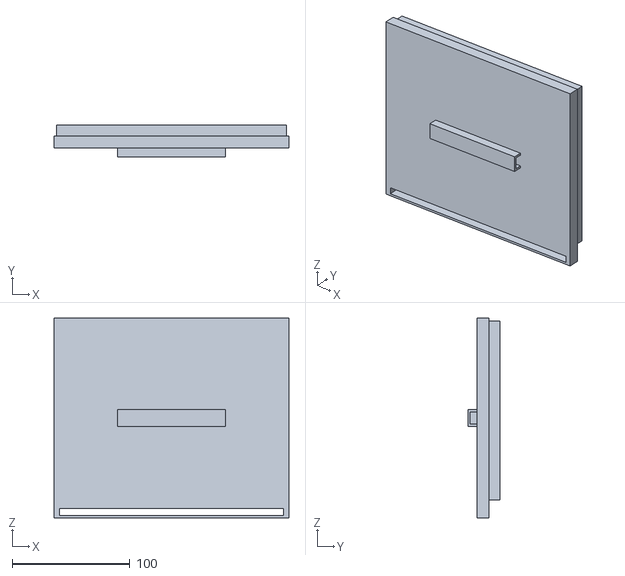
[picture p384: CAD file, 2023-06-13]
Diseny 3D, planos i STL/Arxius STL per impresió 3D/Caixa recollida producte/Tapa base recollida.STL
200.0 x 27.5 x 170.0
