josegd98/MaquinaVending/Diseny 3D, planos i STL/Arxius STL per impresió 3D/Caixes de producte/Caixa gran/Suport caixes grans.STL

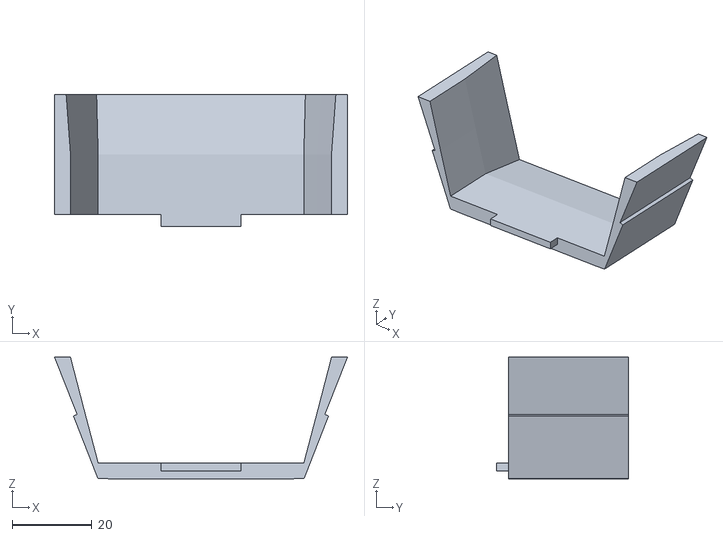
[picture p385: CAD file, 2023-06-13]
Diseny 3D, planos i STL/Arxius STL per impresió 3D/Caixes de producte/Caixa gran/Suport caixes grans.STL
73.3 x 33.0 x 30.4
