josegd98/MaquinaVending/Diseny 3D, planos i STL/Arxius STL per impresió 3D/Caixes de producte/Caixa petita/Tapa caja pequeña.STL

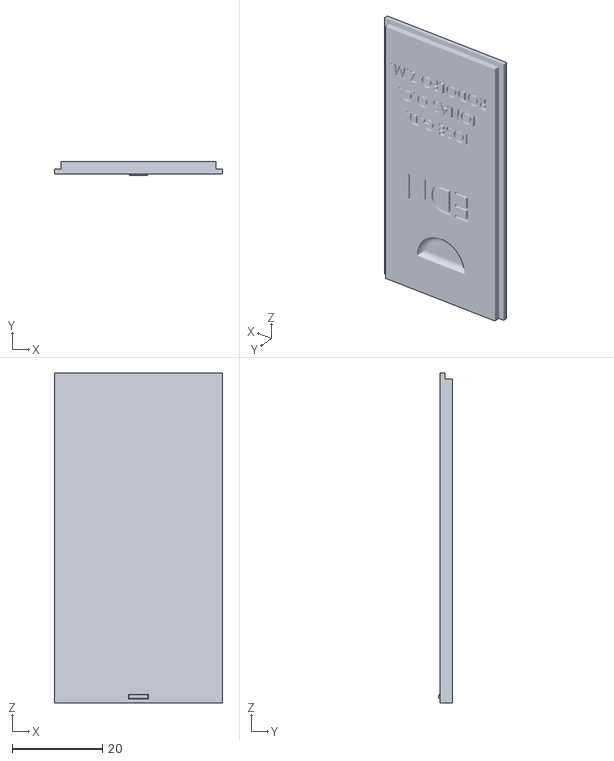
[picture p386: CAD file, 2023-06-13]
Diseny 3D, planos i STL/Arxius STL per impresió 3D/Caixes de producte/Caixa petita/Tapa caja pequeña.STL
37.4 x 3.05 x 73.3
