josegd98/MaquinaVending/Diseny 3D, planos i STL/Arxius STL per impresió 3D/Carregadors/Carregador peces petites.STL

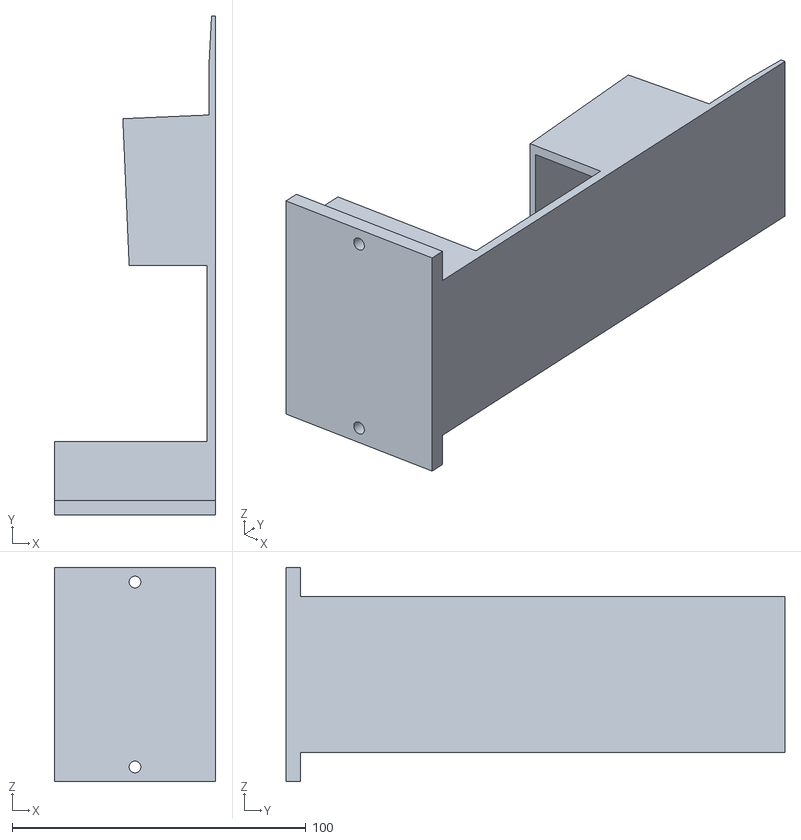
[picture p387: CAD file, 2023-06-13]
Diseny 3D, planos i STL/Arxius STL per impresió 3D/Carregadors/Carregador peces petites.STL
55.0 x 170.0 x 73.0
