josegd98/MaquinaVending/Diseny 3D, planos i STL/Arxius STL per impresió 3D/Conjunt pinça/Soporte Nema11.STL

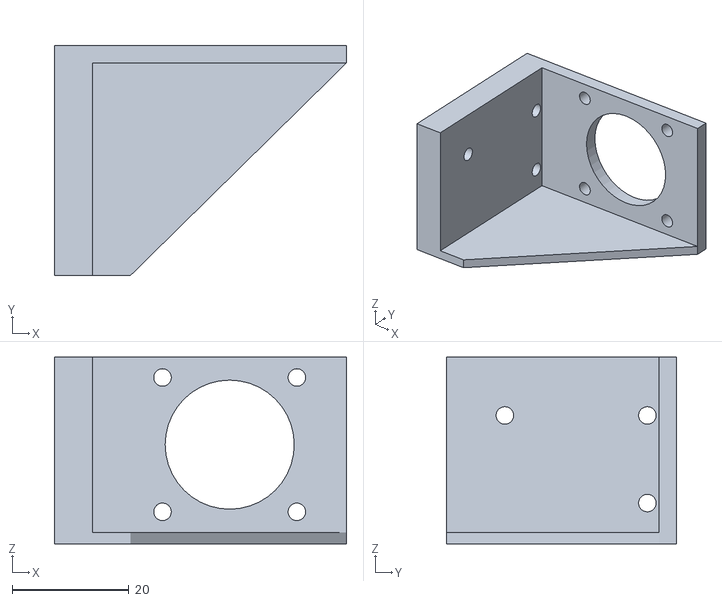
[picture p388: CAD file, 2023-06-13]
Diseny 3D, planos i STL/Arxius STL per impresió 3D/Conjunt pinça/Soporte Nema11.STL
50.0 x 39.4 x 32.0
