josegd98/MaquinaVending/Diseny 3D, planos i STL/Arxius STL per impresió 3D/Eix inferior/Suports Guia lineal infrerior.STL

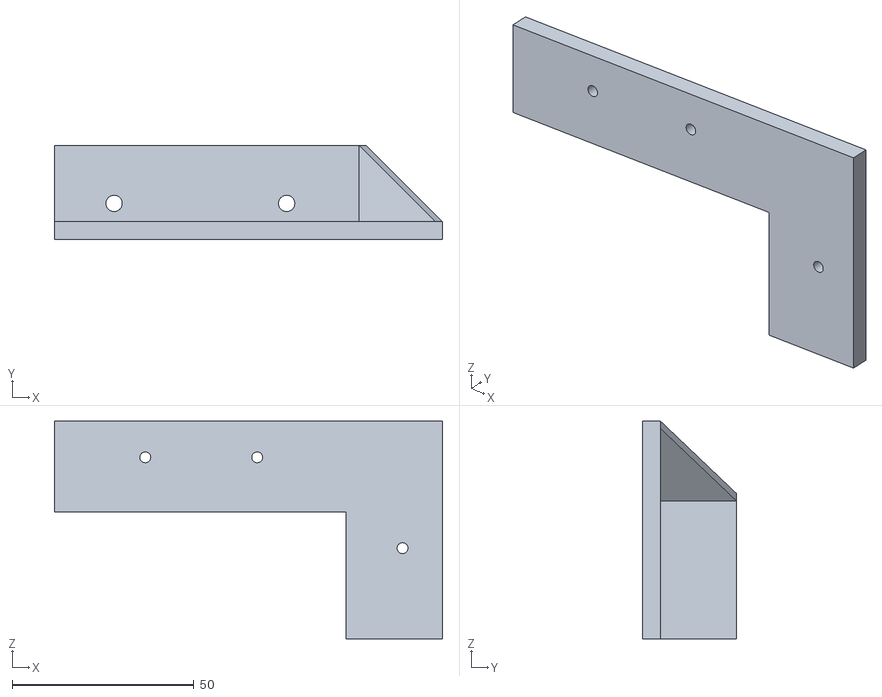
[picture p389: CAD file, 2023-06-13]
Diseny 3D, planos i STL/Arxius STL per impresió 3D/Eix inferior/Suports Guia lineal infrerior.STL
106.8 x 26.0 x 60.0
