josegd98/MaquinaVending/Diseny 3D, planos i STL/Arxius STL per impresió 3D/Estanteries giratories/Estanteria giratoria.STL

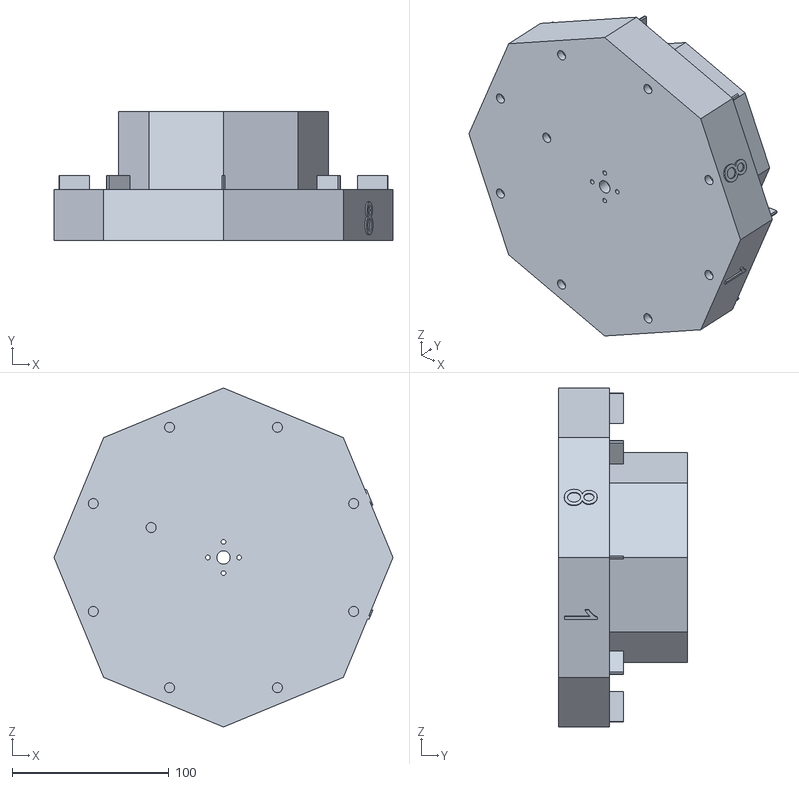
[picture p391: CAD file, 2023-06-13]
Diseny 3D, planos i STL/Arxius STL per impresió 3D/Estanteries giratories/Estanteria giratoria.STL
216.5 x 82.5 x 216.5
