josegd98/MaquinaVending/Diseny 3D, planos i STL/Arxius STL per impresió 3D/Rampa recollida producte/Suport sensor difusor.STL

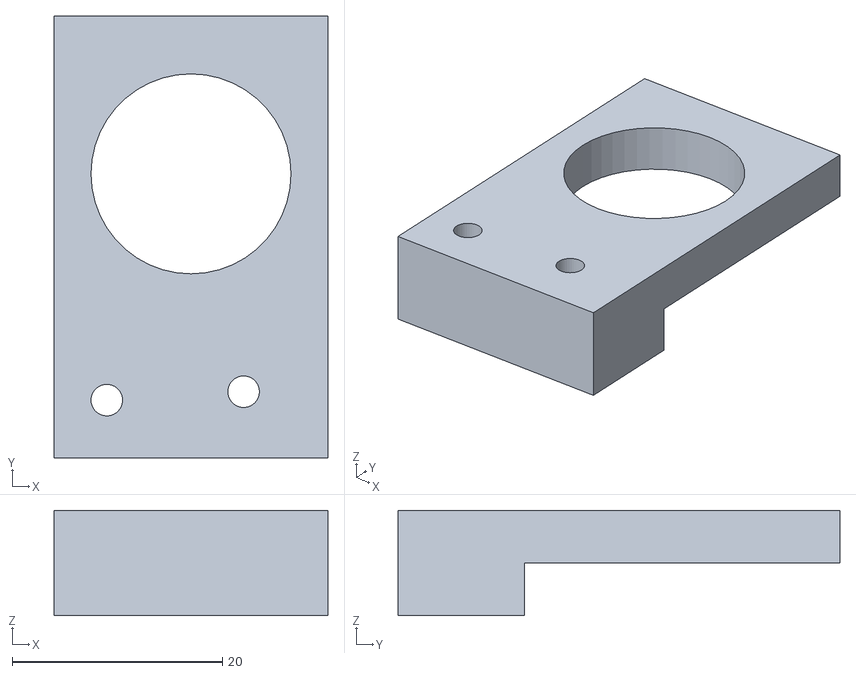
[picture p392: CAD file, 2023-06-13]
Diseny 3D, planos i STL/Arxius STL per impresió 3D/Rampa recollida producte/Suport sensor difusor.STL
26.0 x 42.0 x 10.0
