josegd98/MaquinaVending/Diseny 3D, planos i STL/Arxius STL per impresió 3D/Caixa recollida producte/Maneta porta recollida producte.STL

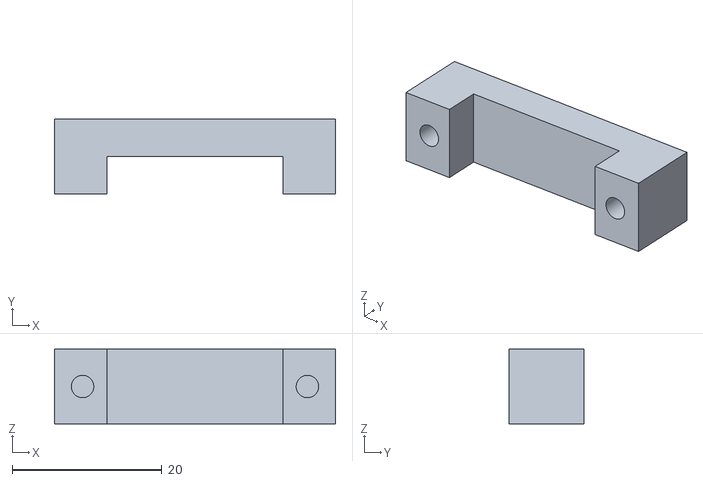
[picture p393: CAD file, 2023-06-13]
Diseny 3D, planos i STL/Arxius STL per impresió 3D/Caixa recollida producte/Maneta porta recollida producte.STL
37.5 x 10.0 x 10.0
