josegd98/MaquinaVending/Diseny 3D, planos i STL/Arxius STL per impresió 3D/Caixes de producte/Caixa gran/Alzador cajas grandes estanterias superiores.STL

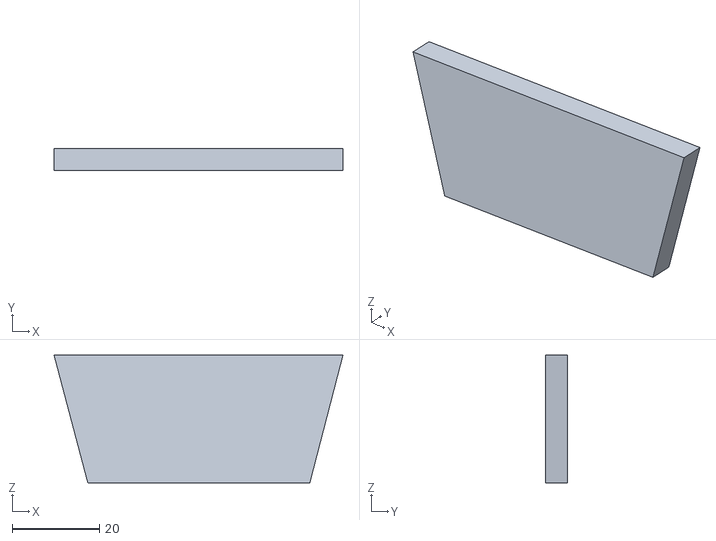
[picture p394: CAD file, 2023-06-13]
Diseny 3D, planos i STL/Arxius STL per impresió 3D/Caixes de producte/Caixa gran/Alzador cajas grandes estanterias superiores.STL
66.3 x 5.00 x 29.3
