josegd98/MaquinaVending/Diseny 3D, planos i STL/Arxius STL per impresió 3D/Caixes de producte/Caixa petita/Caja de tornillos pequeña SPAX.STL

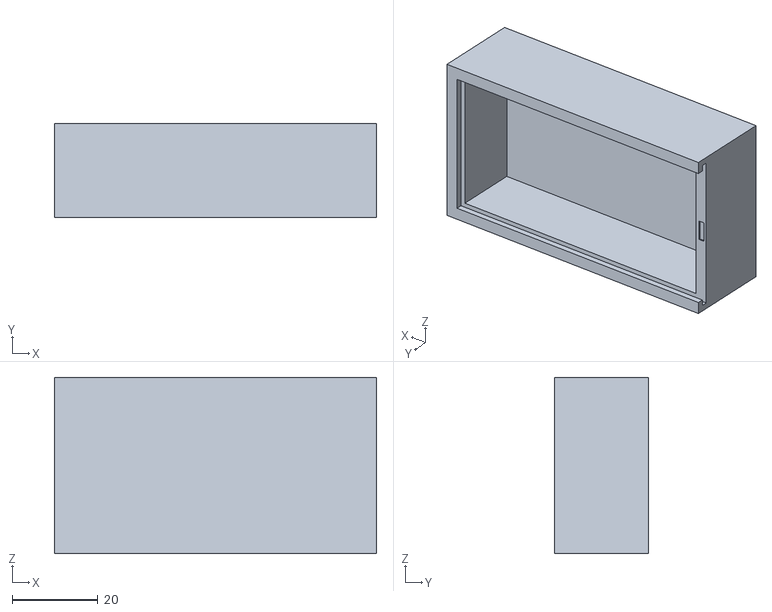
[picture p395: CAD file, 2023-06-13]
Diseny 3D, planos i STL/Arxius STL per impresió 3D/Caixes de producte/Caixa petita/Caja de tornillos pequeña SPAX.STL
75.0 x 22.0 x 41.0
