josegd98/MaquinaVending/Diseny 3D, planos i STL/Arxius STL per impresió 3D/Conjunt pinça/Soporte cadena pinza.STL

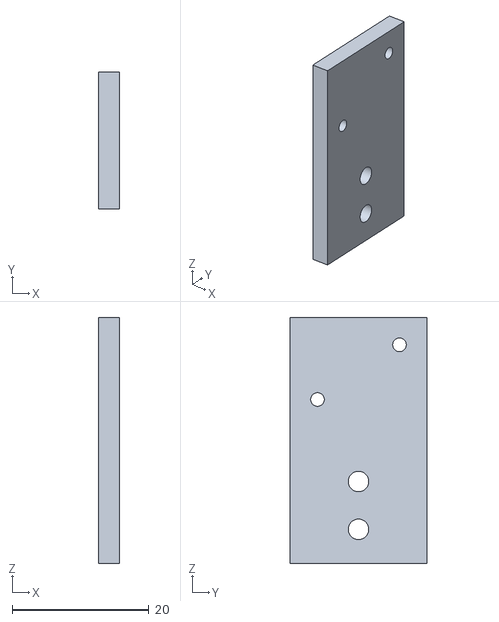
[picture p396: CAD file, 2023-06-13]
Diseny 3D, planos i STL/Arxius STL per impresió 3D/Conjunt pinça/Soporte cadena pinza.STL
3.00 x 20.0 x 36.0
