josegd98/MaquinaVending/Diseny 3D, planos i STL/Arxius STL per impresió 3D/Eix inferior/Soporte pasa cables guia superior.STL

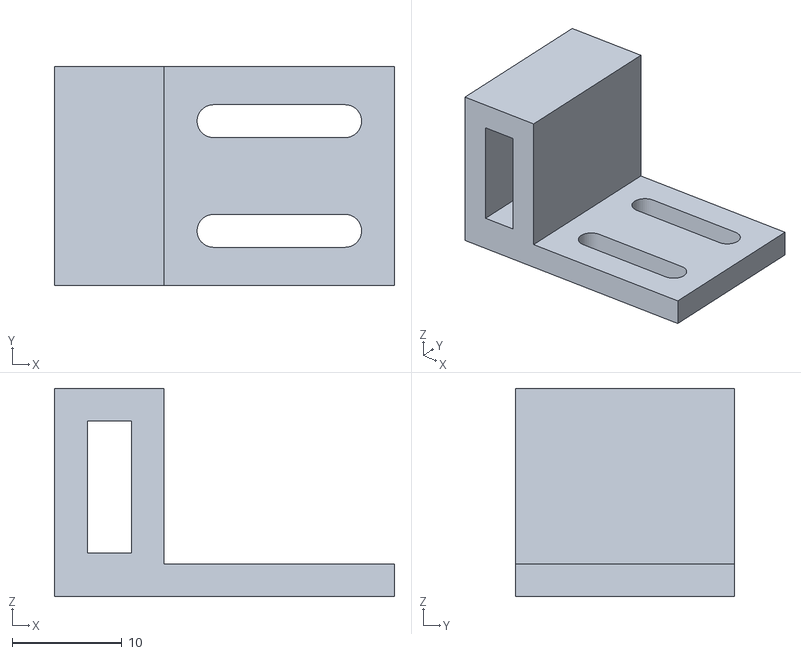
[picture p397: CAD file, 2023-06-13]
Diseny 3D, planos i STL/Arxius STL per impresió 3D/Eix inferior/Soporte pasa cables guia superior.STL
31.0 x 20.0 x 19.0
