josegd98/MaquinaVending/Diseny 3D, planos i STL/Arxius STL per impresió 3D/Estanteries giratories/Tapa estanteries.STL

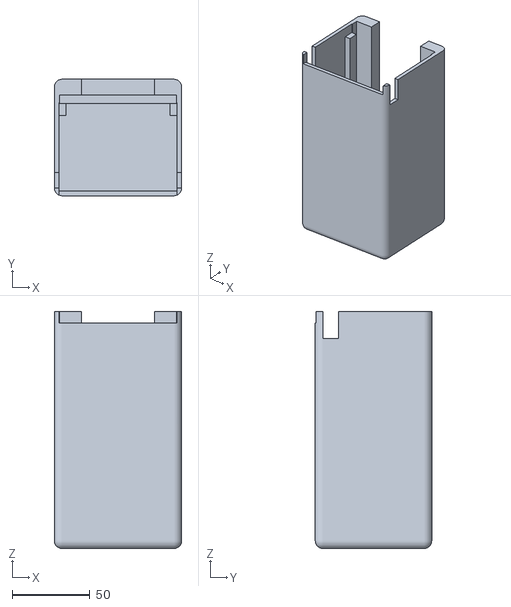
[picture p398: CAD file, 2023-06-13]
Diseny 3D, planos i STL/Arxius STL per impresió 3D/Estanteries giratories/Tapa estanteries.STL
82.0 x 75.0 x 152.5
