josegd98/MaquinaVending/Diseny 3D, planos i STL/Arxius STL per impresió 3D/Rampa recollida producte/Suport rampa.STL

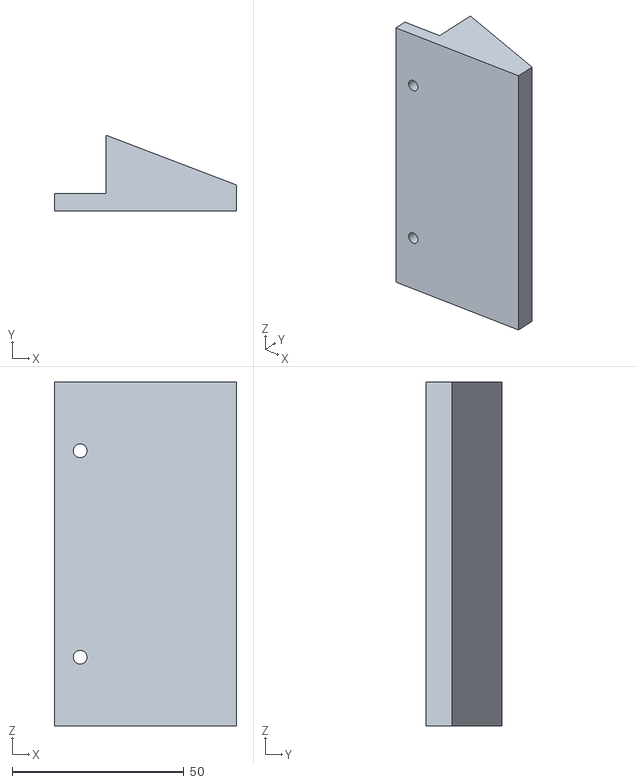
[picture p399: CAD file, 2023-06-13]
Diseny 3D, planos i STL/Arxius STL per impresió 3D/Rampa recollida producte/Suport rampa.STL
53.0 x 22.0 x 100.0
