josegd98/MaquinaVending/Diseny 3D, planos i STL/Arxius STL per impresió 3D/Caixes de producte/Caixa gran/Tapa caja grande.STL

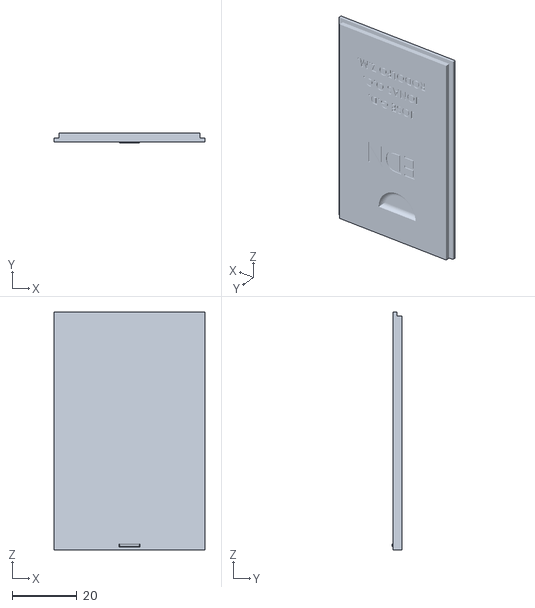
[picture p401: CAD file, 2023-06-13]
Diseny 3D, planos i STL/Arxius STL per impresió 3D/Caixes de producte/Caixa gran/Tapa caja grande.STL
46.4 x 3.05 x 73.3
