josegd98/MaquinaVending/Diseny 3D, planos i STL/Arxius STL per impresió 3D/Caixes de producte/Caixa petita/Suport caixes petites v2.STL

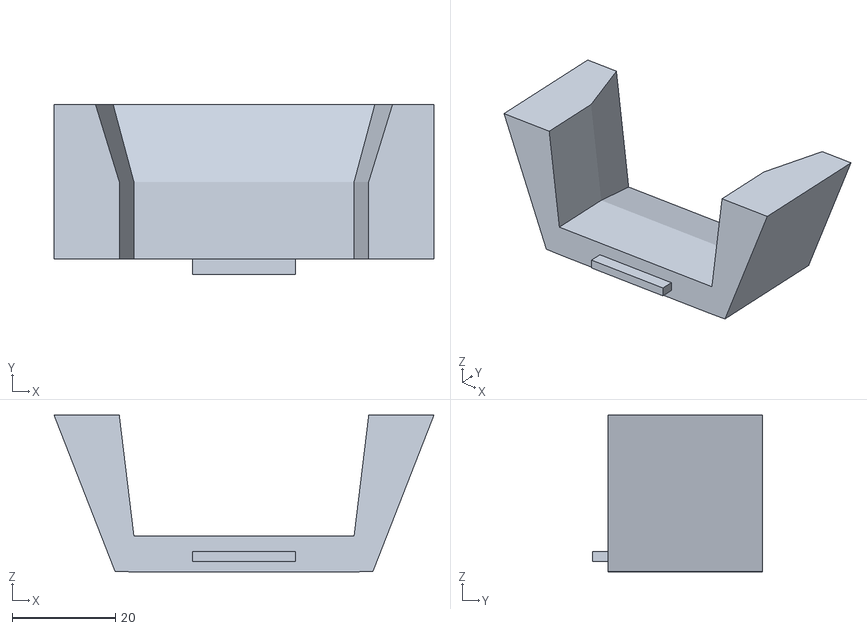
[picture p402: CAD file, 2023-06-13]
Diseny 3D, planos i STL/Arxius STL per impresió 3D/Caixes de producte/Caixa petita/Suport caixes petites v2.STL
73.7 x 33.0 x 30.4
