josegd98/MaquinaVending/Diseny 3D, planos i STL/Arxius STL per impresió 3D/Conjunt pinça/Cadena de arrastre pinza.STL

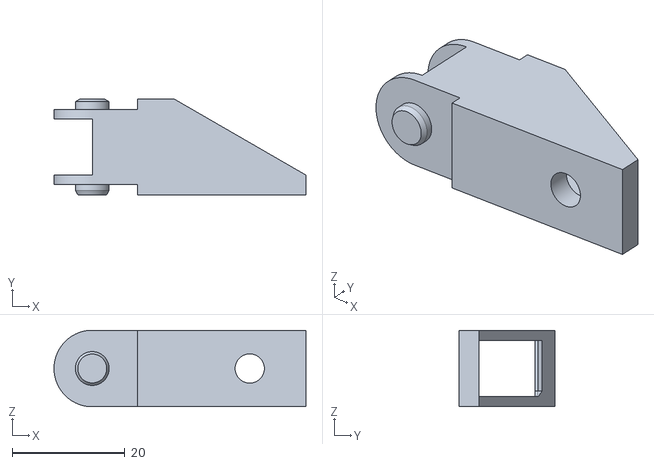
[picture p403: CAD file, 2023-06-13]
Diseny 3D, planos i STL/Arxius STL per impresió 3D/Conjunt pinça/Cadena de arrastre pinza.STL
44.8 x 17.0 x 13.6
