josegd98/MaquinaVending/Diseny 3D, planos i STL/Arxius STL per impresió 3D/Eix inferior/Suport rodaments 8mm eix inferior.STL

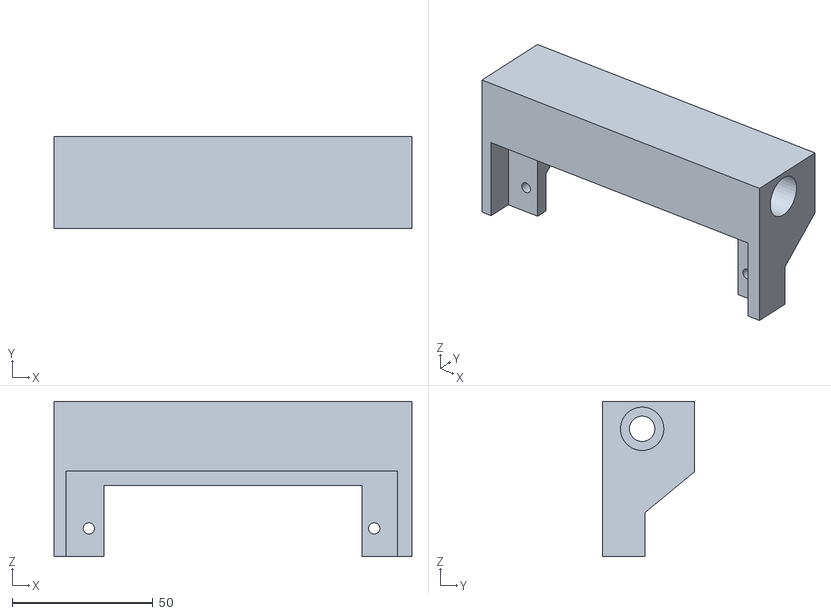
[picture p404: CAD file, 2023-06-13]
Diseny 3D, planos i STL/Arxius STL per impresió 3D/Eix inferior/Suport rodaments 8mm eix inferior.STL
127.0 x 32.5 x 55.0
