josegd98/MaquinaVending/Diseny 3D, planos i STL/Arxius STL per impresió 3D/Eix superior/Suport sensor origen.STL

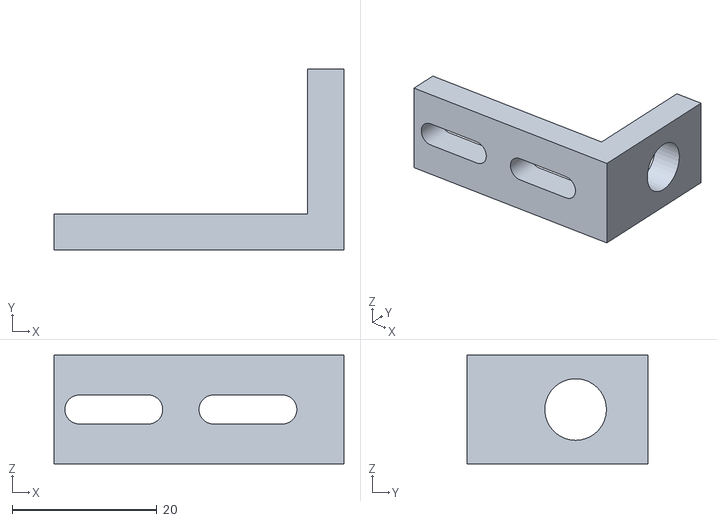
[picture p405: CAD file, 2023-06-13]
Diseny 3D, planos i STL/Arxius STL per impresió 3D/Eix superior/Suport sensor origen.STL
40.0 x 25.0 x 15.0
