josegd98/MaquinaVending/Diseny 3D, planos i STL/Arxius STL per impresió 3D/Rampa recollida producte/Peça 1 rampa.STL

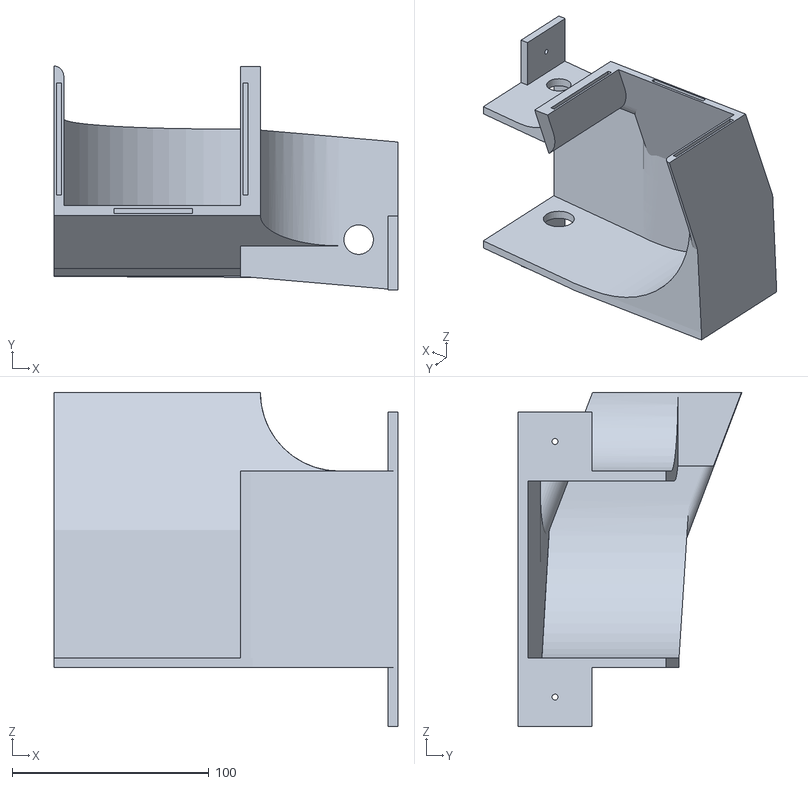
[picture p406: CAD file, 2023-06-13]
Diseny 3D, planos i STL/Arxius STL per impresió 3D/Rampa recollida producte/Peça 1 rampa.STL
175.0 x 113.9 x 170.0
