josegd98/MaquinaVending/Diseny 3D, planos i STL/Arxius STL per impresió 3D/Eix superior/Soporte correa de arrastree.STL

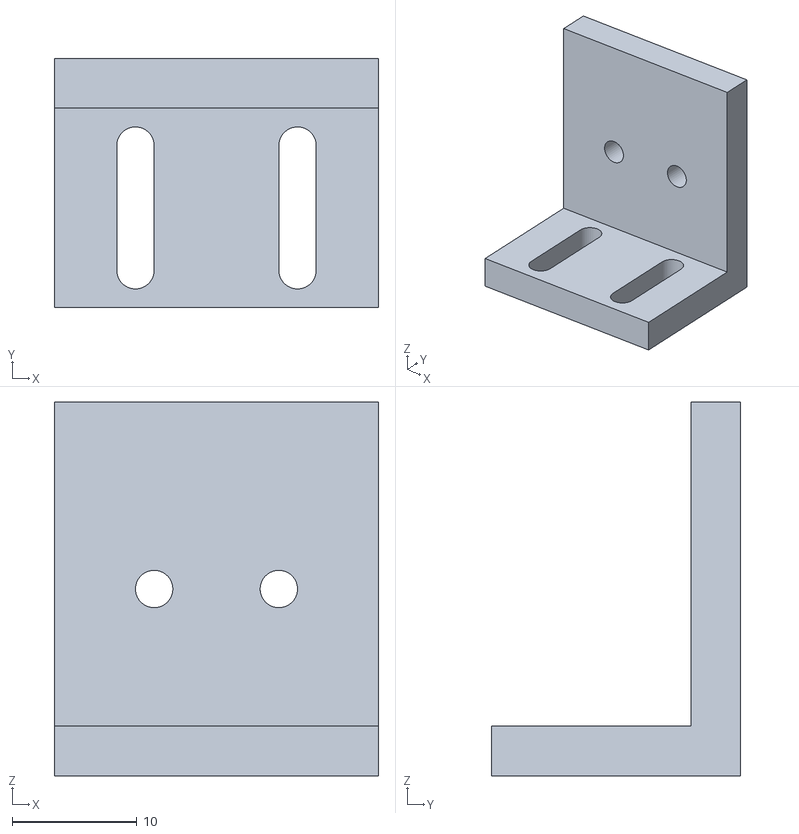
[picture p407: CAD file, 2023-06-13]
Diseny 3D, planos i STL/Arxius STL per impresió 3D/Eix superior/Soporte correa de arrastree.STL
26.0 x 20.0 x 30.0
