josegd98/MaquinaVending/Diseny 3D, planos i STL/Arxius STL per impresió 3D/Conjunt pinça/Caixa suport pinça.STL

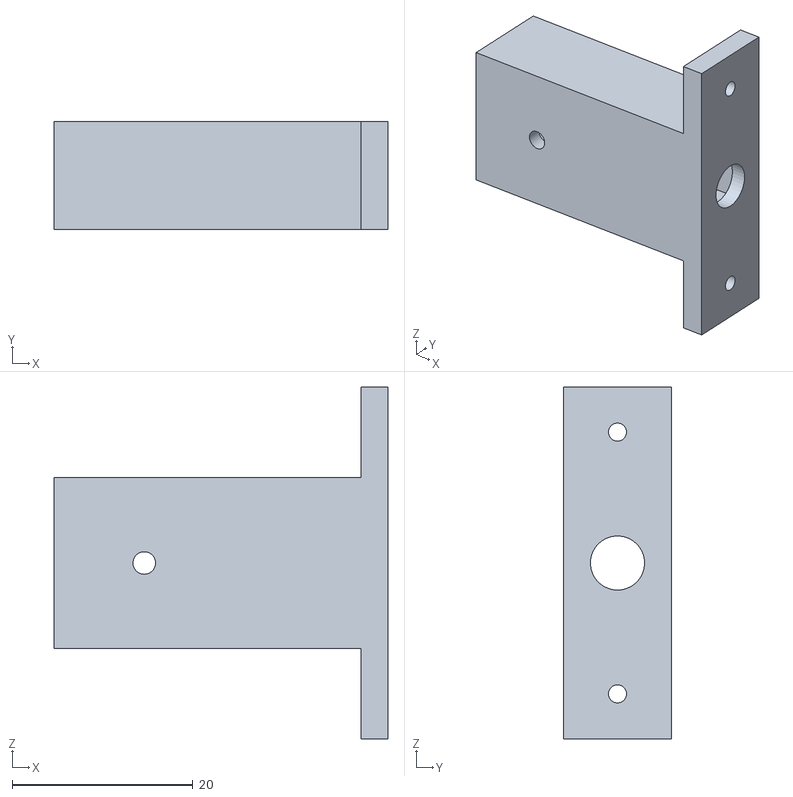
[picture p408: CAD file, 2023-06-13]
Diseny 3D, planos i STL/Arxius STL per impresió 3D/Conjunt pinça/Caixa suport pinça.STL
37.0 x 12.0 x 39.0
