josegd98/MaquinaVending/Diseny 3D, planos i STL/Arxius STL per impresió 3D/Eix inferior/Soporte eje 8mm.STL

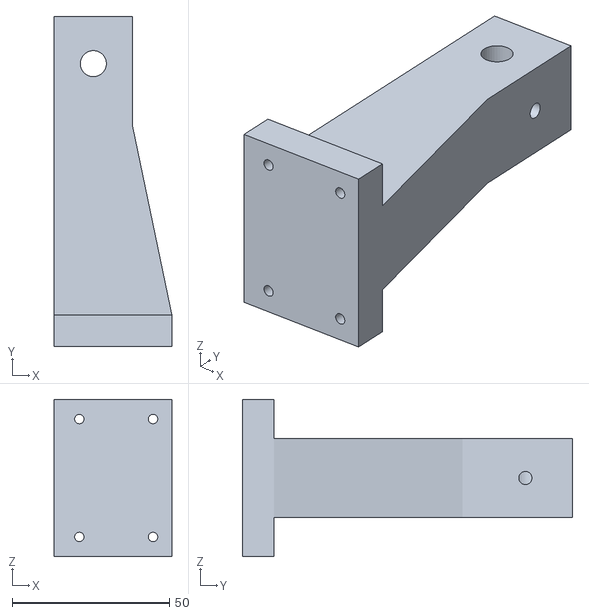
[picture p409: CAD file, 2023-06-13]
Diseny 3D, planos i STL/Arxius STL per impresió 3D/Eix inferior/Soporte eje 8mm.STL
37.5 x 105.0 x 50.0
