josegd98/MaquinaVending/Diseny 3D, planos i STL/Arxius STL per impresió 3D/Eix superior/Separador base pinça.STL

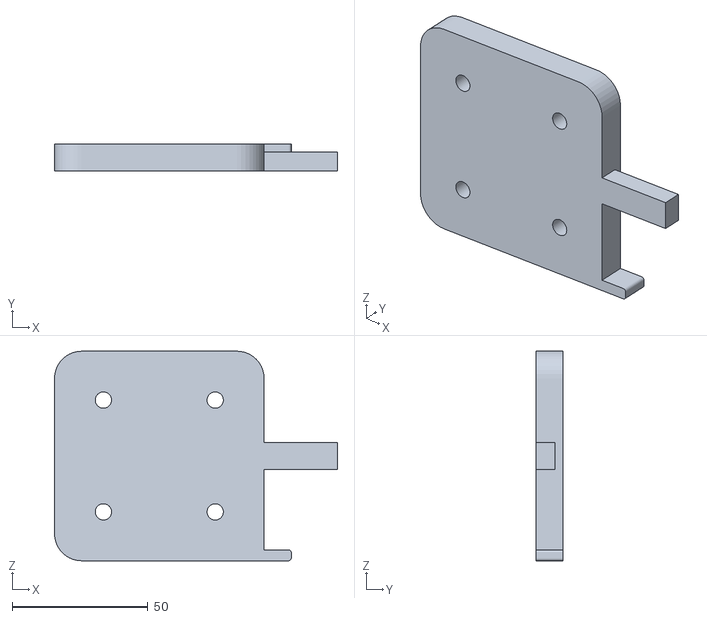
[picture p410: CAD file, 2023-06-13]
Diseny 3D, planos i STL/Arxius STL per impresió 3D/Eix superior/Separador base pinça.STL
104.2 x 10.0 x 77.2
