josegd98/MaquinaVending/Diseny 3D, planos i STL/Arxius STL per impresió 3D/Conjunt pinça/Suport final pinça 1.STL

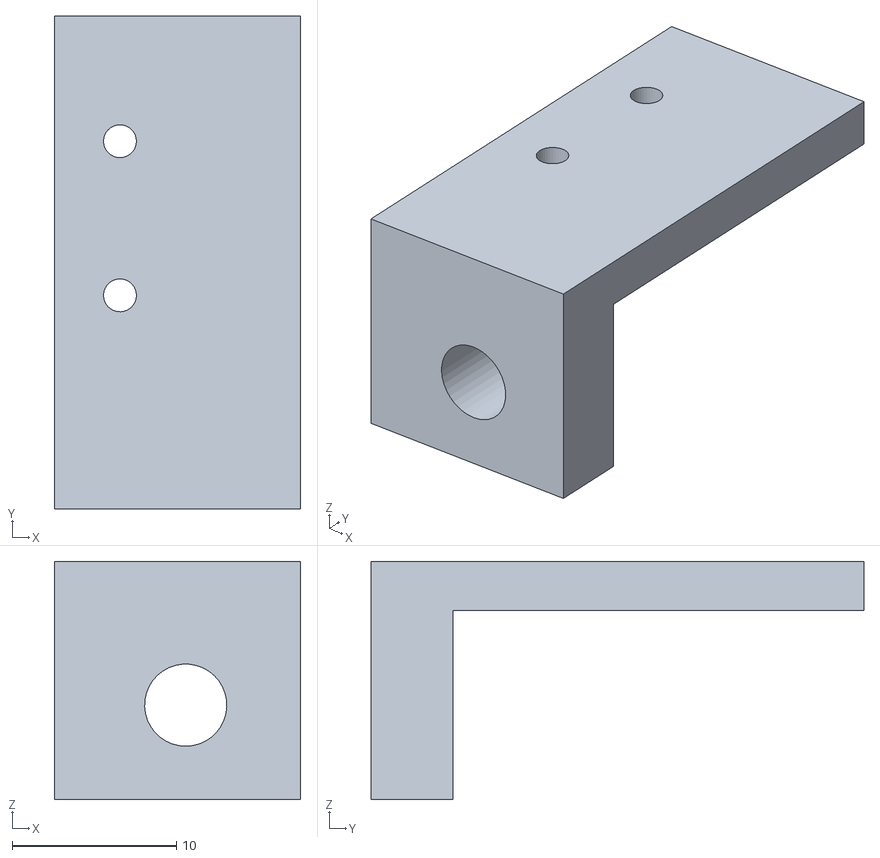
[picture p411: CAD file, 2023-06-13]
Diseny 3D, planos i STL/Arxius STL per impresió 3D/Conjunt pinça/Suport final pinça 1.STL
15.0 x 30.0 x 14.5
