josegd98/MaquinaVending/Diseny 3D, planos i STL/Ensamblatge Maquina Vending/Ensamblatge 3D Maquina Vending/Canaleta cable led superior.SLDPRT

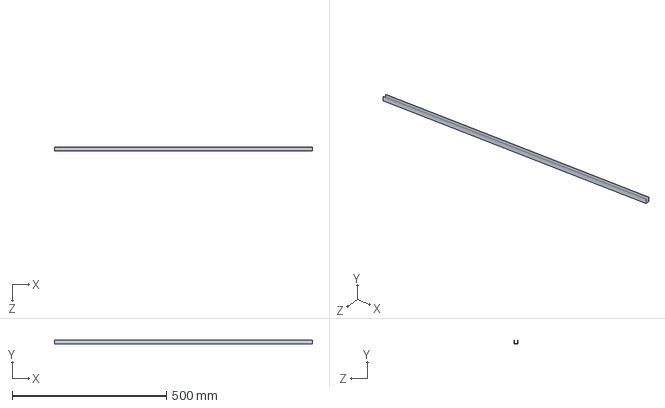
[picture p412: CAD file, 2023-06-13]
Diseny 3D, planos i STL/Ensamblatge Maquina Vending/Ensamblatge 3D Maquina Vending/Canaleta cable led superior.SLDPRT
835.0 x 12.5 x 12.5 mm
