josegd98/MaquinaVending/Diseny 3D, planos i STL/Arxius STL per impresió 3D/Eix inferior/BaseGuialineal.STL

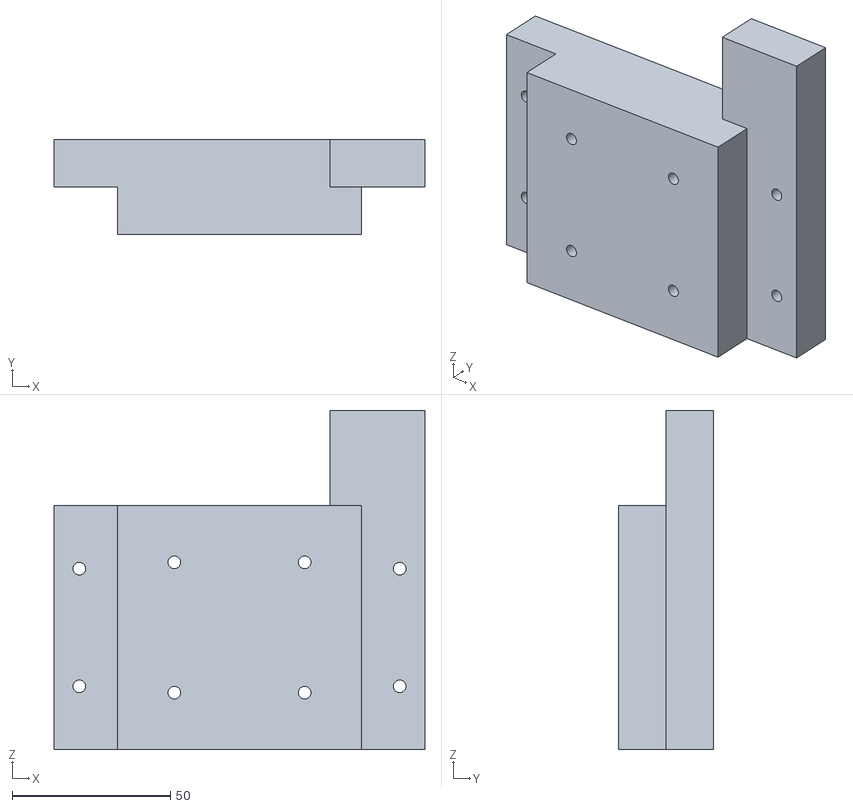
[picture p414: CAD file, 2023-06-13]
Diseny 3D, planos i STL/Arxius STL per impresió 3D/Eix inferior/BaseGuialineal.STL
117.2 x 30.0 x 107.2
