josegd98/MaquinaVending/Diseny 3D, planos i STL/Arxius STL per impresió 3D/Eix inferior/Baseguialineal Part superior.STL

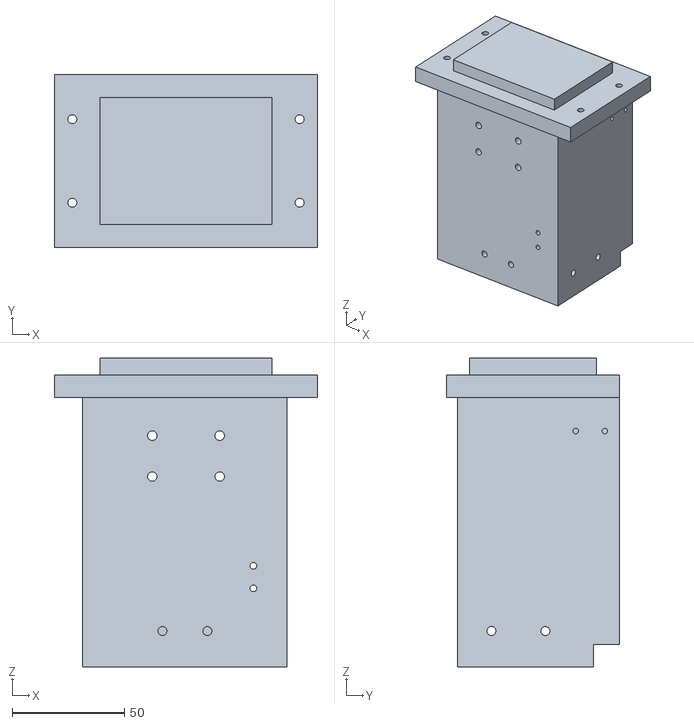
[picture p416: CAD file, 2023-06-13]
Diseny 3D, planos i STL/Arxius STL per impresió 3D/Eix inferior/Baseguialineal Part superior.STL
117.2 x 77.2 x 137.5
