josegd98/MaquinaVending/Diseny 3D, planos i STL/Arxius STL per impresió 3D/Conjunt pinça/Pieza final correa de arrastre pinza.STL

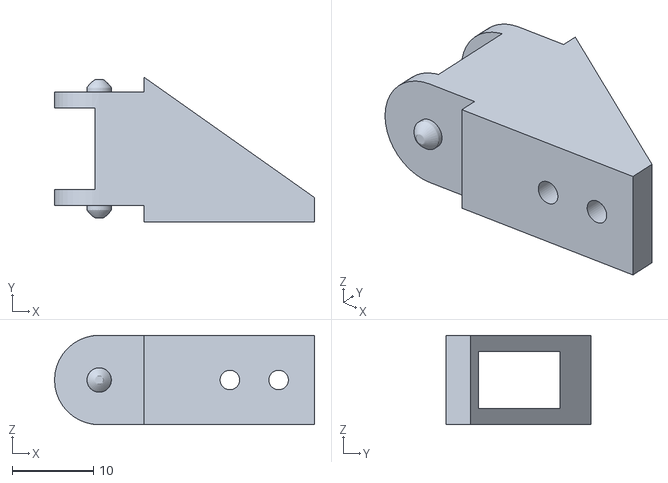
[picture p417: CAD file, 2023-06-13]
Diseny 3D, planos i STL/Arxius STL per impresió 3D/Conjunt pinça/Pieza final correa de arrastre pinza.STL
32.0 x 17.8 x 11.0
