josegd98/MaquinaVending/Diseny 3D, planos i STL/Arxius STL per impresió 3D/Eix inferior/Soporte final carrera puerta.STL

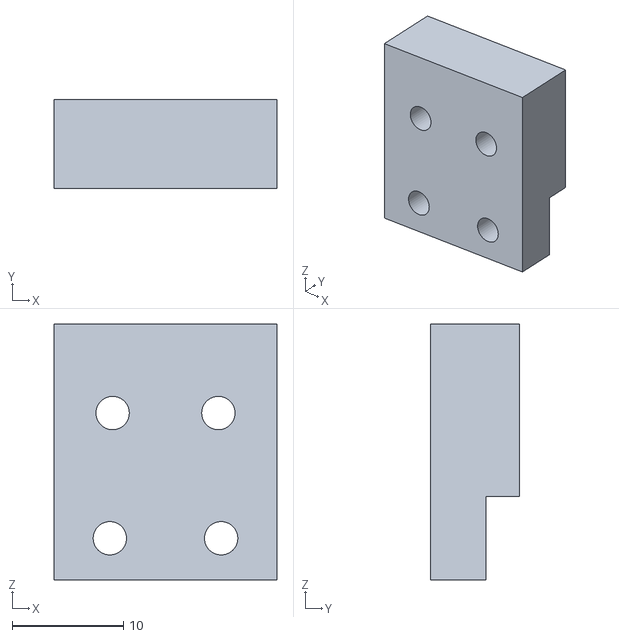
[picture p418: CAD file, 2023-06-13]
Diseny 3D, planos i STL/Arxius STL per impresió 3D/Eix inferior/Soporte final carrera puerta.STL
20.0 x 8.00 x 23.0
