josegd98/MaquinaVending/Diseny 3D, planos i STL/Arxius STL per impresió 3D/Conjunt pinça/Base moviment pinça motor.STL

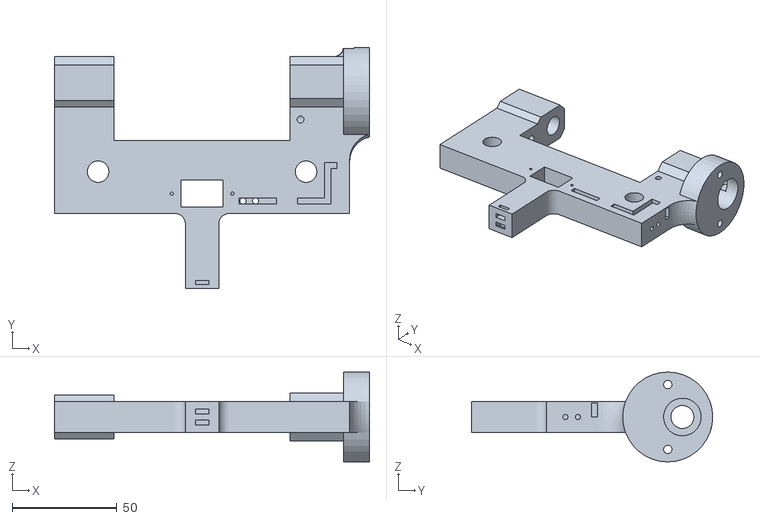
[picture p419: CAD file, 2023-06-13]
Diseny 3D, planos i STL/Arxius STL per impresió 3D/Conjunt pinça/Base moviment pinça motor.STL
150.7 x 115.5 x 43.0
