josegd98/MaquinaVending/Diseny 3D, planos i STL/Ensamblatge Maquina Vending/Ensamblatge 3D Maquina Vending/Embellecedor metacrilato puerta.SLDPRT

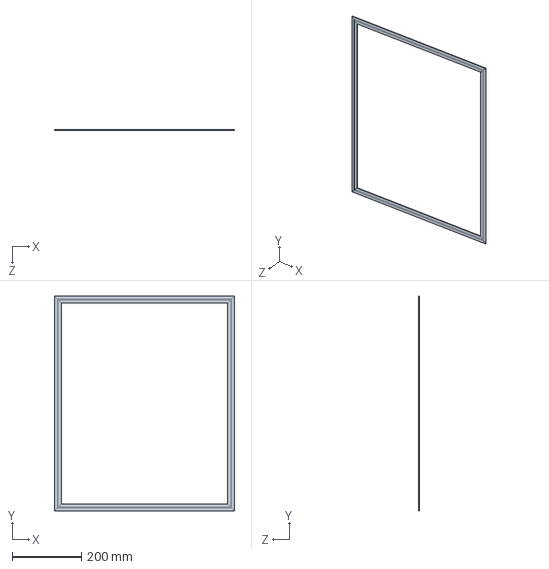
[picture p423: CAD file, 2023-06-13]
Diseny 3D, planos i STL/Ensamblatge Maquina Vending/Ensamblatge 3D Maquina Vending/Embellecedor metacrilato puerta.SLDPRT
520.0 x 620.0 x 2.00 mm
