josegd98/MaquinaVending/Diseny 3D, planos i STL/Ensamblatge Maquina Vending/Ensamblatge 3D Maquina Vending/Canaleta inferior dreta.SLDPRT

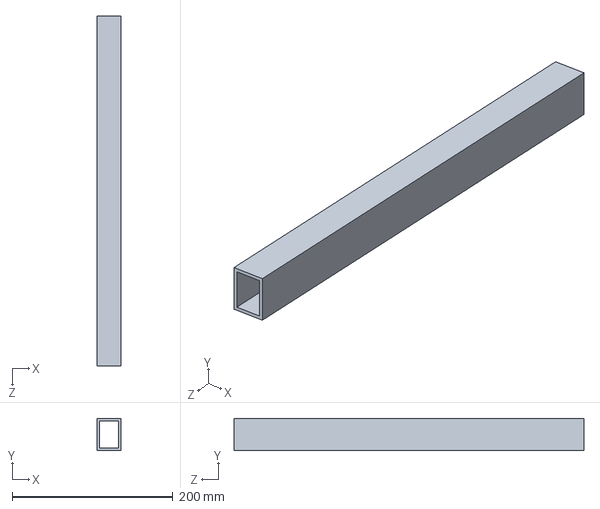
[picture p424: CAD file, 2023-06-13]
Diseny 3D, planos i STL/Ensamblatge Maquina Vending/Ensamblatge 3D Maquina Vending/Canaleta inferior dreta.SLDPRT
30.0 x 40.0 x 435.0 mm
