josegd98/MaquinaVending/Diseny 3D, planos i STL/Ensamblatge Maquina Vending/Ensamblatge 3D Maquina Vending/sensor_ibt8-s02la-d3y2_02.SLDPRT

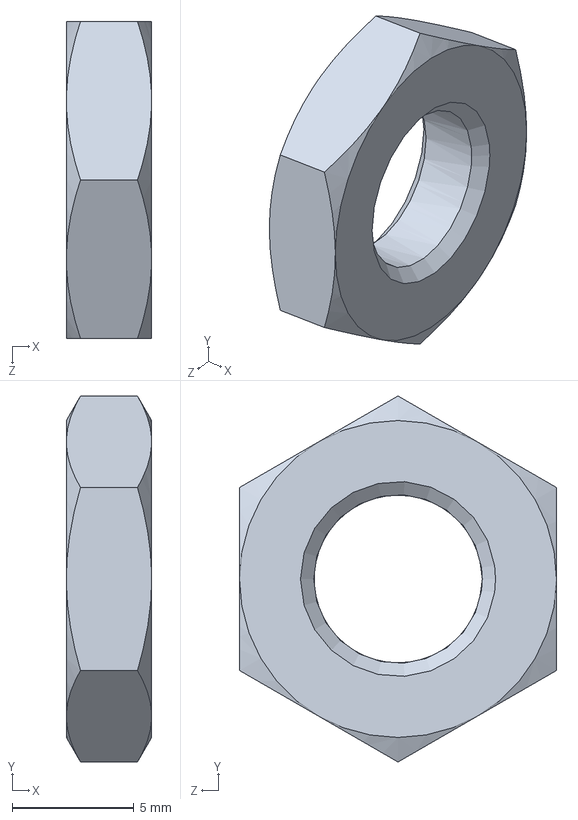
[picture p425: CAD file, 2023-06-13]
Diseny 3D, planos i STL/Ensamblatge Maquina Vending/Ensamblatge 3D Maquina Vending/sensor_ibt8-s02la-d3y2_02.SLDPRT
3.50 x 15.0 x 13.0 mm
