josegd98/MaquinaVending/Diseny 3D, planos i STL/Ensamblatge Maquina Vending/Ensamblatge 3D Maquina Vending/CONNECTION, DC MOTOR, JGB37-520.SLDPRT

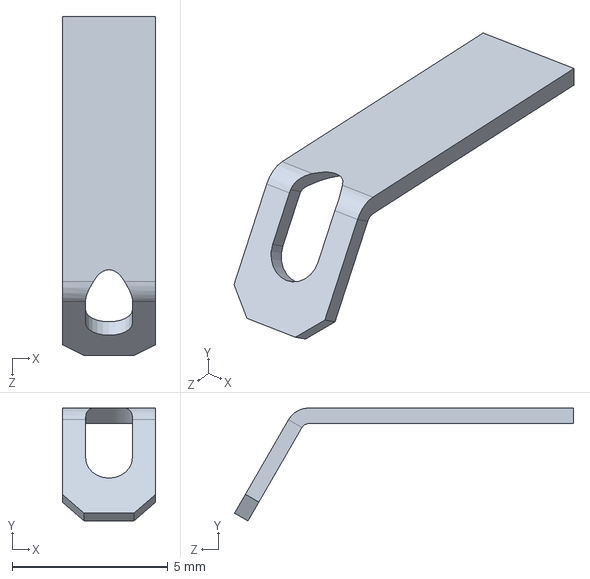
[picture p426: CAD file, 2023-06-13]
Diseny 3D, planos i STL/Ensamblatge Maquina Vending/Ensamblatge 3D Maquina Vending/CONNECTION, DC MOTOR, JGB37-520.SLDPRT
3.00 x 3.62 x 10.9 mm
