josegd98/MaquinaVending/Diseny 3D, planos i STL/Ensamblatge Maquina Vending/Ensamblatge 3D Maquina Vending/Metacrilato ventana.SLDPRT

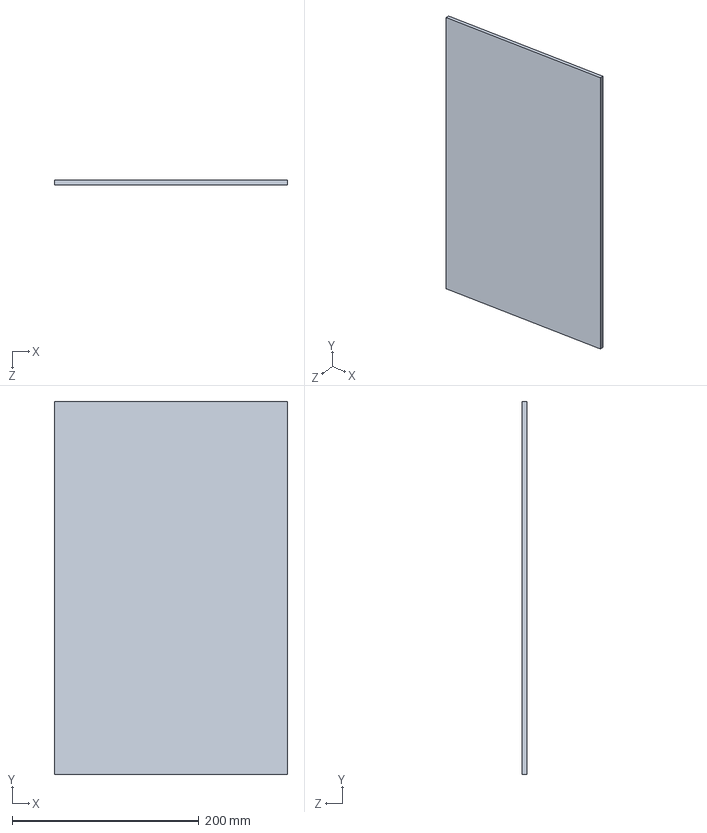
[picture p427: CAD file, 2023-06-13]
Diseny 3D, planos i STL/Ensamblatge Maquina Vending/Ensamblatge 3D Maquina Vending/Metacrilato ventana.SLDPRT
250.0 x 400.0 x 5.00 mm
