josegd98/MaquinaVending/Diseny 3D, planos i STL/Ensamblatge Maquina Vending/Ensamblatge 3D Maquina Vending/Suorts guies inferior.SLDPRT

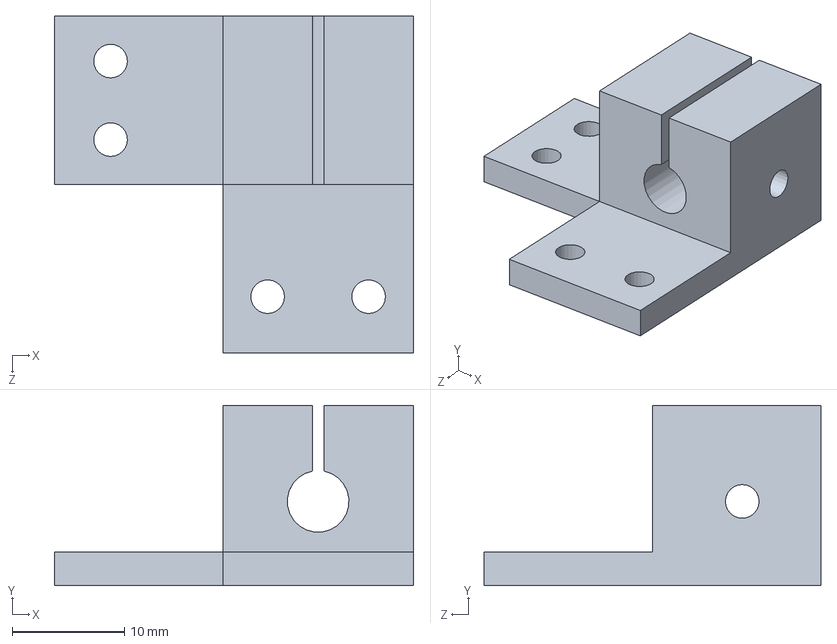
[picture p428: CAD file, 2023-06-13]
Diseny 3D, planos i STL/Ensamblatge Maquina Vending/Ensamblatge 3D Maquina Vending/Suorts guies inferior.SLDPRT
32.0 x 16.1 x 30.0 mm
