josegd98/MaquinaVending/Diseny 3D, planos i STL/Ensamblatge Maquina Vending/Ensamblatge 3D Maquina Vending/Logo Noms i curs.SLDPRT

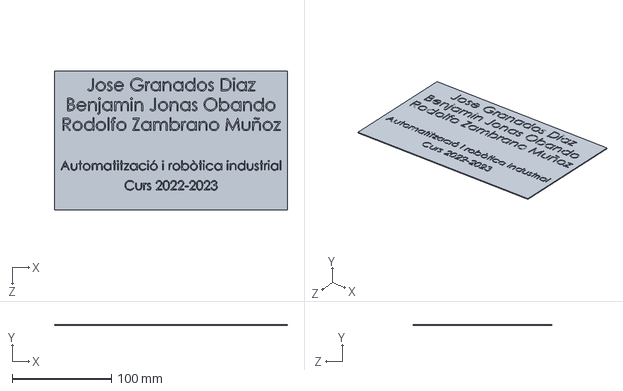
[picture p431: CAD file, 2023-06-13]
Diseny 3D, planos i STL/Ensamblatge Maquina Vending/Ensamblatge 3D Maquina Vending/Logo Noms i curs.SLDPRT
235.0 x 1.00 x 140.0 mm
