josegd98/MaquinaVending/Diseny 3D, planos i STL/Ensamblatge Maquina Vending/Ensamblatge 3D Maquina Vending/Metacrilato puerta.SLDPRT

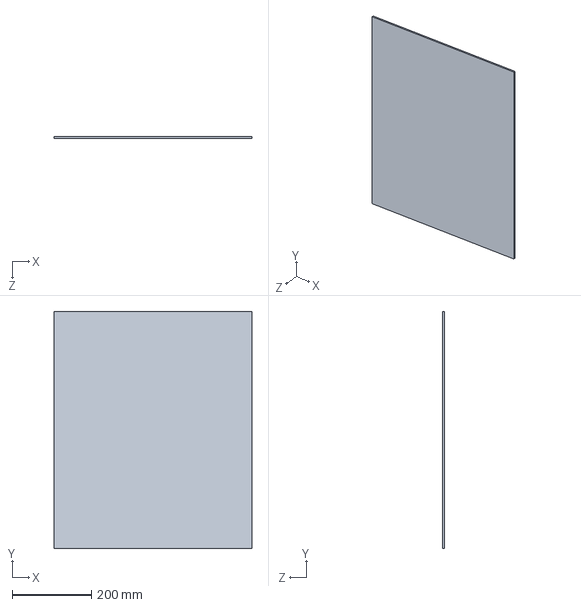
[picture p432: CAD file, 2023-06-13]
Diseny 3D, planos i STL/Ensamblatge Maquina Vending/Ensamblatge 3D Maquina Vending/Metacrilato puerta.SLDPRT
500.0 x 600.0 x 5.00 mm
