josegd98/MaquinaVending/Diseny 3D, planos i STL/Ensamblatge Maquina Vending/Ensamblatge 3D Maquina Vending/NEMA17_Coupler.SLDPRT

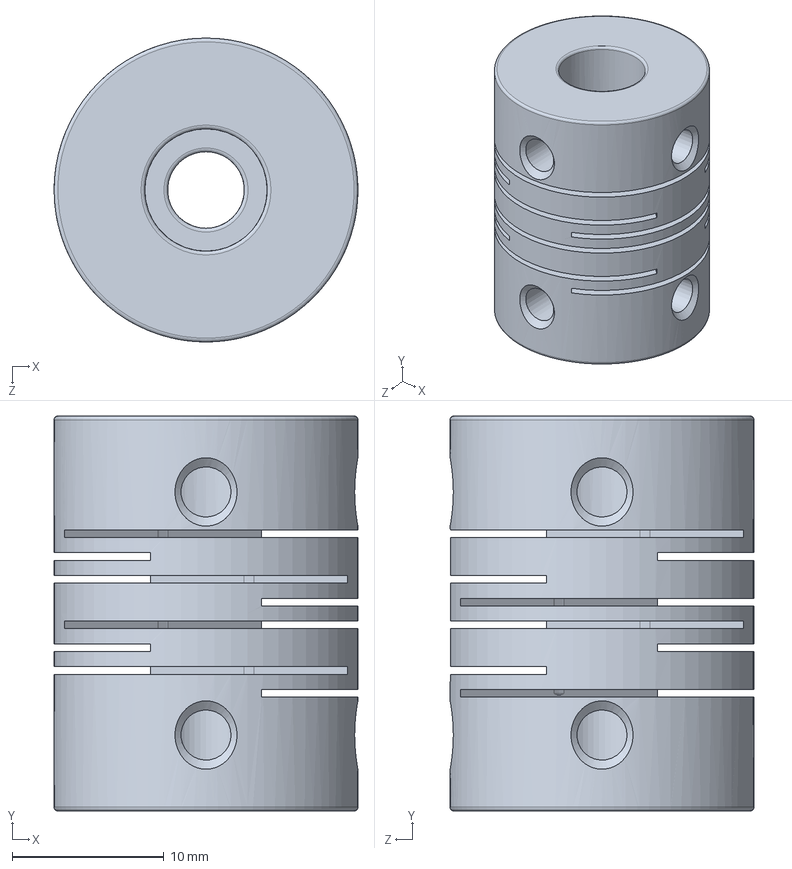
[picture p433: CAD file, 2023-06-13]
Diseny 3D, planos i STL/Ensamblatge Maquina Vending/Ensamblatge 3D Maquina Vending/NEMA17_Coupler.SLDPRT
20.0 x 26.0 x 20.0 mm
