josegd98/MaquinaVending/Diseny 3D, planos i STL/Ensamblatge Maquina Vending/Ensamblatge 3D Maquina Vending/sensor_abt12-n04i-c3y2_03.SLDPRT

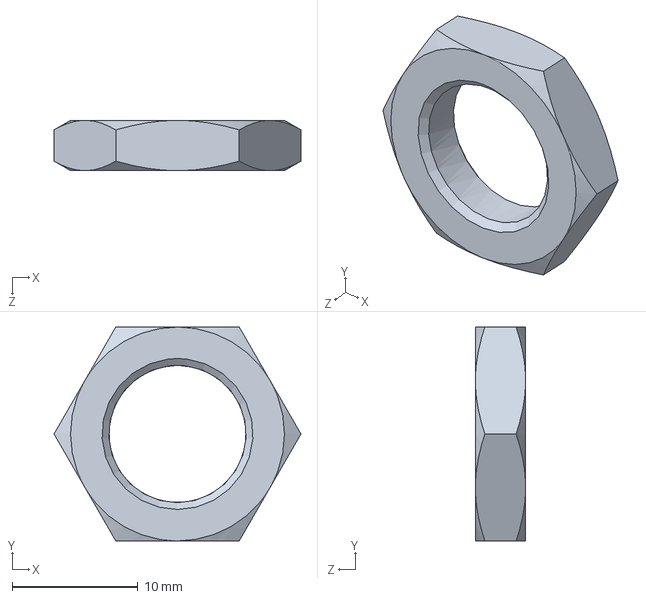
[picture p434: CAD file, 2023-06-13]
Diseny 3D, planos i STL/Ensamblatge Maquina Vending/Ensamblatge 3D Maquina Vending/sensor_abt12-n04i-c3y2_03.SLDPRT
19.6 x 17.0 x 4.00 mm
