josegd98/MaquinaVending/Diseny 3D, planos i STL/Ensamblatge Maquina Vending/Ensamblatge 3D Maquina Vending/Embellecedores cables estanterias base vertical.SLDPRT

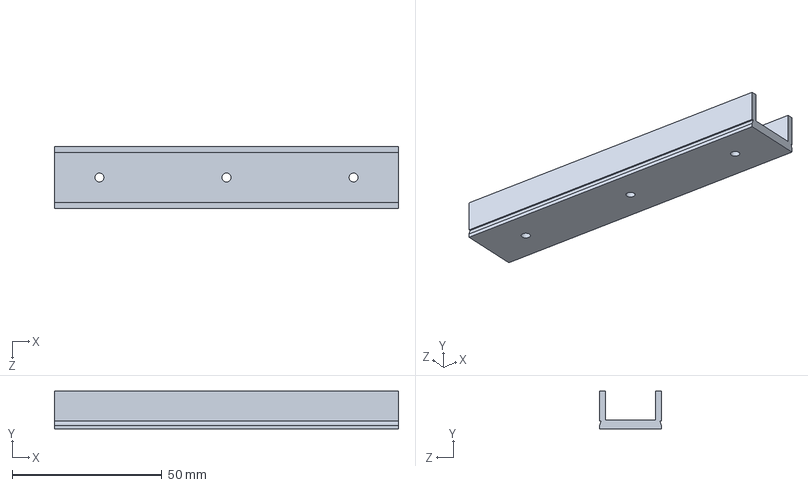
[picture p436: CAD file, 2023-06-13]
Diseny 3D, planos i STL/Ensamblatge Maquina Vending/Ensamblatge 3D Maquina Vending/Embellecedores cables estanterias base vertical.SLDPRT
115.0 x 12.7 x 20.7 mm
