josegd98/MaquinaVending/Diseny 3D, planos i STL/Ensamblatge Maquina Vending/Ensamblatge 3D Maquina Vending/COUPLING BRACKET, GEARED BODY TO DC MOTOR, JGB37-520.SLDPRT

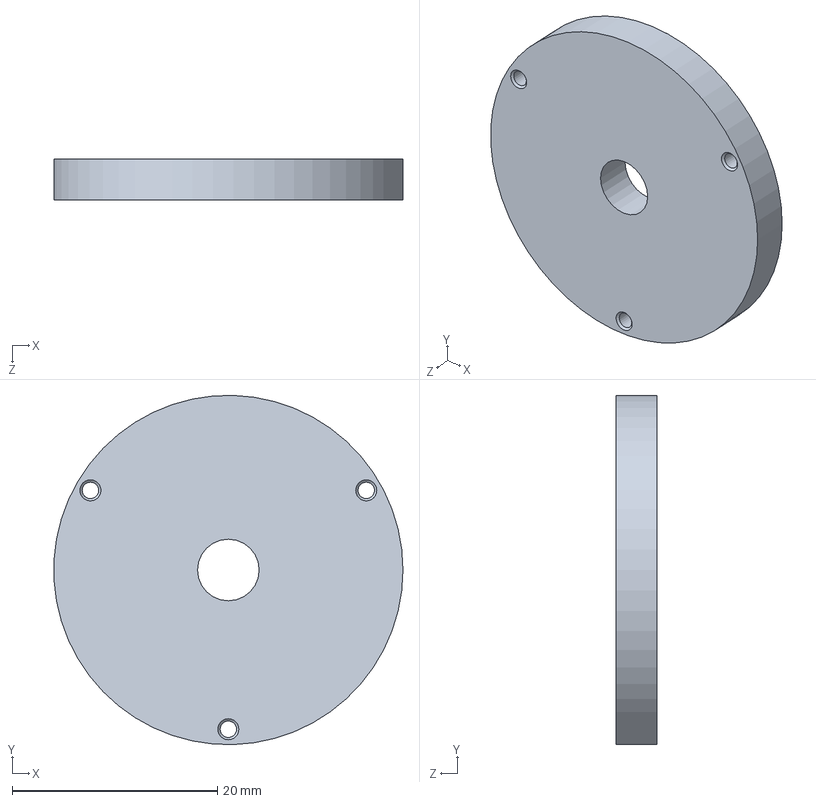
[picture p437: CAD file, 2023-06-13]
Diseny 3D, planos i STL/Ensamblatge Maquina Vending/Ensamblatge 3D Maquina Vending/COUPLING BRACKET, GEARED BODY TO DC MOTOR, JGB37-520.SLDPRT
34.0 x 34.0 x 4.00 mm
