josegd98/MaquinaVending/Diseny 3D, planos i STL/Ensamblatge Maquina Vending/Ensamblatge 3D Maquina Vending/Transmotec-Cad-PD2232-198--455-BFE.stp.SLDPRT

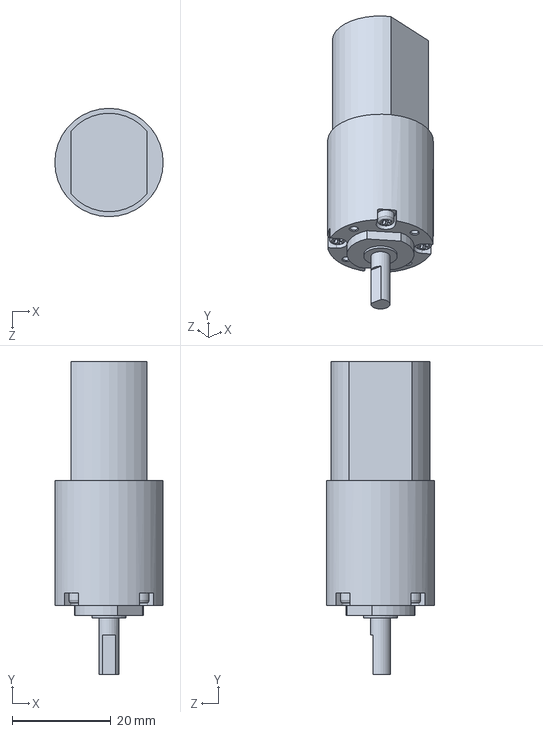
[picture p439: CAD file, 2023-06-13]
Diseny 3D, planos i STL/Ensamblatge Maquina Vending/Ensamblatge 3D Maquina Vending/Transmotec-Cad-PD2232-198--455-BFE.stp.SLDPRT
22.0 x 63.5 x 22.0 mm
