josegd98/MaquinaVending/Diseny 3D, planos i STL/Ensamblatge Maquina Vending/Ensamblatge 3D Maquina Vending/MOTOR SHAFT, JGB37-520.SLDPRT

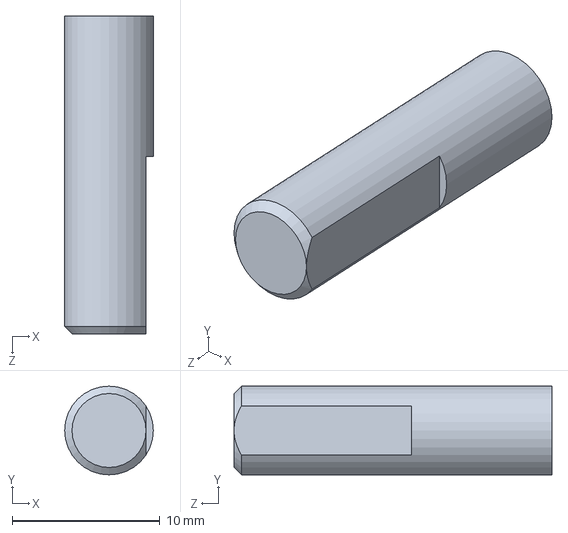
[picture p440: CAD file, 2023-06-13]
Diseny 3D, planos i STL/Ensamblatge Maquina Vending/Ensamblatge 3D Maquina Vending/MOTOR SHAFT, JGB37-520.SLDPRT
6.00 x 6.00 x 21.5 mm
