josegd98/MaquinaVending/(list of files, cad)

Other CAD files:
Diseny 3D, planos i STL/Ensamblatge Maquina Vending/Ensamblatge 3D Maquina Vending/6av21232gb030ax0_99.SLDPRT
Diseny 3D, planos i STL/Ensamblatge Maquina Vending/Ensamblatge 3D Maquina Vending/6av21232gb030ax0_73.SLDPRT
Diseny 3D, planos i STL/Ensamblatge Maquina Vending/Ensamblatge 3D Maquina Vending/6av21232gb030ax0_91.SLDPRT
Diseny 3D, planos i STL/Arxius STL per impresió 3D/Conjunt pinça/Pinça impressio 3d esquerra 2 v final.STL
Diseny 3D, planos i STL/Arxius STL per impresió 3D/Eix inferior/Suports Guia lineal infrerior 1.STL
Diseny 3D, planos i STL/Ensamblatge Maquina Vending/Ensamblatge 3D Maquina Vending/6av21232gb030ax0_54.SLDPRT
Diseny 3D, planos i STL/Ensamblatge Maquina Vending/Ensamblatge 3D Maquina Vending/6av21232gb030ax0_38.SLDPRT
Diseny 3D, planos i STL/Ensamblatge Maquina Vending/Ensamblatge 3D Maquina Vending/17ME15-1504S.step.SLDPRT
Diseny 3D, planos i STL/Ensamblatge Maquina Vending/Ensamblatge 3D Maquina Vending/6av21232gb030ax0_81.SLDPRT
Diseny 3D, planos i STL/Ensamblatge Maquina Vending/Ensamblatge 3D Maquina Vending/6av21232gb030ax0_18.SLDPRT
Diseny 3D, planos i STL/Ensamblatge Maquina Vending/Ensamblatge 3D Maquina Vending/6av21232gb030ax0_82.SLDPRT
Diseny 3D, planos i STL/Ensamblatge Maquina Vending/Ensamblatge 3D Maquina Vending/6av21232gb030ax0_44.SLDPRT
Diseny 3D, planos i STL/Ensamblatge Maquina Vending/Ensamblatge 3D Maquina Vending/6av21232gb030ax0_26.SLDPRT
Diseny 3D, planos i STL/Ensamblatge Maquina Vending/Ensamblatge 3D Maquina Vending/6av21232gb030ax0_90.SLDPRT
Diseny 3D, planos i STL/Ensamblatge Maquina Vending/Ensamblatge 3D Maquina Vending/Estanteria giratoria 2.SLDPRT
Diseny 3D, planos i STL/Ensamblatge Maquina Vending/Ensamblatge 3D Maquina Vending/6av21232gb030ax0_87.SLDPRT
Diseny 3D, planos i STL/Ensamblatge Maquina Vending/Ensamblatge 3D Maquina Vending/Suport rampa.SLDPRT
Diseny 3D, planos i STL/Ensamblatge Maquina Vending/Ensamblatge 3D Maquina Vending/Soporte eje 8mm.SLDPRT
Diseny 3D, planos i STL/Ensamblatge Maquina Vending/Ensamblatge 3D Maquina Vending/Suport sensor origen.SLDPRT
Diseny 3D, planos i STL/Ensamblatge Maquina Vending/Ensamblatge 3D Maquina Vending/6av21232gb030ax0_32.SLDPRT
Diseny 3D, planos i STL/Ensamblatge Maquina Vending/Ensamblatge 3D Maquina Vending/Suporte polea loca.SLDPRT
Diseny 3D, planos i STL/Ensamblatge Maquina Vending/Ensamblatge 3D Maquina Vending/6av21232gb030ax0_30.SLDPRT
Diseny 3D, planos i STL/Ensamblatge Maquina Vending/Ensamblatge 3D Maquina Vending/Suport sensor difusor.SLDPRT
Diseny 3D, planos i STL/Ensamblatge Maquina Vending/Ensamblatge 3D Maquina Vending/Suorts guies.SLDPRT
Diseny 3D, planos i STL/Ensamblatge Maquina Vending/Ensamblatge 3D Maquina Vending/Carregador peces grans 2.SLDPRT
Diseny 3D, planos i STL/Ensamblatge Maquina Vending/Ensamblatge 3D Maquina Vending/6av21232gb030ax0_93.SLDPRT
Diseny 3D, planos i STL/Ensamblatge Maquina Vending/Ensamblatge 3D Maquina Vending/xub0bnsnl2_03.SLDPRT
Diseny 3D, planos i STL/Ensamblatge Maquina Vending/Ensamblatge 3D Maquina Vending/6av21232gb030ax0_100.SLDPRT
Diseny 3D, planos i STL/Ensamblatge Maquina Vending/Ensamblatge 3D Maquina Vending/6av21232gb030ax0_10.SLDPRT
Diseny 3D, planos i STL/Ensamblatge Maquina Vending/Ensamblatge 3D Maquina Vending/Casquillo pinza.SLDPRT
Diseny 3D, planos i STL/Ensamblatge Maquina Vending/Ensamblatge 3D Maquina Vending/6av21232gb030ax0_09.SLDPRT
Diseny 3D, planos i STL/Ensamblatge Maquina Vending/Ensamblatge 3D Maquina Vending/6av21232gb030ax0_42.SLDPRT
Diseny 3D, planos i STL/Ensamblatge Maquina Vending/Ensamblatge 3D Maquina Vending/6av21232gb030ax0_55.SLDPRT
Diseny 3D, planos i STL/Ensamblatge Maquina Vending/Ensamblatge 3D Maquina Vending/6av21232gb030ax0_94.SLDPRT
Diseny 3D, planos i STL/Ensamblatge Maquina Vending/Ensamblatge 3D Maquina Vending/6av21232gb030ax0_65.SLDPRT
Diseny 3D, planos i STL/Ensamblatge Maquina Vending/Ensamblatge 3D Maquina Vending/byms721-1s-1_03.SLDPRT
Diseny 3D, planos i STL/Ensamblatge Maquina Vending/Ensamblatge 3D Maquina Vending/Tapa estanteries.SLDPRT
Diseny 3D, planos i STL/Ensamblatge Maquina Vending/Ensamblatge 3D Maquina Vending/6av21232gb030ax0_72.SLDPRT
Diseny 3D, planos i STL/Ensamblatge Maquina Vending/Ensamblatge 3D Maquina Vending/6av21232gb030ax0_17.SLDPRT
Diseny 3D, planos i STL/Ensamblatge Maquina Vending/Ensamblatge 3D Maquina Vending/6av21232gb030ax0_48.SLDPRT
Diseny 3D, planos i STL/Ensamblatge Maquina Vending/Ensamblatge 3D Maquina Vending/6av21232gb030ax0_24.SLDPRT
Diseny 3D, planos i STL/Ensamblatge Maquina Vending/Ensamblatge 3D Maquina Vending/6av21232gb030ax0_80.SLDPRT
Diseny 3D, planos i STL/Ensamblatge Maquina Vending/Ensamblatge 3D Maquina Vending/6av21232gb030ax0_01.SLDPRT
Diseny 3D, planos i STL/Ensamblatge Maquina Vending/Ensamblatge 3D Maquina Vending/6av21232gb030ax0_75.SLDPRT
Diseny 3D, planos i STL/Ensamblatge Maquina Vending/Ensamblatge 3D Maquina Vending/6av21232gb030ax0_11.SLDPRT
Diseny 3D, planos i STL/Ensamblatge Maquina Vending/Ensamblatge 3D Maquina Vending/6av21232gb030ax0_04.SLDPRT
Diseny 3D, planos i STL/Ensamblatge Maquina Vending/Ensamblatge 3D Maquina Vending/6av21232gb030ax0_23.SLDPRT
Diseny 3D, planos i STL/Ensamblatge Maquina Vending/Ensamblatge 3D Maquina Vending/Alzador piezad pequeñas.SLDPRT
Diseny 3D, planos i STL/Ensamblatge Maquina Vending/Ensamblatge 3D Maquina Vending/6av21232gb030ax0_88.SLDPRT
Diseny 3D, planos i STL/Ensamblatge Maquina Vending/Ensamblatge 3D Maquina Vending/Soporte correa arrastre 2.SLDPRT
Diseny 3D, planos i STL/Ensamblatge Maquina Vending/Ensamblatge 3D Maquina Vending/6av21232gb030ax0_59.SLDPRT
Diseny 3D, planos i STL/Ensamblatge Maquina Vending/Ensamblatge 3D Maquina Vending/6av21232gb030ax0_67.SLDPRT
Diseny 3D, planos i STL/Ensamblatge Maquina Vending/Ensamblatge 3D Maquina Vending/6av21232gb030ax0_06.SLDPRT
Diseny 3D, planos i STL/Ensamblatge Maquina Vending/Ensamblatge 3D Maquina Vending/6av21232gb030ax0_43.SLDPRT
Diseny 3D, planos i STL/Ensamblatge Maquina Vending/Ensamblatge 3D Maquina Vending/6av21232gb030ax0_79.SLDPRT
Diseny 3D, planos i STL/Ensamblatge Maquina Vending/Ensamblatge 3D Maquina Vending/Soporte cadena pinza.SLDPRT
Diseny 3D, planos i STL/Ensamblatge Maquina Vending/Ensamblatge 3D Maquina Vending/6av21232gb030ax0_47.SLDPRT
Diseny 3D, planos i STL/Ensamblatge Maquina Vending/Ensamblatge 3D Maquina Vending/Separador base pinça.SLDPRT
Diseny 3D, planos i STL/Ensamblatge Maquina Vending/Ensamblatge 3D Maquina Vending/Tapa base recollida.SLDPRT
Diseny 3D, planos i STL/Ensamblatge Maquina Vending/Ensamblatge 3D Maquina Vending/6av21232gb030ax0_28.SLDPRT
Diseny 3D, planos i STL/Ensamblatge Maquina Vending/Ensamblatge 3D Maquina Vending/Suport rodaments 8mm eix inferior.SLDPRT
Diseny 3D, planos i STL/Ensamblatge Maquina Vending/Ensamblatge 3D Maquina Vending/Suports Guia lineal infrerior 1.SLDPRT
Diseny 3D, planos i STL/Ensamblatge Maquina Vending/Ensamblatge 3D Maquina Vending/6av21232gb030ax0_62.SLDPRT
Diseny 3D, planos i STL/Ensamblatge Maquina Vending/Ensamblatge 3D Maquina Vending/6av21232gb030ax0_34.SLDPRT
Diseny 3D, planos i STL/Ensamblatge Maquina Vending/Ensamblatge 3D Maquina Vending/Carregador peces petites.SLDPRT
Diseny 3D, planos i STL/Ensamblatge Maquina Vending/Ensamblatge 3D Maquina Vending/6av21232gb030ax0_45.SLDPRT
Diseny 3D, planos i STL/Arxius STL per impresió 3D/Clauer EDN/Clauer EDN.STL
Diseny 3D, planos i STL/Arxius STL per impresió 3D/Complements/M3_2040_T-Nut.stl
Diseny 3D, planos i STL/Ensamblatge Maquina Vending/Ensamblatge 3D Maquina Vending/17ME15-1504S.STEP
Diseny 3D, planos i STL/Ensamblatge Maquina Vending/Ensamblatge 3D Maquina Vending/6av21232gb030ax0_02.SLDPRT
Diseny 3D, planos i STL/Ensamblatge Maquina Vending/Ensamblatge 3D Maquina Vending/6av21232gb030ax0_03.SLDPRT
Diseny 3D, planos i STL/Ensamblatge Maquina Vending/Ensamblatge 3D Maquina Vending/6av21232gb030ax0_05.SLDPRT
Diseny 3D, planos i STL/Ensamblatge Maquina Vending/Ensamblatge 3D Maquina Vending/6av21232gb030ax0_07.SLDPRT
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
