josegd98/MaquinaVending/Documentació Projecte/Esquema Electric Màquina Vending.pdf

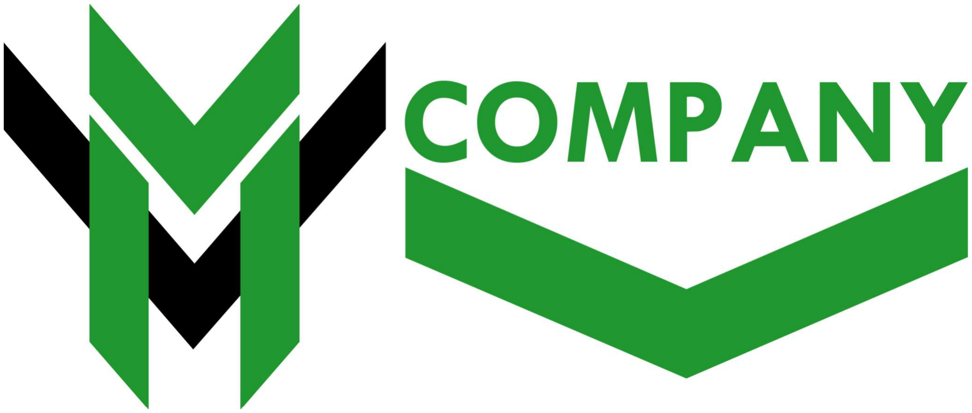
[picture p462: figure]

Fecha: | Numero de paginas total

# Descripción

## Responsable del proyecto

# MAQUINA DE VENDING AUTOMATITZADA

Empresa | Vending Machine Company
| Maquina de vending automatitzada de material de ferreteria

## Lugar instalación

## Jonas Obando, Jose Granados, Rodolfo zambrano

## Taller

Fecha: | | Modificaciones: | 00 ¹⁵/11/2022 Page:
Responable: | Jonás Obando, Jose Granados, Rodolfo Zambrano
Proyecto: | Maquina de vending automatizada | Verificar: | Ref:
Cliente: | Vending machine company
0 | 7 1 | 2 | 5 3 | 4 | 6 | 8 | 9
15/11/2022 | 26

Page | Page description | Supplementary page field | Date | Edited by | X
=Esquema electrico+/1 | | | 24/11/2022 | carlo Resumen de regleta de bornes : L1 - 1
=Esquema electrico+/2 | Indice de páginas : =Esquema electrico+/1 - =Esquema electrico+/23 | | 24/11/2022 | carlo
=Esquema electrico+/00 | | | 24/11/2022 | carlo Perspectiva de la maquina
=Esquema electrico+/01 | | | 23/11/2022 | carlo Alimentación general
=Esquema electrico+/02 | | | 24/11/2022 | carlo Alimentación de los motores DC
=Esquema electrico+/03 | | | 24/11/2022 | carlo Disctribución de conexiones
=Esquema electrico+/04 | | | 23/11/2022 | carlo PLC Entradas 1
=Esquema electrico+/05 | | | 23/11/2022 | carlo PLC Entradas 2
=Esquema electrico+/06 | | | 23/11/2022 | carlo Modulo de Entradas 1
=Esquema electrico+/07 | | | 23/11/2022 | carlo Modulo de Entradas 2
=Esquema electrico+/08 | | | 23/11/2022 | carlo PLC Salidas
=Esquema electrico+/09 | | | 23/11/2022 | carlo Modulo de salidas 1
=Esquema electrico+/10 | | | 23/11/2022 | carlo Modulo de salidas 2
=Esquema electrico+/11 | | | 23/11/2022 | carlo Control de Motor paso a paso
=Esquema electrico+/12 | | | 23/11/2022 | carlo Controlador Motor DC
=Esquema electrico+/13 | | | 23/11/2022 | carlo Pantalla HMI
=Esquema electrico+/14 | | | 23/11/2022 | carlo Indutrial Shield y ESP32
=Esquema electrico+/15 | | | 23/11/2022 | carlo Armario Electrico 1
=Esquema electrico+/16 | | | 23/11/2022 | carlo Armario Electrico 3
=Esquema electrico+/17 | | | 23/11/2022 | carlo Armario Electrico 2
=Esquema electrico+/18 | | | 24/11/2022 | carlo Terminal diagram =Esquema electrico+-X1
=Esquema electrico+/19 | | | 24/11/2022 | carlo Terminal diagram =Esquema electrico+-X2
=Esquema electrico+/20 | | | 24/11/2022 | carlo Terminal diagram =Esquema electrico+-X3
=Esquema electrico+/21 | | | 24/11/2022 | carlo Terminal diagram =Esquema electrico+-X4
=Esquema electrico+/22 | | | 24/11/2022 | carlo Terminal diagram =Esquema electrico+-X4
=Esquema electrico+/23 | | | 24/11/2022 | carlo Terminal diagram =Esquema electrico+-X4

Column X: An automatically generated page was edited

# Table of contents

F06_001

15/11/2022 | INDICE
Jonás Obando, Jose Granados, Rodolfo Zambrano

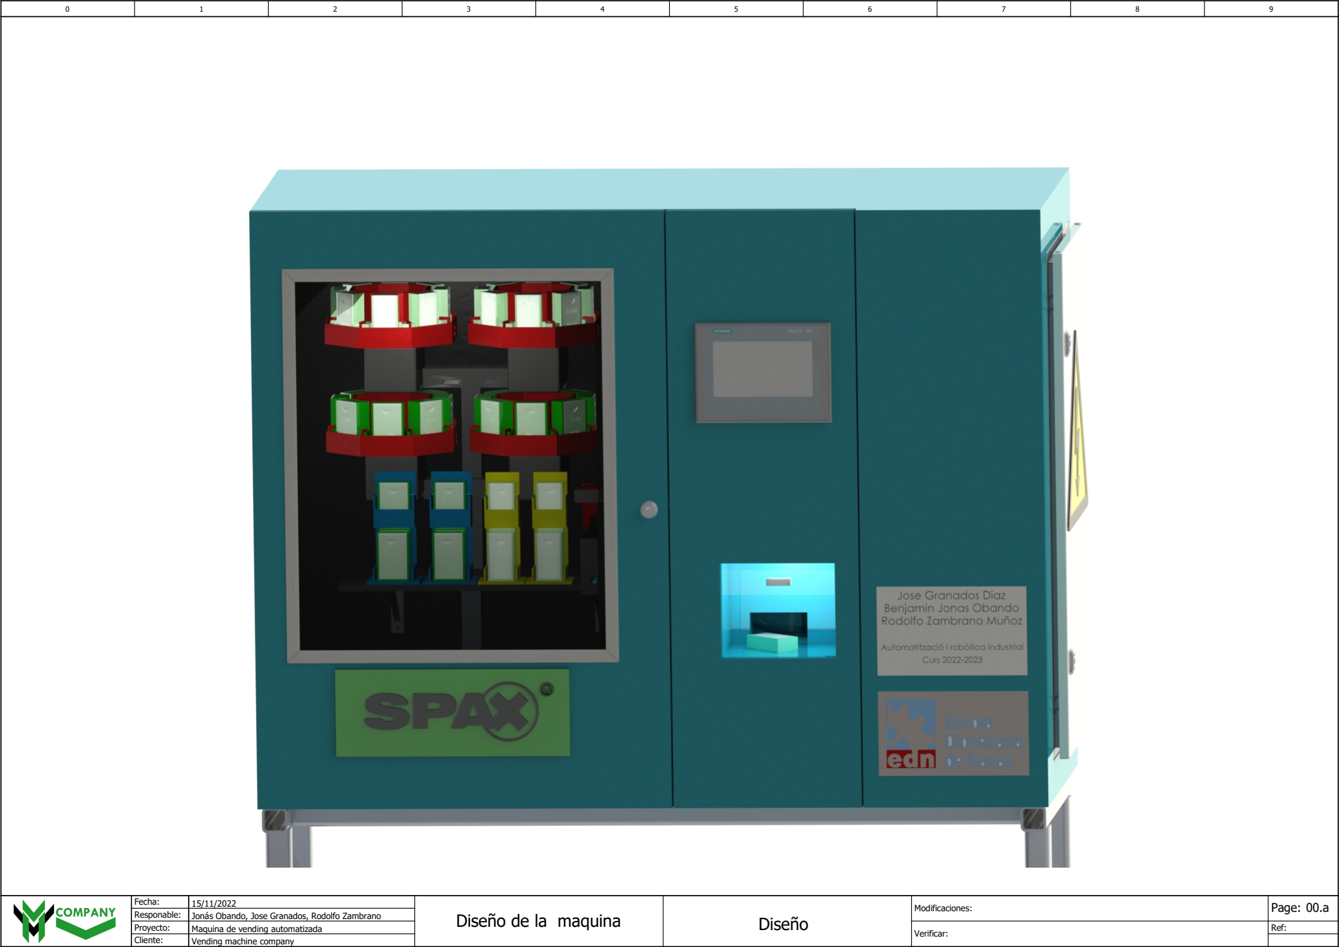
[picture p463: page 3]

0 | 1 | 2 | 3 | 4 | 5 | 6 | 7 | 8 | 9
Diseño de la maquina | Diseño

15/11/2022
00.a

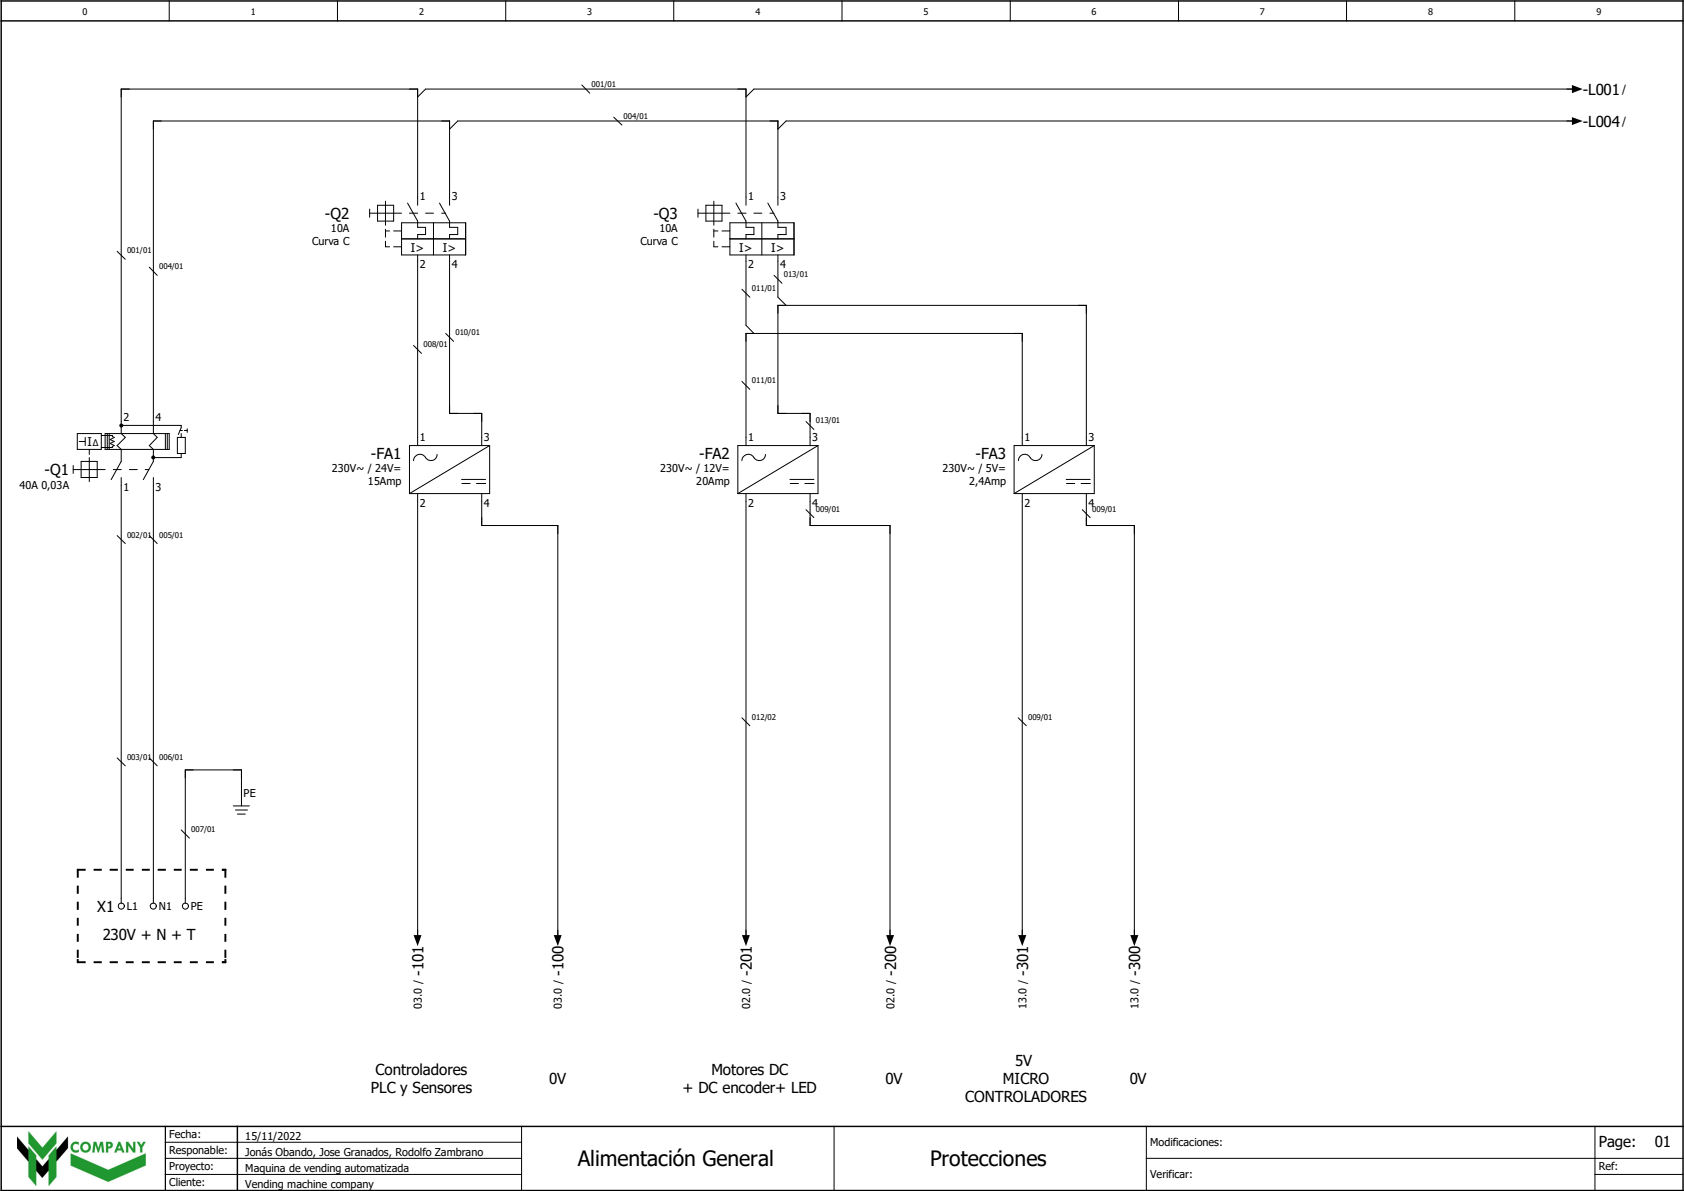
[picture p464: page 4]
Controladores; PLC y Sensores; Alimentación General; Protecciones; 5V MICRO CONTROLADORES; -FA1 230V~ / 24V= 15Amp; Curva C; -FA2 230V~ / 12V= 20Amp; -FA3 230V~ / 5V= 2,4Amp

Motores DC
+ DC encoder+ LED

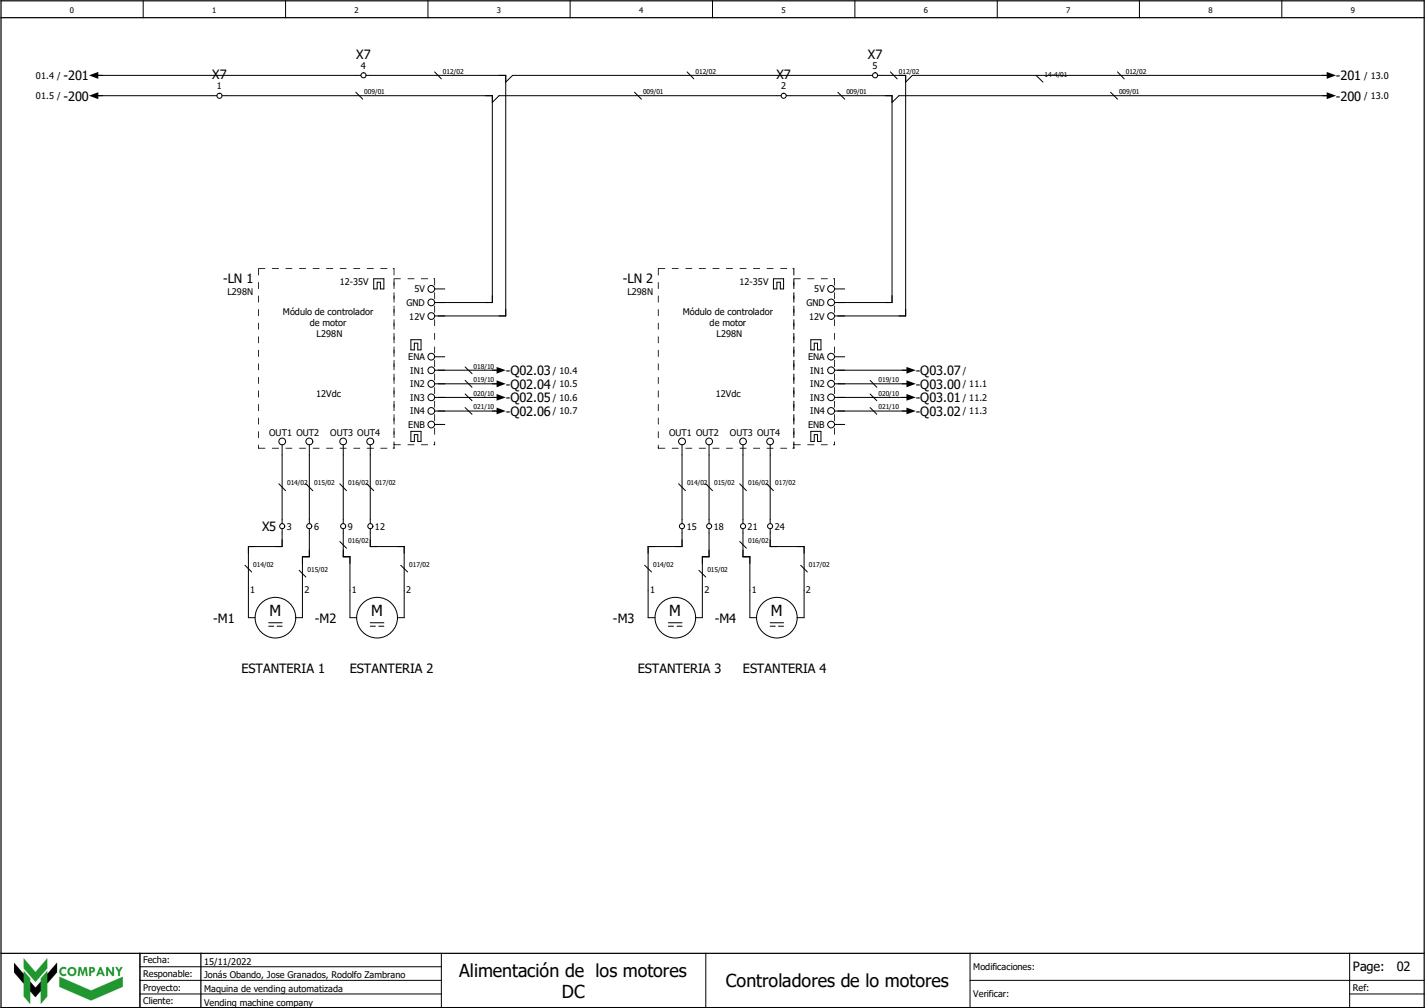
[picture p465: page 5]
12Vdc; Controladores de lo motores; ESTANTERIA 1; ESTANTERIA 2; ESTANTERIA 3; ESTANTERIA 4; OUT3 OUT4; ENB; ENA; 5V GND 12V; OUT1 OUT2

Módulo de controlador
de motor

Alimentación de los motores

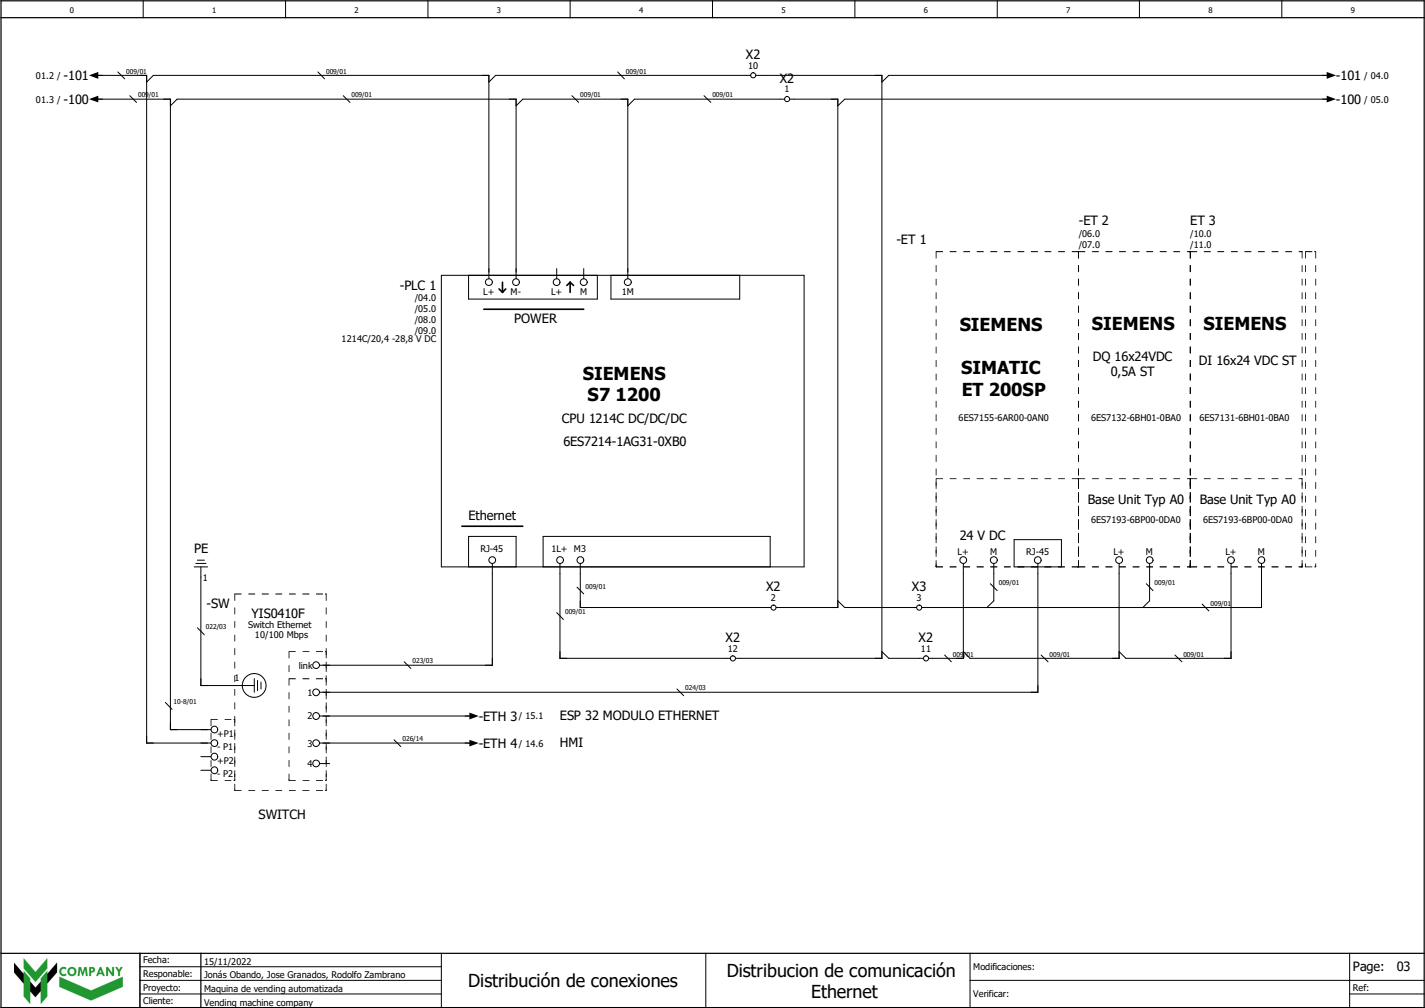
[picture p466: page 6]
SIEMENS S7 1200; POWER; CPU 1214C DC/DC/DC; SIEMENS; SIMATIC ET 200SP; DQ 16x24VDC 0,5A ST; YIS0410F Switch Ethernet 10/100 Mbps; Ethernet; SWITCH; Distribución de conexiones; Distribucion de comunicación; -PLC 1 /04.0 /05.0 /08.0 /09.0 1214C/20,4 -28,8 V DC; link; -ETH 3/ 15.1; -ETH 4/ 14.6

DI 16x24 VDC ST

Base Unit Typ A0

ESP 32 MODULO ETHERNET
HMI

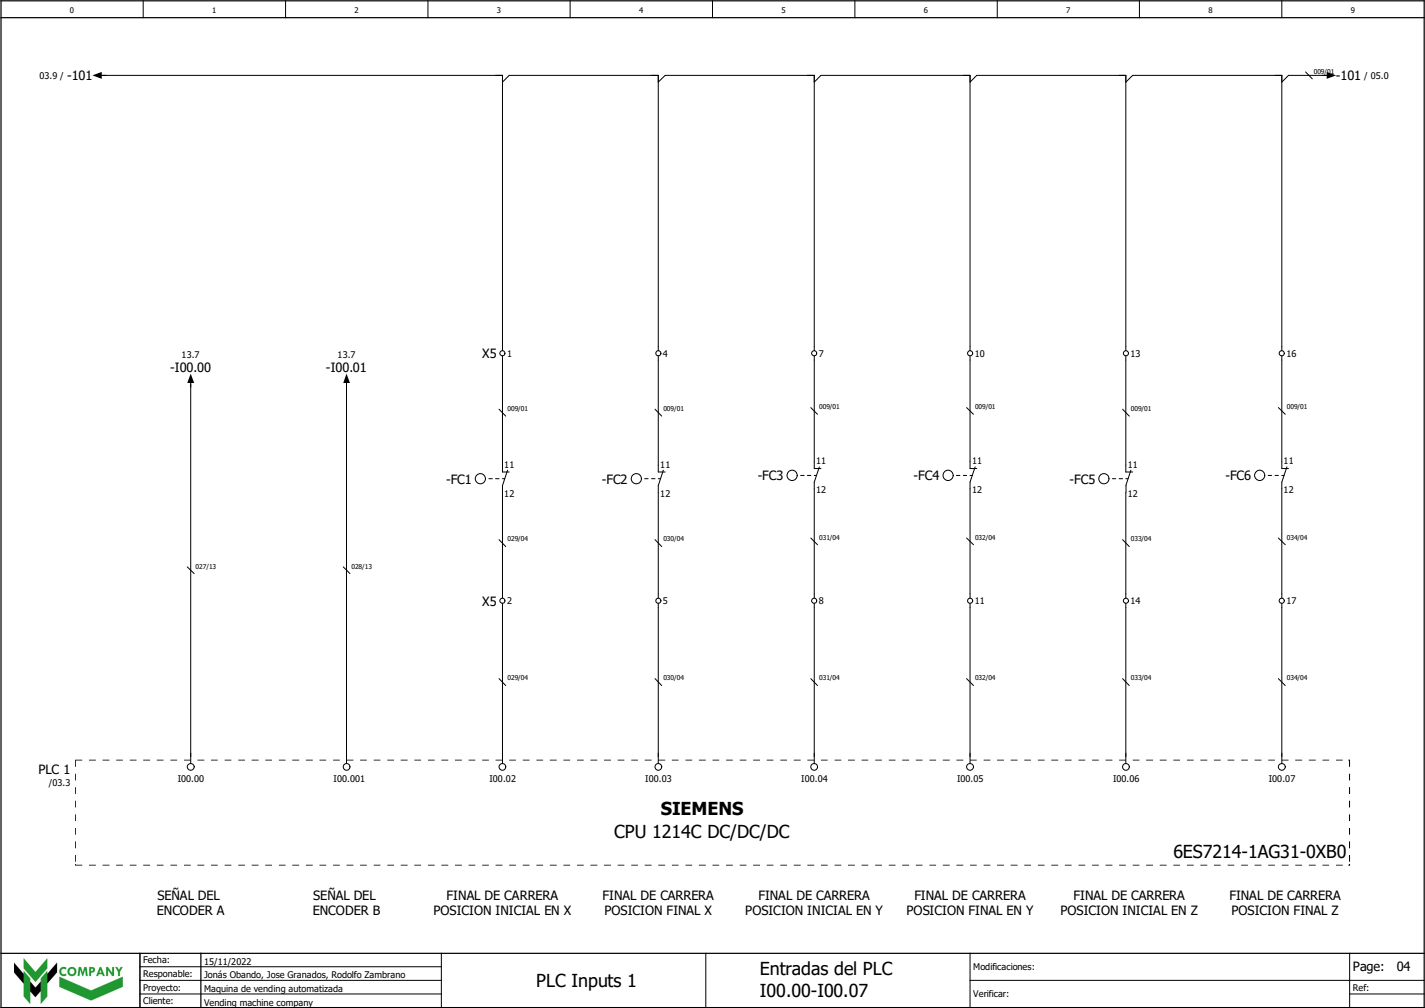
[picture p467: page 7]
PLC Inputs 1; Entradas del PLC; SEÑAL DEL ENCODER B; SEÑAL DEL ENCODER A; PLC 1 /03.3

SIEMENS
CPU 1214C DC/DC/DC

FINAL DE CARRERA
POSICION INICIAL EN X

POSICION FINAL X

POSICION INICIAL EN Y

POSICION FINAL EN Y

POSICION INICIAL EN Z

POSICION FINAL Z

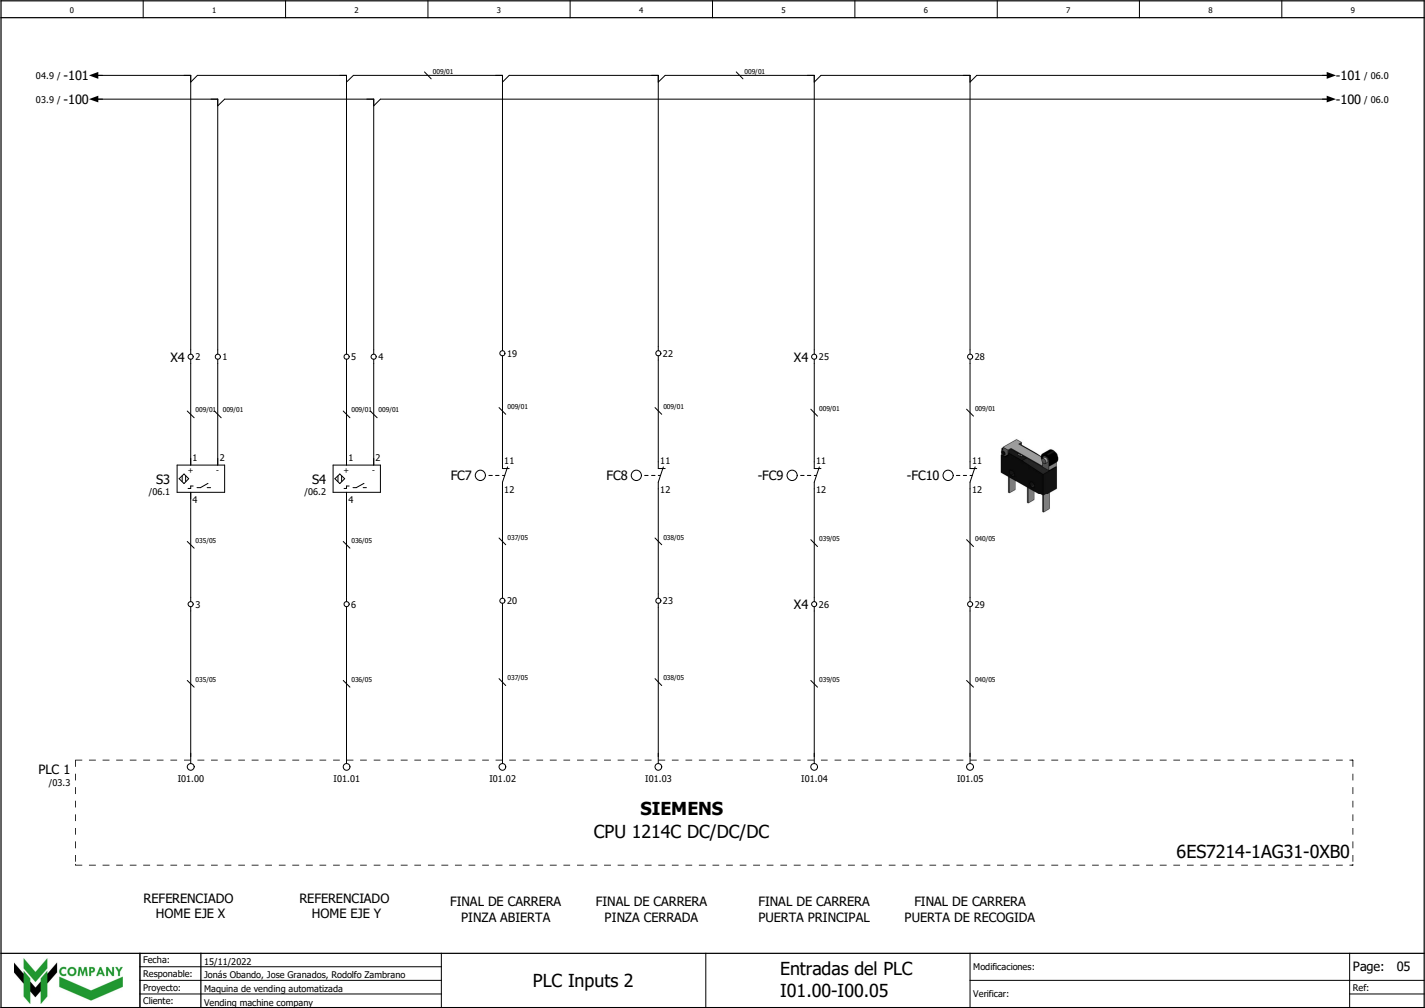
[picture p468: page 8]
PLC Inputs 2; Entradas del PLC; REFERENCIADO HOME EJE X; REFERENCIADO HOME EJE Y; PLC 1 /03.3

SIEMENS
CPU 1214C DC/DC/DC

FINAL DE CARRERA
PINZA ABIERTA

PINZA CERRADA

PUERTA PRINCIPAL

PUERTA DE RECOGIDA

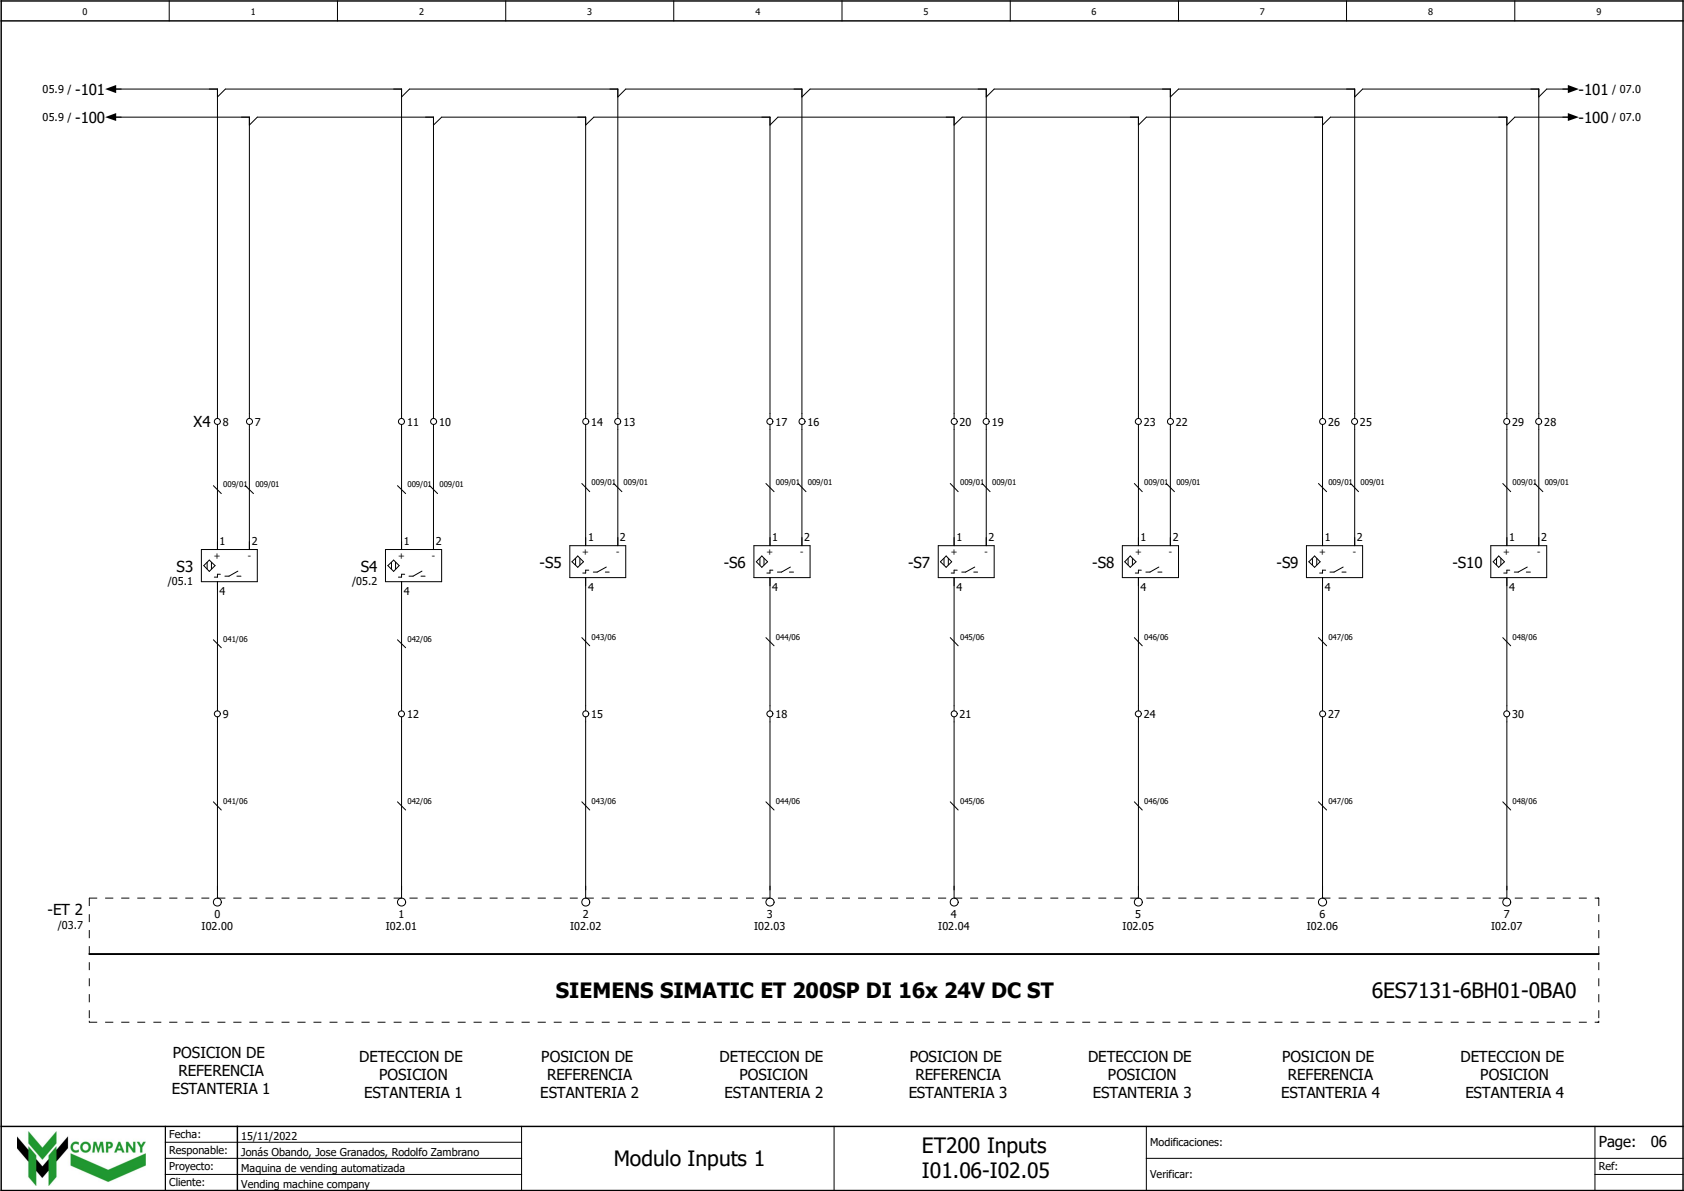
[picture p469: page 9]
SIEMENS SIMATIC ET 200SP DI 16x 24V DC ST; POSICION DE REFERENCIA ESTANTERIA 2; DETECCION DE POSICION ESTANTERIA 2; POSICION DE REFERENCIA ESTANTERIA 3; DETECCION DE POSICION ESTANTERIA 3; DETECCION DE POSICION ESTANTERIA 4; POSICION DE REFERENCIA ESTANTERIA 4; Modulo Inputs 1; ET200 Inputs; POSICION DE REFERENCIA ESTANTERIA 1; DETECCION DE POSICION ESTANTERIA 1

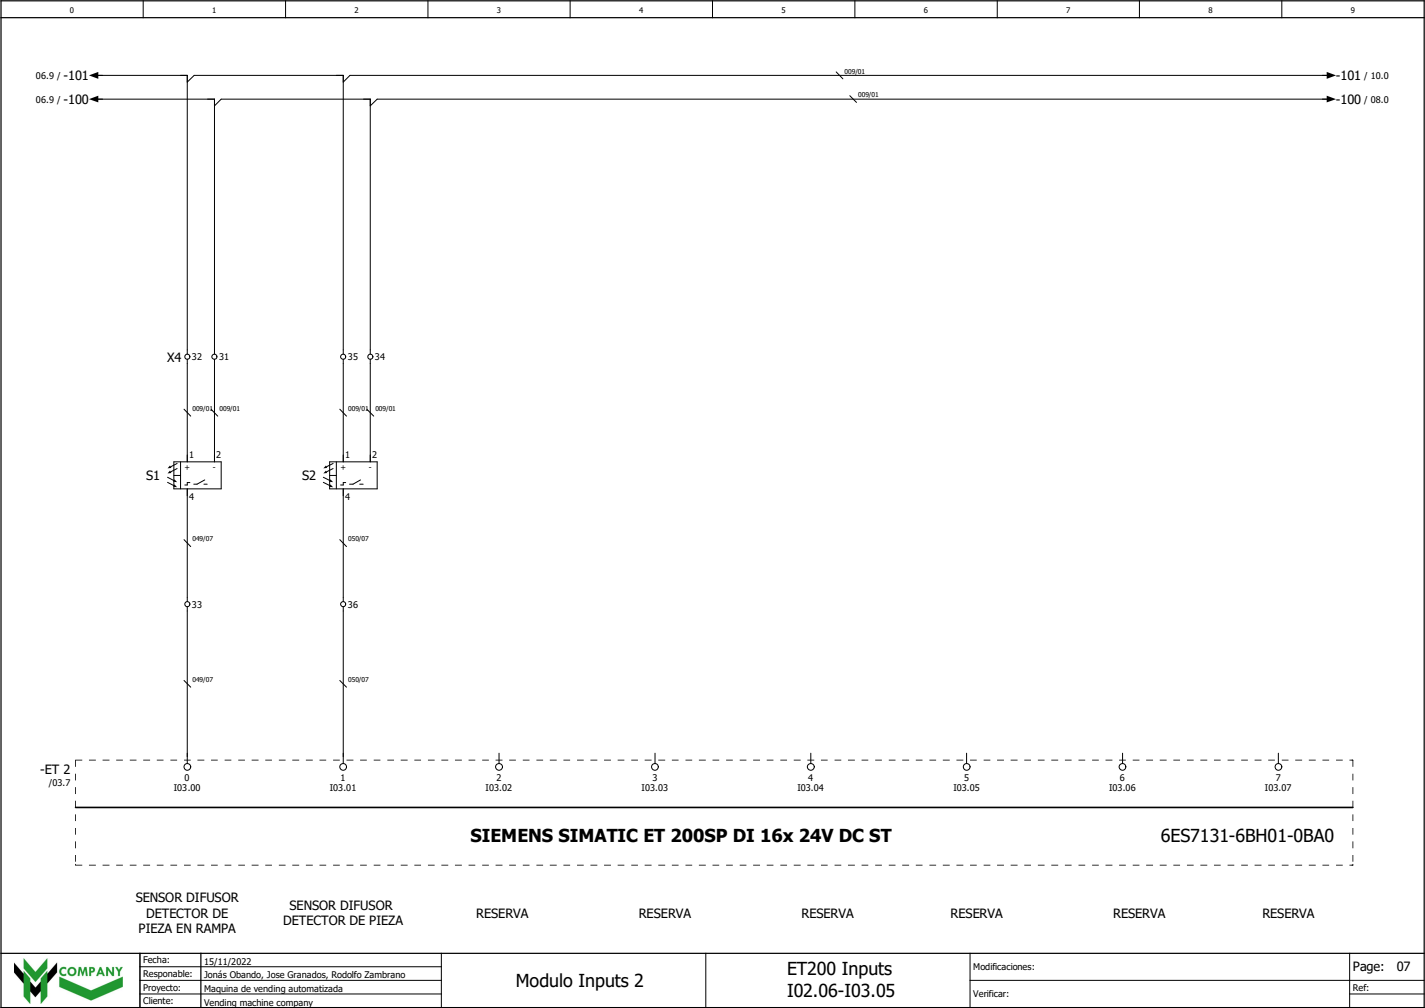
[picture p470: page 10]
RESERVA; RESERVA RESERVA; SIEMENS SIMATIC ET 200SP DI 16x 24V DC ST; Modulo Inputs 2; Jonás Obando, Jose Granados, Rodolfo Zambrano; ET200 Inputs

SENSOR DIFUSOR
DETECTOR DE
PIEZA EN RAMPA

DETECTOR DE PIEZA

## SIEMENS CPU 1214C DC/DC/DC

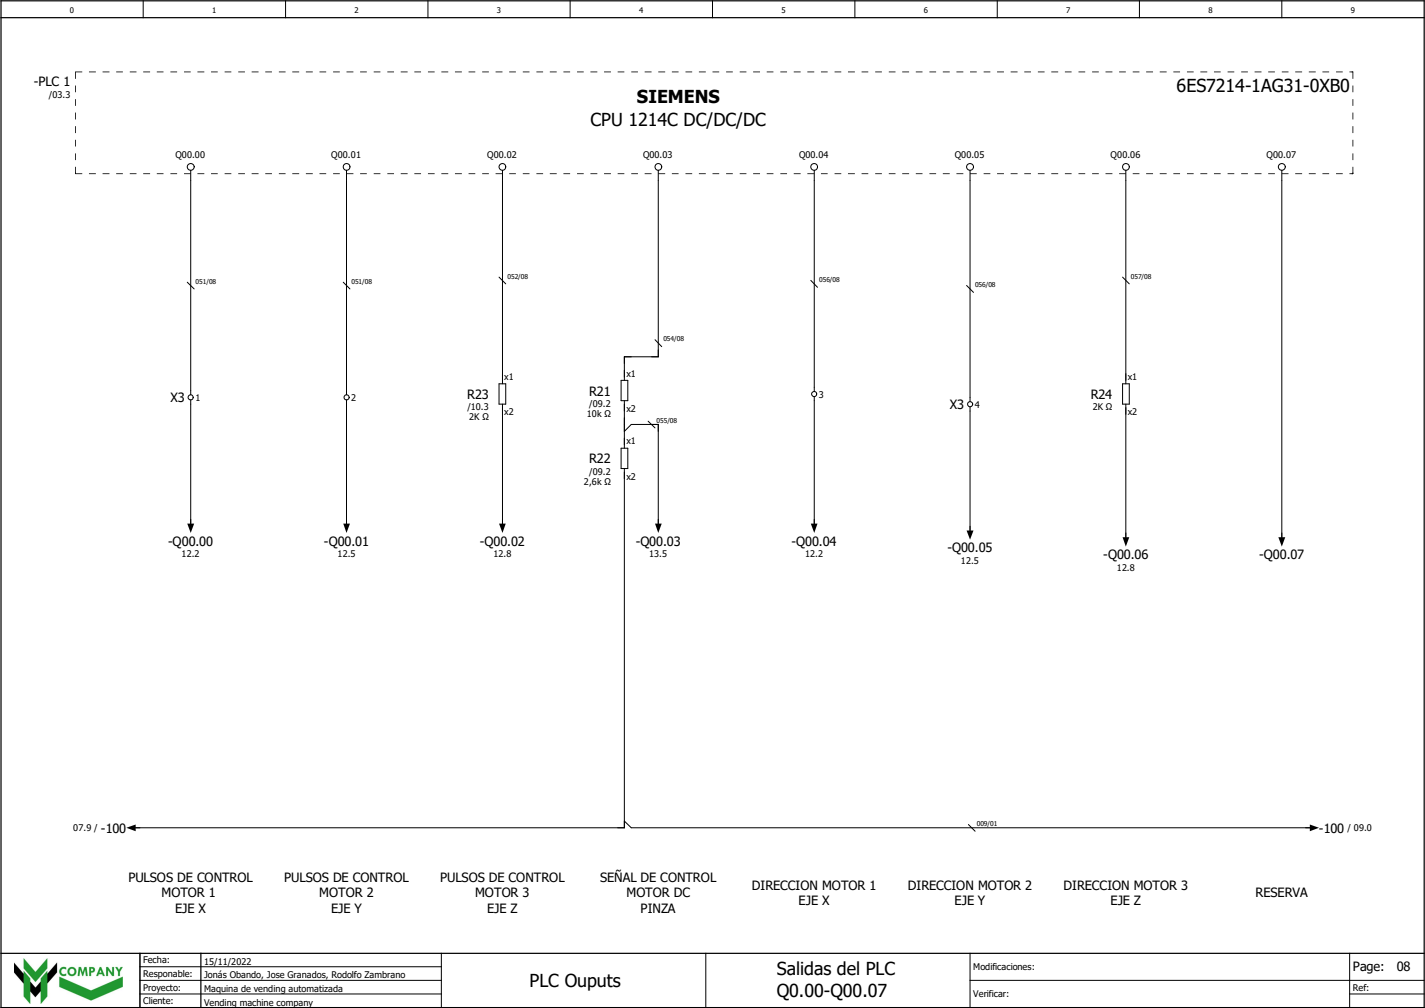
[picture p471: page 11]
PLC Ouputs; Jonás Obando, Jose Granados, Rodolfo Zambrano; Salidas del PLC; DIRECCION MOTOR 1 EJE X; DIRECCION MOTOR 2 EJE Y; DIRECCION MOTOR 3; EJE Z; RESERVA; -PLC 1 /03.3

PULSOS DE CONTROL
MOTOR 1
EJE X

MOTOR 2
EJE Y

MOTOR 3
EJE Z

SEÑAL DE CONTROL
MOTOR DC
PINZA

## SIEMENS CPU 1214C DC/DC/DC

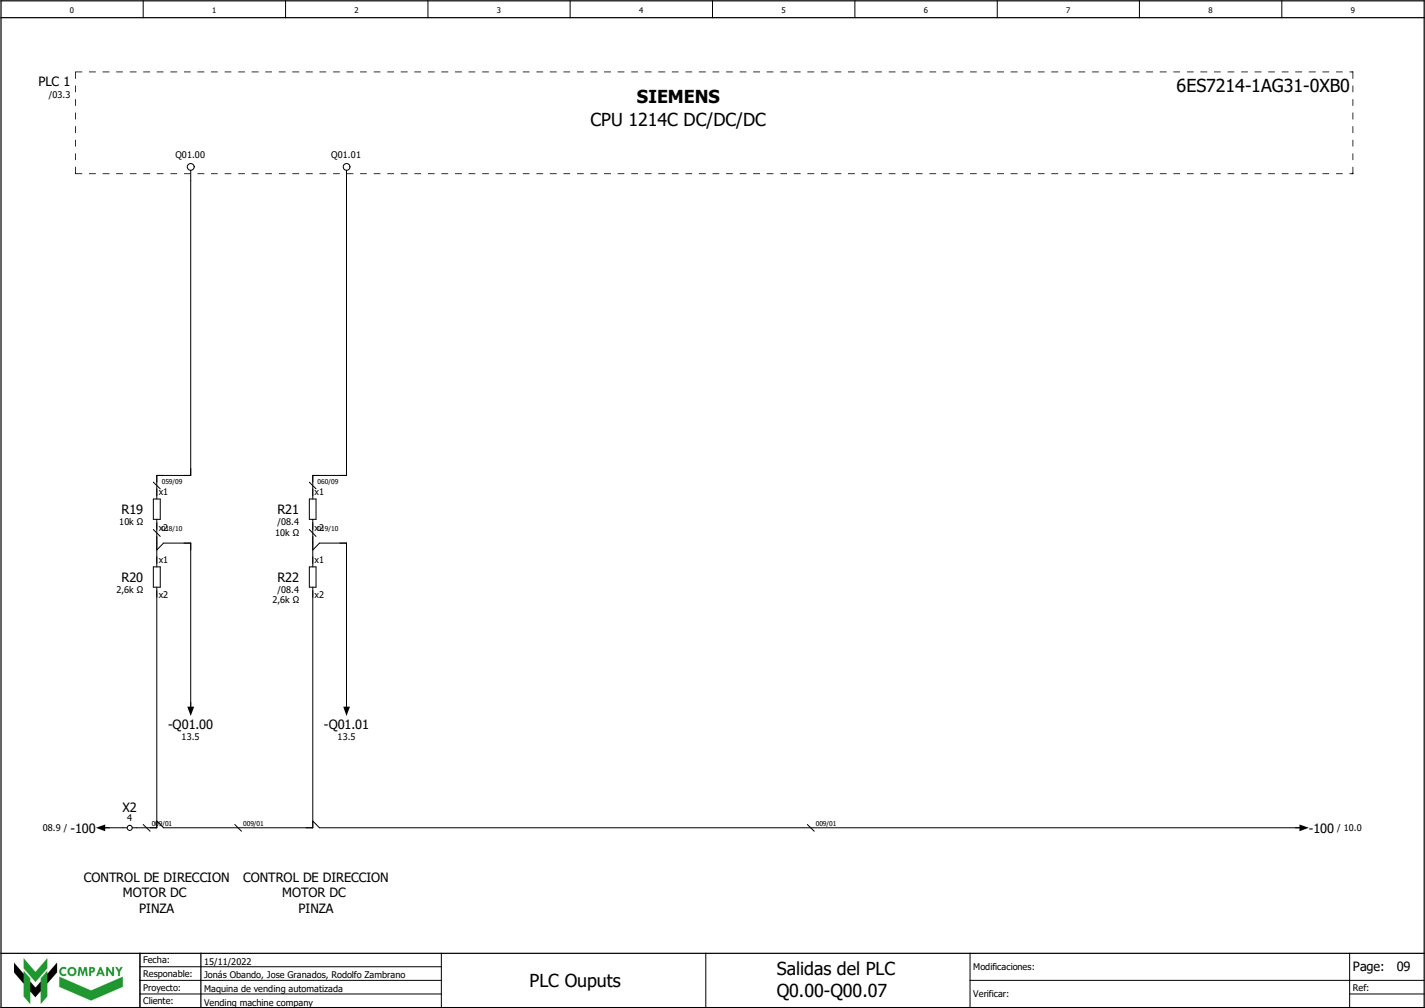
[picture p472: page 12]
PLC Ouputs; Jonás Obando, Jose Granados, Rodolfo Zambrano; Salidas del PLC; PLC 1 /03.3

CONTROL DE DIRECCION
MOTOR DC
PINZA

SIEMENS SIMATIC ET 200SP DQ 16x24VDC/0,5A ST | 6ES7131-6BH01-0BA0

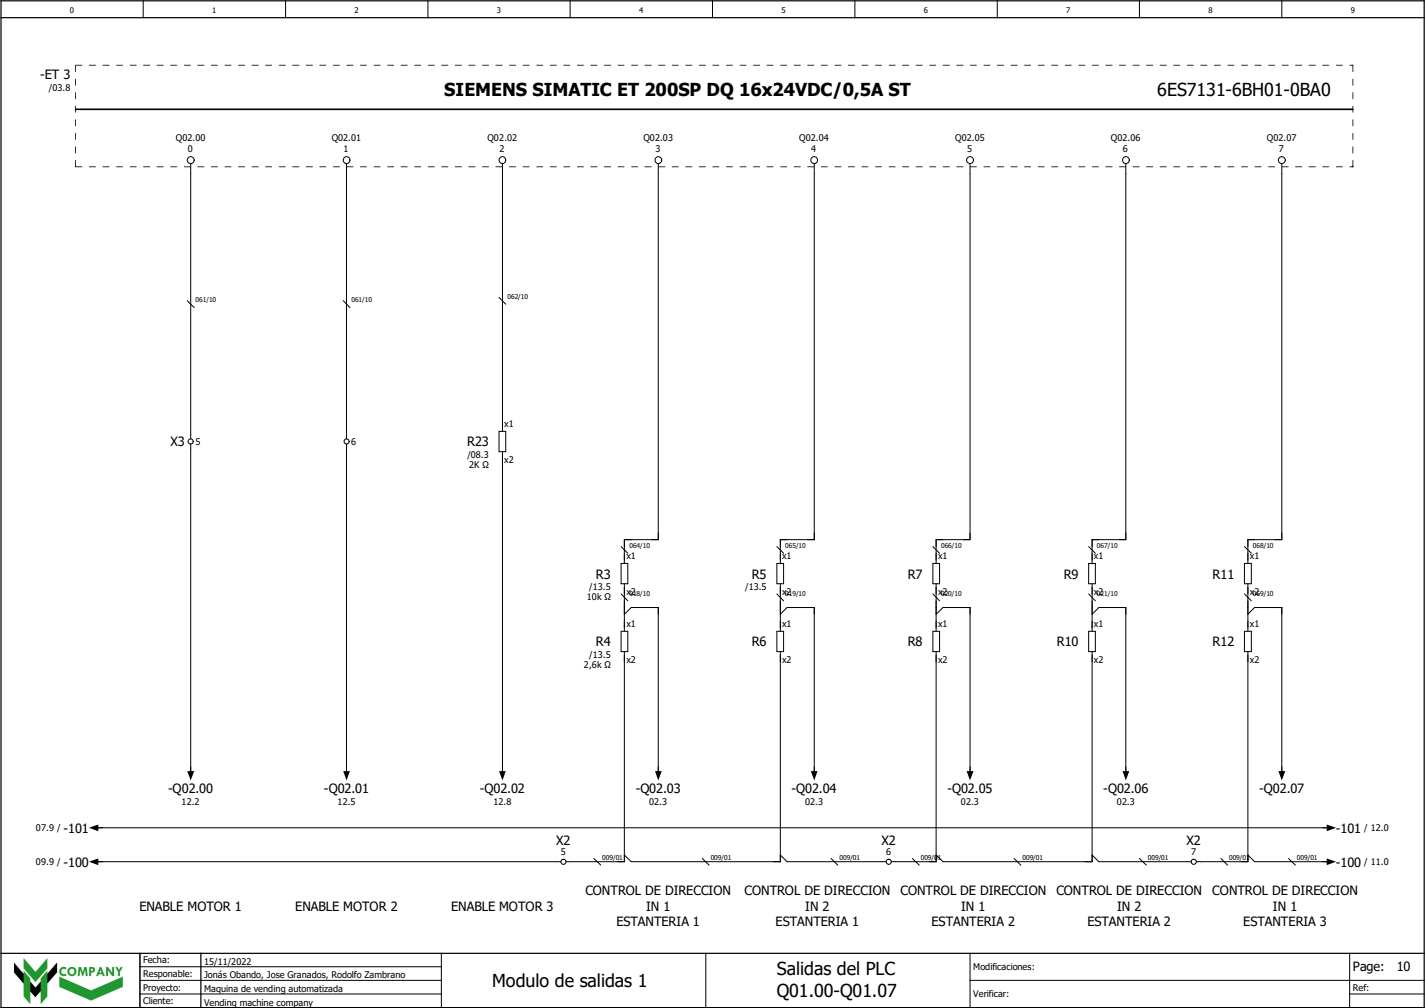
[picture p473: page 13]

SIEMENS SIMATIC ET 200SP DQ 16x24VDC/0,5A ST | 6ES7132-6BH01-0BA0

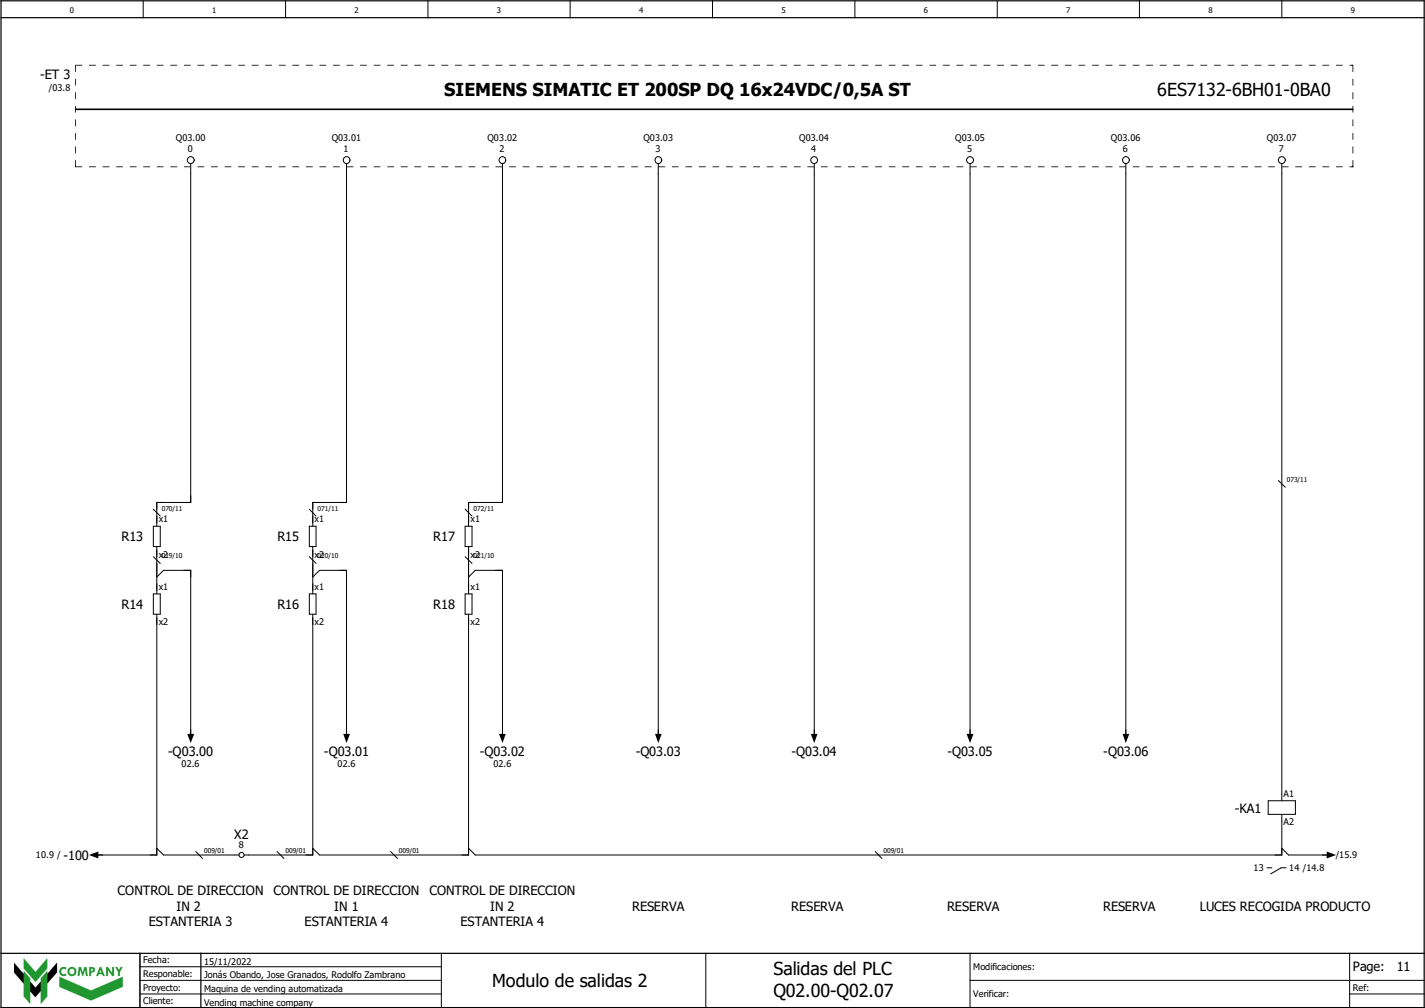
[picture p474: page 14]
IN 2 ESTANTERIA 3; IN 1 ESTANTERIA 4; IN 2 ESTANTERIA 4; RESERVA; LUCES RECOGIDA PRODUCTO RESERVA; Modulo de salidas 2; Salidas del PLC

CONTROL DE DIRECCION

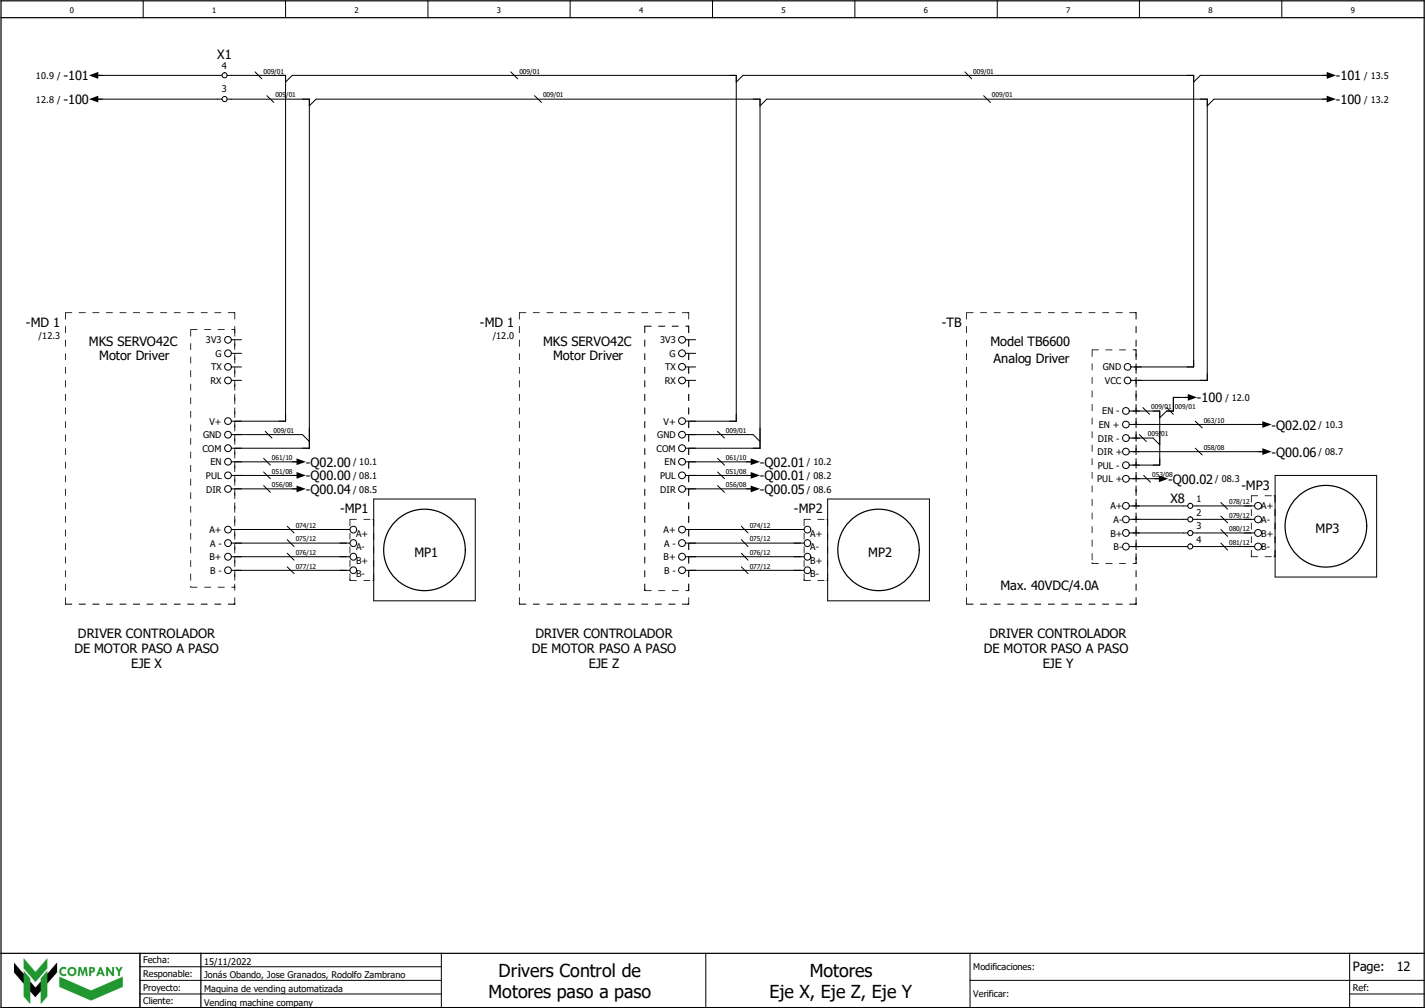
[picture p475: page 15]
Analog Driver; Model TB6600; Max. 40VDC/4.0A; MKS SERVO42C Motor Driver; EJE X; EJE Z; EJE Y; GND VCC; V+ GND COM EN PUL DIR; DIR - DIR + PUL - PUL +

DRIVER CONTROLADOR
DE MOTOR PASO A PASO

Drivers Control de
Motores paso a paso

Motores
Eje X, Eje Z, Eje Y

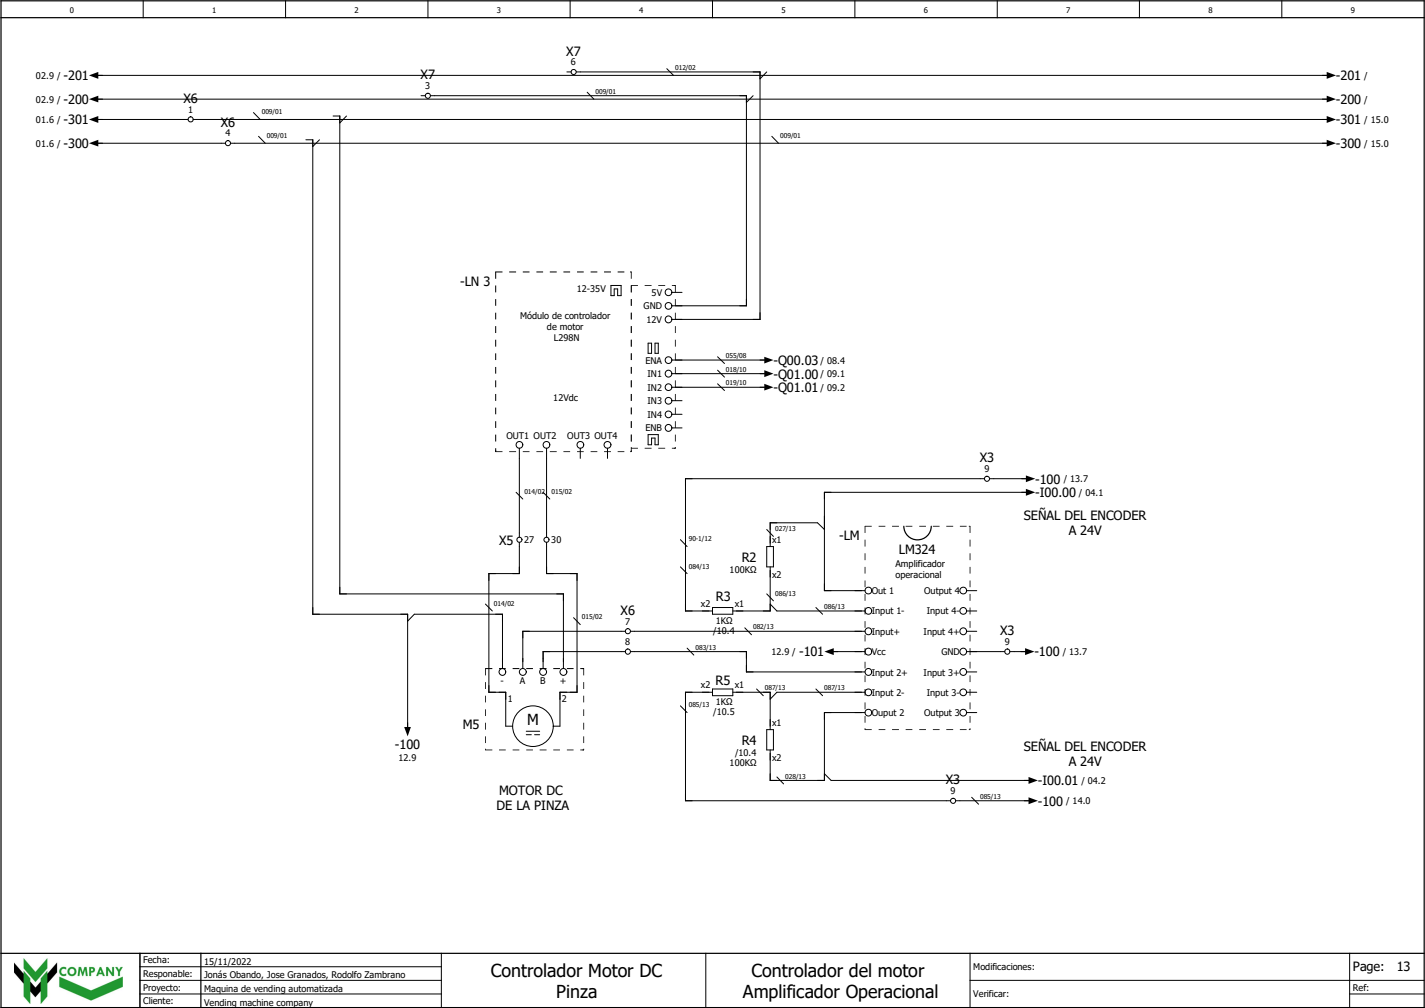
[picture p476: page 16]
12Vdc; Amplificador operacional; SEÑAL DEL ENCODER A 24V; Pinza; Out 1; Input 1-; Input+; Vcc; Input 2+; Input 2-; Ouput 2; Input 4-; Input 4+; GND; Input 3+; Input 3-; Output 3; Output 4; OUT1 OUT2; ENA; ENB; OUT3 OUT4

Módulo de controlador
de motor

MOTOR DC
DE LA PINZA

Controlador Motor DC

Controlador del motor
Amplificador Operacional

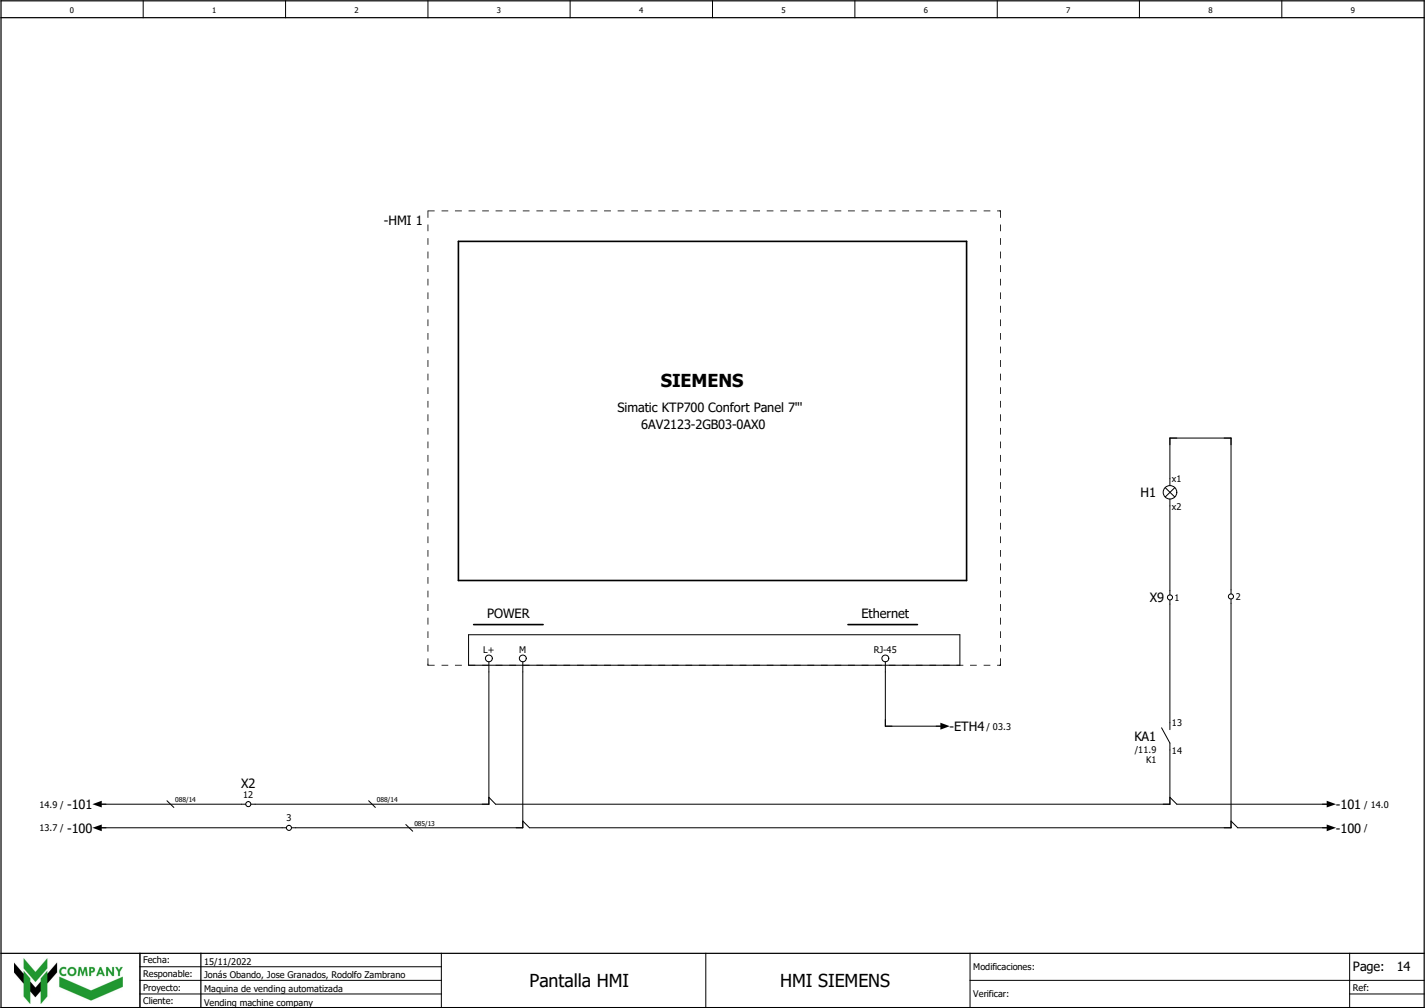
[picture p477: page 17]
POWER; SIEMENS; Ethernet; Pantalla HMI; HMI SIEMENS; -HMI 1; -ETH4 / 03.3

Simatic KTP700 Confort Panel 7"'

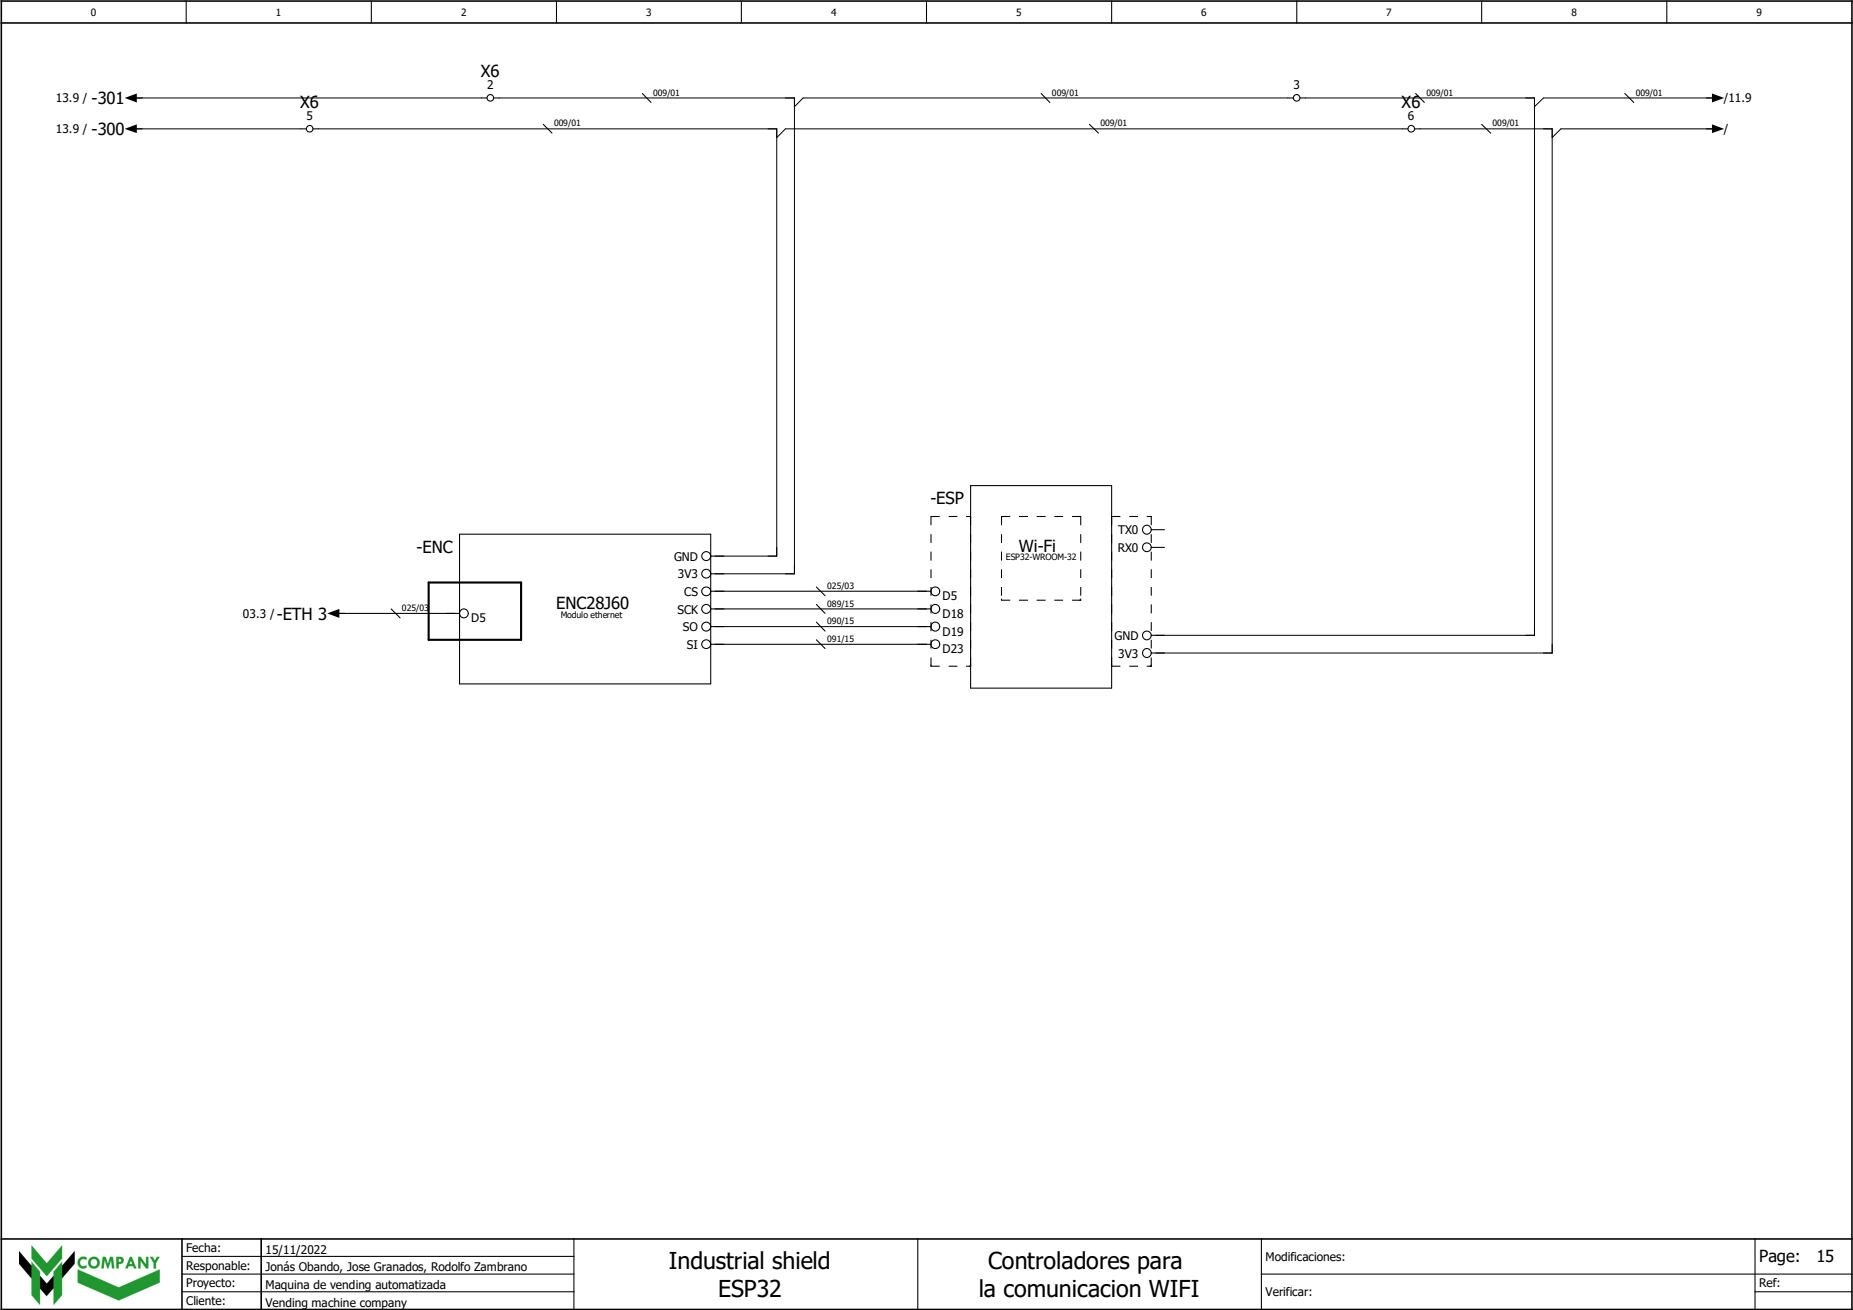
[picture p478: page 18]
Industrial shield ESP32; ENC28J60; Modulo ethernet; -ESP; -ENC; 03.3 /-ETH 3; GND; SCK; GND 3V3

ESP32-WROOM-32 Wi-Fi

Controladores para
la comunicacion WIFI

15/11/2022 | Armario Electrico 1 | Distribución de componentes en el armario | 15
Jose Granados, Jonás Obando y Rodolfo Zambrano
-FA1 | -FA2
-Q1 | -Q2 | -Q3

-PLC1

-ET200
-SW

-TB

-LN | -LN
-LN | -LM

-ENC -ESP32

-FA3

300 800

15/11/2022 | Armario Electrico 3 | Medidas externas | 17
Jose Granados, Jonás Obando y Rodolfo Zambrano

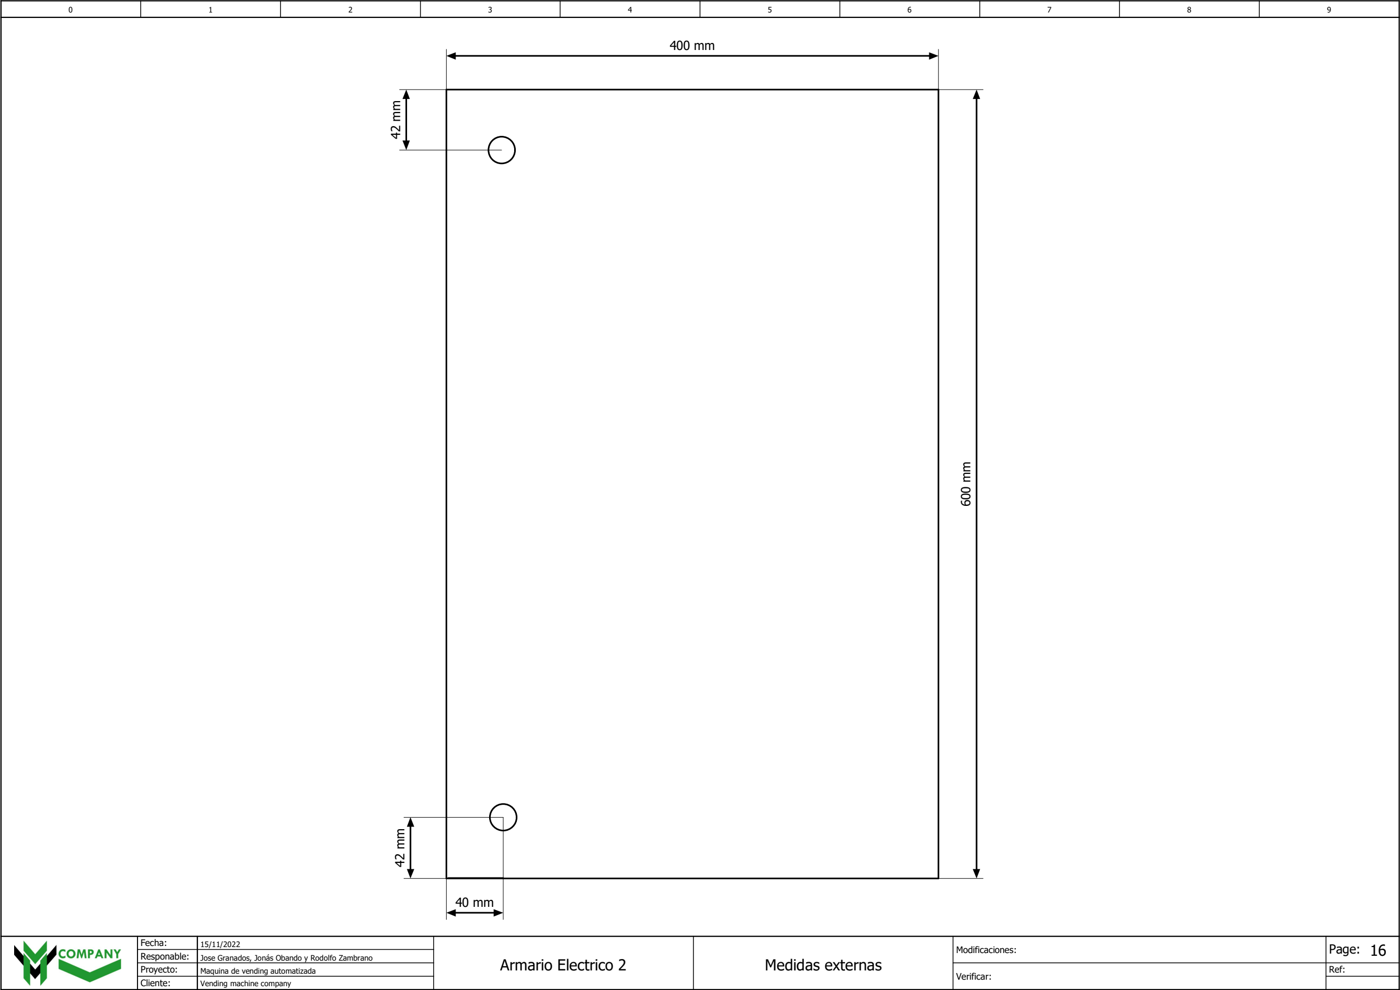
[picture p479: figure]
Armario Electrico 2; Medidas externas

Jose Granados, Jonás Obando y Rodolfo Zambrano

X3 | X4 | X5 | X6 | X7 | X8
X2

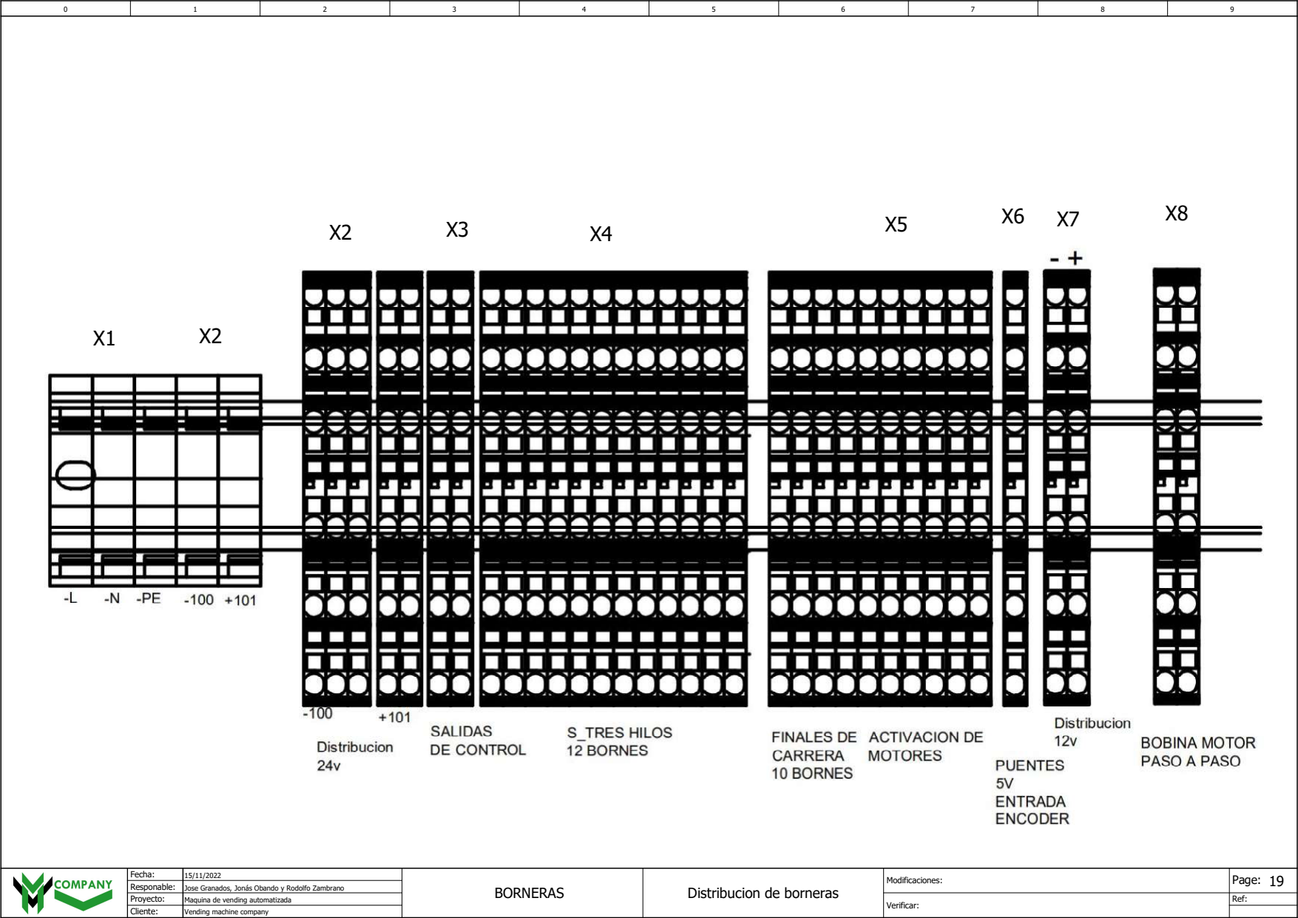
[picture p480: page 22]

15/11/2022 | BORNERAS | Distribucion de borneras | 19
Jose Granados, Jonás Obando y Rodolfo Zambrano
X1 | X2

# Terminal diagram

# =Esquema electrico+-X3

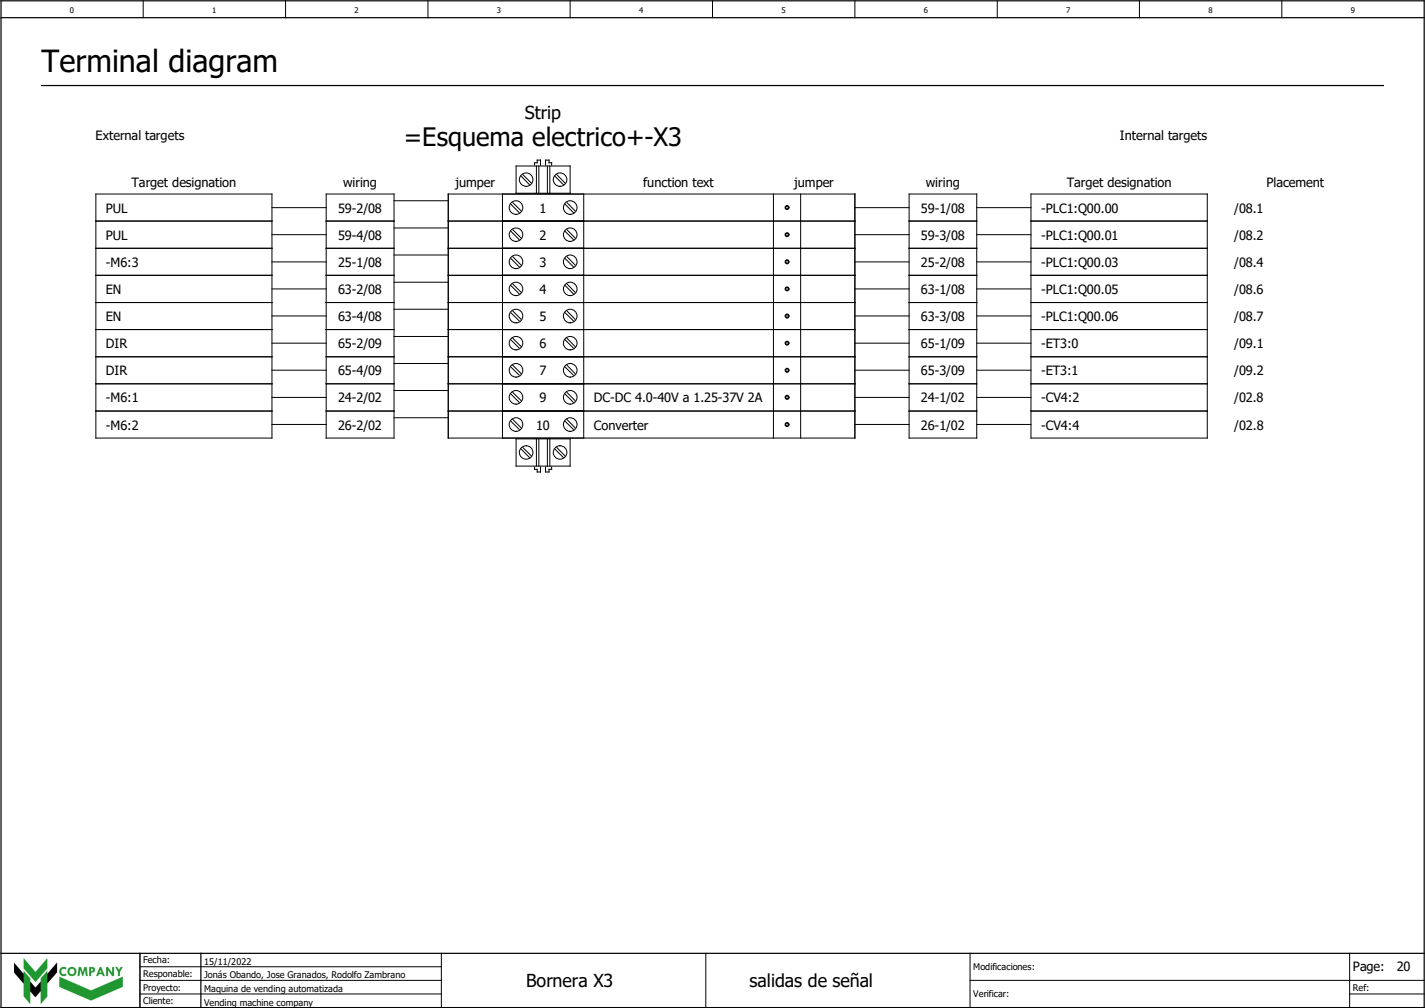
[picture p481: page 23]
Strip; Target designation; Target designation wiring; wiring jumper; jumper function text; External targets; Internal targets; Placement; PUL; -PLC1:Q00.00; -PLC1:Q00.01; -PLC1:Q00.03; -PLC1:Q00.05; -PLC1:Q00.06; DIR; Converter; Bornera X3; salidas de señal

# Terminal diagram

# =Esquema electrico+-X4

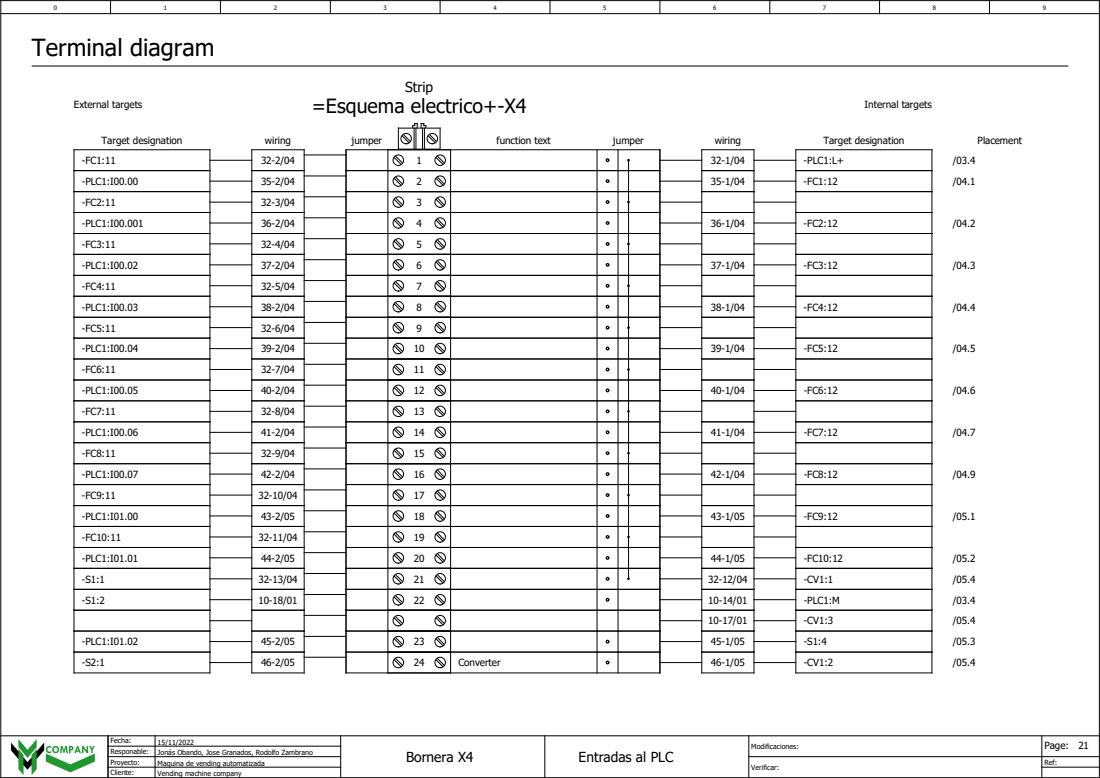
[picture p482: page 24]
Strip; Target designation; Target designation wiring; wiring jumper; jumper function text; External targets; Internal targets; Placement; -PLC1:L+; -PLC1:I00.00; -PLC1:I00.001; -PLC1:I00.02; -PLC1:I00.03; -PLC1:I00.04; -PLC1:I00.05; -PLC1:I00.06; -PLC1:I00.07; -PLC1:I01.00; -PLC1:I01.01; -PLC1:M; -PLC1:I01.02; Converter; Bornera X4; Entradas al PLC

# Terminal diagram

# =Esquema electrico+-X4

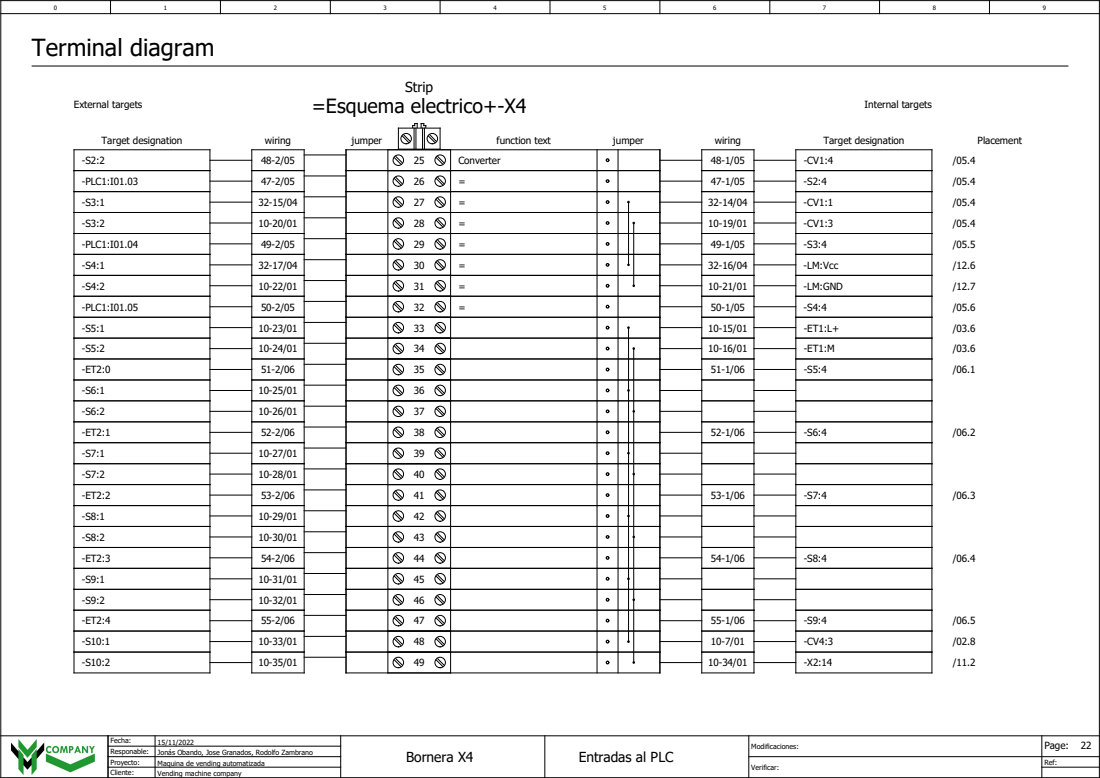
[picture p483: page 25]
Strip; Target designation; Target designation wiring; wiring jumper; jumper function text; External targets; Internal targets; Placement; Converter; -PLC1:I01.03; -PLC1:I01.04; -LM:Vcc; -LM:GND; -PLC1:I01.05

15/11/2022 | Bornera X4 | Entradas al PLC | 22
Jonás Obando, Jose Granados, Rodolfo Zambrano

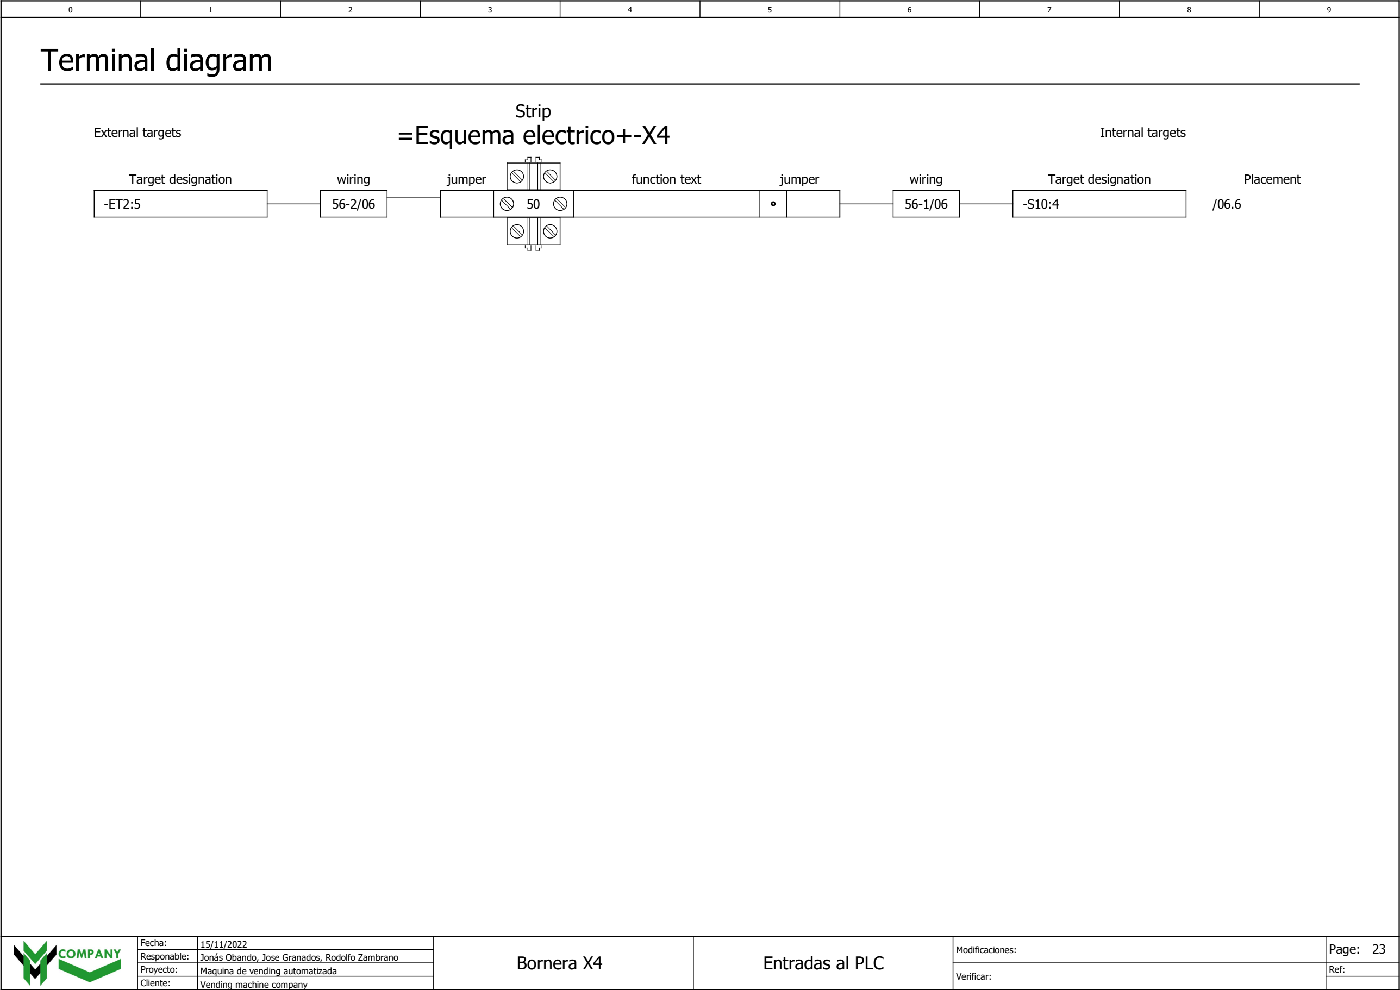
[picture p484: figure]
Bornera X4; Entradas al PLC; =Esquema electrico+-X4; Strip; Target designation; Target designation wiring; wiring jumper; jumper function text; External targets; Internal targets; Placement; Terminal diagram

### 23 Jonás Obando, Jose Granados, Rodolfo Zambrano
