josegd98/MaquinaVending/Documentació Projecte/Esquema de comunicacion entre dipositivos.pdf

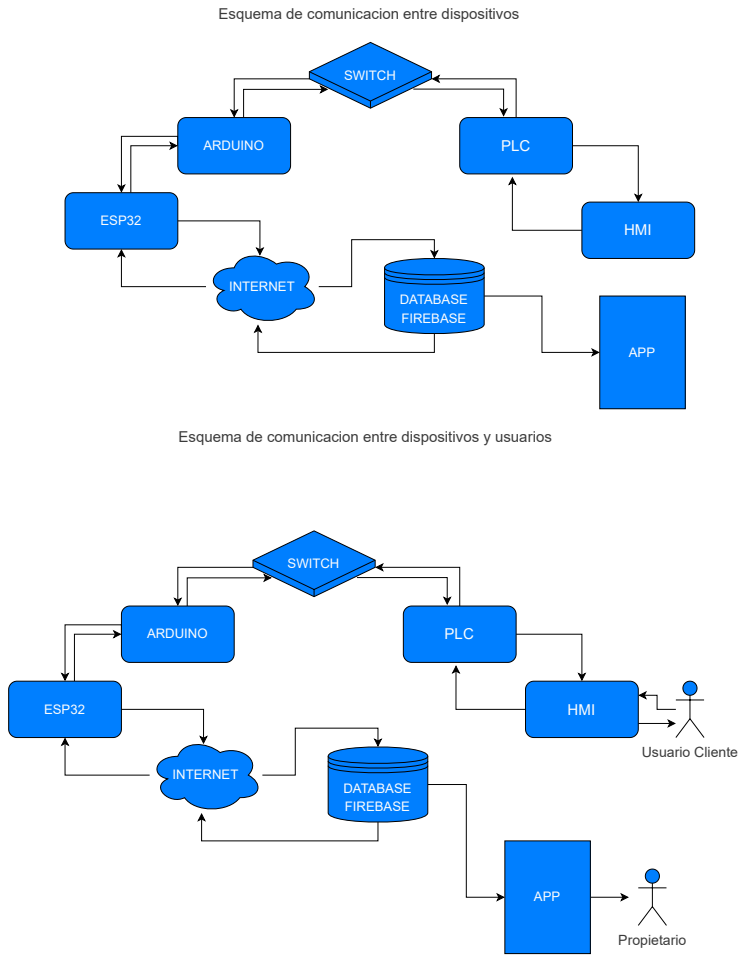
[picture p485: page 1]
Usuario Cliente; Propietario; PLC; SWITCH; ARDUINO; ESP32; INTERNET; DATABASE FIREBASE; HMI; APP

Esquema de comunicacion entre dispositivos

Esquema de comunicacion entre dispositivos y usuarios
