josegd98/MaquinaVending/Diseny 3D, planos i STL/Planols 2D/Croquis Inicial/Croquis inicial V1.pdf

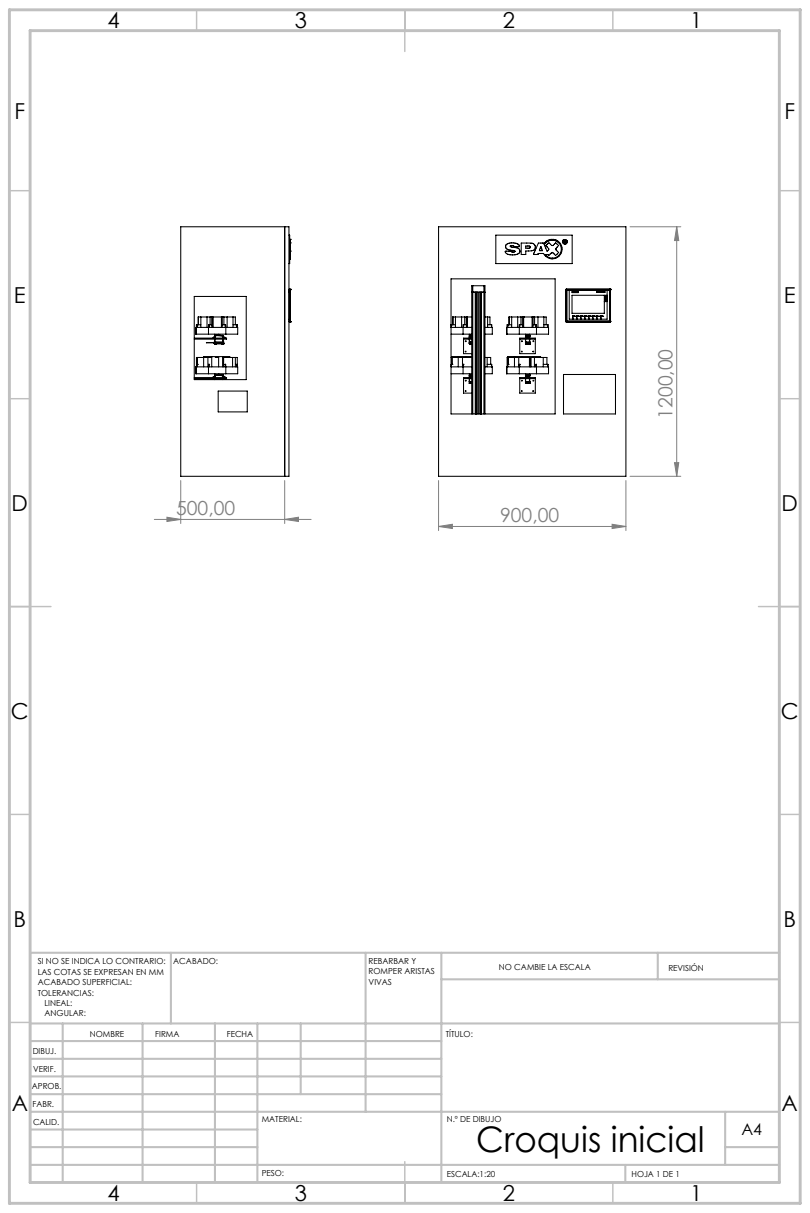
[picture p486: page 1]
ACABADO:; REBARBAR Y; ROMPER ARISTAS; NO CAMBIE LA ESCALA; REVISIÓN; ESCALA:1:20; HOJA 1 DE 1

SI NO SE INDICA LO CONTRARIO:
LAS COTAS SE EXPRESAN EN MM
ACABADO SUPERFICIAL:
TOLERANCIAS:
LINEAL:
ANGULAR:

NOMBRE | FIRMA | FECHA | | | | TÍTULO:

DIBUJ.
VERIF.
APROB.
FABR.
CALID. | | | | MATERIAL: | N.º DE DIBUJO Croquis inicial | A4
