josegd98/MaquinaVending/Diseny 3D, planos i STL/Planols 2D/Plans 2D per mecanitzar/10 Adaptador motor pinça.pdf

1

2

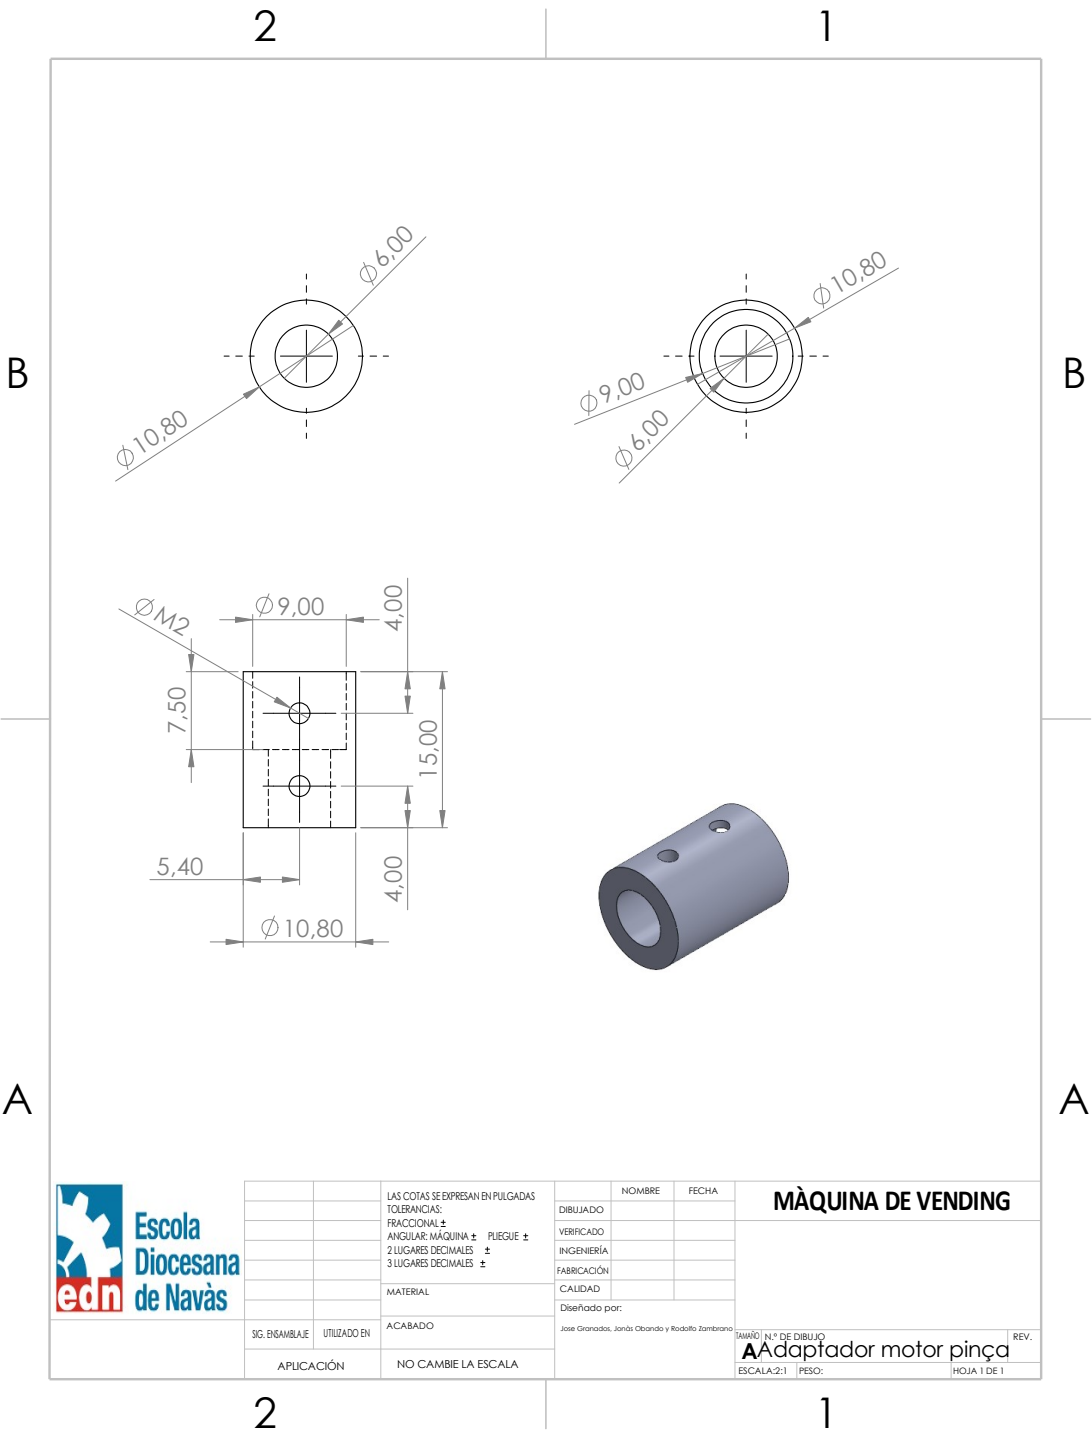
[picture p487: page 1]
MATERIAL; Diseñado por:; REV. SIG. ENSAMBLAJE; UTILIZADO EN; N.º DE DIBUJO; ACABADO

TOLERANCIAS: FRACCIONAL ANGULAR: MÁQUINA PLIEGUE 2 LUGARES DECIMALES 3 LUGARES DECIMALES | | NOMBRE | FECHA LAS COTAS SE EXPRESAN EN PULGADAS | MÀQUINA DE VENDING

DIBUJADO

INGENIERÍA VERIFICADO

CALIDAD FABRICACIÓN

Jose Granados, Jonàs Obando y Rodolfo Zambrano

TAMAÑO AAdaptador motor pinça

APLICACIÓN | NO CAMBIE LA ESCALA

ESCALA:2:1 | PESO: | HOJA 1 DE 1
