josegd98/MaquinaVending/Diseny 3D, planos i STL/Planols 2D/Plans 2D per mecanitzar/11 Detectors 6mm sensors.pdf

1
2

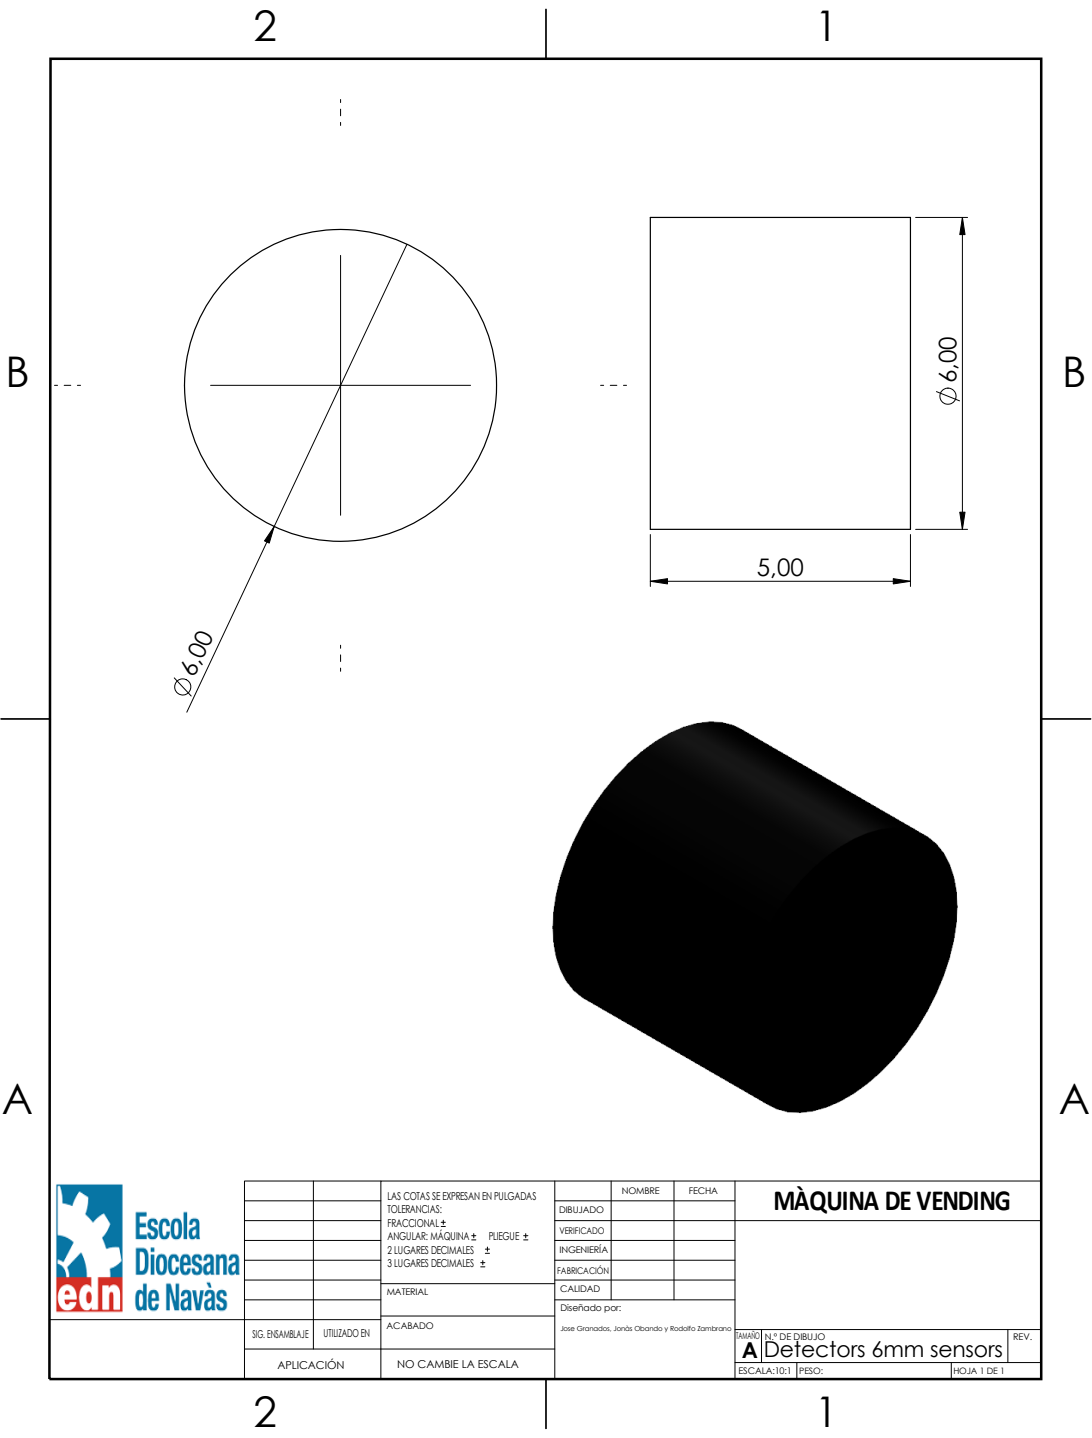
[picture p488: page 1]
MATERIAL; ESCALA:10:1; TAMAÑO; A Detectors 6mm sensors; N.º DE DIBUJO; HOJA 1 DE 1; PESO:; UTILIZADO EN; REV.; Diseñado por:; SIG. ENSAMBLAJE; ACABADO; NOMBRE; APLICACIÓN; ANGULAR: MÁQUINA; PLIEGUE

FECHA LAS COTAS SE EXPRESAN EN PULGADAS
TOLERANCIAS:
FRACCIONAL
2 LUGARES DECIMALES
3 LUGARES DECIMALES

MÀQUINA DE VENDING

DIBUJADO VERIFICADO

INGENIERÍA
FABRICACIÓN
CALIDAD

Jose Granados, Jonàs Obando y Rodolfo Zambrano

NO CAMBIE LA ESCALA
