josegd98/MaquinaVending/Diseny 3D, planos i STL/Planols 2D/Tots els Plans 2D/13 Caixa suport sensor pinça.pdf

2 1

10,00

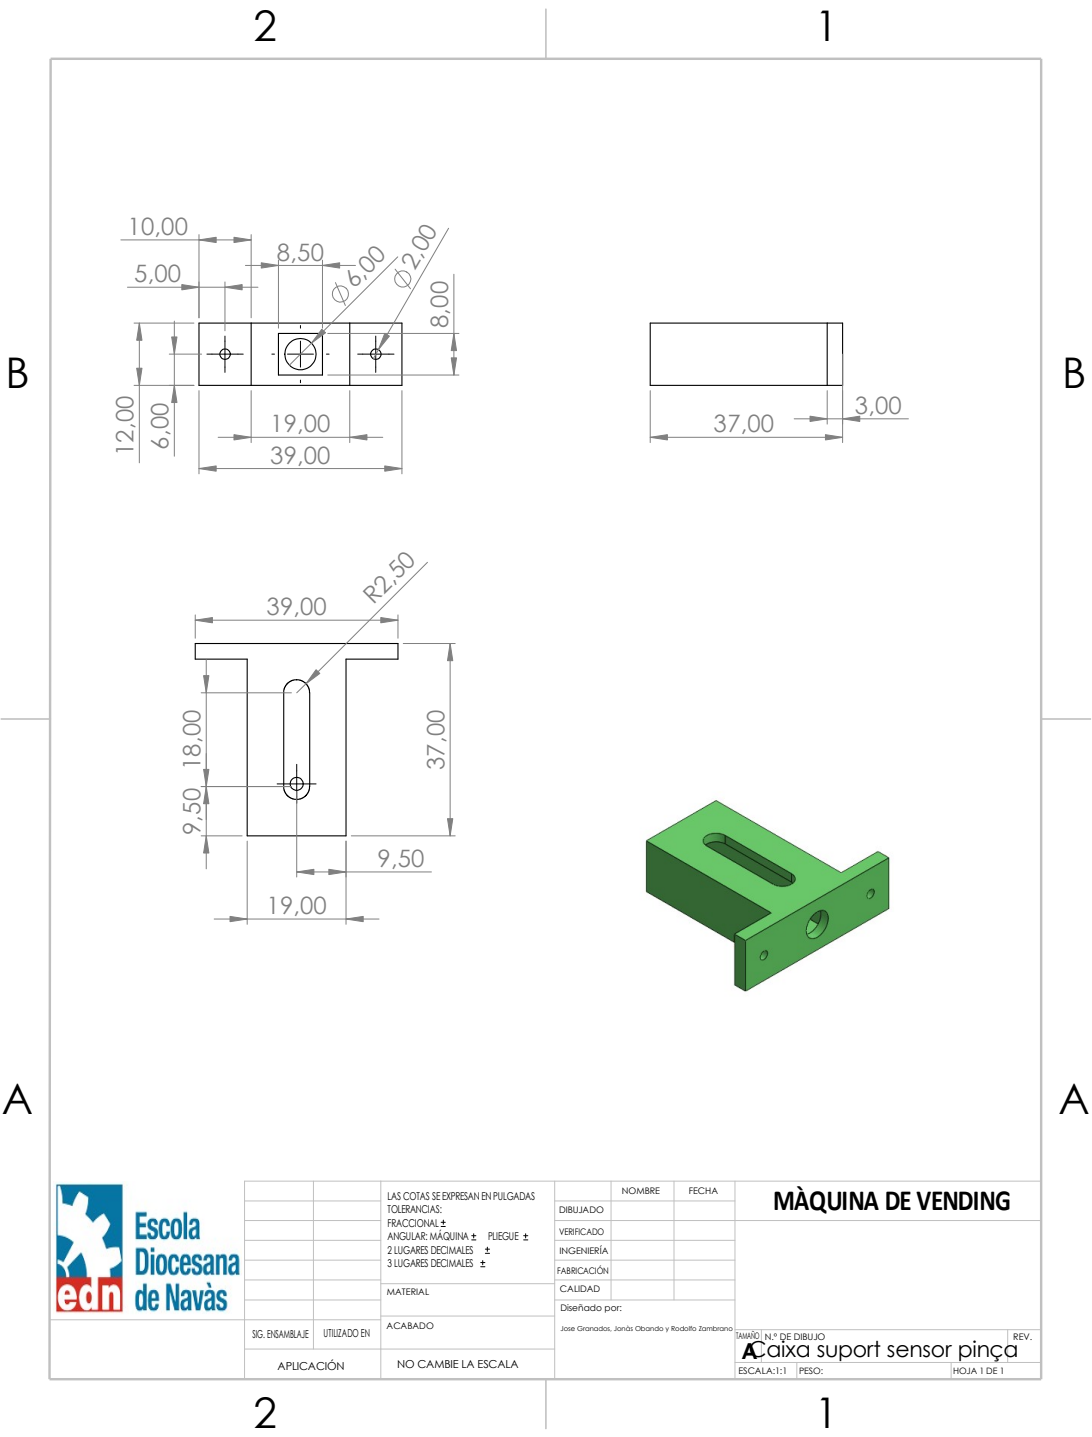
[picture p489: page 1]
NO CAMBIE LA ESCALA; Caixa suport sensor pinça; REV.; ACABADO; TAMAÑO; APLICACIÓN; ESCALA:1:1 SIG. ENSAMBLAJE; N.º DE DIBUJO; PESO: 1; Diseñado por:

NOMBRE UTILIZADO EN

TOLERANCIAS: FRACCIONAL ANGULAR: MÁQUINA PLIEGUE 2 LUGARES DECIMALES 3 LUGARES DECIMALES | Jose Granados, Jonàs Obando y Rodolfo Zambrano LAS COTAS SE EXPRESAN EN PULGADAS | FECHA | MÀQUINA DE VENDING

DIBUJADO

HOJA 1 DE 1 VERIFICADO

INGENIERÍA
FABRICACIÓN

MATERIAL | CALIDAD
