josegd98/MaquinaVending/Diseny 3D, planos i STL/Planols 2D/Tots els Plans 2D/35 Suport sensor difusor.pdf

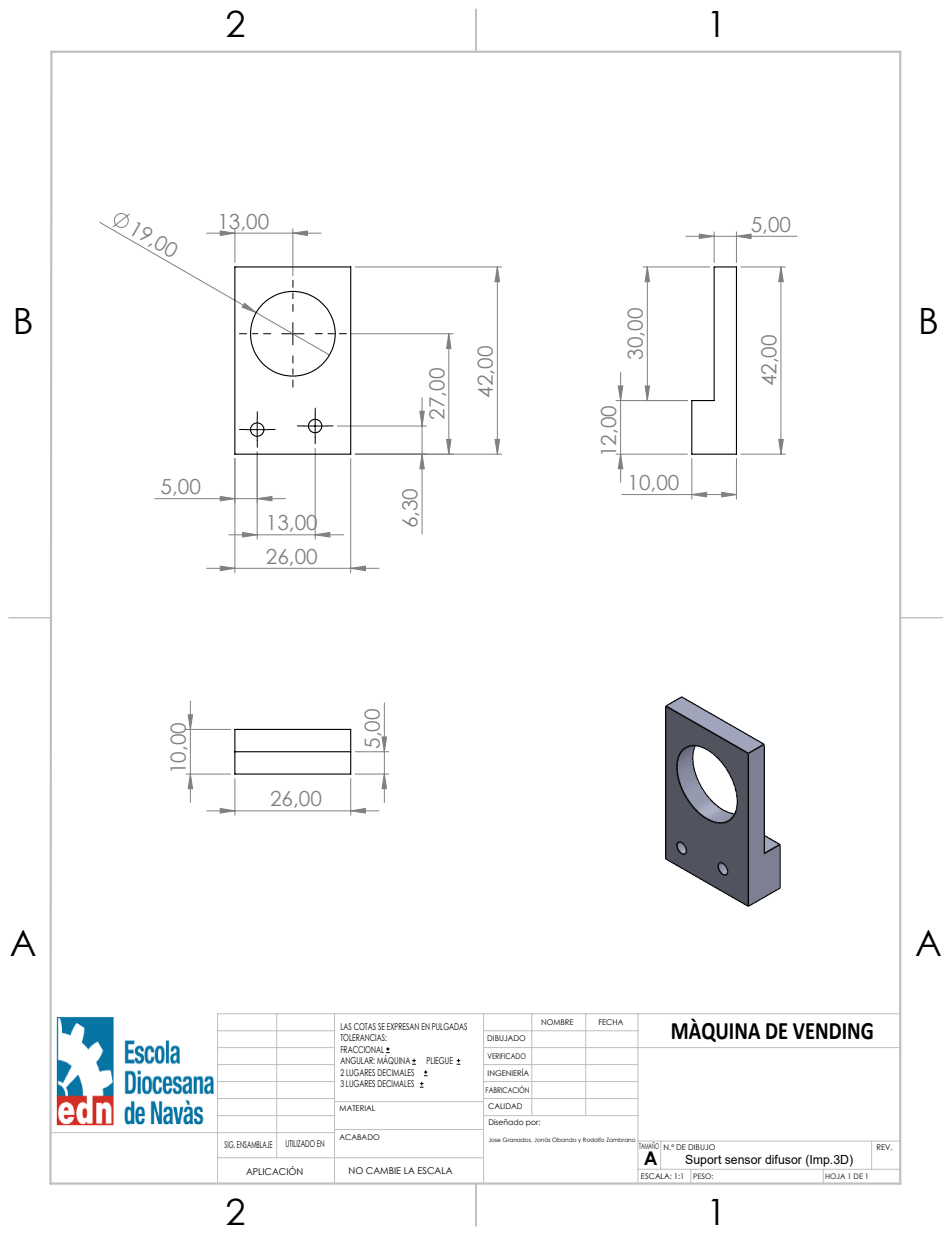
[picture p490: page 1]
Diseñado por:

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

DIBUJADO
VERIFICADO
INGENIERÍA
FABRICACIÓN

MATERIAL | CALIDAD

SIG. ENSAMBLAJE | UTILIZADO EN | ACABADO

Jose Granados, Jonàs Obando y Rodolfo Zambrano

TAMAÑO A | N.º DE DIBUJO Suport sensor difusor (Imp.3D) | REV.

APLICACIÓN | | NO CAMBIE LA ESCALA

ESCALA: 1:1 | PESO: | HOJA 1 DE 1
