josegd98/MaquinaVending/Diseny 3D, planos i STL/Planols 2D/Tots els Plans 2D/39 Motor reductor 12VDC.pdf

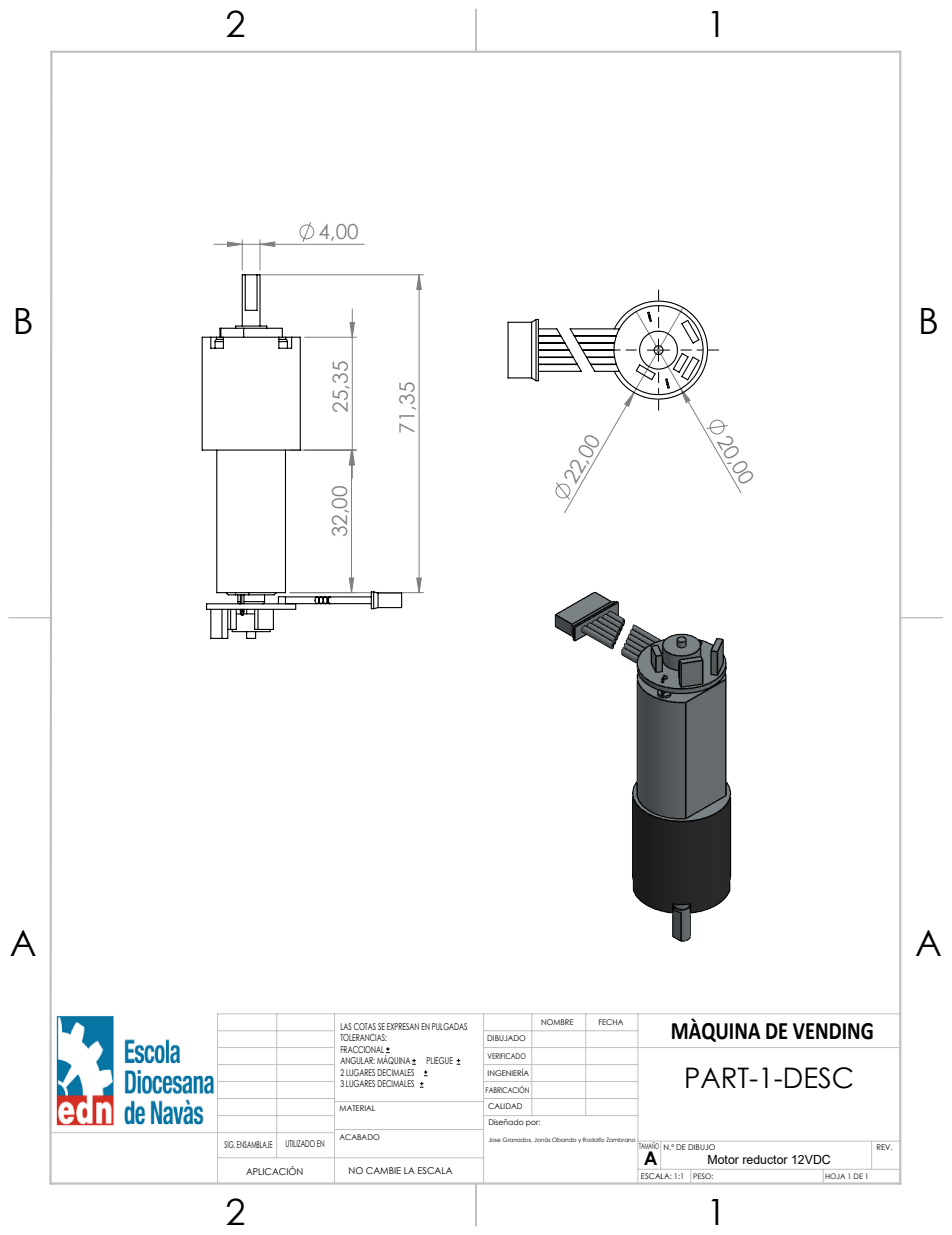
[picture p491: page 1]
Diseñado por:

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

DIBUJADO
VERIFICADO | | | PART-1-DESC
INGENIERÍA
FABRICACIÓN

MATERIAL | CALIDAD

SIG. ENSAMBLAJE | UTILIZADO EN | ACABADO

Jose Granados, Jonàs Obando y Rodolfo Zambrano

TAMAÑO A | N.º DE DIBUJO Motor reductor 12VDC | REV.

APLICACIÓN | | NO CAMBIE LA ESCALA

ESCALA: 1:1 | PESO: | HOJA 1 DE 1
