josegd98/MaquinaVending/Diseny 3D, planos i STL/Planols 2D/Tots els Plans 2D/40 Motor pas a pas Nema 11.pdf

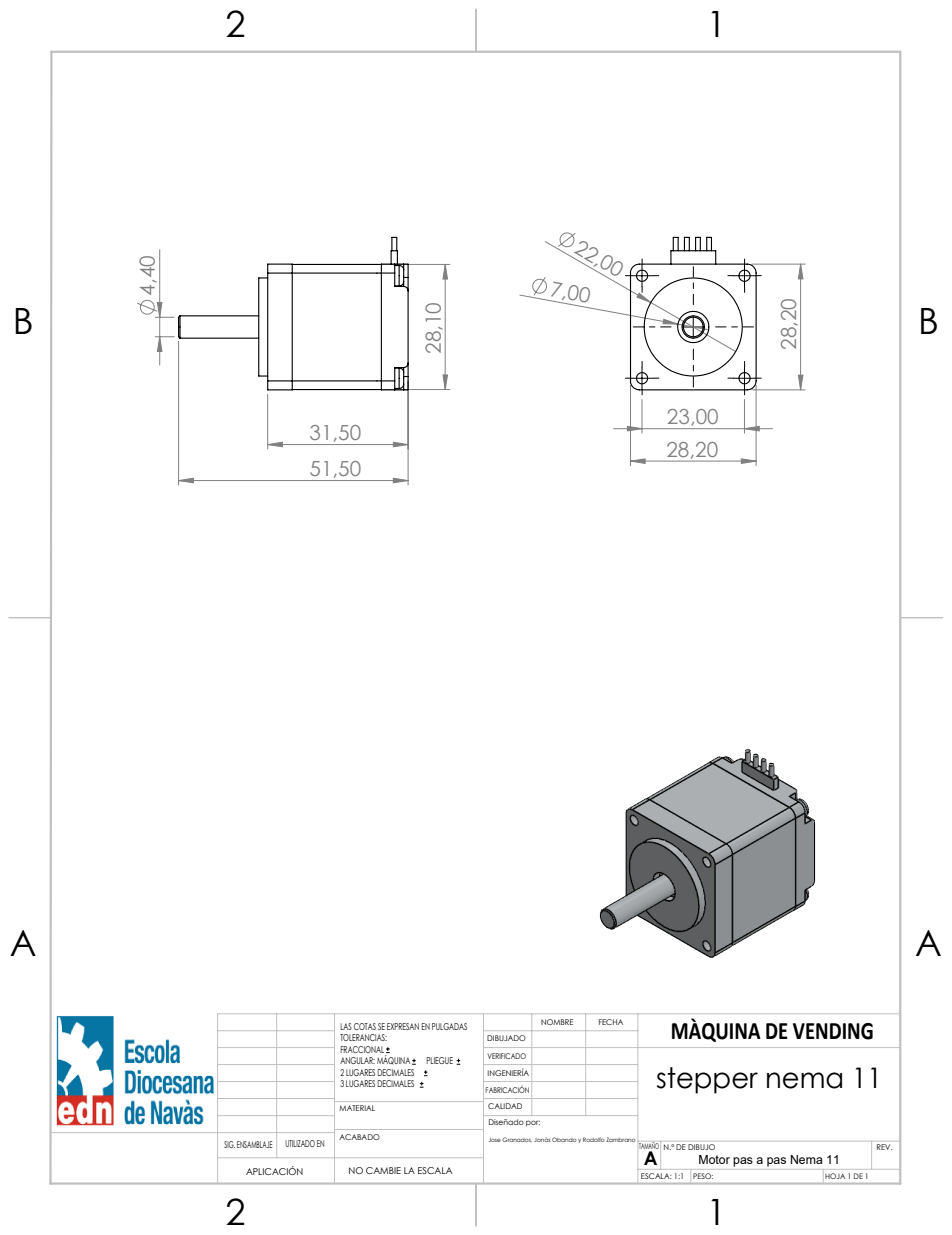
[picture p493: page 1]
Diseñado por:

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

DIBUJADO
VERIFICADO | | | stepper nema 11
INGENIERÍA
FABRICACIÓN

MATERIAL | CALIDAD

SIG. ENSAMBLAJE | UTILIZADO EN | ACABADO

Jose Granados, Jonàs Obando y Rodolfo Zambrano

TAMAÑO A | N.º DE DIBUJO Motor pas a pas Nema 11 | REV.

APLICACIÓN | | NO CAMBIE LA ESCALA

ESCALA: 1:1 | PESO: | HOJA 1 DE 1
