josegd98/MaquinaVending/Diseny 3D, planos i STL/Planols 2D/Plans 2D de muntatge/3 ENSAMBLATGE 3D MAQUINA VENDING .pdf

1

2

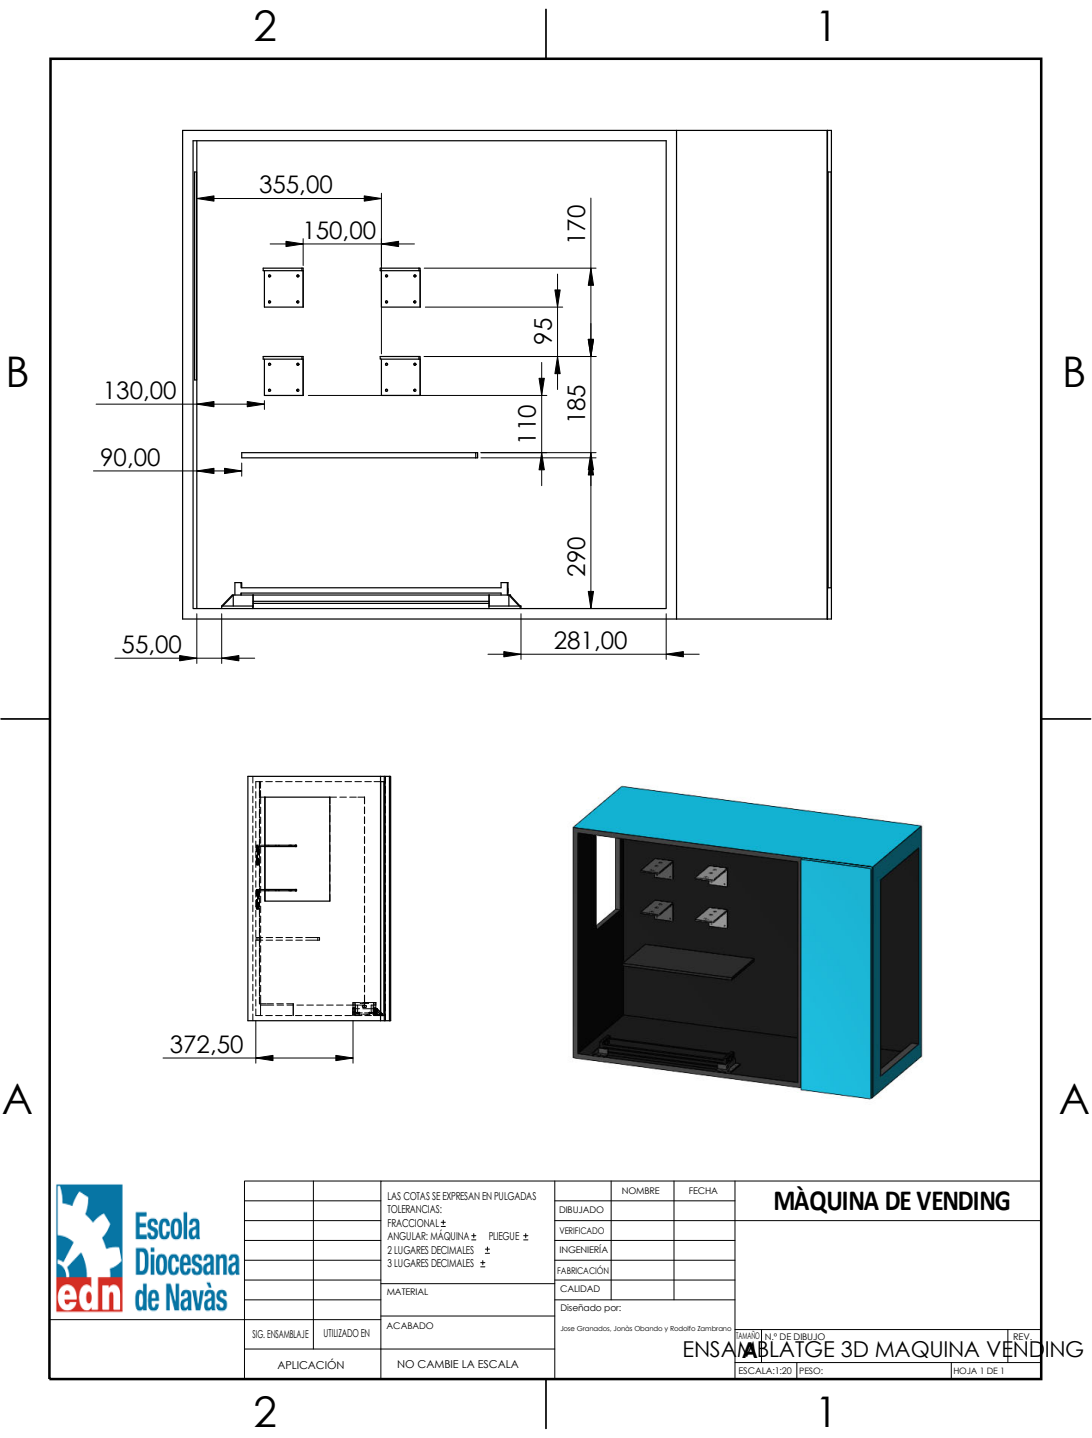
[picture p494: page 1]
REV.; TAMAÑO; N.º DE DIBUJO; ESCALA:1:20; APLICACIÓN; ACABADO; PESO:; Diseñado por:; HOJA 1 DE 1; CALIDAD; NOMBRE; MATERIAL; UTILIZADO EN; SIG. ENSAMBLAJE; ANGULAR: MÁQUINA; PLIEGUE

FECHA
MÀQUINA DE VENDING

LAS COTAS SE EXPRESAN EN PULGADAS
TOLERANCIAS:
FRACCIONAL
2 LUGARES DECIMALES
3 LUGARES DECIMALES

DIBUJADO VERIFICADO

INGENIERÍA
FABRICACIÓN

Jose Granados, Jonàs Obando y Rodolfo Zambrano

ENSAMBLATGE 3D MAQUINA VENDING

NO CAMBIE LA ESCALA
