josegd98/MaquinaVending/Diseny 3D, planos i STL/Planols 2D/Plans 2D de muntatge/1 Ajust estanterias i guies.pdf

2

1

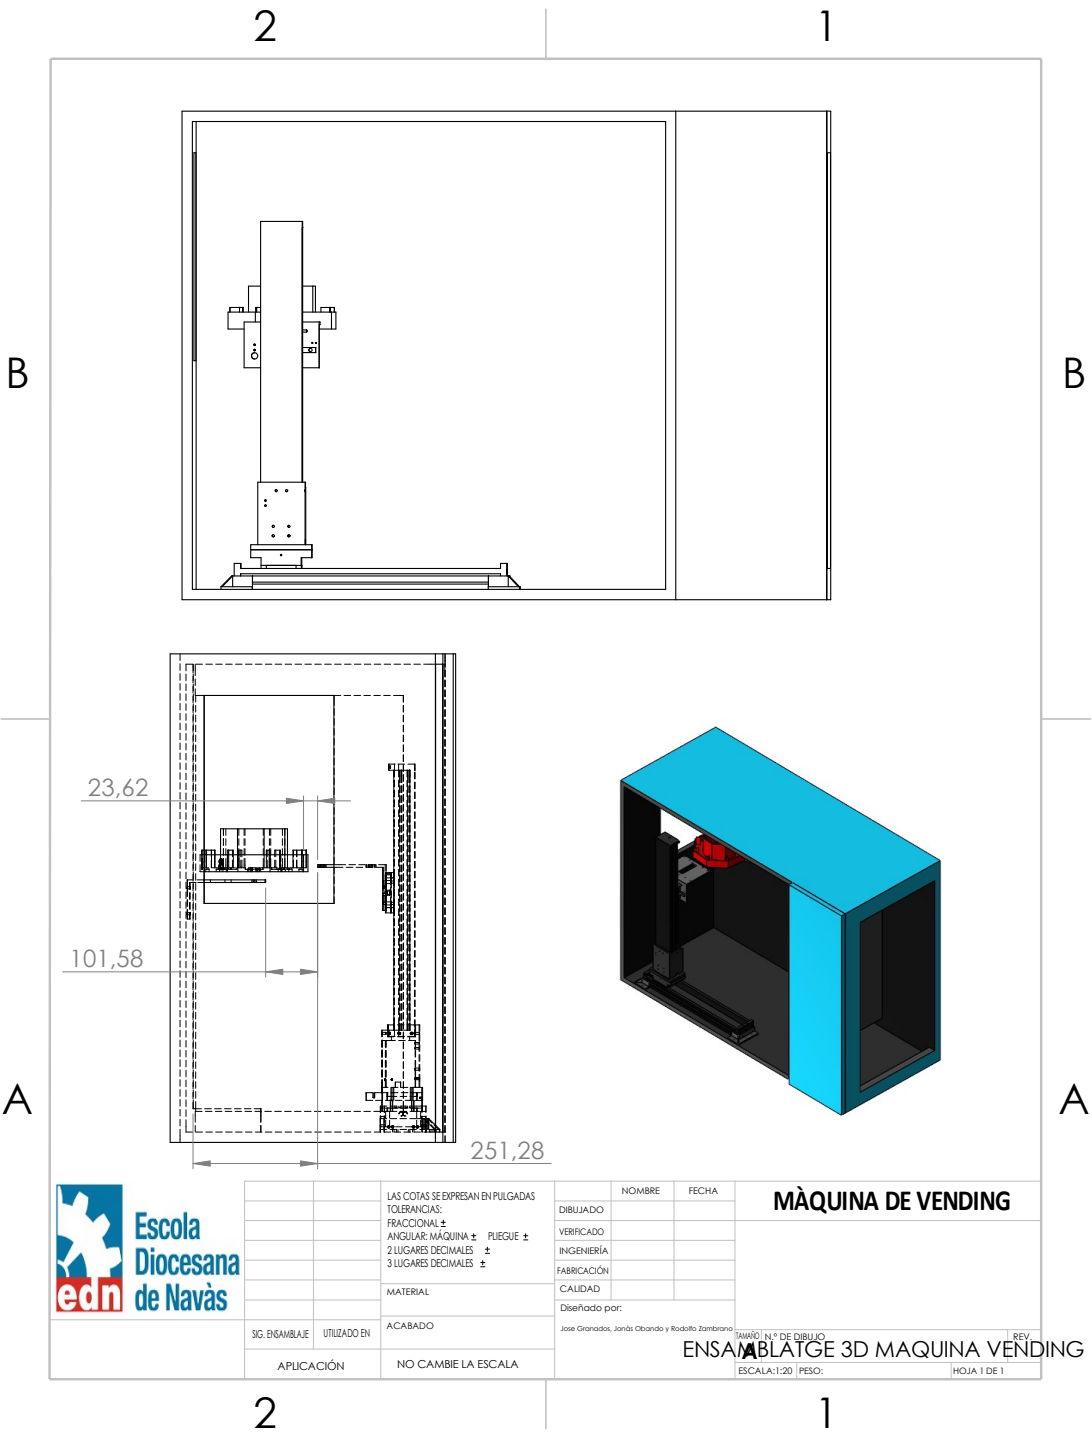
[picture p495: page 1]
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

FECHA UTILIZADO EN

LAS COTAS SE EXPRESAN EN PULGADAS

Jose Granados, Jonàs Obando y Rodolfo Zambrano

TAMAÑO A | N.º DE DIBUJO | REV.

ENSAMBLATGE 3D MAQUINA VENDING

APLICACIÓN | NO CAMBIE LA ESCALA

ESCALA:1:20 | PESO: | HOJA 1 DE 1
