josegd98/MaquinaVending/Diseny 3D, planos i STL/Planols 2D/Plans 2D de muntatge/2 Carregadors.pdf

2

1

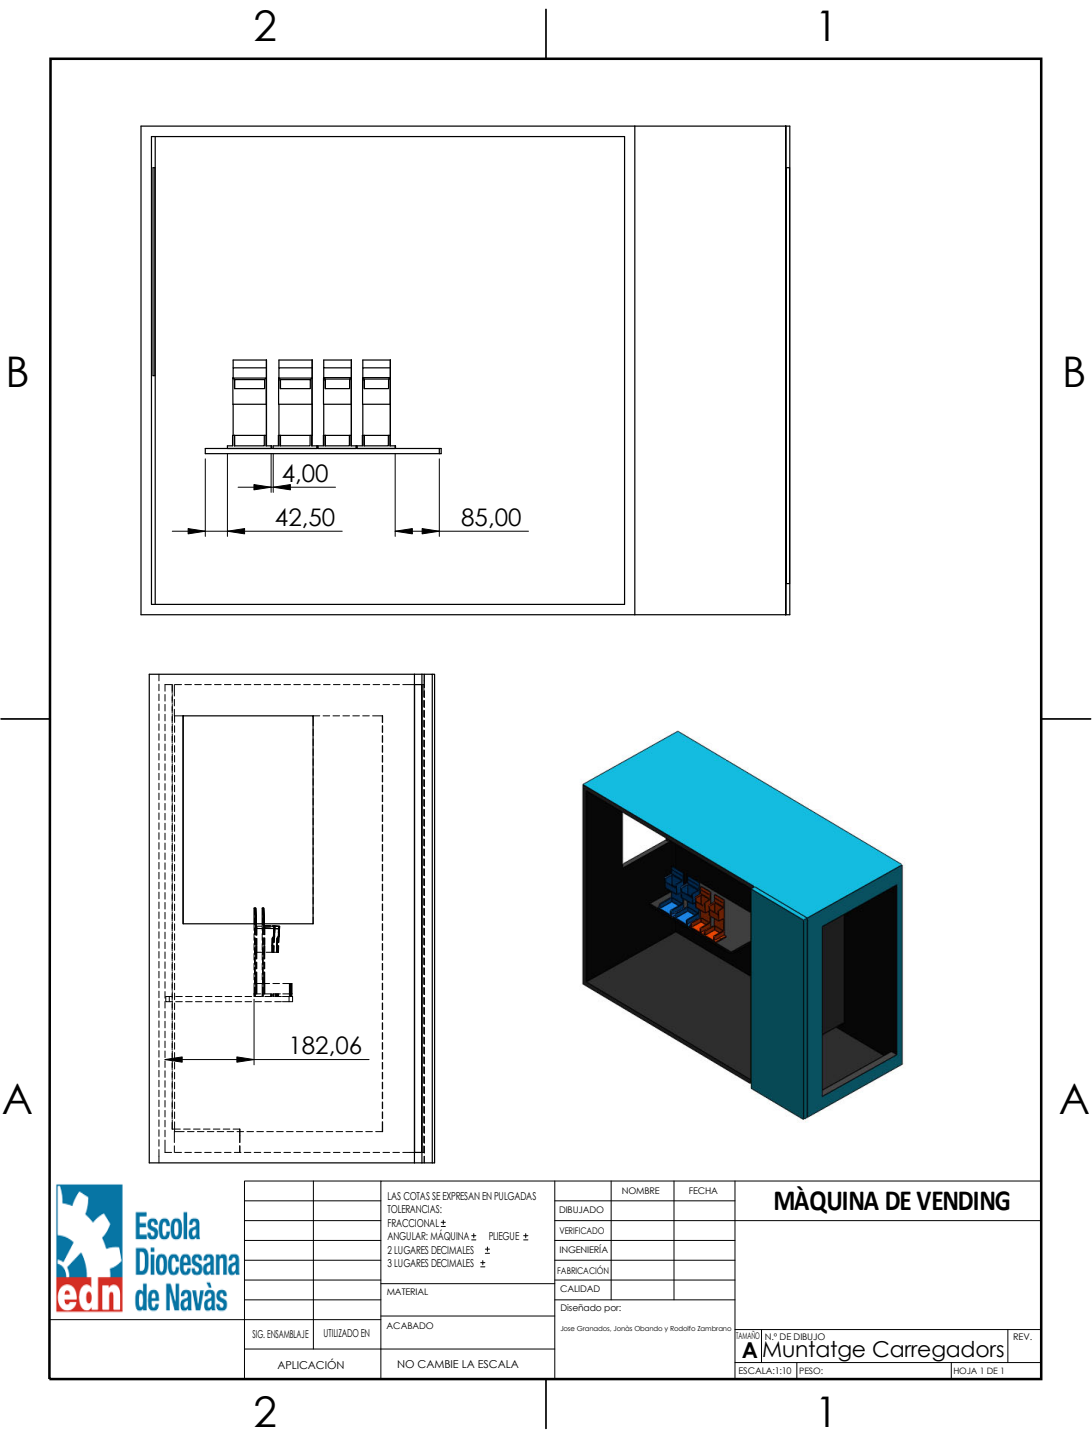
[picture p496: page 1]
N.º DE DIBUJO; MATERIAL; ESCALA:1:10; TAMAÑO A Muntatge Carregadors 1; HOJA 1 DE 1; CALIDAD; PESO:; UTILIZADO EN; REV.; Diseñado por:; SIG. ENSAMBLAJE; ACABADO; NOMBRE; APLICACIÓN; ANGULAR: MÁQUINA; PLIEGUE

FECHA LAS COTAS SE EXPRESAN EN PULGADAS
TOLERANCIAS:
FRACCIONAL
2 LUGARES DECIMALES
3 LUGARES DECIMALES

MÀQUINA DE VENDING

DIBUJADO VERIFICADO

INGENIERÍA
FABRICACIÓN

Jose Granados, Jonàs Obando y Rodolfo Zambrano

NO CAMBIE LA ESCALA
