josegd98/MaquinaVending/Diseny 3D, planos i STL/Planols 2D/Plans 2D de muntatge/4 Muntatge interior .pdf

2

1

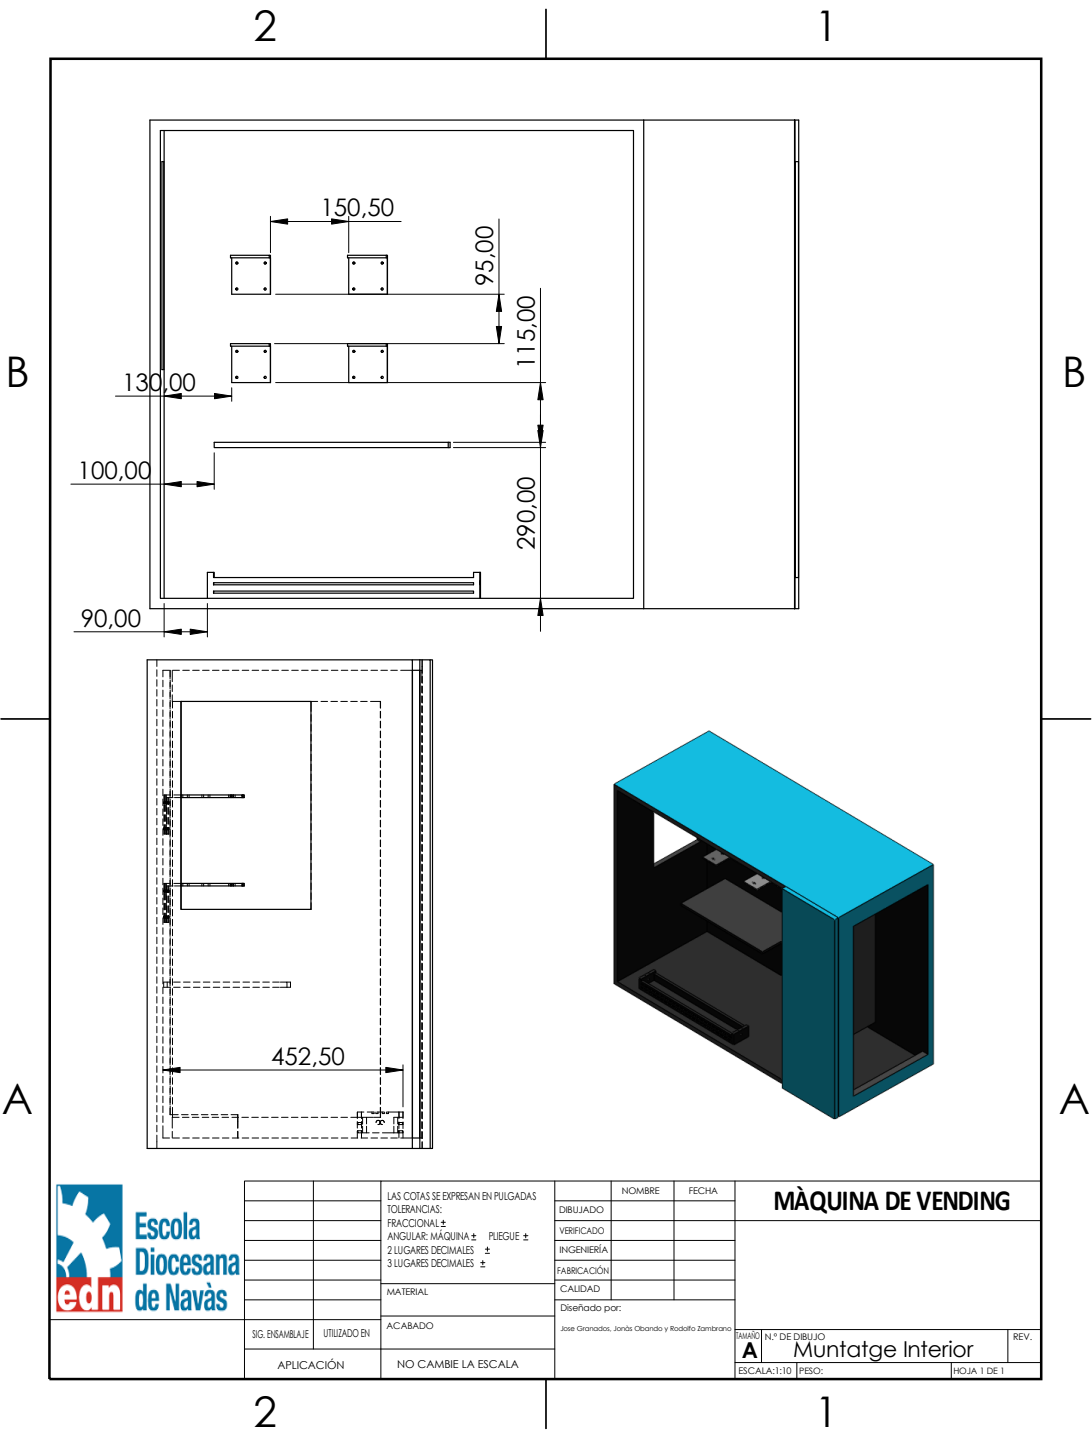
[picture p497: page 1]
TAMAÑO; N.º DE DIBUJO; ESCALA:1:10; A Muntatge Interior; Diseñado por:; HOJA 1 DE 1; CALIDAD; PESO:; UTILIZADO EN; REV.; MATERIAL; SIG. ENSAMBLAJE; ACABADO; NOMBRE; APLICACIÓN; ANGULAR: MÁQUINA; PLIEGUE

FECHA LAS COTAS SE EXPRESAN EN PULGADAS
TOLERANCIAS:
FRACCIONAL
2 LUGARES DECIMALES
3 LUGARES DECIMALES

MÀQUINA DE VENDING

DIBUJADO VERIFICADO

INGENIERÍA
FABRICACIÓN

Jose Granados, Jonàs Obando y Rodolfo Zambrano

NO CAMBIE LA ESCALA
