josegd98/MaquinaVending/Diseny 3D, planos i STL/Planols 2D/Plans 2D de muntatge/5 Pasacables fusta carregadors.pdf

2

1

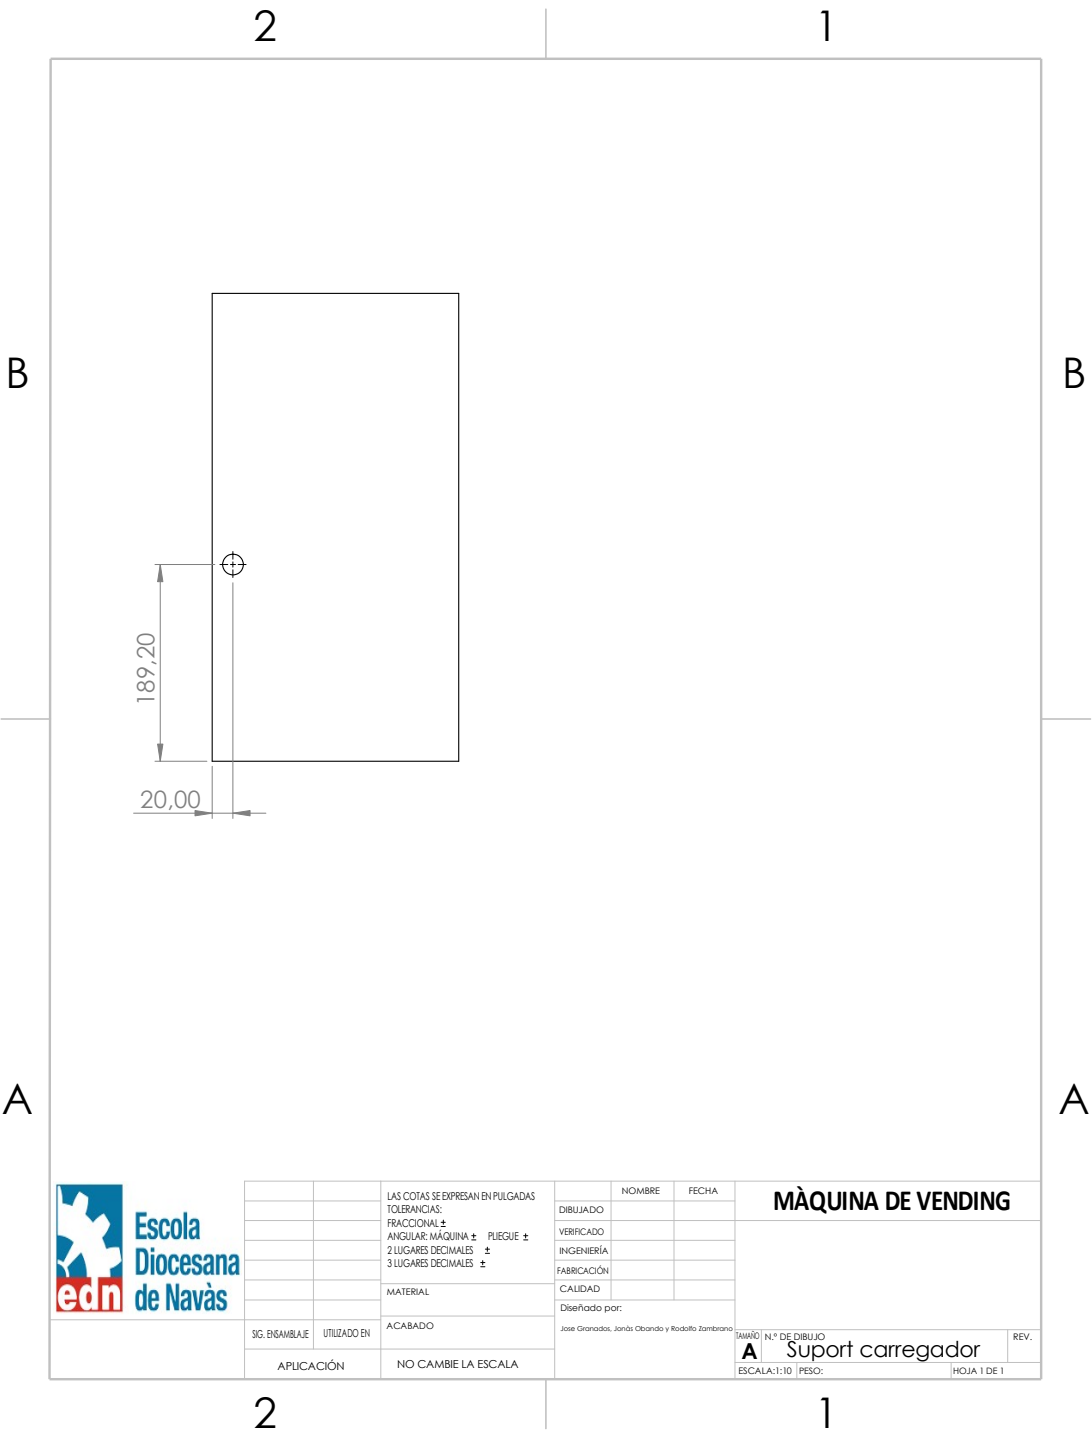
[picture p498: page 1]
ACABADO; TOLERANCIAS: FRACCIONAL ANGULAR: MÁQUINA; PLIEGUE 2 LUGARES DECIMALES 3 LUGARES DECIMALES; MÀQUINA DE VENDING ¹⁸⁹,20

NOMBRE LAS COTAS SE EXPRESAN EN PULGADAS | FECHA

DIBUJADO

INGENIERÍA VERIFICADO

CALIDAD FABRICACIÓN

MATERIAL SIG. ENSAMBLAJE | Diseñado por: Jose Granados, Jonàs Obando y Rodolfo Zambrano

REV. UTILIZADO EN

TAMAÑO A Suport carregador | N.º DE DIBUJO

APLICACIÓN | NO CAMBIE LA ESCALA

ESCALA:1:10 | PESO: | HOJA 1 DE 1
