josegd98/MaquinaVending/Diseny 3D, planos i STL/Planols 2D/Plans 2D per mecanitzar/3 Suport base pinça.pdf

2

1

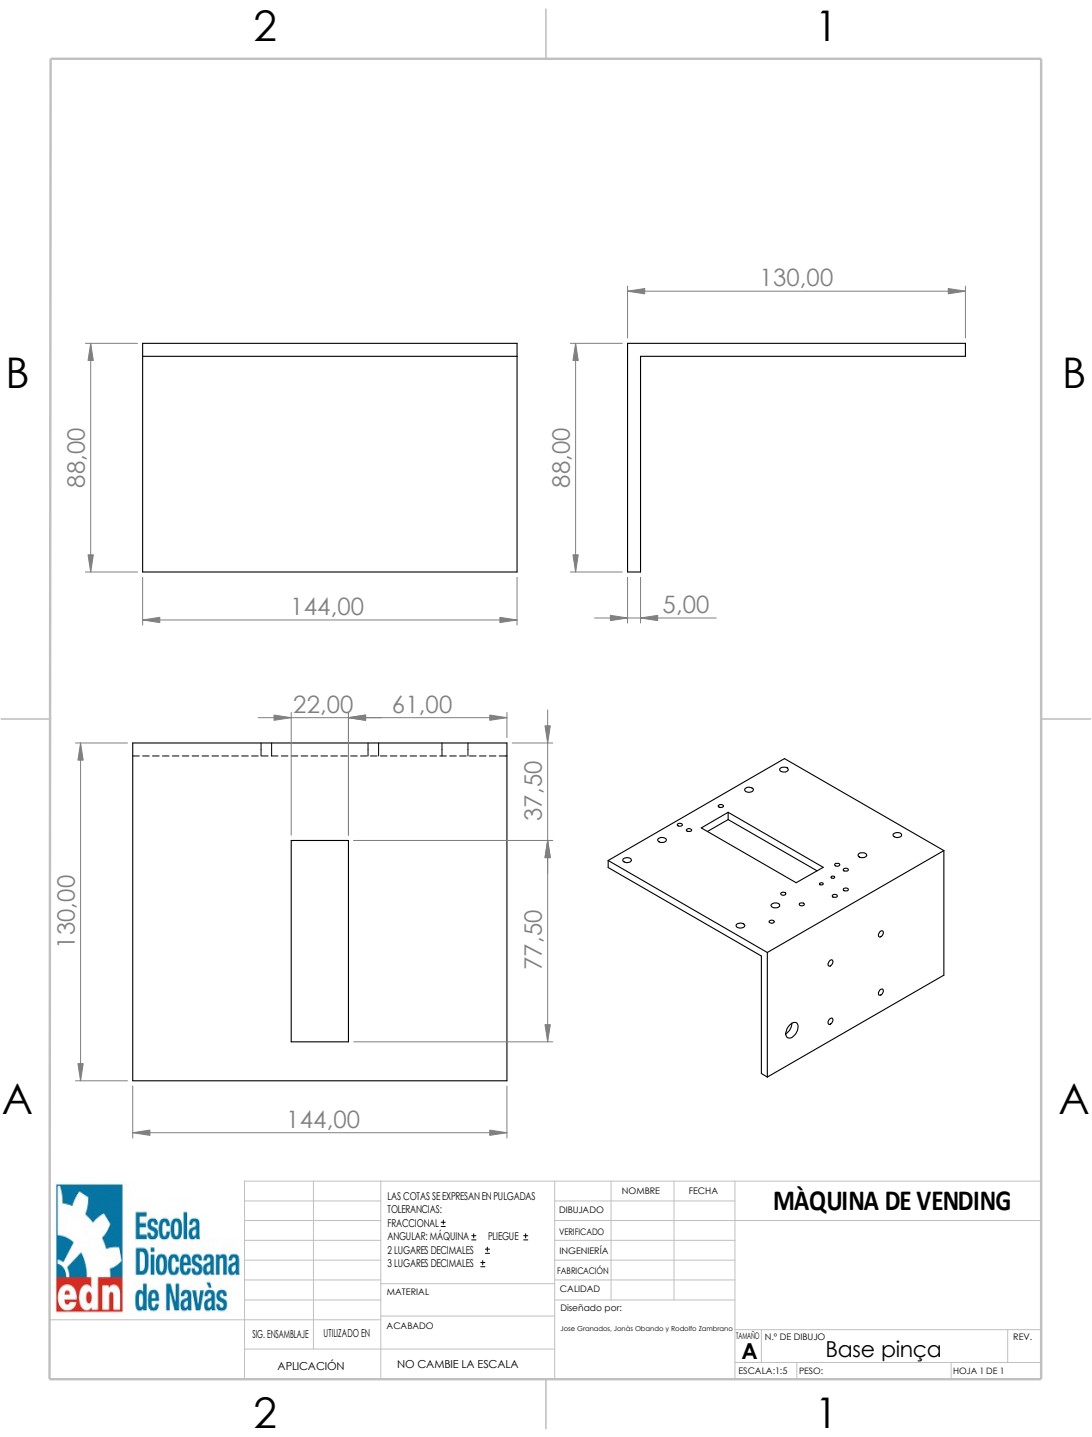
[picture p499: page 1]
MATERIAL; Diseñado por:; CALIDAD FABRICACIÓN; INGENIERÍA; ACABADO; NOMBRE; DIBUJADO SIG. ENSAMBLAJE; VERIFICADO; TOLERANCIAS: FRACCIONAL ANGULAR: MÁQUINA; PLIEGUE 2 LUGARES DECIMALES 3 LUGARES DECIMALES; MÀQUINA DE VENDING ³⁷,50

FECHA UTILIZADO EN

LAS COTAS SE EXPRESAN EN PULGADAS

Jose Granados, Jonàs Obando y Rodolfo Zambrano

TAMAÑO A | N.º DE DIBUJO Base pinça | REV.

APLICACIÓN | NO CAMBIE LA ESCALA

ESCALA:1:5 | PESO: | HOJA 1 DE 1
