josegd98/MaquinaVending/Diseny 3D, planos i STL/Planols 2D/Tots els Plans 2D/10 Base recollida producte.pdf

2 1

5,00

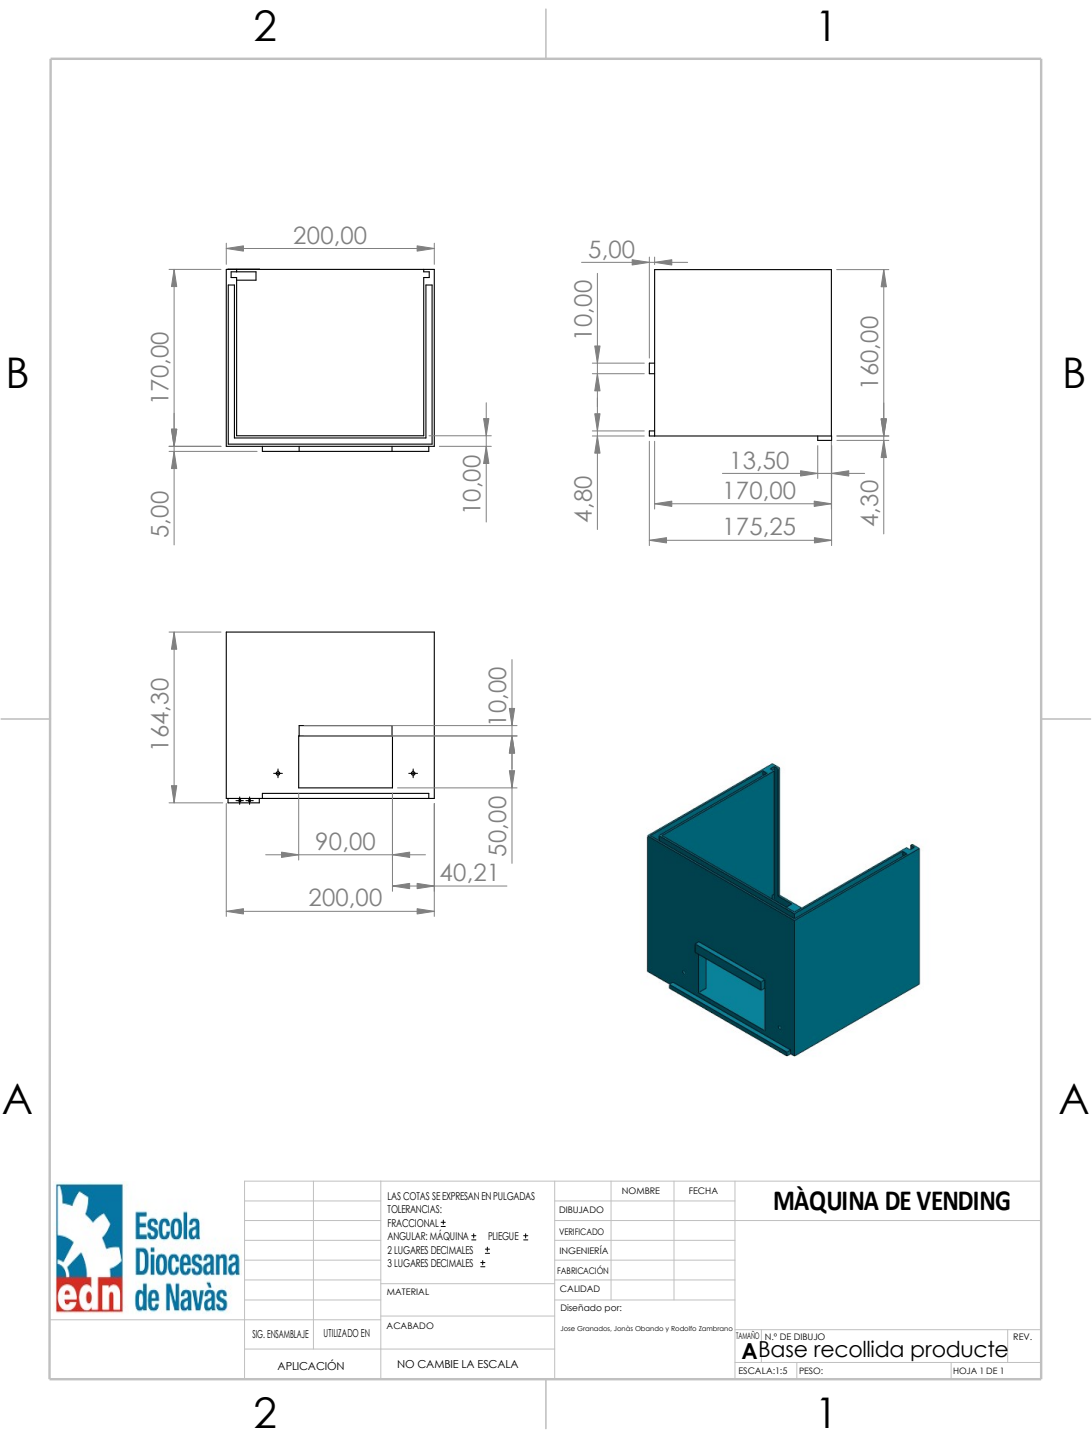
[picture p500: page 1]
MATERIAL; Diseñado por:; NOMBRE; TOLERANCIAS: FRACCIONAL ANGULAR: MÁQUINA; PLIEGUE 2 LUGARES DECIMALES 3 LUGARES DECIMALES; MÀQUINA DE VENDING ⁵,00 170,00

FECHA UTILIZADO EN

DIBUJADO LAS COTAS SE EXPRESAN EN PULGADAS

INGENIERÍA VERIFICADO

CALIDAD FABRICACIÓN

SIG. ENSAMBLAJE | ACABADO

Jose Granados, Jonàs Obando y Rodolfo Zambrano

TAMAÑO A | Base recollida producte N.º DE DIBUJO | REV.

APLICACIÓN | NO CAMBIE LA ESCALA

ESCALA:1:5 | PESO: | HOJA 1 DE 1
