josegd98/MaquinaVending/Diseny 3D, planos i STL/Planols 2D/Tots els Plans 2D/11 Caixa gran de cargols 100u.pdf

2

1

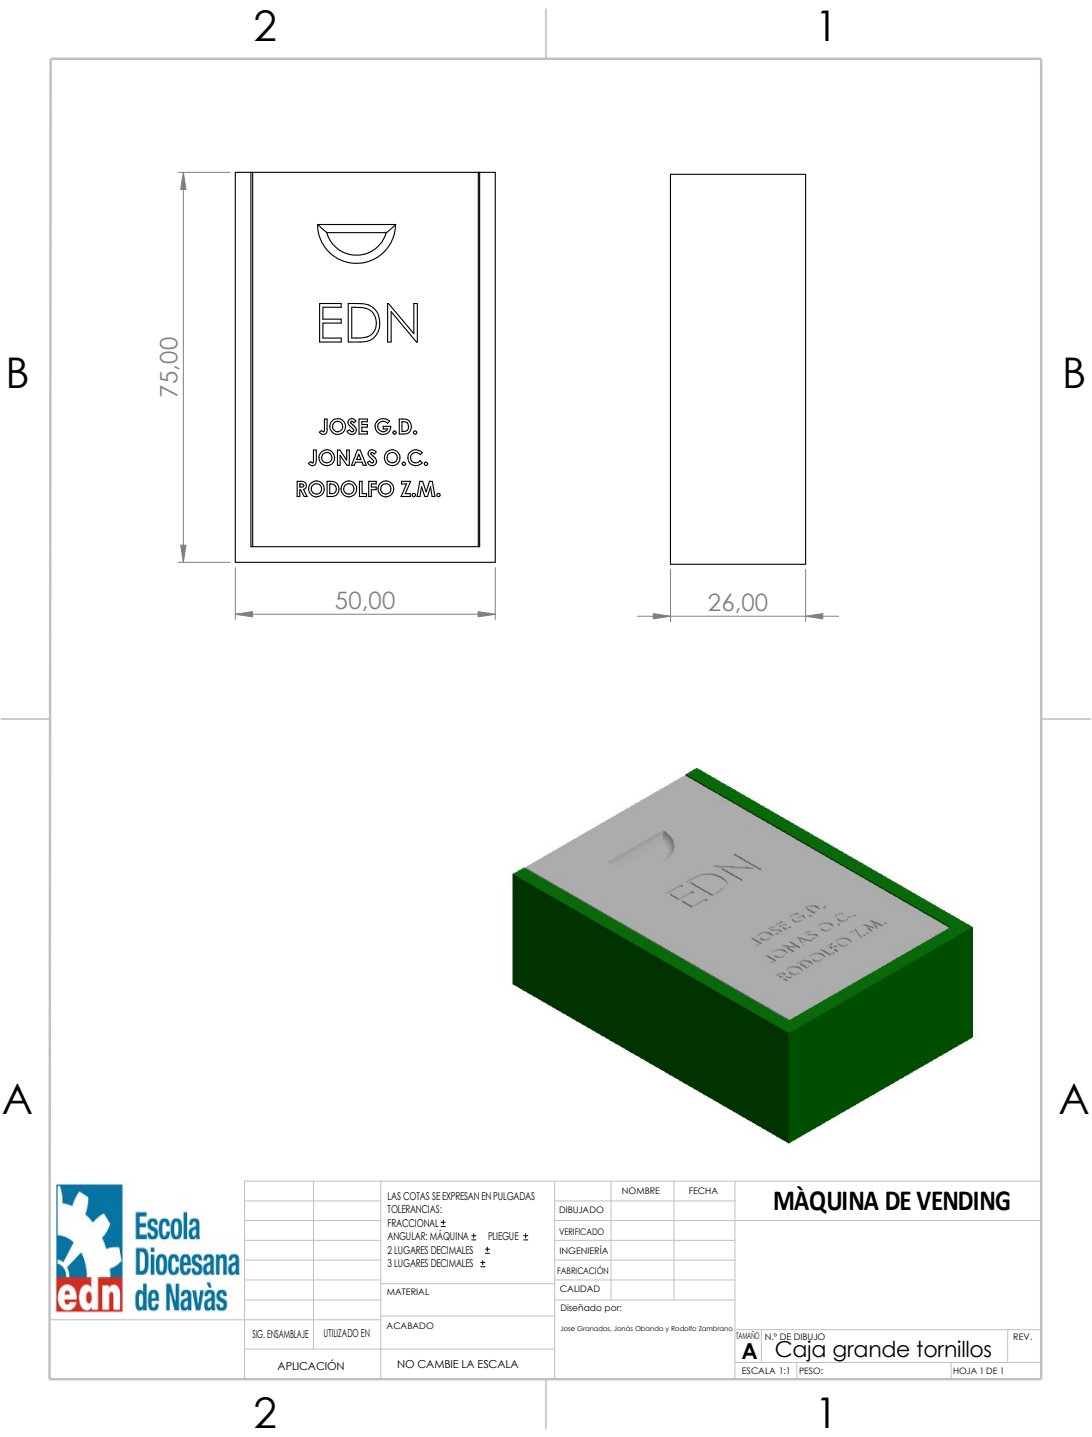
[picture p501: page 1]
ACABADO

TOLERANCIAS: FRACCIONAL ANGULAR: MÁQUINA PLIEGUE 2 LUGARES DECIMALES 3 LUGARES DECIMALES | | NOMBRE LAS COTAS SE EXPRESAN EN PULGADAS | FECHA | MÀQUINA DE VENDING

DIBUJADO

INGENIERÍA VERIFICADO

CALIDAD FABRICACIÓN

MATERIAL SIG. ENSAMBLAJE | Diseñado por: Jose Granados, Jonàs Obando y Rodolfo Zambrano

REV. UTILIZADO EN

TAMAÑO A Caja grande tornillos | N.º DE DIBUJO

APLICACIÓN | NO CAMBIE LA ESCALA

ESCALA 1:1 | PESO: | HOJA 1 DE 1
