josegd98/MaquinaVending/Diseny 3D, planos i STL/Planols 2D/Tots els Plans 2D/12 Caixa petita de cargols 100u.pdf

2

1

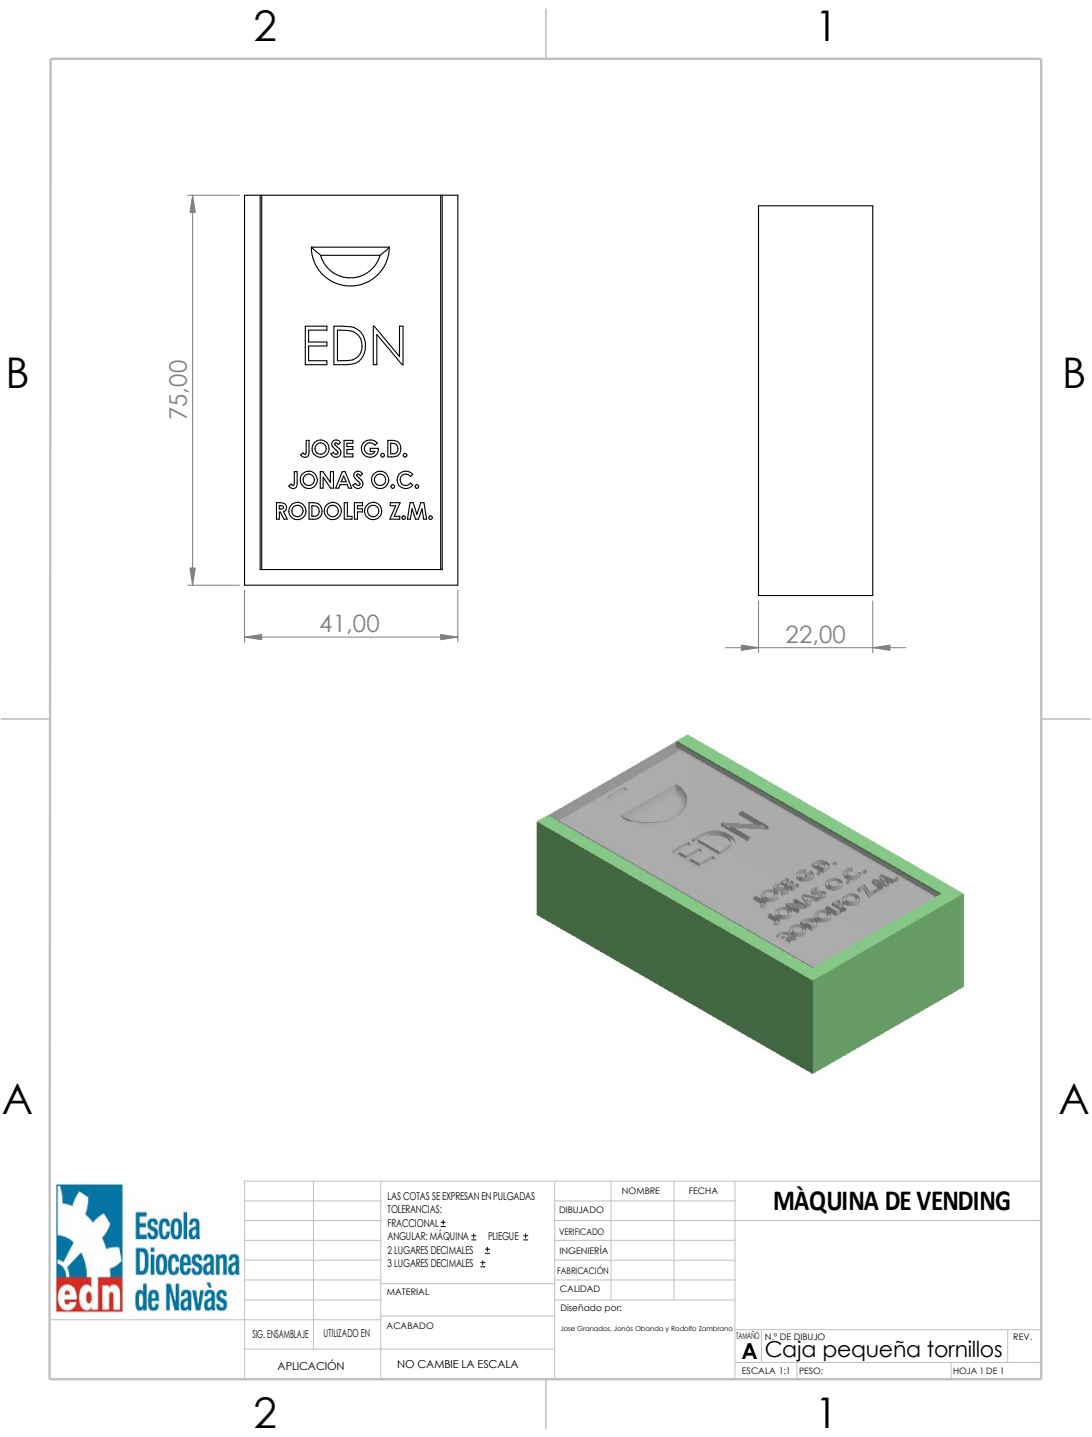
[picture p502: page 1]
ACABADO; NOMBRE; TOLERANCIAS: FRACCIONAL ANGULAR: MÁQUINA; PLIEGUE 2 LUGARES DECIMALES 3 LUGARES DECIMALES; MÀQUINA DE VENDING

FECHA UTILIZADO EN

DIBUJADO LAS COTAS SE EXPRESAN EN PULGADAS

INGENIERÍA VERIFICADO

CALIDAD FABRICACIÓN

MATERIAL SIG. ENSAMBLAJE | Diseñado por: Jose Granados, Jonàs Obando y Rodolfo Zambrano

TAMAÑO A | Caja pequeña tornillos N.º DE DIBUJO | REV.

APLICACIÓN | NO CAMBIE LA ESCALA

ESCALA 1:1 | PESO: | HOJA 1 DE 1
