josegd98/MaquinaVending/Diseny 3D, planos i STL/Planols 2D/Tots els Plans 2D/16 Casquillo pinça.pdf

2 1

1,00

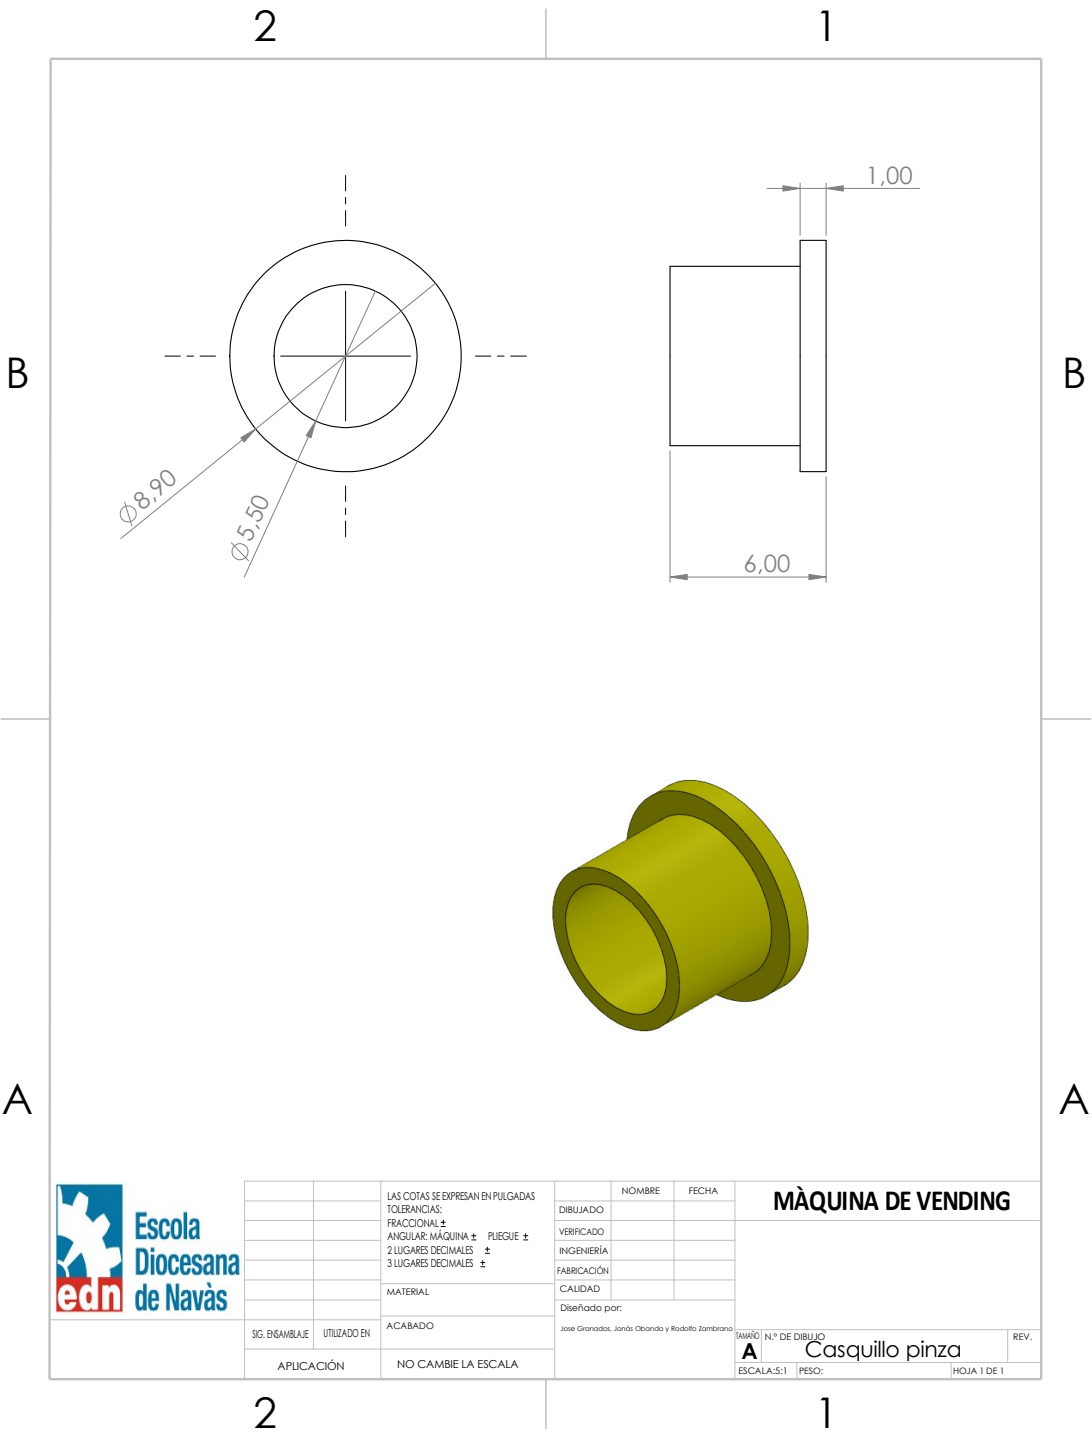
[picture p503: page 1]
MATERIAL; Diseñado por:

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

DIBUJADO

INGENIERÍA VERIFICADO

CALIDAD FABRICACIÓN

SIG. ENSAMBLAJE | ACABADO

REV. UTILIZADO EN

Jose Granados, Jonàs Obando y Rodolfo Zambrano

TAMAÑO A Casquillo pinza | N.º DE DIBUJO

APLICACIÓN | NO CAMBIE LA ESCALA

ESCALA:5:1 | PESO: | HOJA 1 DE 1
