josegd98/MaquinaVending/Diseny 3D, planos i STL/Planols 2D/Tots els Plans 2D/2 Base guia lineal inferior.pdf

2 1

117,15

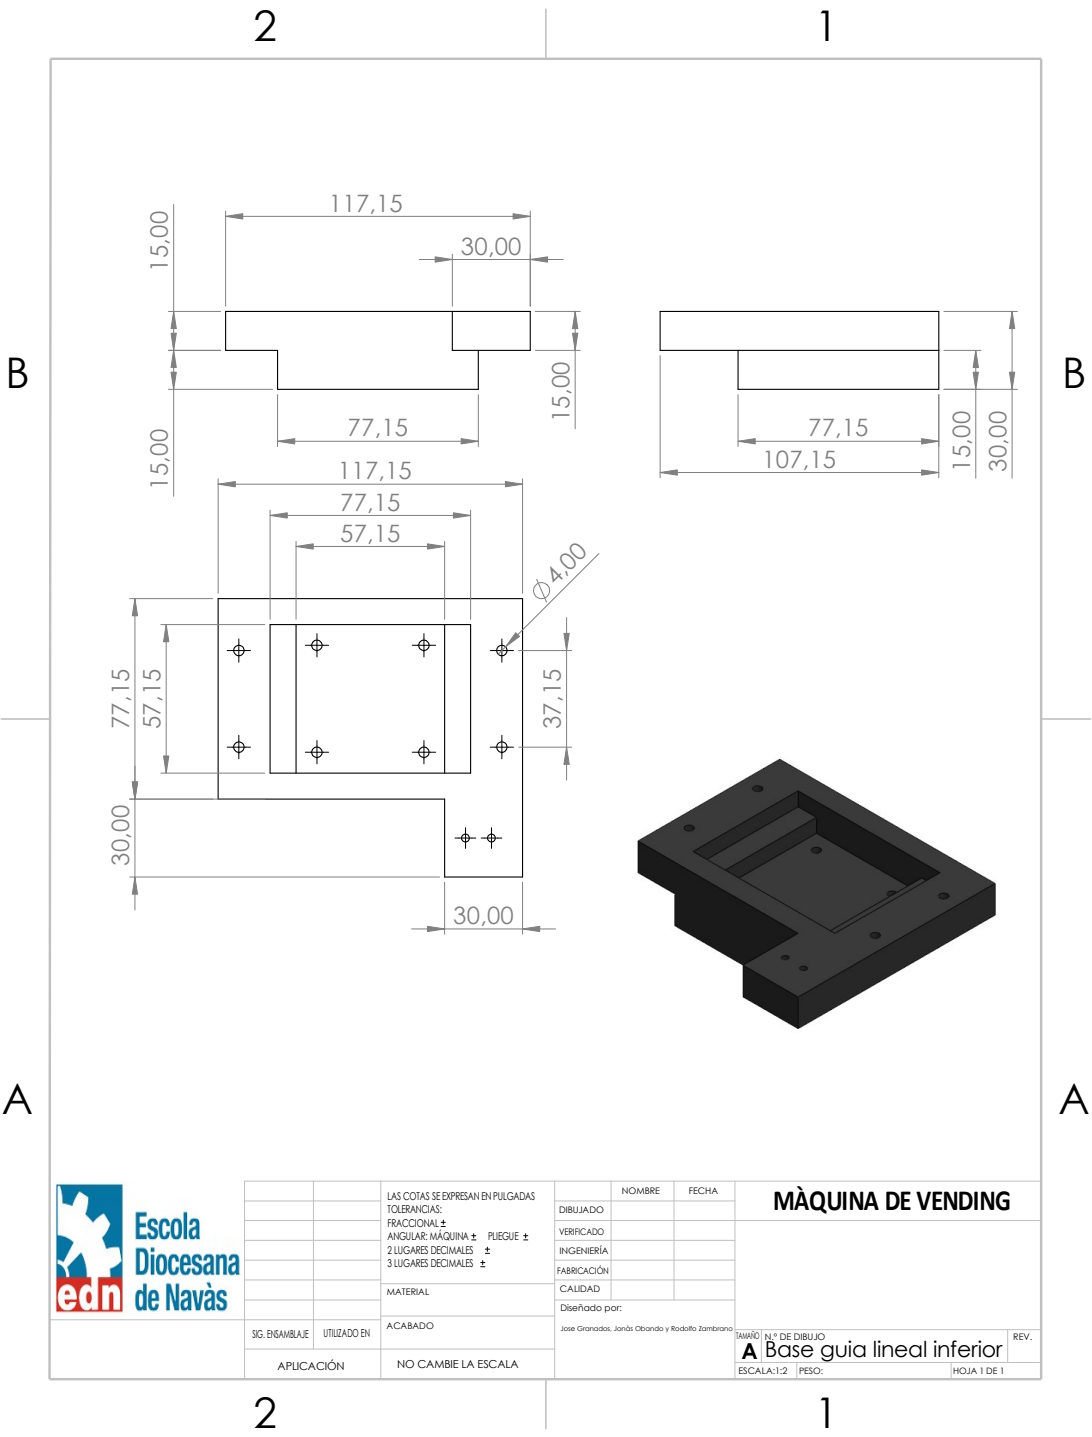
[picture p504: page 1]
MATERIAL; Diseñado por:; REV. SIG. ENSAMBLAJE; UTILIZADO EN; N.º DE DIBUJO; ACABADO

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

DIBUJADO

INGENIERÍA VERIFICADO

CALIDAD FABRICACIÓN

TAMAÑO Jose Granados, Jonàs Obando y Rodolfo Zambrano A Base guia lineal inferior

APLICACIÓN | NO CAMBIE LA ESCALA

ESCALA:1:2 | PESO: | HOJA 1 DE 1
