josegd98/MaquinaVending/Diseny 3D, planos i STL/Planols 2D/Tots els Plans 2D/21 Maneta porta recollida producte.pdf

2

1

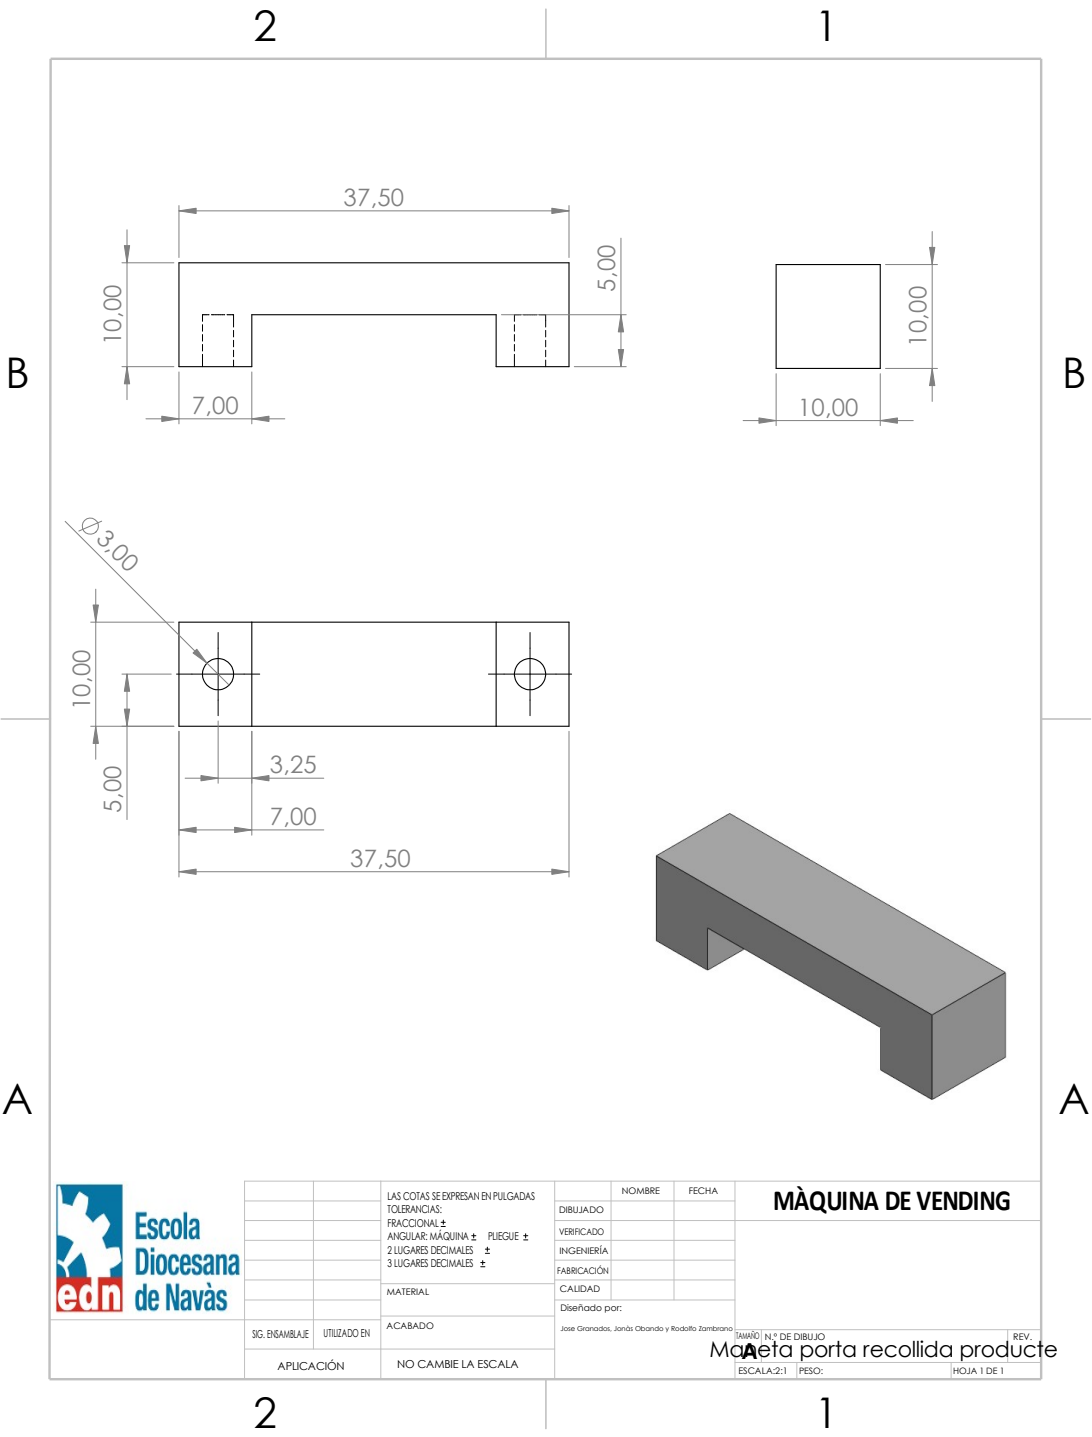
[picture p505: page 1]
Diseñado por:; MATERIAL; REV. SIG. ENSAMBLAJE; UTILIZADO EN; N.º DE DIBUJO; ACABADO; TOLERANCIAS: FRACCIONAL ANGULAR: MÁQUINA; PLIEGUE 2 LUGARES DECIMALES 3 LUGARES DECIMALES; MÀQUINA DE VENDING ¹⁰,00

NOMBRE | FECHA LAS COTAS SE EXPRESAN EN PULGADAS

DIBUJADO

INGENIERÍA VERIFICADO

CALIDAD FABRICACIÓN

Jose Granados, Jonàs Obando y Rodolfo Zambrano

TAMAÑO
Maneta porta recollida producte A

APLICACIÓN | NO CAMBIE LA ESCALA

ESCALA:2:1 | PESO: | HOJA 1 DE 1
