josegd98/MaquinaVending/Diseny 3D, planos i STL/Planols 2D/Tots els Plans 2D/27 Pinça impresio 3d dreta.pdf

2 1

5,00

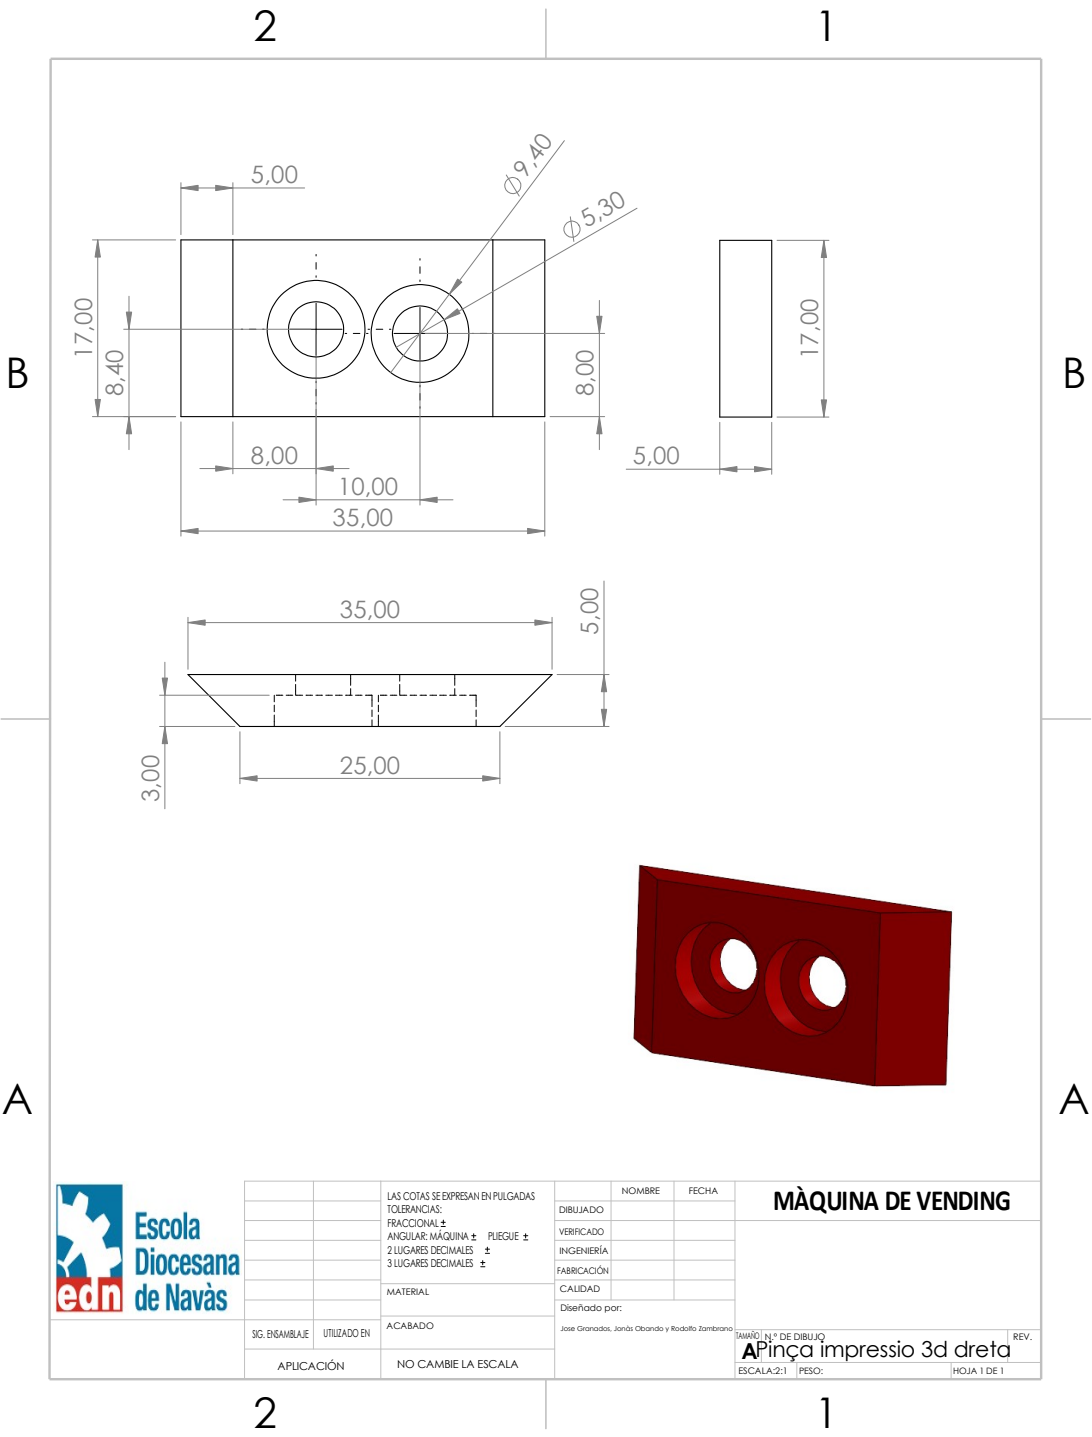
[picture p506: page 1]
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

FECHA UTILIZADO EN

LAS COTAS SE EXPRESAN EN PULGADAS

Jose Granados, Jonàs Obando y Rodolfo Zambrano

TAMAÑO Pinça impressio 3d dreta A | N.º DE DIBUJO | REV.

APLICACIÓN

PESO: NO CAMBIE LA ESCALA

ESCALA:2:1 | | HOJA 1 DE 1
