josegd98/MaquinaVending/Diseny 3D, planos i STL/Planols 2D/Tots els Plans 2D/3 Base guia lineal superior.pdf

2

1

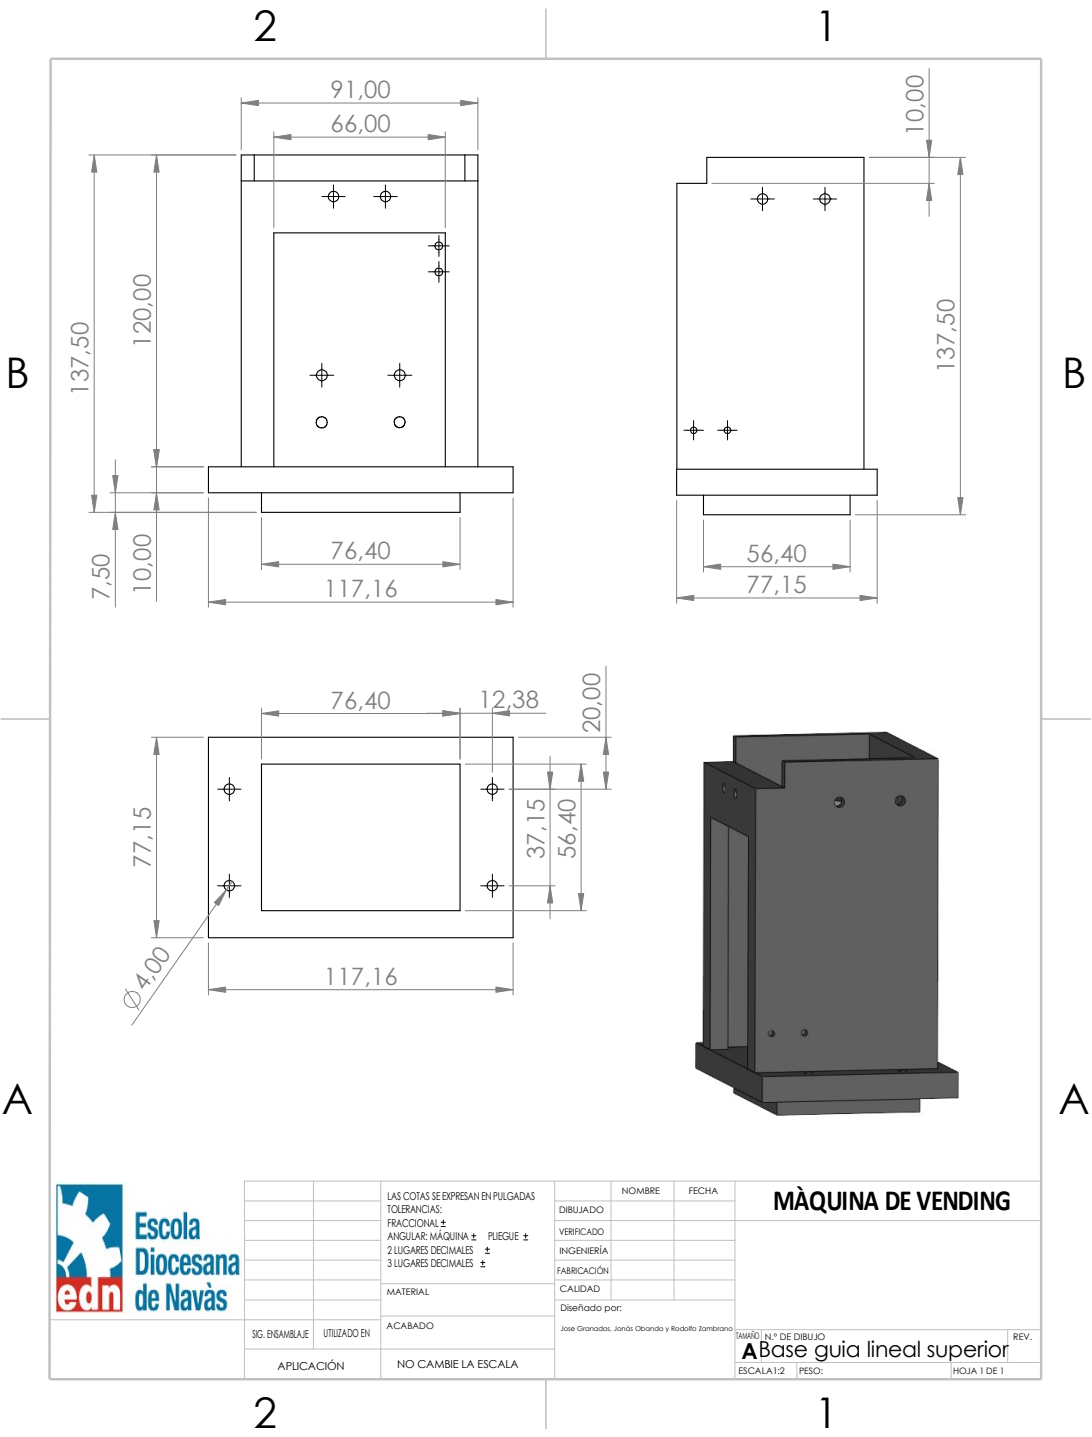
[picture p507: page 1]
MATERIAL; Diseñado por:

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

DIBUJADO

INGENIERÍA VERIFICADO

CALIDAD FABRICACIÓN

SIG. ENSAMBLAJE | ACABADO

REV. UTILIZADO EN

Jose Granados, Jonàs Obando y Rodolfo Zambrano

TAMAÑO ABase guia lineal superior | N.º DE DIBUJO

APLICACIÓN | NO CAMBIE LA ESCALA

ESCALA1:2 | PESO: | HOJA 1 DE 1
