josegd98/MaquinaVending/Diseny 3D, planos i STL/Planols 2D/Tots els Plans 2D/31 Placa Logo EDN i Noms.pdf

2

1

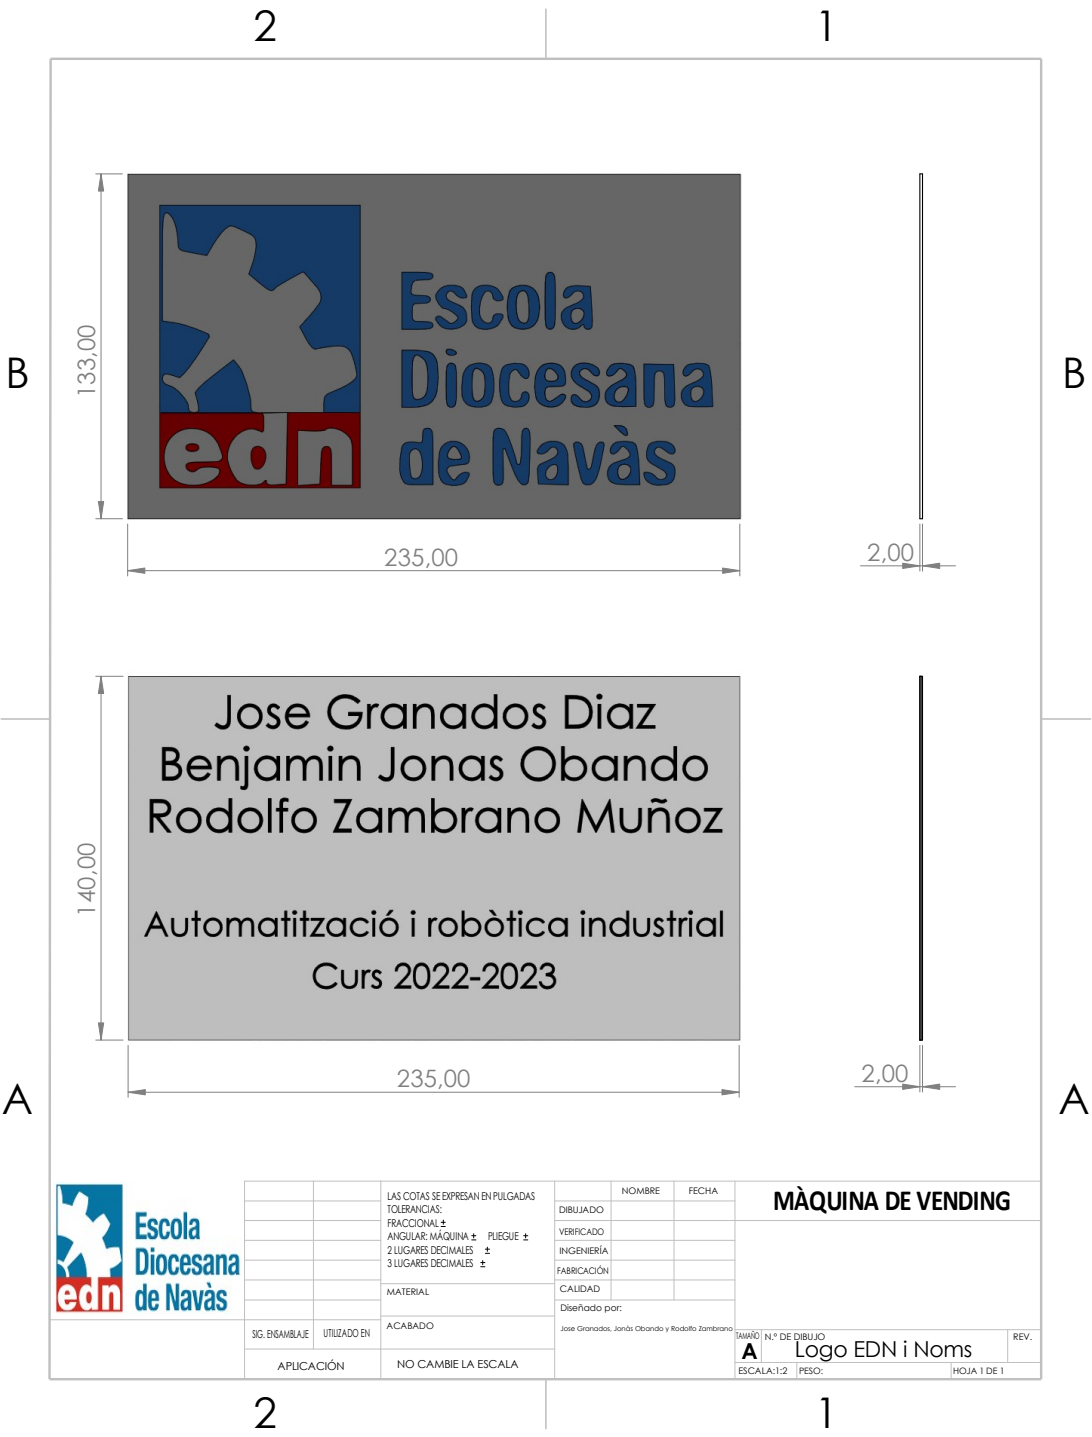
[picture p508: page 1]
MATERIAL; Diseñado por:; CALIDAD; 235,00 ¹⁴⁰,00; 235,00 ¹³³,00

TOLERANCIAS: FRACCIONAL ANGULAR: MÁQUINA PLIEGUE 2 LUGARES DECIMALES 3 LUGARES DECIMALES LAS COTAS SE EXPRESAN EN PULGADAS | DIBUJADO SIG. ENSAMBLAJE | | FECHA | MÀQUINA DE VENDING

NOMBRE FABRICACIÓN

VERIFICADO INGENIERÍA

UTILIZADO EN | ACABADO

Jose Granados, Jonàs Obando y Rodolfo Zambrano

TAMAÑO A | N.º DE DIBUJO Logo EDN i Noms | REV.

APLICACIÓN | | NO CAMBIE LA ESCALA

ESCALA:1:2 | PESO: | HOJA 1 DE 1
