josegd98/MaquinaVending/Diseny 3D, planos i STL/Planols 2D/Tots els Plans 2D/34 Puerta.pdf

2

1

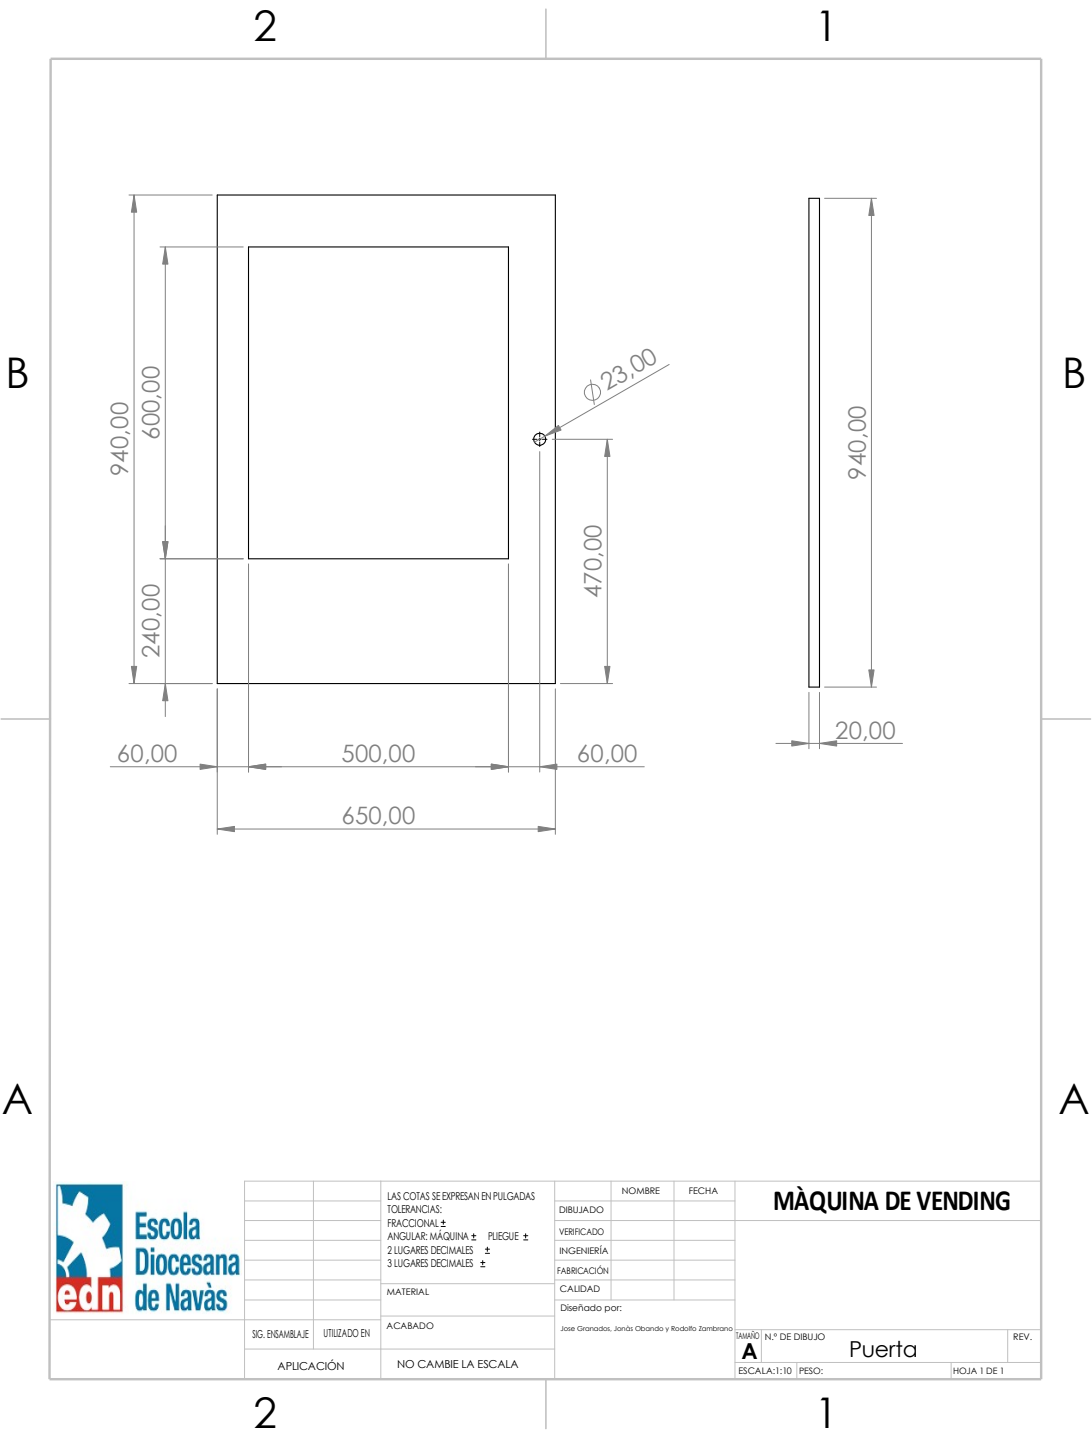
[picture p509: page 1]
ACABADO; TAMAÑO; NOMBRE; TOLERANCIAS: FRACCIONAL ANGULAR: MÁQUINA; PLIEGUE 2 LUGARES DECIMALES 3 LUGARES DECIMALES; MÀQUINA DE VENDING; 20,00 ⁹⁴⁰,00 240,00; 60,00 ⁹⁴⁰,00; 500,00 ⁶⁰⁰,00; 60,00 ⁴⁷⁰,00

FECHA UTILIZADO EN

DIBUJADO LAS COTAS SE EXPRESAN EN PULGADAS

INGENIERÍA VERIFICADO

CALIDAD FABRICACIÓN

MATERIAL SIG. ENSAMBLAJE | Diseñado por: Jose Granados, Jonàs Obando y Rodolfo Zambrano

A | N.º DE DIBUJO Puerta | REV.

APLICACIÓN | NO CAMBIE LA ESCALA

ESCALA:1:10 | PESO: | HOJA 1 DE 1
