josegd98/MaquinaVending/Diseny 3D, planos i STL/Planols 2D/Tots els Plans 2D/36 Separador base pinça.pdf

1

2

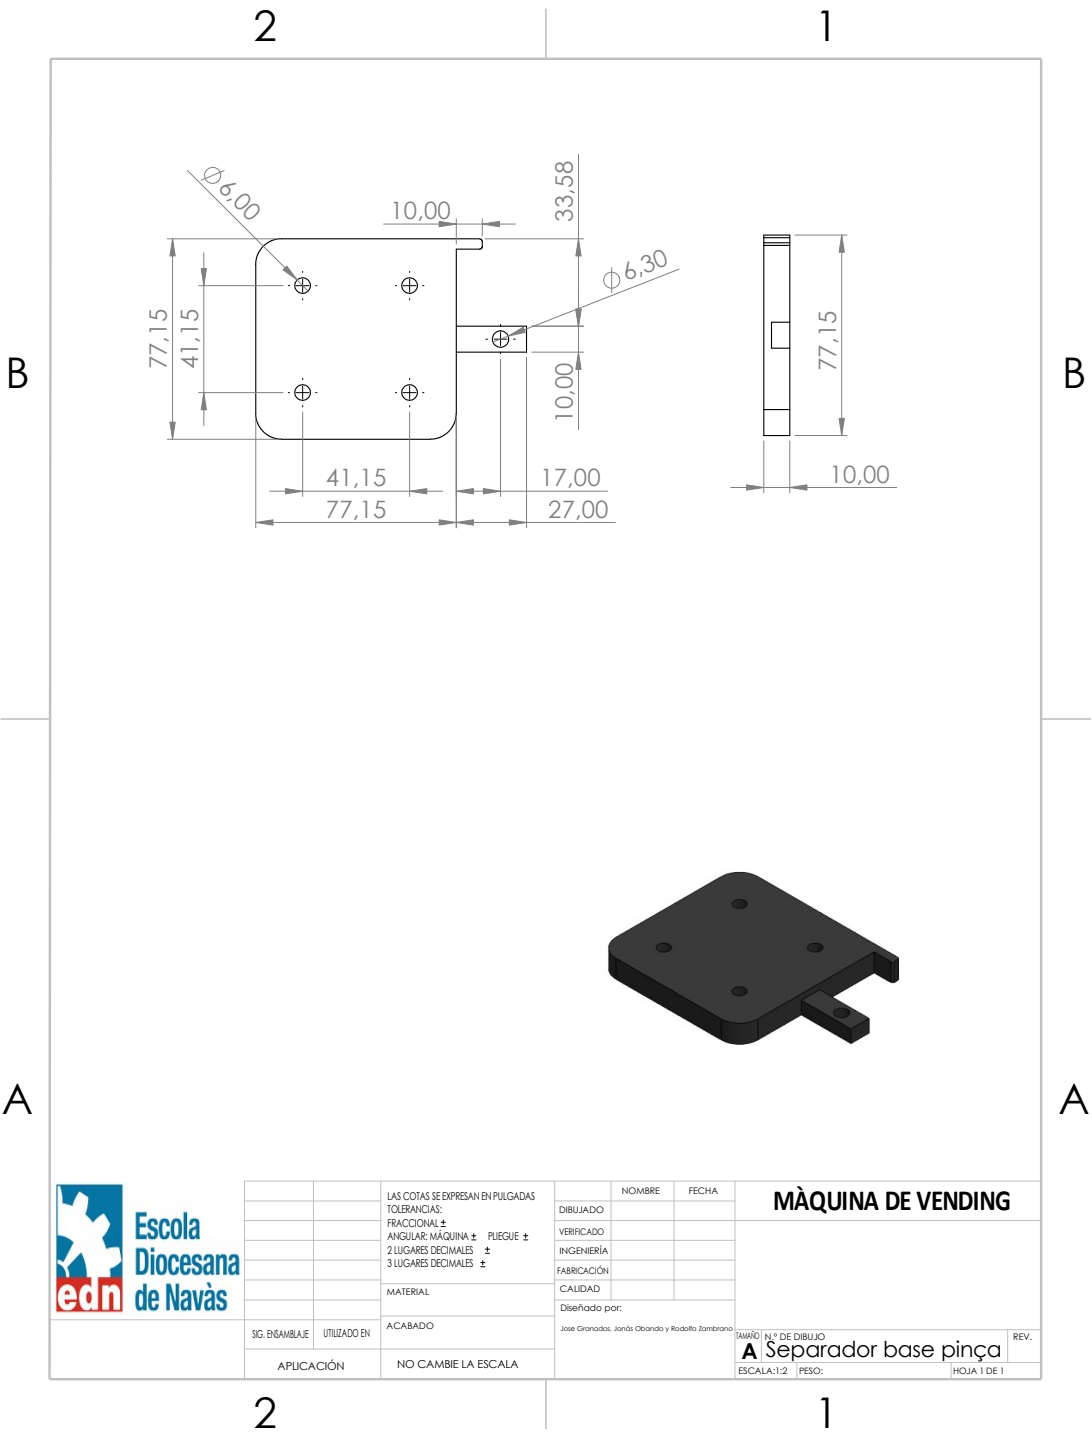
[picture p510: page 1]
MATERIAL; Diseñado por:

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

DIBUJADO

INGENIERÍA VERIFICADO

CALIDAD FABRICACIÓN

SIG. ENSAMBLAJE | ACABADO

REV. UTILIZADO EN

TAMAÑO Jose Granados, Jonàs Obando y Rodolfo Zambrano A Separador base pinça | N.º DE DIBUJO

APLICACIÓN | NO CAMBIE LA ESCALA

ESCALA:1:2 | PESO: | HOJA 1 DE 1
