josegd98/MaquinaVending/Diseny 3D, planos i STL/Planols 2D/Tots els Plans 2D/37 Suport cadena guia lineal.pdf

2

1

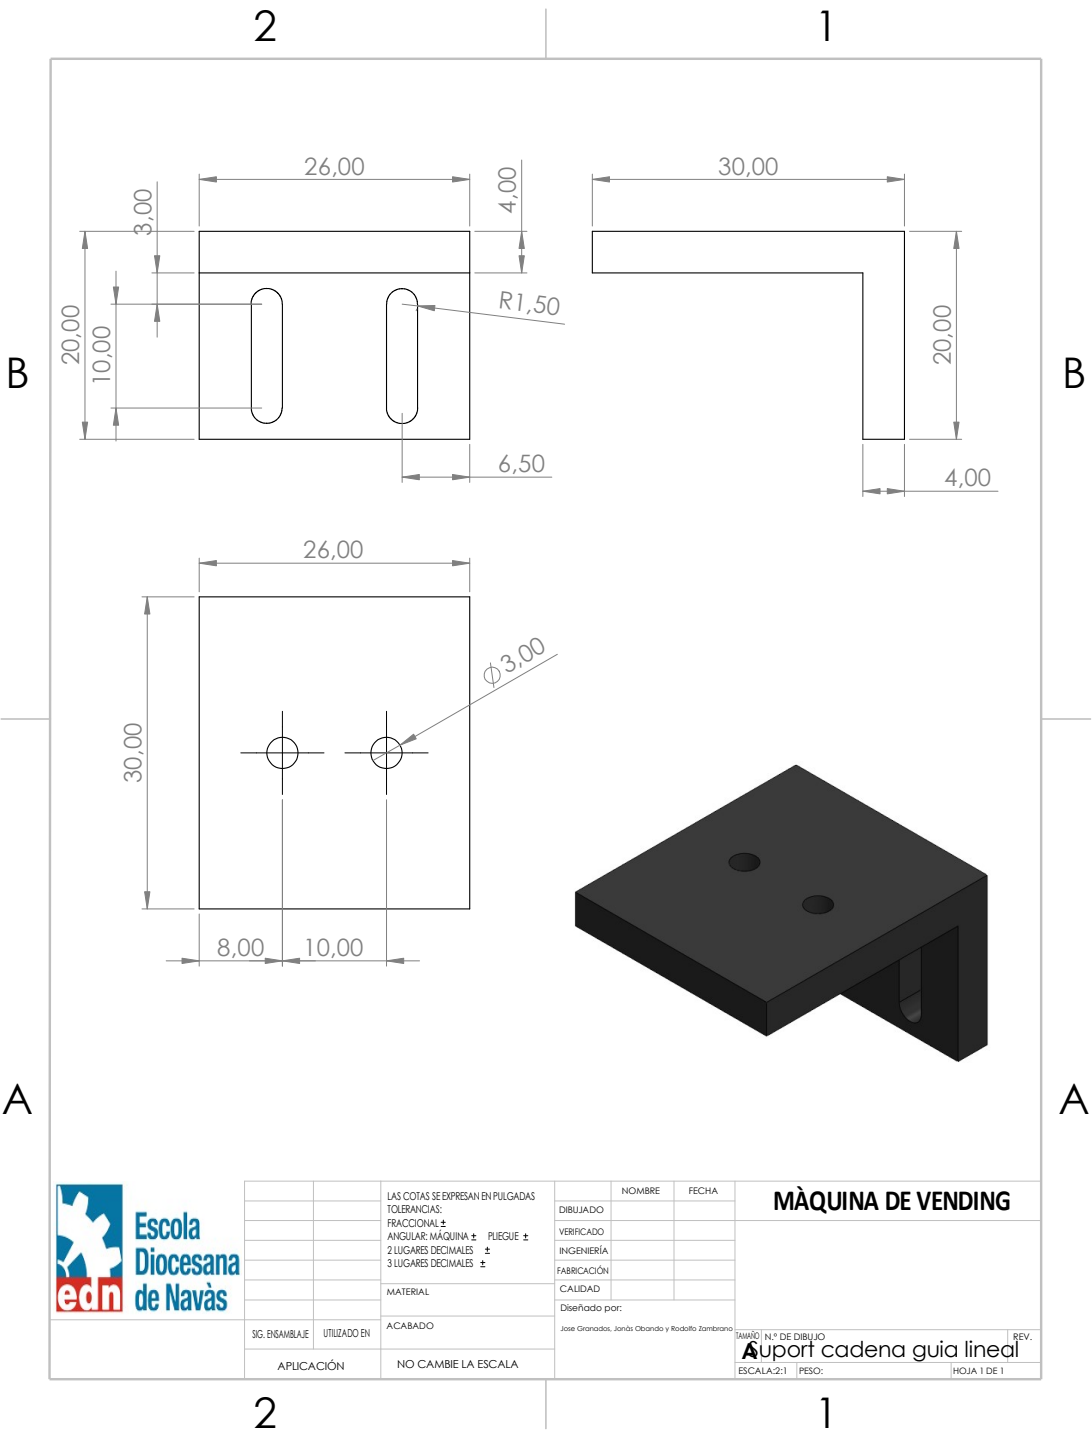
[picture p511: page 1]
Diseñado por:; CALIDAD; MATERIAL; TOLERANCIAS: FRACCIONAL ANGULAR: MÁQUINA; PLIEGUE 2 LUGARES DECIMALES 3 LUGARES DECIMALES; MÀQUINA DE VENDING ²⁰,00

LAS COTAS SE EXPRESAN EN PULGADAS | DIBUJADO SIG. ENSAMBLAJE | | FECHA
VERIFICADO INGENIERÍA

NOMBRE FABRICACIÓN

UTILIZADO EN | ACABADO

Jose Granados, Jonàs Obando y Rodolfo Zambrano

TAMAÑO A | N.º DE DIBUJO | REV. Suport cadena guia lineal

APLICACIÓN | | NO CAMBIE LA ESCALA

ESCALA:2:1 | PESO: | HOJA 1 DE 1
