josegd98/MaquinaVending/Diseny 3D, planos i STL/Planols 2D/Tots els Plans 2D/38 Suport caixes grans.pdf

2

1

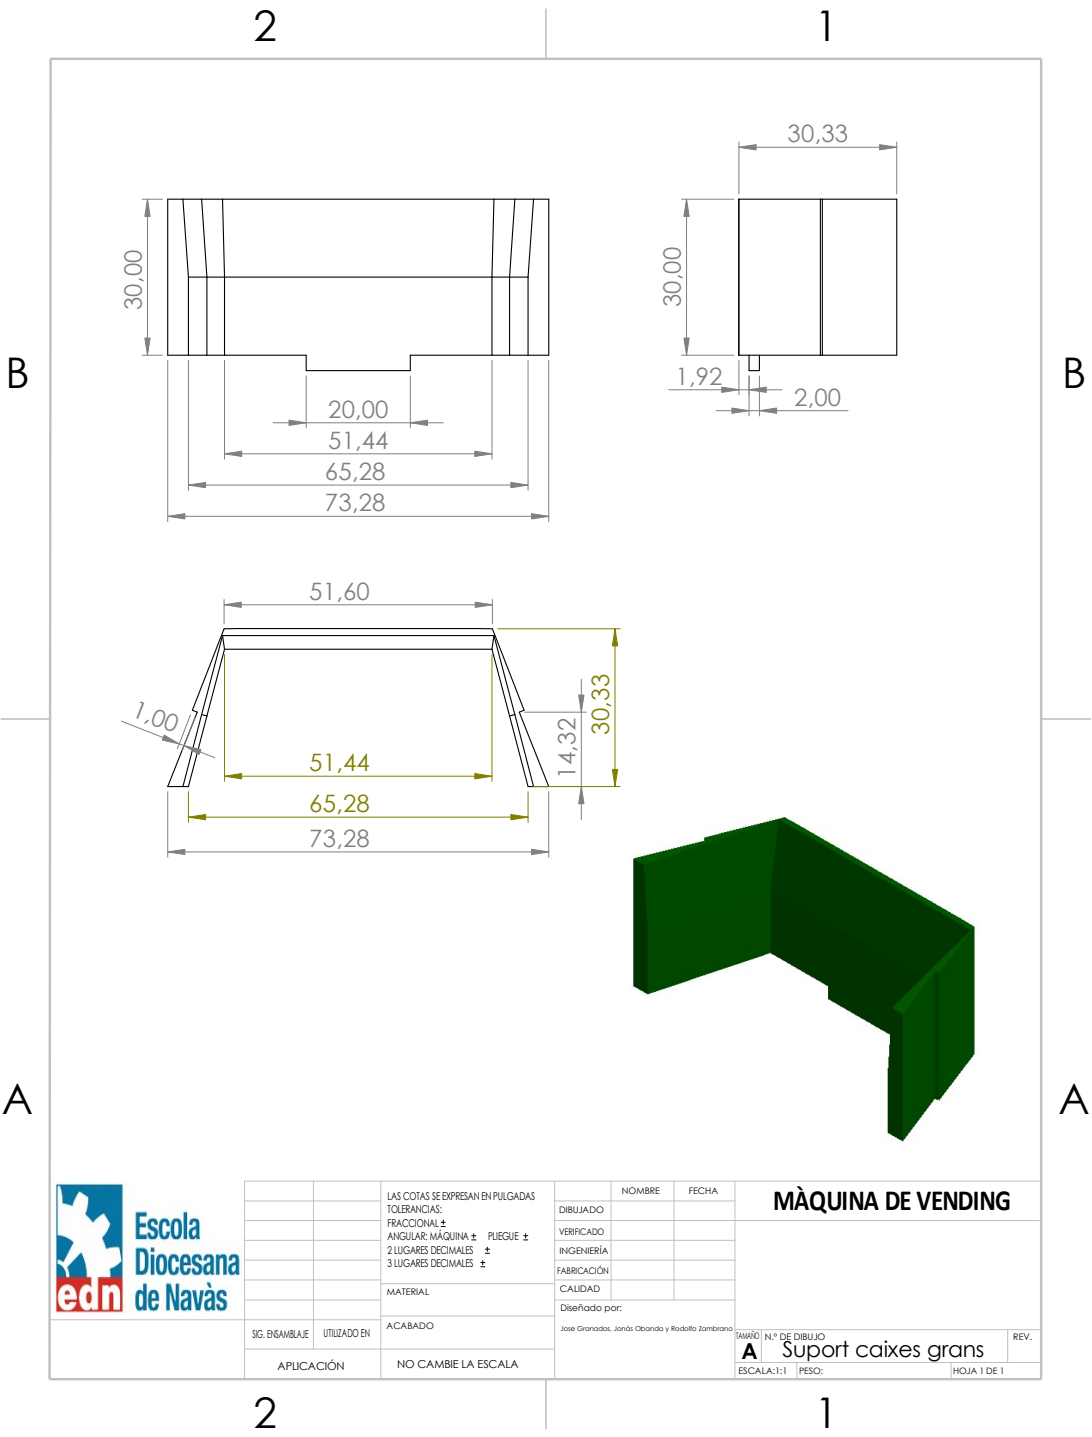
[picture p512: page 1]
MATERIAL; Diseñado por:; CALIDAD FABRICACIÓN; INGENIERÍA; ACABADO; NOMBRE; DIBUJADO SIG. ENSAMBLAJE; VERIFICADO; TOLERANCIAS: FRACCIONAL ANGULAR: MÁQUINA; PLIEGUE 2 LUGARES DECIMALES 3 LUGARES DECIMALES; MÀQUINA DE VENDING ³⁰,00

FECHA UTILIZADO EN

LAS COTAS SE EXPRESAN EN PULGADAS

Jose Granados, Jonàs Obando y Rodolfo Zambrano

TAMAÑO A | N.º DE DIBUJO Suport caixes grans | REV.

APLICACIÓN | NO CAMBIE LA ESCALA

ESCALA:1:1 | PESO: | HOJA 1 DE 1
