josegd98/MaquinaVending/(commit log)

2023-06-13 Màquina Vending
    [17ME15-1504S.STEP, 17ME15-1504S.step.SLDPRT, 6av21232gb030ax0.SLDASM, 6av21232gb030ax0_01.SLDPRT, 6av21232gb030ax0_02.SLDPRT, 6av21232gb030ax0_03.SLDPRT, 6av21232gb030ax0_04.SLDPRT, 6av21232gb030ax0_05.SLDPRT]
2023-06-13 Maquina Vending 2
    [Entradas i Sortides PLC.xlsx, Fitxa tasques de manteniment Maquina Vending.xlsx, Grafcet logica de entrega del producte.xlsx]
